2AMLogic/sky130-pll/design/README.md

# design/ — schematic capture convention

This directory holds the PLL's own schematics (xschem), symbols, generated
netlists, and per-block design-rationale notes — the design content itself,
as distinct from `sim/` (evidence records) and `layout/` (DRC/LVS flow).

Historically, no convention existed here before issue #24 (this directory held
only a `.gitkeep`). This file documents the convention that issue set, which
the sibling block sub-issues of #14 (PFD/charge pump, loop filter, divider)
and the integration schematic (`top/`) follow.

## Directory / naming convention

One directory per PLL sub-block, named for the block, kebab/lowercase:

```
design/
  README.md                  # this file
  <block>/
    <block>.sch               # top xschem schematic for the block
    <block>.sym                # xschem symbol, for hierarchical reuse by
                                 # the integration schematic
    DESIGN.md                   # topology choice, sizing rationale, and
                                 # the design targets this block is built
                                 # toward (not verified results — those are
                                 # sim/ evidence, produced by the block's
                                 # testbenches)
    netlist/
      <block>.spice              # ngspice-compatible netlist snapshot,
                                   # generated from <block>.sch and
                                   # committed (regeneration command
                                   # documented in the block's DESIGN.md)
```

- **`<block>`** — a short slug for the sub-block. First instance:
  `vco` (issue #24, the ring-oscillator VCO core). Sibling blocks (PFD/charge
  pump, loop filter, feedback divider) each have their own `<block>/`
  directory, as does `clk-buf` (issue #232, the `CLK` output buffer). `top`
  (issue #28) is the one exception to "sub-block": it is the integration
  schematic that hierarchically instantiates the sibling blocks into the
  closed PLL loop, following
  the same internal file shape (`top.sch`/`top.sym`/`DESIGN.md`/
  `netlist/top.spice`) for consistency, even though it isn't itself a
  sub-block.
- **`<block>.sch` / `<block>.sym`** — hand-authored (or, once available,
  xschem-generated) schematic and symbol pair. The symbol's pin order must
  match the schematic's own `ipin`/`opin`/`iopin` declaration order, so
  `@pinlist` nets correctly when the symbol is instantiated from a parent
  (integration) schematic.
- **`netlist/<block>.spice`** — a **connectivity snapshot**, not a
  simulation-ready testbench: it nets out the block's own devices against
  sky130 primitives (`sky130_fd_pr__nfet_01v8` / `pfet_01v8` etc., per the
  ratified 1.8 V core supply flavor, `DR-001`) but carries no supply
  sources, no `.lib` model include, and no analysis statements — those are
  added by whatever testbench (`sim/<experiment-slug>/testbench/`)
  instantiates the block. Regenerate with:

  ```sh
  source sim/bin/pdk-env.sh
  xschem -n -q -x --rcfile sim/xschemrc design/<block>/<block>.sch \
    -o design/<block>/netlist
  ```

  Unlike `sim/`'s `netlist-snapshots/` (one frozen file per evidence
  record, append-only), `design/<block>/netlist/<block>.spice` is **not**
  append-only — it is the current netlist for the current schematic,
  regenerated and overwritten in place as the schematic changes. The
  append-only, one-per-record convention lives entirely under `sim/` (see
  `sim/README.md`), where a netlist is frozen alongside the evidence it
  produced.

### Regenerating parents after a child changes

`design/top/netlist/top.spice` embeds a copy of every child block's netlist
(`pfd_cp`, `loop_filter`, `vco_ring5`, `divider_intN`, `clk_buf`). xschem does not
refresh a parent when only a child schematic is saved, so after changing any
child, regenerate every ancestor with the same command (for the top level,
`design/top/top.sch -o design/top/netlist`), and commit the changed snapshots
together. The layout flow reads the top snapshot, so a stale embedded copy
silently changes the device plan and LVS reference.

`python3 signoff/design-snapshot-consistency.py` (part of `npm run check:ci`,
and run by `layout/bin/run-pll-layout-flow.sh` before a record is minted)
compares each embedded block with its standalone snapshot: pin order, device
connections, model names and parameter values, ignoring generated path
comments and formatting. It needs neither xschem nor a PDK. It establishes
snapshot-to-snapshot consistency only; it does not prove that a snapshot
matches its `.sch`, which only regenerating with xschem does.

## Relationship to `sim/`

`design/<block>/<block>.sch` is the DUT a `sim/<experiment-slug>/testbench/`
schematic instantiates. Testbenches and their append-only evidence records
exist under `sim/` for several of these designs, including the VCO
([`sim/vco/`](../sim/vco/)), the feedback divider
([`sim/divider/`](../sim/divider/)), the loop filter's linearized dynamics
([`sim/loop-ac/`](../sim/loop-ac/)) and the closed-loop top level
([`sim/pll/`](../sim/pll/), [`sim/pll-lock/`](../sim/pll-lock/)). The
campaign list, with each campaign's claim and issue, is the table in
[`sim/README.md`](../sim/README.md); a testbench or record being present does
not mean the block meets any spec row.

Where each spec row stands is settled by
[`spec/target-spec.md`](../spec/target-spec.md) (ratified versus DRAFT) and
the evidence is rolled up, row by row and without a verdict of its own, in
[`measurements/report.md`](../measurements/report.md). Whether the block
clears the tiered signoff checklist is settled only by
[`signoff/tier-report.json`](../signoff/tier-report.json) (see
[`signoff/README.md`](../signoff/README.md)). This file deliberately repeats
none of those results.

`lock-detector/` currently holds no circuit. It holds the executable
behavioral reference and tests for the proposed `LOCK` contract (`DR-007`,
issue #237). The schematic, symbol and netlist files are owed by #231 and
will follow the shape above. Its tests are behavioral-reference evidence,
not `sim/` evidence records.

`sim/pdk-smoke` is unrelated plumbing (harness self-test, not a PLL block) and
predates this convention; its own throwaway testbench circuit intentionally
stays under `sim/pdk-smoke/testbench/`, not `design/`.

## Relationship to `layout/`

`layout/` (klayout-tools DRC/LVS flow) holds the physical side. The PLL
layout drawn from `design/top/netlist/top.spice` lives in
[`layout/pll/`](../layout/pll/) (start at its
[`README.md`](../layout/pll/README.md); the record `reports/LATEST` names is
the pass/fail evidence), and the flow reads the top-level snapshot described
under "Regenerating parents after a child changes" above. Layout is organised
around the composed `pll_top` cell rather than one directory per block, so
there is no `layout/<block>/` mirroring this directory's slugs. A layout
record's presence does not establish LVS or signoff completion: the layout
records and [`signoff/tier-report.json`](../signoff/tier-report.json) say what
was checked.

## Provenance

Directory shape and the netlist-regeneration command are new with issue #24
(no existing convention to adapt — `design/` held only `.gitkeep` before this
issue). The xschem/ngspice invocation pattern itself (`--rcfile sim/xschemrc`,
`PDK_ROOT`/`PDK` via `sim/bin/pdk-env.sh`) is the one `sim/harness/runner.py`
already established (issue #9, adapted from `2AMLogic/sky130-bandgap`) — reused
here unmodified, not re-derived.
