2AMLogic/sky130-pll/sim/README.md

# sim/ — evidence record format

This directory holds simulation testbenches and their results. Results are
**append-only evidence**: once a record is written, it is never edited or
deleted. A re-run — even one that corrects a mistake — mints a new record
with a new ID; a correction references the record it supersedes rather than
overwriting it in place.

This convention exists because `CLAUDE.md` commits this repo to two rules
that need a concrete schema to be enforceable:

- **Verification is the product.** No claim without a testbench.
- **`sim/` is append-only evidence.** Re-runs get new records; records are
  never edited or deleted.

## Provenance of this convention

Adapted from `2AMLogic/gf180-pll`'s `sim/README.md`
(source commit `d6115c79f9d41140341c4666256b659151a824db`), which itself
adapts the convention `2AMLogic/gf180-bandgap` ratified. Per this repo's
`CLAUDE.md` harness-bootstrap rule (copy the sister-repo pattern rather than
reinventing).

**Historical: scoped down for issue #2.** At bootstrap, gf180-pll's version
documented an entire mature PLL verification campaign table (lock-time,
jitter, divider-ratio, ...) that had no counterpart here yet. This file kept
the schema and the append-only/retention/no-fabricated-evidence rules
gf180-pll ratified, and dropped the campaign-specific sections (closed-loop
assembly paths, the PFD internal-timestep bound, etc.) that did not apply
before there was a PLL schematic. PLL campaigns have since been added; the
table below lists them, and each campaign's own `testbench/tb.json` manifest
carries its method.

## Directory / naming convention

Each testbench topic gets its own experiment directory:

```
sim/
  <experiment-slug>/                 # e.g. pdk-smoke
    testbench/                       # tb.json manifest + xschem schematic(s)
    netlist-snapshots/
      <record-id>.spice              # frozen DUT netlist used for this record
    corners/
      <record-id>/
        <corner-id>.spice            # patched per-point netlist
        <corner-id>.log              # raw ngspice output per PVT point
    records/
      <record-id>.md                 # append-only summary record
    analysis/                        # optional, mutable -- see below
```

- **`analysis/`** is optional and, like `testbench/`, **mutable**: stdlib-only
  scripts that *read a committed record and restate what it already says*, for
  a derived quantity the record's own generated tables cannot express. It is
  not an evidence directory — nothing under it simulates, measures, or
  introduces a number that is not already in the record it was handed, and a
  record stays readable without it. The case that introduced it
  (`sim/vco-supply-pushing`, issue #165) is a quantity that is **cross-point**:
  supply pushing lives across the three PVT rows sharing a (corner,
  temperature, `VCTRL`) triple, and `sim/harness/report.py` renders one row per
  point. A script there must offer a `--check` mode that re-derives its output
  and fails on any drift, so a reader can re-verify the derivation against the
  record long after the run. The second user (`sim/pll-lock-mc/analysis/`,
  issue #179) is a different shape of the same rule: it restates a Monte Carlo
  record's per-trial table as the sample-set document `klt yield` consumes, so
  that campaign's yield estimate, confidence interval, Cpk and sample-size
  verdict become machine-readable — quantities a per-trial table cannot
  express, derived entirely from figures that table already carries. The third
  (`sim/pll-lock-mc/analysis/jitter_floor.py`, issue #178) is the first to read
  **two** campaigns' records: it restates this campaign's measured period jitter
  against the measurement floor `sim/jitter-floor`'s records report, which is a
  quantity neither campaign's own table can express because it is a relation
  between them. The fourth (`sim/jitter-calibration/analysis/calibration.py`,
  issue #185) pushes the "read from the record's own netlist" allowance to its
  limit, and states why that is still inside the rule: the quantity it needs is
  the jitter its campaign *injected*, and that quantity is not a number written
  in prose anywhere — it is the committed per-point netlist's own PWL edge
  schedule, from which the script re-derives it with the same estimator
  `measure.period_jitter` applies to the reduced edges. Reading it there is what
  makes the injected figure checkable evidence rather than a claim about a
  generator script. The fifth (`sim/vco-clk-transition/analysis/bracket_floor.py`,
  issue #186) reads **two** campaigns' records again, the same shape as the
  third: it locates this design's own measured transition-time figure among
  `sim/jitter-floor`'s own edge/grid-step ratios and states the bracket that
  follows from the fact that the family's A3/B/C variants are a *measured*,
  monotonically decreasing function of that ratio at one shared period —
  turning a family spanning the whole floor range (0.000–2.371 %) into the
  specific two-variant bracket this design's real `CLK` actually falls in. The
  rule is otherwise unchanged — it simulates nothing, and every figure it
  prints is read from a committed record (or from that record's own committed
  per-point netlist, for the numbers that define a floor variant, an injected
  schedule, or a measured transition time), with the same mandatory `--check`
  mode. The sixth
  (`sim/pll-lock-mc/analysis/negative_control_reachability.py`, issue #182) is
  the first whose subject is a **tool** rather than a record: it derives, from
  two fields of the committed `klt yield` report, whether that tool could ever
  report this campaign's negative control `detected`, and commits eleven
  executed `klt yield` probes over deliberately **synthetic** populations so the
  detection rule is checkable rather than quoted. Those probes are labelled in
  their own provenance blocks as evidence about `klt yield` and not about the
  PLL, they introduce no figure about the DUT, and the document's verdict is
  derived from the committed report alone — so the rule holds: nothing under
  `analysis/` simulates, and nothing there states a measured number the
  evidence trail does not already carry. It also derives the *forward*
  question — what population would make the control reportable, and what it
  costs — which is arithmetic over populations nobody has run, and is therefore
  the one place an `analysis/` script states a figure no record carries. The
  rule it keeps instead is that the arithmetic must reproduce the tool's own
  answers on every population that **was** run: interval bounds,
  `negative_control.verdict`, `required_n` and `sample_size.verdict` are
  re-derived for all eleven committed probes before a word of the document
  renders, and a single disagreement is a hard failure.

- **`<experiment-slug>`** — short, descriptive, kebab-case name for what is
  being verified. One directory per distinct claim, not per run.

  | Slug | Claim under test | Issue |
  |---|---|---|
  | `pdk-smoke` | does xschem+ngspice+sky130 run this DUT to completion across a real process/temperature/supply sweep — the harness's own plumbing self-test, not a PLL design claim | #2 |
  | `pdk-smoke` (`--mc`) | does the sky130 `MC_MM_SWITCH`/`MC_PR_SWITCH` statistical-sampling mechanism run this DUT to completion, seed by seed — the Monte Carlo harness's own plumbing self-test, not a PLL statistical-spec claim | #20 |
  | `pll` | does the four-block closed-loop PLL netlist (`design/top/top.sch` — VCO + PFD/charge pump + loop filter + divider) netlist and simulate to completion across a real process/temperature/supply sweep — the first PLL-specific campaign, still a plumbing claim (its manifest cites no `spec/target-spec.md` row, and the transient window is far short of the loop's cold-start lock time), not a lock-time, frequency, or jitter claim | #23 |
  | `pll-lock` | does the closed-loop PLL, driven cold-start from `design/top/top.sch`'s own power-on reset, lock its output to `N * Fref` within a real (multi-microsecond, not 200 ns) transient window — a measurement claim (output frequency, duty cycle, time-to-lock, or explicit no-lock), extracted via `sim/harness/measure.py`. Drives a 10 MHz reference, `NSEL[5:0]`=`N`=25 (target 250 MHz). **Re-tuned by issue #210's ngspice-tolerance audit, not yet re-run**: the manifest now declares `.options reltol=1e-4` with a 20 ps dump grid and TMAX pinned at 200 ps — the triple its own Monte Carlo sibling `pll-lock-mc` and the `lf-c1`/`lf-c2` sizing campaigns already run this identical four-block DUT under — because this campaign *gates* on **ratified** row 9 (`jitter.gate_on_bound` is true) and `integrator-floor` measured **1.543 % RMS of pure simulator error** on this design's own ring, at this campaign's own former 200 ps grid, through this campaign's own reducer, for a DUT whose true period jitter is zero. That is more than row 9's whole 1.0 % budget, so a gated verdict read off the old settings was not a verdict about the circuit. The standing `20260905-193322-0f1934d.md` record is **not** edited and **not** superseded — only a fresh record can supersede it, and the full-grid re-run at these settings is still owed. See `sim/tolerance-audit/README.md` | #52, #210 |
  | `pll-lock-1mhz` | sibling of `pll-lock`, same DUT and measurement layer, driven at spec row 3's DRAFT low reference-frequency band edge (1 MHz) instead of 10 MHz — `NSEL[5:0]`=`N`=64 (the divider's maximum representable ratio, target 64 MHz), the closest achievable target to `sim/vco/records/`'s characterized VCO tuning floor (~145.1 MHz) given the divider's `N<=64` ceiling; exercises spec row 3's frequency-range claim at more than the single 10 MHz point `pll-lock` drives | #55 |
  | `pll-lock-25mhz` | sibling of `pll-lock`, same DUT and measurement layer, driven at spec row 3's DRAFT high reference-frequency band edge (25 MHz) instead of 10 MHz — `NSEL[5:0]`=`N`=10 (target 250 MHz, deliberately the same target `pll-lock` uses, isolating the effect of reference frequency alone) | #55 |
  | `pll-lock-mc` | Monte Carlo statistical companion to `pll-lock`: same DUT, same `DR-005` cold start and same lock criterion, but run as a `--mc` campaign — many trials at ONE fixed PVT point (`tt`/125 °C/1.80 V), each trial resampling sky130's `MC_MM_SWITCH` (within-die mismatch) + `MC_PR_SWITCH` (die-to-die process) draws from its own RNG seed — reduced by `sim/harness/measure.py`'s `period_jitter` once a trial locks. This is the statistical half of the verification `DR-006` names for **ratified** spec row 9 (period jitter ≤ 1.0 % of the output period, RMS, at `CLK` in lock); `pll-lock`'s own grid is the deterministic half. The window is 50 µs, not `pll-lock`'s 100 µs, because this campaign buys post-lock population for a post-lock quantity rather than the full row-8 cold-start budget — see the manifest's `monte_carlo.methodology_note` for that trade, for why the base point is `tt`/125 °C (the one point with a documented cold-start lock under this nudge convention) and for the 200 ps dump-grid resolution floor a reader of a jitter number is owed. **Run and recorded**: `sim/pll-lock-mc/records/20260924-222341-a9375a5.md` (2/5 trials PASS — 3 of 5 draws lock, and **all three measure period jitter above row 9's ratified 1.0 % bound**: 1.584 %, 1.851 %, 3.073 %. A recorded miss against a ratified row, per `CLAUDE.md`, read together with the resolution-floor caveat the record states). **Graded**: `sim/pll-lock-mc/analysis/` restates that record as a `klt yield` sample set and commits the resulting report — 0 % empirical yield, 95 % CI [0, 0.7076], `cpk` −0.491, and the tool's own `sample_size.verdict: insufficient` (`n` = 3, `required_n` = 183). That report is deliberately **not** cited for T1 item 6; `signoff/README.md` § "Why every other row is `unmet`" records why. **And cannot be made citable by more simulation alone**: `sim/pll-lock-mc/analysis/negative-control/reachability.md` measures that `klt yield` can never report this campaign's negative control `detected` while its empirical yield is zero, at any population size and any degradation, so item 6's control is gated on the design meeting row 9 rather than on fleet time — and derives *how well*: the cheapest campaign `signoff/run-signoff.sh`'s guard 3 would accept needs row 9 met on **every** one of 183 measurable draws (~409 h), and the cost is not monotone, peaking around a 50 % pass rate at ~50x that. The design gap that gates it is #202 — **and #202 found that gap was not the design's**: the three misses are of the same order as the integrator-error floor `sim/integrator-floor` measured at the settings that record ran under: 1.543 % for a DUT with zero true jitter, which is more than row 9's whole budget. **Superseded by** `sim/pll-lock-mc/records/20260925-224917-3a2dd6e.md`: the same five seeds, base point, 50 µs window, lock criterion and ratified 1.0 % bound, re-run under `.options reltol=1e-4` and a 20 ps dump grid (TMAX held at 200 ps). **5/5 trials PASS: all five draws lock (24.32–29.72 µs), and all five meet row 9** — 0.554 %, 0.669 %, 0.717 %, 0.633 %, 0.600 % RMS. The two draws the first record reported as 'no lock within 50 µs' lock too, so those were integrator artefacts as well. The `analysis/` documents above still describe the superseded record and have not been re-derived against this one (#182, #195) | #20, #179, #182, #202 |
  | `jitter-floor` | the **measurement-resolution floor** `sim/harness/measure.py`'s own period-jitter reducer carries at a stated dump grid — a harness negative control (a *null* control), not a PLL design claim. The DUT is an ideal pulse voltage source and a load resistor, no sky130 device at all, so `v(CLK)` is a trapezoid of exactly constant period whose true period jitter is **zero by construction**; it is pushed through the identical `linearize` → `wrdata` → `edge_times` → `period_jitter` path a `pll-lock-mc` trial is reduced by, at the same 200 ps grid and 50 µs window, so whatever jitter the reducer reports for it is the floor. Run as a family of variants (each record names its own, and its committed `corners/<record-id>/*.spice` pins it): the floor is **0.000 %** for an edge spanning five grid steps, 0.610 % at one step, and 0.381–2.371 % for an edge a tenth of a step, at the three periods `pll-lock-mc`'s locked draws measured. **Run and recorded**: `sim/jitter-floor/records/20260925-022153-30889a3.md` (A1), `20260925-022310-30889a3.md` (A2), `20260925-022043-30889a3.md` (A3), `20260925-022424-30889a3.md` (B), `20260925-022516-30889a3.md` (C) — 1/1 PASS each. Read with `sim/pll-lock-mc/analysis/jitter-floor/restatement.md`, which restates that campaign's three measured figures against these floors | #178 |
  | `jitter-calibration` | the **transfer** of a known period-jitter figure through the same reducer — the sibling of `jitter-floor` one step on, and a *known-bad* control rather than a null one. Same shape of DUT (an ideal source and a load resistor, no sky130 device), same `linearize` → `wrdata` → `edge_times` → `period_jitter` path, same 200 ps grid; the difference is that this source's rising-edge schedule is drawn from a seeded RNG at an **exactly specified nonzero** RMS period jitter and written edge by edge into the netlist, so the injected figure is a re-derivable property of the committed evidence rather than a claim about a generator. Reported-against-injected over the family is a **calibration curve**: a measured figure can be read back toward a true one, where a floor only bounds it from below. Run as 2 nominal periods × 3 injected values (0.5 %, 1.0 %, 2.0 % RMS) × 3 transition times (20 ps / 200 ps / 1 ns, the same edge family `jitter-floor` uses), 300 cycles each. The two period families are named by their first letter and are both periods `jitter-floor` itself ran at: **J** = 3.9170 ns (`frac(period/step)` 0.585, trial 5's period, #185) and **K** = 3.9952 ns (`frac` 0.976, trial 2's period, #197), deliberately at opposite ends of the grid-phase range because the floor this control measures is period-specific. **Run and recorded**, 1/1 PASS each: `20260925-103212-518b31f` (J05a), `20260925-103238-518b31f` (J05b), `20260925-103303-518b31f` (J05c), `20260925-103326-518b31f` (J10a), `20260925-103348-518b31f` (J10b), `20260925-103409-518b31f` (J10c), `20260925-103435-518b31f` (J20a), `20260925-103459-518b31f` (J20b), `20260925-103526-518b31f` (J20c), `20260925-160214-ed585e4` (K05a), `20260925-160252-ed585e4` (K05b), `20260925-160316-ed585e4` (K05c), `20260925-160342-ed585e4` (K10a), `20260925-160403-ed585e4` (K10b), `20260925-160426-ed585e4` (K10c), `20260925-160453-ed585e4` (K20a), `20260925-160517-ed585e4` (K20b), `20260925-160541-ed585e4` (K20c). The headline: at an edge the grid resolves the reducer returns the injected figure **exactly** (0.500 / 1.000 / 2.000 %), and at one it cannot the reported figure is inflated 1.4×–4.8×. Read with `sim/jitter-calibration/analysis/calibration.md`, which tabulates the curve and shows the floor a *jittering* signal carries moving away from the constant-period walk-phase figure `jitter-floor` measures and toward the uniformly-spread-phase one as the source's jitter grows — i.e. the null control's floor is a different quantity from this one, not a conservative version of it — and, across the two period families, that the *sign* of the difference flips: the null control over-states that floor at `frac(period/step)` 0.585 (over-correcting) and under-states it at 0.976 (under-correcting), which #185 could only argue from the walk-phase formula and #197 measured | #185, #197 |
  | `vco-clk-transition` | the **measured 10–90 % rise/fall transition time** of `design/vco/vco_ring5.sch`'s own `CLK`, open loop, at the fixed VCTRL (0.865 V) that puts the ring near the row-9 operating point — the missing input that makes `jitter-floor`'s edge/grid-step family readable against this design's real clock rather than only against an assumed one. A single fixed-VCTRL point (`tt`/125 °C/1.80 V, `sim/pll-lock-mc`'s own base corner), dumped at a fine 5 ps grid (well under the ~50–60 ps edge it resolves) over a 200 ns window, reduced by `sim/harness/measure.py`'s new `measure.transition` block (`transition_times`, issue #186) rather than a one-off script. **Run and recorded**: `sim/vco-clk-transition/records/20260925-110645-810cd82.md` (1/1 PASS — 259.6 MHz, rise 62.14 ps (37 edges), fall 53.37 ps (36 edges)). Read with `sim/vco-clk-transition/analysis/bracket.md`, which reads that figure against `jitter-floor`'s own measured, monotonic A3/B/C triple (one shared period, three edge/grid-step ratios) and states the bracket it implies: this design's own edge/step ratio (0.267–0.311×) sits strictly between A3's (0.1×, 2.371 %) and B's (1.0×, 0.610 %) — the family's **unresolved-edge** regime, not variant C's fully-resolved 0.000 % — so a reader of `sim/pll-lock-mc`'s measured period-jitter figures has a real bound (0.610 %–2.371 %) rather than the whole family's span | #186 |
  | `integrator-floor` | the **integrator-error floor** under a free-running oscillator's period-jitter figure — a harness *null* control like `jitter-floor`, but with `design/vco/vco_ring5.sch`'s real ring as the DUT instead of an ideal source, because a ring's edges are placed by ngspice's timestep controller rather than by source breakpoints, and that controller's truncation error is exactly what an ideal source cannot show. Open loop at an ideal 0.86 V control voltage and ideal supply, `tt`/125 °C/1.80 V (`pll-lock-mc`'s base point, ~250 MHz), so the ring's true period jitter is zero by construction; reduced by the identical `linearize` → `wrdata` → `edge_times` → `period_jitter` path. Run as a family of variants, each record naming its own: **D** = ngspice defaults, 200 ps grid (the settings `pll-lock-mc`'s first record ran under) → **1.543 %** (and 243.8 MHz against the tighter runs' 251.1 MHz); **T** = `.options reltol=1e-4`, 200 ps grid → **0.658 %** (the residual is `jitter-floor`'s grid floor for this ~74 ps edge); **G** = `reltol=1e-4`, 20 ps grid, TMAX held at 200 ps → **0.005 %**. **Run and recorded**, 1/1 PASS each (`gate_on_bound` false — a null control cannot fail for reporting its finding): `20260925-201301-d8b1ab7` (D), `20260925-201647-d8b1ab7` (T), `20260925-203420-d8b1ab7` (G) | #202 |
  | `lf-c2-jitter-sensitivity` | how much of the closed-loop PLL's post-lock period jitter is set by **one loop-filter component** — `design/loop-filter`'s `C2`, the shunt capacitor at the charge-pump node whose stated design purpose is to attenuate reference-frequency ripple reaching `VCTRL`. Same DUT, sampling point, seed, reducer, dump grid and `reltol` as `pll-lock-mc`; a family of arms differing **only** in `C2`'s drawn area, every arm's schematic generated from the committed design files with a `--check` that fails on drift. Deliberately **not** `pll-lock-mc`'s window: the loop filter is pre-charged to 0.865 V and the window is 20 µs, so a sensitivity family is affordable — which is why it runs its own `nominal` arm and is read as a *ratio*, not as absolute figures borrowed across two conditions. No `spec_rows`: it is a sizing measurement for #195's negative control, not row 9's evidence. **Run and recorded**, 1/1 PASS each: `20260926-084846-e572408` (`nominal`, `C2` = 10.47 pF, **0.523 %** RMS), `20260926-084414-e572408` (`c2div4`, 2.64 pF, **0.551 %**), `20260926-084935-e572408` (`c2div9`, 1.19 pF, **0.566 %**). **The finding is negative and that is its value**: an 8.8× reduction in the ripple-rejection capacitor moves the measured figure by 8 % of itself, with `f_out`, duty and time-to-lock unchanged — so `C2` is not a lever on row 9's quantity at this operating point, and it is rejected as the negative control's knob by measurement rather than by opinion. The `nominal` arm also validates the method: 0.523 % against `pll-lock-mc`'s own 0.554 % at the same seed, 5.6 % apart | #195 |
  | `lf-c1-jitter-sensitivity` | sibling of `lf-c2-jitter-sensitivity` — byte-identical `measure` block, same draw, same window and initial conditions, **different degraded component**: `design/loop-filter`'s `C1`, the compensation-zero capacitor that per `design/loop-filter/DESIGN.md`'s own derivation sets *both* the loop crossover (row 6) and the phase margin (row 7), so shrinking it leaves a badly under-damped loop. It exists because its sibling's `C2` result came back negative. Has **no nominal arm of its own** — it cites the sibling's, and `sim/tests/test_negative_control_variant.py` asserts the two manifests still agree so that citation cannot go stale. **Run and recorded**, 1/1 PASS each: `20260926-110626-044c894` (`c1div9`, `C1` = 23.19 pF, **0.983 %** RMS, locked 347.4 ns), `20260926-130047-c2ecc77` (`c1div12`, 17.41 pF, **1.274 %**, locked 1.531 µs), `20260926-130144-c2ecc77` (`c1div16`, 13.07 pF, **3.086 %**, locked 13.13 µs), `20260926-110714-044c894` (`c1div25`, 8.39 pF, **no lock within 20 µs** — and therefore no jitter figure at all, row 9's population being post-lock). `C1` moves this figure by **490 % over a 16× change** where `C2` moved it by 8 % over 8.8×, and past area/16 the loop stops locking — so at this operating point the measured period jitter tracks the loop's **damping**, not the filter's ripple rejection. That bracket is the sizing answer #195 needed: `c1div12` is the arm that both misses the ratified bound (by 27 %) and locks with margin, and it is `pll-lock-mc-negative-control`'s DUT | #195 |
  | `pll-lock-mc-negative-control` | **T1 item 6's deterministic negative control** for `pll-lock-mc`'s campaign: the same testbench, sampling point, reducer, window, lock criterion and ratified 1.0 % bound, drawn against a **deliberately degraded variant of the DUT** (`design/loop-filter`'s `C1` at a twelfth of its drawn area, sized by `lf-c1-jitter-sensitivity`). Unlike `jitter-floor` (a *null* control, #178) and `jitter-calibration` (a known-bad *measurement input*, #185), this one degrades the **design** — which is the kind `klt yield`'s `negative_control` and item 6's checklist ask for, and the reason neither of the other two can be declared as this campaign's control (`signoff/README.md` § "Why every other row is `unmet`" case 4b). Six draws, because per `analysis/negative-control/reachability.md` an all-failing control separates from the now 5-of-5 nominal population at six (Clopper-Pearson upper bound 0.459258 vs the nominal's lower bound 0.478176) and not at five — and only if every draw both locks *and* misses, since a no-lock draw is censored out of the control's own denominator. **Testbench only, no record yet**: the campaign is six 50 µs cold-start transients at `reltol=1e-4`, and no host is provisioned for the batch/remote fleet (`sim/executor-equivalence/README.md`, 2AMLogic/2am#934) | #195 |
  | `loop-ripple` | how large is the closed-loop PLL's own self-generated disturbance, in lock, on its shared `VDD` rail and on `VCTRL` — `DR-006`'s row 13 Budget 1 transient ripple measurement. Same DUT (`design/top/top.sch`), `DR-005` cold start, 100 µs window and lock criterion as `pll-lock`, but the ideal supply feeds the block's `VDD` through a 1 Ω resistive power-delivery stand-in (`RPDN`, a testbench assumption — without it `v(VDD)` ripple is zero by construction); reports `v(VDD)` and `v(VCTRL)` peak-to-peak over the final 5 µs via `sim/harness/measure.py`'s `ripple_pp`, labelled with whether that window was in lock. **Testbench only, no record yet** — see the manifest's `methodology_note` for the supply model, bandwidth and cost caveats (inherits `pll-lock`'s per-point cost, issue #103). **Re-tuned by issue #210's ngspice-tolerance audit before its first record is minted**: `.options reltol=1e-4`, a 20 ps dump grid, TMAX pinned at 200 ps, matching `pll-lock` (an invariant `sim/tests/test_harness.py` pins, so the two campaigns' lock columns stay comparable). Having *no* record is what made this the cheapest of the four campaigns to fix — there was no default-tolerance figure on file to audit, and nothing to supersede. A campaign whose entire output is the SIZE of a small self-generated disturbance must not run at a tolerance that manufactures disturbance of its own; the finer grid also widens the reported `v(VDD)` peak-to-peak, which stays an upper bound on `DR-006`'s 100 kHz–100 MHz band but a looser one — see the manifest's **Bandwidth** paragraph and `sim/tolerance-audit/README.md` | #166, #210 |
  | `vco` | frequency-vs-`VCTRL` characterization of `design/vco/vco_ring5.sch` alone (open loop, no PFD/charge pump/loop filter/divider), replacing the informal single-corner sanity check `design/vco/DESIGN.md` disclaims with real committed `sim/` evidence across the full PVT matrix. **Audited by issue #210 and cleared — no re-run, no accuracy change**: a paired comparison at tt/27 °C/1.80 V on one host, `20260927-081603-25bc597.md` (ngspice defaults) against `20260927-093607-25bc597.md` (`reltol=1e-4`, 5 ps grid, TMAX at this campaign's own 50 ps), moved f_out by **+0.03 %** at VCTRL = 0.900 V and **+1.35 %** at 1.600 V, and the endpoint-to-endpoint mean slope by **+1.96 %** (1022 → 1042 MHz/V). Rows 2 and 5 are both DRAFT and this ring clears the only numbers ever floated for them by ~5× and ~7×, so nothing in the reading changes. Leg A also reproduced the standing record on a second platform (Linux x86-64 against its Darwin arm64). The shift is **not uniform across the sweep** — it tracks dump-grid steps per output period, and the VCTRL ≥ 1.4 V rows sit at ~14–27 — so see the manifest's own caveat and `sim/tolerance-audit/README.md` before quoting a top-of-band figure as a number | #52, #210 |
  | `vco-supply-pushing` | sibling of `vco`, same DUT and open-loop harness, opposite independent variable: `VCTRL` is held FIXED at four operating points (0.8, 0.9, 1.2, 1.5 V) while `VDD` is the swept quantity, supplied by the corner runner's own 1.62/1.80/1.98 V axis — frequency-vs-`VDD` supply-pushing characterization (fractional `%/V`), the first of the two prerequisites `DR-006` names for a future ratification of spec row 13 Budget 1 (the AC supply-ripple limit), replacing the 1.67x realized-over-floor ratio borrowed from gf180-pll. The cross-point `%/V` derivation (`sim/vco-supply-pushing/analysis/pushing.py`) is appended to the record, not rendered by `sim/harness/report.py` itself. **Run and recorded**: `sim/vco-supply-pushing/records/20260923-141525-e514bb0.md` (45/45 PASS). **Audited by issue #210 and cleared — no re-run, no accuracy change.** What this campaign claims per triple is an ABOVE/BELOW-floor classification, so the audit ran the triple whose classification the smallest shift can flip: **ff/125 °C/VCTRL=0.900 V**, `|S_span|` = 56.1 %/V against the 55.6 %/V floor — 0.5 %/V, 0.9 % of its own magnitude, the tightest of all 60 triples. Paired legs `20260927-093811-25bc597.md` (defaults) / `20260927-093854-25bc597.md` (`reltol=1e-4`, 5 ps grid, TMAX 50 ps) moved `S_span` from **−56.1 to −56.3 %/V**: no flip, and the margin *widens*. A second pair at sf/125 °C/VCTRL=1.200 V (`20260927-072223-25bc597.md` / `20260927-080253-25bc597.md`) moved it +49.9 → +51.9 %/V (+4.0 % of itself, 35 % of that triple's margin) and also did not flip. Both leg-A runs reproduced the standing record's rows exactly on a second platform. The first pair's own claim text wrongly calls sf/125/1.200 the tightest triple — it is sixth; `sim/tolerance-audit/README.md` carries that correction, since the append-only rule forbids editing the record | #165, #210 |
  | `clk-output` | **V_OH, V_OL, duty and 10–90 % edge time at the buffered `CLK` pin** (`design/clk-buf`, issue #232) into the provisional 1 pF `CLK`-to-`GND` characterization load of `DR-008`, over the full 45-point PVT grid. Open loop, `VCTRL` fixed at 0.865 V (the near-250 MHz point `vco-clk-transition` uses), measured at the pin rather than the ring-side net, reduced by `sim/harness/measure.py`'s new `measure.levels` block (settled V_OH/V_OL as medians, true extremes printed beside them) next to the existing `duty_cycle`/`transition` reductions. Reported against the DRAFT rows 14/15 bounds and never gated on them; the load is lumped, so no figure is pad/package/ESD capability. **Manifest and testbench committed; the 45-point campaign has not been run** — the harness's batch executor only accepts `cp` manifests, and this dispatch host does not run grids locally (see the PR for #232). Any single-point record minted for it is labeled as a subset | #232 |
  | `vco-2x-duty` | **Operator-ruled single-corner (tt / 27 °C / 1.80 V) measurement of open-loop VCO oscillation and output duty at the VCTRL values reaching 50 / 100 / 200 / 400 MHz** (`docs/phase-output-proposal.md` §10.3, DR-010 interface question). Run on the batch fleet (`--executor batch`), two records, one job each: `20261102-172016-7b7f96b` (11-value grid, 0.3–1.0 V; no oscillation at VCTRL ≤ 0.60 V, none of its points within ±10 % of 50/100/200 MHz) and the one allowed refinement `20261102-172209-7b7f96b` (10 values; it refines the first record, it does not supersede it). Result: 51.97 MHz @ 0.720 V (D 50.6 %), 103.9 MHz @ 0.770 V (50.6 %), 200.6 MHz @ 0.835 V (50.6 %), 395.3 MHz @ 0.940 V (50.3 %) — all within ±10 % of target and oscillating, every duty inside the consumer window (5–95 / 10–90 / 20–80 %), so **no ruled stop condition fired**. Derived (closed form, not measured; no ÷2 stage simulated) CLK–CLK90 offset `180·D` ≈ 91.1° at each of 50 / 100 / 200 MHz (≈ 9.7 / 4.9 / 2.5 ns) and ≈ 90.5° at the 400 MHz check. Cost: two ~26 s Spot jobs on `c7i.8xlarge`, far under the $20 cap (the fleet reports no billed dollars; at the on-demand rate ≲ $0.02 total — an upper bound, not an invoice). Open loop, one corner; DR-010 stays Proposed and nothing is ratified | #387 |
  | `vco-2x-iq-scan` | **Stage 1 of issue #422 (parent #332): VCTRL-vs-frequency scan of the open-loop 2x VCO driving the transistor-level I/Q ÷2 (`design/divider-iq`) over the 45-point DR-003 PVT set**; locates each corner's VCTRL for 25 / 50 MHz output. `analysis/make_vctrl_tables.py` turns its record into the per-corner VCTRL brackets in the two graded manifests. Frequency characterization only; ratifies nothing. |
  | `vco-2x-iq-25mhz`, `vco-2x-iq-50mhz` | **Stage 2 of issue #422: graded CLK-to-CLK90 offset and CLK/CLK90 duty, measured from simulated waveforms of the DR-010 (Proposed) I/Q ÷2 over the 45-point DR-003 PVT set at 25 / 50 MHz output (50 / 100 MHz VCO)**, graded against #332's DRAFT consumer window (90° ± 81° / ± 72°) and the DRAFT 45–55 % duty bound. Simulated, not measured silicon; ratifies nothing, DR-010 stays Proposed. |
  | `vco-buffered` | buffered half of the paired VCO tuning sweep for issue #232: `sim/vco`'s own manifest (same DUT, six `VCTRL` values, 45-point grid, transient and defaults) with `design/clk-buf` and the 1 pF `DR-008` load attached to the VCO's `CLK` node; the measured node is the ring-side net the divider taps, so the per-point difference from the unbuffered record `sim/vco/records/20260904-163130-f3ae976.md` is the tuning shift the buffer's input capacitance causes. **Manifest and testbench committed; the 45-point campaign has not been run** (same executor limitation as `clk-output`) | #232 |

  | `loop-ac` | linearized open-loop AC characterization of the loop dynamics — unity-gain crossover frequency (row 6, loop bandwidth) and phase margin (row 7), from a real ngspice `ac` sweep of `design/loop-filter/loop_filter.sch`'s own sky130 R/C network, with the charge pump / VCO / divider applied as a swept scalar loop gain `A = Icp*Kvco/N`. Replaces `design/loop-filter/DESIGN.md`'s explicitly hand-calculated, single-design-point, no-stated-corner `f_c` and phase-margin figures with committed `sim/` evidence. It is the AC/linearized-model testbench `sim/harness/measure.py`'s own docstring defers these two rows to | #52 |
  | `divider` | does the standalone programmable integer-N feedback divider (`design/divider/divider_intN.sch`, retimed to a dual-modulus /2-/3 prescaler front-end by issue #114) divide a fixed ~1.10 GHz ideal CLK — at or above the VCO's own characterized top free-running frequency — by N=25 (`NSEL[5:0]`=`011000`, the same modulus `sim/pll-lock` straps) cleanly across the full PVT corner matrix, turning `design/divider/DESIGN.md`'s informal, uncommitted "Issue #114" diagnostic table into a committed `sim/` evidence record. **Run and recorded**: `sim/divider/records/20260910-234943-ec91425.md` (45/45 PASS). | #129 |
  | `divider-n4` | sibling of `divider`, same DUT and open-loop method, straps N=4 (`NSEL[5:0]`=`000011`) at 250 MHz — the DRAFT modulus range's floor (spec/target-spec.md row 4) and the smallest modulus on the divider's even decode path. **Run and recorded**: `sim/divider-n4/records/20260911-091838-7d2f839.md` (full DR-003 45-point grid, 45/45 PASS). | #129, #131 |
  | `divider-n64` | sibling of `divider`, same DUT and open-loop method, straps N=64 (`NSEL[5:0]`=`111111`) at 250 MHz — the DRAFT modulus range's ceiling and the largest modulus on the even decode path; N=64's long output period makes a full 45-point grid impractical in one pass (see the manifest's own `methodology_note`), so this campaign accumulated its coverage one process-corner row at a time. **Run and recorded — the full DR-003 45-point grid is now complete, 45/45 PASS, across seven append-only records**: `sim/divider-n64/records/20260911-074438-073b241.md` (issue #130 — the full `tt` process-corner row, 3 temps x 3 supplies, 9/9 PASS), `sim/divider-n64/records/20260911-101305-7d2f839.md` (issue #131 — tt/27 °C/1.80 V, 1/1 PASS; **adds no distinct point** — it independently reproduces a point the `tt` row already covers, and is retained under the append-only rule rather than counted as coverage), `sim/divider-n64/records/20260911-104400-7d2f839.md` (issue #131 — ss/125 °C, full local supply axis, 3/3 PASS; the first `ss` evidence here), `sim/divider-n64/records/20260911-125347-aa4478c.md` (issue #130 — the full `ff` process-corner row, 3 temps x 3 supplies, 9/9 PASS), `sim/divider-n64/records/20260911-160518-3b65794.md` (issue #130 — the `ss` row's remaining -40 °C/27 °C temperatures, 3 supplies each, 6/6 PASS, completing the `ss` row), `sim/divider-n64/records/20260911-171337-fbf217b.md` (issue #130 — the full `sf` process-corner row, 3 temps x 3 supplies, 9/9 PASS) and `sim/divider-n64/records/20260911-180406-071a336.md` (issue #130 — the full `fs` process-corner row, 3 temps x 3 supplies, 9/9 PASS, completing the grid). Their union is exactly the 45 distinct (corner, temperature, supply) points of the DR-003 grid, with no point missing and no FAIL row. No consolidating record supersedes them: each is a real run of a real subset, and the append-only rule keeps all seven as written. See `design/divider/DESIGN.md`'s "The `sim/divider-n64` overlap" subsection for how the two campaigns' coverage is reconciled. | #129, #130, #131 |
  | `divider-n5` | sibling of `divider`, same DUT and open-loop method, straps N=5 (`NSEL[5:0]`=`000100`) at 250 MHz — the smallest *odd* modulus in the DRAFT range, exercising the divider's odd (one-/3-period) decode path the N=4/N=64 records do not. **Run and recorded**: `sim/divider-n5/records/20260911-095824-7d2f839.md` (tt/27 °C/1.80 V, 1/1 PASS) and `sim/divider-n5/records/20260911-100824-7d2f839.md` (ss/125 °C, default supply tolerance, 3/3 PASS) — together covering issue #129's two named corners. | #129, #131 |
  | `divider-n20` | sibling of `divider`, same DUT and open-loop method, straps N=20 (`NSEL[5:0]`=`010011`, N−1 = 19 per `design/divider/DESIGN.md`) at 250 MHz — the ratio of the proposed 25 MHz × 20 = 500 MHz interface (`docs/500mhz-stage-a-campaign-request.md`). **Prepared, unexecuted (issue #352): no record exists; its schematic has not been netlisted and nothing has been simulated.** The frequency-sweep half lives in `sim/divider-fmax/testbench/fmax-stage-a-500mhz.json`, a separate Stage A configuration with a mandatory 500 MHz probe that leaves `fmax.json` untouched. | #352, #333 |
  | `divider-n63` | sibling of `divider`, same DUT and open-loop method, straps N=63 (`NSEL[5:0]`=`111110`) at 250 MHz — the largest odd modulus in the DRAFT range; like `divider-n64`, its long output period makes a full grid impractical in one pass. **Run and recorded**: `sim/divider-n63/records/20260911-101042-7d2f839.md` (tt/27 °C/1.80 V, 1/1 PASS) and `sim/divider-n63/records/20260911-104153-7d2f839.md` (ss/125 °C, default supply tolerance, 3/3 PASS) — together covering issue #129's two named corners as a documented subset. Widening this campaign to the full 45-point grid was the *optional* half of issue #130 ("if convenient while touched") and has not been attempted — `divider-n64`, the other long-output-period sibling, absorbed that issue's whole compute budget and is now complete at 45/45. | #129, #130, #131 |

  New campaigns add rows here as they are created; the list is descriptive,
  not a closed set.

- **`<record-id>`** — `<YYYYMMDD>-<HHMMSS>-<short-git-sha>` (UTC), this
  repo's `HEAD` when the run started. Re-runs mint a new `<record-id>`;
  nothing under `records/` is ever edited in place. If the tree was dirty at
  run time, the record's **Environment provenance** field says so.

- **`<corner-id>`** — the naming convention depends on what mode produced the
  record, but both share the same `corners/<record-id>/` directory:
  - **PVT points**: `<corner>_<temp>c_<supply>v`, e.g. `ss_-40c_1.62v.log`,
    `tt_27c_1.80v.log`. Supply is written to two decimals.
  - **Monte Carlo trials** (`--mc`, see `sim/harness/README.md`'s Monte Carlo
    section): `mc<trial>_seed<seed>_<lib-corner>_<temp>c_<supply>v`, e.g.
    `mc001_seed1_tt_mm_27c_1.80v.log`. `<lib-corner>` is the `.lib` section
    actually netlisted against (the corner, with `_mm` appended when
    mismatch sampling is enabled).

- **`testbench/`** is not versioned per record — it holds the current
  testbench manifest/schematic used to generate records. A testbench change
  that could affect comparability across records is noted in the next
  record's summary.

## Default corner matrix

Unless a record states otherwise, a result is swept over the grid its own
`tb.json` manifest declares — see `sim/harness/README.md`. `sim/pdk.json`
pins the process-corner names the installed sky130 PDK actually defines
`.lib` sections for (`tt`, `ss`, `ff`, `sf`, `fs`, plus the passive-only `ll`/
`hh` axis); a manifest's `process_corners` must be a subset of that list.

The supply flavor and supply range are settled by ratified rows 0 and 1 of
[`spec/target-spec.md`](../spec/target-spec.md) (`DR-001`, `DR-002`), and rows
19 and 20 (`DR-003`) settle the process-corner and temperature grid; the spec
is the authority for current row status. Historically this README was written
while those rows were still proposed, and the bootstrap-era campaigns
(`pdk-smoke`) keep the plumbing claim they were minted with. The harness never
reads `spec/target-spec.md` itself: the corner matrix comes from each
manifest, and the default per-point criterion is "did the simulator complete
this point". A manifest may additionally declare a measurement bound for a
**ratified** row and gate its verdict on it (`measure.jitter.gate_on_bound`,
see `sim/harness/README.md`); a manifest's `supply_nominal`/`supply_tolerance`
are otherwise that testbench's own bias, and a record cites the ratifying
`DR-NNN` for any bound it applies.

Any subset of a manifest's default grid (fewer temperatures, one supply, a
single process corner) is allowed **only** with an in-record justification —
`sim/run_corners.py`'s `--subset-reason` flag is mandatory whenever a
`--corners`/`--temps`/`--supply-tol` override is combined with `--write`, and
its text becomes part of the record. "The sim was slow" is not a
justification; "fast selftest pass proving the harness runs, not a design
claim — see sim/pdk-smoke/records/<id>.md for the full grid" is.

## Interrupted and parallel runs

A campaign's cost is set by its manifest, and some are large: a single
`sim/pll-lock` point runs a 100 us transient with a 3 h `timeout_s`, so its
45-point grid is days of wall clock (issue #133). Two execution-model flags
make such a campaign tractable. Neither changes what a point measures — the
same manifest, the same netlist, the same per-point criterion, the same
record schema — they change only *when* points run and *what survives* an
interruption.

```sh
# Run 8 points at a time instead of one (one ngspice process each).
python3 sim/run_corners.py pll-lock --jobs 8

# ...that run was killed at point 31/45. Finish it, don't restart it:
python3 sim/run_corners.py pll-lock --jobs 8 --resume 20260911-071500-730c24b
```

- **`--jobs N` / `-j N`** (default `1`, i.e. today's serial behaviour) runs
  `N` points (or Monte Carlo trials) concurrently. Points are independent:
  each patches its own copy of the netlisted DUT and runs its own `ngspice
  -b` process, writing only files named after its own `<corner-id>`. The
  record's rows stay in the manifest's point order regardless of which point
  finishes first.

  `N` shares one host. Keep it at or below the free core count: a point
  already close to its manifest's `timeout_s` budget can be pushed past it by
  contention, and that is recorded as a failed point exactly as in a serial
  run. The default stays `1` so no existing invocation changes behaviour.

- **`--resume <record-id>`** finishes an interrupted run instead of
  restarting it. Every completed point is persisted, the instant it
  completes, to `checkpoint.json` in the run's working directory (see
  `--stage-dir` below for where that is); a resume reloads those and runs only
  the points that are missing. The run prints its record id at the start
  (`record id ... -- an interrupted run can be resumed with --resume ...`) so
  it is available before the run finishes.

  A resume is **refused** — loudly, with no record written — if the testbench
  manifest, the netlisted DUT, the resolved PDK build, the run mode or the
  requested point list differ from what the checkpoint was written against.
  Splicing two different campaigns into one record is exactly what the
  append-only rule below exists to prevent, so the harness will not do it
  even when asked.

- **`--executor {local,remote}`** (default `local`, i.e. today's behaviour)
  selects *where* each point's `ngspice -b` process runs: on this host, or
  on klayout-tools' Spot fleet (`--jobs N` becomes the shard count). Like
  the two flags above it is execution-model only — the netlist, the
  per-point criterion, the measurement reducer and the record schema are the
  same code either way, and a `local` record is byte-for-byte the record it
  would have been before the seam existed.

  A remote request that this host cannot honour (no cloud credentials, a
  quota or cost-gate refusal, a lost shard) **falls back to local** with one
  logged line and a `fallback_reason` recorded in the evidence, rather than
  failing the campaign. Full contract, configuration and the reasoning:
  `sim/harness/README.md` → "Where a unit runs"; the committed side-by-side
  local/remote comparison lives in `sim/executor-equivalence/`.

- **`--stage-dir DIR`** (or `$SKY130_PLL_SIM_SCRATCH`; `--no-stage` to opt
  out) puts a campaign's *working* files — per-point netlists, logs, waveform
  dumps and the checkpoint — outside the checkout while it runs, and copies
  the committed artifacts into `corners/<record-id>/` when the record is
  written. **This is automatic when the checkout is a linked git worktree**,
  because a worktree is a directory another process can remove mid-campaign:
  issue #212 records a 4 h 26 min Monte Carlo campaign destroyed exactly that
  way, checkpoint included. A staged campaign survives its checkout — from any
  other checkout, `--resume <record-id>` finds it (the staging path depends on
  the slug and record id only), reloads every completed point and simulates
  only the rest.

  Like the three flags above, this is execution-model only: the record, its
  text, and the location and contents of every committed artifact are
  identical either way. Details: `sim/harness/README.md` → "Staging a
  campaign's work outside the checkout".

The checkpoint is **run state, not evidence**: it is deleted the moment the
record is written, and — when it is written in the tree at all — it is
gitignored (`sim/*/corners/**/checkpoint.json`) so it can never land in the
committed record trail. A checkpoint that still exists therefore means exactly
one thing: *that record id's run was interrupted and has no record*. Either
resume it, or delete it to run that record id from scratch.

This preserves the append-only contract in both directions: a run produces
**one complete record with every requested point, or no record at all** —
never a record silently missing points, and never one counting a point twice.

## Monte Carlo evidence

`sim/run_corners.py <slug> --mc` (issue #20) runs a statistical-variation
campaign instead of a PVT sweep: many trials at one fixed PVT point, each
sampling sky130's own `MC_MM_SWITCH`/`MC_PR_SWITCH`-gated device variation
with a distinct ngspice RNG seed — see `sim/harness/README.md`'s Monte Carlo
section for the manifest schema and sampling mechanism. Records land in the
same `records/<record-id>.md` / `netlist-snapshots/<record-id>.spice` /
`corners/<record-id>/` tree a PVT record uses (same append-only/retention
rules apply); `sim/harness/report.render_mc` renders a trial table and the
campaign's sampling configuration (base corner, temperature, supply, which
switches were on, trial count and seed range) in place of the PVT per-point
matrix.

**What an `--mc` record supports depends on its manifest, not on the run
mode.** There are exactly two kinds:

- A manifest that **measures nothing** (e.g. `pdk-smoke`'s) yields a harness
  plumbing check — "does the sky130 statistical-sampling mechanism run this
  DUT to completion, seed by seed, with each seed producing a distinct draw?"
  — and nothing more. Its table is `Trial | Seed | Verdict | Detail`.
- A manifest that also declares a `measure` block (e.g. `pll-lock-mc`'s) is
  reduced per trial by exactly the extractor a PVT point of that manifest
  would use, so each trial reports the measured quantities (frequency, duty
  cycle, time-to-lock, period jitter) and a manifest-stated bound a draw
  misses fails that trial. See `sim/harness/README.md`'s Monte Carlo section
  → "Per-trial criterion".

Of `spec/target-spec.md`'s statistical-shaped rows, **row 9 (period jitter) was
ratified by `DR-006`** (#151) — ≤ 1.0 % of the output period, RMS, at `CLK`
in lock — while `DR-006` explicitly left reference spur (row 10) and supply
sensitivity (row 13) DRAFT; the spec carries each row's current status. Row 9's extractor landed with #158 (`measure.period_jitter`, wired in
through the manifest's `measure.jitter` block) and the first campaign to use it
is **`pll-lock-mc`** (#20) — the statistical half of the verification `DR-006`
names for that row, a local-mismatch + process draw population at one fixed PVT
point.

`sim/pll-lock-mc/records/20260924-222341-a9375a5.md` is that first record
(historical: later superseded, as described below), and **it recorded a miss**: of 5 draws at `tt`/125 °C/1.80 V, 3 lock (at 26.32,
38.68 and 48.88 µs) and all 3 measure period jitter *above* the ratified
1.0 % bound — 1.584 %, 1.851 % and 3.073 % RMS. Per `CLAUDE.md` a result that
misses the spec is recorded as a miss; the bound is not relaxed to make it
pass, and `DR-006` stands as written.

Two limits of that record a reader is owed, both argued in the manifest's own
`monte_carlo.methodology_note` rather than left implicit:

- Its **50 µs window** is shorter than row 8's 100 µs cold-start budget, so a
  draw that would lock later is recorded as "no lock within 50 µs" — a limit of
  the window, not a row-8 verdict. Two of the five draws land there.
- The **200 ps dump grid** puts a quantization floor under any jitter figure.
  `measure.py` `linearize`s `v(CLK)` onto the transient's own `tran_step` grid
  before dumping, so each interpolated edge carries a grid error and each
  period inherits it from both ends, against a bound that is 1.0 % of a 4 ns
  period (40 ps). That error is independent per edge and adds in quadrature, so
  it can only *inflate* the measured number: a measured pass is conservative,
  and a measured miss has to be read against the floor's size.

  **That floor is now measured** (`sim/jitter-floor`, issue #178) rather than
  left unquantified, and it did not need a finer-grid re-run of the campaign to
  get at: a null control — an ideal source of exactly constant period, pushed
  through the identical reducer at the identical grid — puts a number on it for
  the price of a 60-second run. It is not one number but a family, and its two
  ends bracket the question:
  **0.000 %** for an edge the grid resolves (five grid steps), and
  **0.381 % / 0.720 % / 2.371 %** for an edge it cannot (a tenth of a step) at
  the three periods this record's locked draws measured.
  `sim/pll-lock-mc/analysis/jitter-floor/restatement.md` restates the three
  measured figures against that family: all three still miss the 1.0 % bound
  with the floor removed in quadrature, and trial 5 still misses it under the
  most pessimistic floor arithmetic allows at this grid (`tran_step/2`, 100 ps).
  **So the recorded miss is not an artefact of the dump grid.** What the null
  control cannot settle is stated there too, and tracked: the floor a signal
  with *real* jitter carries is a different-phase quantity (#185), and
  which end of the family the DUT's own `CLK` sits at needs its transition time
  measured (#186).

  **The first of those two is now measured as well** (`sim/jitter-calibration`,
  issue #185): the same shape of control with a *known, exactly specified,
  nonzero* injected jitter instead of zero, so what comes back out is a
  calibration curve rather than a floor. Its finding is that the difference is
  real and its sign is not what a reader would assume — at this period the null
  control's walk-phase floor (2.371 %, 92.9 ps) is the **larger** of the two
  bounds, and the floor a signal carries moves *down* toward the
  uniformly-spread-phase figure (81.6 ps) as its own jitter grows relative to
  the grid step, so correcting a jittering signal with a null-control floor
  over-corrects it. **The restatement above reads that campaign's records, but
  only for period coverage, and declines to apply its curve** (issue #193): the
  calibration family ran at one nominal period, trial 5's, and the two draws
  (trials 2, 3) that still carry a residual ambiguity after the null-control
  floor ran at different periods it has never visited, so applying it there
  would extrapolate across periods on a quantity the calibration document
  itself says does not transfer by assumption. Issue #197 tracks the run that
  would close that gap. `sim/harness/measure.py`'s jitter docstring records
  what grid a defensible row-9 figure requires, so a future campaign does not
  re-derive it: resolve the edge (`tran_step` ≤ half the measured node's
  transition time), or bound the floor unconditionally at `0.5 * tran_step` —
  20 ps for a floor inside a quarter of row 9's 40 ps budget, against the
  100 ps a 200 ps grid allows.

- **The dump grid was not the only floor: ngspice's integrator is a second,
  and at this campaign's first settings it alone exceeds the bound**
  (`sim/integrator-floor`, issue #202). Every null control above has an ideal
  *source* as its DUT, whose edges sit on the source's own breakpoints; a
  free-running ring's edges are placed by the timestep controller instead, so
  its truncation error is a floor those controls cannot show. Run on
  `design/vco`'s own ring, open loop at this campaign's operating point (true
  period jitter zero by construction), the reducer reports **1.543 %** at the
  settings `20260924-222341-a9375a5` ran under (ngspice defaults, 200 ps grid),
  **0.658 %** with `.options reltol=1e-4` alone, and **0.005 %** with that plus
  a 20 ps dump grid (TMAX held at 200 ps, so the integration is unchanged). The
  first figure is larger than row 9's whole budget for a DUT that has no
  jitter at all, so the first record's three misses cannot be read as design
  misses, and the jitter-floor restatement above — which removes only the
  grid's share — does not settle them either. The manifest now declares
  `measure.options` and `measure.tran_max_step` (the two knobs
  `sim/harness/measure.py` gained for this; see its "The integrator's tolerance
  puts a second floor under this figure"), and the campaign's re-run under them
  — same five seeds, same window, same lock criterion, same ratified 1.0 %
  bound — is the record that supersedes the first:
  `sim/pll-lock-mc/records/20260925-224917-3a2dd6e.md`, **5/5 draws lock and
  5/5 meet row 9** (0.554–0.717 % RMS).

Row 9's **deterministic** axis — a jitter column across the ratified
rows 19 × 20 × 1 PVT grid — is declared by `pll-lock`'s manifest
([`pll-lock/testbench/tb.json`](pll-lock/testbench/tb.json), `measure.jitter`,
gated on the ratified bound). Manifest support is not evidence: the committed
[`pll-lock/records/`](pll-lock/records/) predate the manifest's current
settings, and `pll-lock`'s row above says that the full-grid re-run at those
settings is still owed. Do not infer that full-grid jitter evidence exists, or
that it meets row 9, from the manifest; read the records themselves, and
[`measurements/report.md`](../measurements/report.md) for how they roll up.

## Summary record format

Each run produces one `records/<record-id>.md` file (see `sim/harness/
report.py`) with these mandatory fields:

- **Record ID** — matches the filename and the corresponding
  `netlist-snapshots/`/`corners/` subdirectory.
- **Claim** — what this record substantiates, taken from the manifest's own
  `claim` field. A record's claim is limited to what its method supports: a
  plumbing or design-input claim for most campaigns, and a verdict against a
  `spec/target-spec.md` bound only where the manifest states a bound for a
  **ratified** row. Evidence toward a DRAFT row is never a verdict on it.
- **Spec row(s)** — which `spec/target-spec.md` row(s) this record supplies
  evidence *toward*, taken from the manifest's own **required** `spec_rows`
  field, or the literal `none -- <why>` when the experiment measures no spec
  row (its `spec_rows_note`). This is the citation `measurements/aggregate.py`
  rolls the characterization report up on; making it a manifest field rather
  than something an author remembers per record is why it is now present on
  every record by construction (issue #152 — see `measurements/README.md`).
  `sim/run_corners.py` refuses to run an experiment whose manifest omits it,
  before resolving the PDK or simulating a point. **Citing a row is not
  claiming it**: rows stay DRAFT until a decision record ratifies them, and a
  record states a verdict on a row only against a bound that row's ratified
  decision record supplies. Ratified criteria, DRAFT evidence and signoff
  completion are three different things: a record meeting a ratified bound
  does not clear a signoff item, which is graded only by
  [`signoff/tier-report.json`](../signoff/tier-report.json); the spec is
  [`spec/target-spec.md`](../spec/target-spec.md), and the row-by-row rollup of
  records is [`measurements/report.md`](../measurements/report.md).
- **Netlist provenance** — schematic path plus the SHA-256 of the frozen
  `netlist-snapshots/<record-id>.spice`.
- **Environment provenance** — PDK variant + pinned open_pdks hash, model
  library file, ngspice/xschem versions, this repo's git commit and whether
  the tree was dirty, host OS/arch. "Dirty" means *the code that produced
  this evidence differed from the named commit*: the record's own outputs
  (its corner logs, its netlist snapshot, the record file itself) are
  excluded from that check, since a run always creates them and counting
  them would mark every record dirty. An uncommitted edit to the harness or
  to the testbench does still mark it dirty.

  The recorded commit is the branch commit the run happened at, and a rebase
  or a squash-merge rewrites that hash — so a record written before its PR
  merged names a commit that no longer exists on `main`. Regenerate the
  record when that is cheap; otherwise read the recorded hash as "the tree
  this ran against", and rely on the fields that survive history rewriting
  for exact reproduction: the pinned PDK build, the tool versions, and the
  netlist snapshot's SHA-256.
- **Corner matrix run** — the explicit (process corner, temperature, supply)
  points actually executed, and whether it is a declared subset of the
  manifest's default grid.
- **Methodology / criteria / limitations** — the pass/fail criterion applied
  per point, and any known gap in what the record can support.
- **Result** — per-point pass/fail table plus an overall verdict.
- **Links** — testbench, netlist snapshot, raw per-point logs.
- **Timestamp / author** — UTC creation time and who (human or agent) ran it.
- **Supersedes** (optional) — the prior `<record-id>` this record supersedes.

### Status / supersession language

A record's standing is **`current`** or **`superseded by <record-id>`**,
derived rather than stored: `Status` is not itself a record field. The
superseding record carries **Supersedes**; the superseded record is never
edited to add a back-reference — read forward to find what superseded it.

## Append-only rule

`records/*.md`, `netlist-snapshots/*.spice`, `corners/<record-id>/*` and
`manifests/artifacts/*.manifest.json` are written once and never edited or
deleted after creation, even to fix a typo. (For a run minted after DR-012
the last of these replaces the two middle ones; see "Retention policy".)
A correction is a new record naming the one it supersedes. Only `testbench/`
and this README are mutable.

This is why a record minted before the **Spec row(s)** field existed was not
retro-fitted with one when issue #152 introduced it: back-filling the
citation into 20-odd committed records would have been exactly the in-place
edit this rule forbids. Those records' spec-row mapping lives in their
experiment's `testbench/tb.json` instead — mutable by the sentence above —
and `measurements/aggregate.py` resolves it from there, saying so in the
report. Every record minted from here on carries the field itself.

One deliberate non-exception: `corners/<record-id>/checkpoint.json` (see
"Interrupted and parallel runs" above) is transient run state that is
rewritten as a run progresses and deleted when the record is written. It is
gitignored and is never part of the committed evidence trail, so the rule
above — which governs committed evidence — is unaffected.

## Retention policy

Changed by [DR-012](../spec/decision-records/DR-012-evidence-bytes-in-artifact-store.md).
Records minted **before** DR-012 committed their raw bytes, and those files
stay in git exactly as they are: history is not rewritten and no existing
record is edited. For a run minted **after** DR-012:

| Artifact | Where | Why |
|---|---|---|
| Summary record (`records/<id>.md`) | **Committed** | the citable evidence object; ends with a "Stored evidence" table naming every stored object by sha256 |
| Manifest (`manifests/artifacts/<bench>-<id>.manifest.json`) | **Committed** | names each stored object by sha256 and size; no storage location (see `manifests/README.md`) |
| Frozen netlist snapshot (`netlist-snapshots/<id>.spice`) | **Artifact store** | the record's claim is meaningless without the exact DUT, so the manifest pins it |
| Raw per-point ngspice logs (`corners/<id>/*.log`) | **Artifact store** | the primary evidence the pass/fail table was read from |
| Per-point patched netlists (`corners/<id>/*.spice`) | **Artifact store** | reproduces exactly what ngspice ran at that point |
| Full waveform rawfiles (`.raw`) | **No, not stored** | regenerable from the frozen netlist + logged environment |

The record keeps citing the logical paths `sim/<slug>/corners/<id>/...` and
`sim/<slug>/netlist-snapshots/<id>.spice`; they are the manifest `name`s of the
stored objects, not files in the checkout. Check them with
`klt artifact verify manifests/artifacts/<bench>-<id>.manifest.json` and fetch
one with `klt artifact get <manifest>#<name> -o <out>` (needs
`KLT_ARTIFACT_BROKER`).

**How a run stores its bytes.** `run_corners.py` and `run_fmax.py` work in the
git-ignored scratch tree `sim/build/<slug>/<record-id>/` (a linked worktree
still stages under `$XDG_CACHE_HOME`, issue #212). Before simulating they check
the store is usable (broker configured, `klt` with `artifact put`, broker
reachable); when the run finishes they put every file with `klt artifact put`
and only then install the manifest and the record. Any failure exits nonzero
and commits nothing; the staged bytes stay in scratch and nothing falls back to
committing them. `scripts/check_artifact_manifests.py` (in `npm run check:ci`)
fails if a manifest is malformed, names a storage location, or if a tracked
file has the same sha256 as a stored object.

Root `.gitignore` ignores `*.raw` and `*.log` tree-wide, with no negation for
`corners/`; the resume checkpoint stays ignored:

```gitignore
*.raw
*.log
sim/*/corners/**/checkpoint.json
```

`run_locktiming.py` follows the same rule (DR-013): its JSON records stay in
git, and each group's request, body netlist, report and stderr go to the store
under a per-group manifest named in the record's `jobs[].evidence_manifest`.

**Nothing is pruned.** Old records stay after they are superseded.

## No fabricated evidence

Files under `sim/<experiment-slug>/` may only be created by an actual run of
an actual testbench. Do not commit an example, a template, or a
plausible-looking record into evidence position.

The first real testbench is `pdk-smoke` (#2) — see
`sim/pdk-smoke/records/` for the current evidence. Every campaign added
after it follows this same convention.
