2AMLogic/sky130-pll/layout/pll/README.md

# layout/pll/ — the PLL layout

Issue #16's deliverable: a **device-level layout of the closed-loop PLL
schematic**, drawn headlessly from `design/top/netlist/top.spice` by
`layout/bin/run-pll-layout-flow.sh`. Each run is an append-only evidence
record: `reports/<record-id>/record.md` and
`manifests/artifacts/layout-pll-<record-id>.manifest.json` are committed; the
raw outputs (GDS, extracts, JSON envelopes, renders) are in the fleet artifact
store (DR-012). Records minted before #371 still carry their bytes in git.

**Read the current record's `record.md` first** — it is the actual pass/fail
evidence this issue delivers, not this file. `reports/LATEST` names it.
The layout stream itself is `reports/<record-id>/pll_top.gds` in a pre-#371
record; in a newer one it is the manifest entry of that name
(`klt artifact get manifests/artifacts/layout-pll-<record-id>.manifest.json#layout/pll/reports/<record-id>/pll_top.gds -o pll_top.gds`).

The flow fails closed: without `$KLT_ARTIFACT_BROKER`, a `klt` with
`artifact put`, and a reachable broker it exits nonzero before drawing and
commits nothing. It never falls back to committing the bytes. It stages in the
git-ignored `layout/pll/build/<record-id>/`.

```bash
layout/bin/setup-venv.sh            # once, or after bumping requirements.txt
layout/bin/run-pll-layout-flow.sh   # ~30 s; writes a fresh record
```

A second, separately-recorded read of the same layout lives alongside it:
[`erc-supply-spec.json`](erc-supply-spec.json) and
[`erc-reports/`](erc-reports/) hold the `klt erc` **supply-spec** evidence
T1 item 11 (structural power delivery) is graded from — start at
`erc-reports/README.md`, which states in full what a clean record there does
and does not establish. Issue #147.

## What it is

Every device the schematic declares is physically drawn, at the schematic's
own W/L, and the five blocks (four PLL blocks plus the `clk_buf` output buffer, issue #232) are composed into one `pll_top` cell:

| Block | What is drawn |
| --- | --- |
| `pfd_cp` | 59 core-flavor MOS devices in matched arrays grouped by `(flavor, W, L)`, plus the bias resistor |
| `loop_filter` | 2 poly resistors, 3 MiM capacitors |
| `vco_ring5` | 26 core-flavor MOS devices in matched arrays |
| `divider_intN` | the schematic's 29 `sky130_fd_sc_hd` cells, taken from the PDK's own library GDS, abutted in one standard-cell row |

The device set is **derived, not declared**: `layout/bin/pll_layout.py` parses
the schematic netlist at build time and every drawn primitive exists because a
device card asked for it. `klt extract` then reads the drawn stream back into
a netlist with no knowledge of the plan that produced it, and the record
asserts the two multisets are equal — per block, on `(class, W, L)` for MOS
devices and on extracted value for each passive. `layout/tests/
test_pll_layout_plan.py` covers the derivation half with no PDK and no `klt`,
so it runs in `npm run check:ci`.

Devices are sky130 1.8 V core devices throughout (`sky130_fd_pr__nfet_01v8` /
`pfet_01v8`), per DR-001 — asserted by both the record and the unit tests, so
a 3.3 V-class device carried over from the gf180-pll port cannot appear
silently.

## What it is not

Stated plainly, because these are the gaps a reader of "a PLL layout exists"
would otherwise have to discover for themselves:

- **Not routed.** No inter-device interconnect is drawn. The full schematic
  topology *is* recorded — machine-derived — in each record's `plan.json`
  (every group member carries its schematic device name and its port-to-net
  mapping), and the record reports how many nets that is per block. But the
  GDS carries no wires. The one router available (`klt gen-compose`'s) still
  draws a short on this design, and leaves most nets undrawn — chiefly
  because it cannot route a pin buried inside a matched device array (see
  "Friction" below and each record's routing spot-check for the per-leg
  evidence).
- **DRC-clean (issue #17, 2026-09-05).** Through issue #46's `klt` pin, every
  violation was one instance of a single documented `klt gen` limitation (see
  "Friction") — one `li1.space.1` per minimum-gate-length device, 52 of them.
  Issue #17 bumped the `klt` pin past the upstream fix
  ([klayout-tools#1201](https://github.com/2AMLogic/klayout-tools/pull/1201))
  and the violation is gone: the current record's `drc.json` reports
  `status: "clean"`, zero violations. The record's own DRC check now asserts
  that bar directly, so a *new* violation appearing is a FAIL.
- **Not LVS-clean.** The shipped stream carries no routing, so no `klt lvs`
  run is attempted against it (a foregone mismatch is not evidence). Since
  issue #18, `klt lvs` *is* run against the routed routing-spot-check build
  and its result — a large, honest mismatch, not a "clean" claim — is
  recorded in full; see each record's own LVS (spot-check) section. Full LVS
  closure is still issue #18, blocked on the routing gaps below.
- **Not a floorplan anyone optimized.** Groups are shelf-packed and blocks
  are placed in a row; area utilization is poor and no matching, symmetry, or
  noise-isolation intent beyond `klt gen`'s own matched-array topology is
  expressed. A hand-considered floorplan is future work.
- **Not a verified circuit.** Nothing here is a claim against
  `spec/target-spec.md`, and no simulation was run from this layout (PEX is
  issue #21).

## Friction: `klt` gaps found drawing this

Per the root `CLAUDE.md` friction protocol, every gap was checked against
[`2AMLogic/klayout-tools`](https://github.com/2AMLogic/klayout-tools) first
and either filed there (generic tool-gap description only — tool behaviour,
none of this repo's design or spec content) or cross-confirmed where it was
already tracked.

Filed here:

| Gap | Filed | How this flow copes |
| --- | --- | --- |
| ~~MOS generators cannot draw a DRC-clean device at a PDK's minimum gate length: the unit device's source/drain local-metal pads abut the gate, so their spacing equals the gate length, below the metal min-spacing rule~~ **Fixed upstream** ([klayout-tools#1201](https://github.com/2AMLogic/klayout-tools/pull/1201), merged as `bd5c7f4`) | [klayout-tools#1187](https://github.com/2AMLogic/klayout-tools/issues/1187) (closed) | Issue #17 bumped `layout/requirements.txt`'s `klt` pin past the fix (`klayout-tools==0.4.0`) and re-ran this flow: the pads no longer abut the gate, and the layout's DRC comes back clean of this rule (0 violations, first confirmed at that pin and still 0 in the current record, which #157 re-ran at `klayout-tools==0.6.0`) — no workaround needed any more |
| `connectivity[]` cannot be declared without also requesting metal — there is no "record the intended topology, draw nothing" mode | [klayout-tools#1188](https://github.com/2AMLogic/klayout-tools/issues/1188) | The unrouted request omits `connectivity[]`; the declared topology is written to the flow's own `plan.json` instead |
| `gen-compose` cannot consume a cell it did not generate — its own response is not a valid block input (no `generator`, no `ports[]`), so hierarchical composition and PDK library cells need a hand-forged `generator_report` | [klayout-tools#1189](https://github.com/2AMLogic/klayout-tools/issues/1189) | Synthesizes the inline block report for the top level and for library cells |

Filed after the `klt` pin bump (#46), by the router the bump made usable:

| Gap | Filed | How this flow copes |
| --- | --- | --- |
| ~~`gen-compose`'s route-vs-route collision check misses two same-block self-nets: both compose `routed: true` with no warning, and extraction reads them back as one node~~ **Fixed upstream** (klayout-tools PR #1216, merged as `dd41d23f`) | [klayout-tools#1197](https://github.com/2AMLogic/klayout-tools/issues/1197) (closed) | Issue #17's DRC-motivated pin bump (`klayout-tools==0.4.0`) turned out to be a strict descendant of this fix too — a re-run of this design's routing spot-check confirmed 0 shorted nodes, down from 3. The current pin (`klayout-tools==0.6.0`, #157) is a descendant of `0.4.0` in turn, and the current record's spot-check still reads 0 shorted nodes. Still ships the unrouted stream regardless (most legs remain undrawn — see the routing-channel gap below), and the routed build stays as a spot-check under `route-spot-check/` |
| `mos_array` emits one opaque hierarchical cell with no internal routing channel reserved between rows/columns, and `gen-compose` treats every placed block as a solid obstacle with no notion of navigable space inside it — so a pin on any unit device not on the array's outermost reachable row/column is structurally unroutable, for any net, regardless of placement spacing | [klayout-tools#1531](https://github.com/2AMLogic/klayout-tools/issues/1531) (open) | This is the dominant remaining gap for issue #18 — see the routing-channel discussion below. A same-repo workaround (splitting a group into several separately-composed one-row blocks, when doing so cannot cost a device its common-centroid partner) was tried and measured to have a noise-level effect, not a fix — see "Issue #18's row-channel split" below. Closing this issue's LVS acceptance criterion needs this fixed upstream, or a documented narrower partial-progress result in the interim |

Five further gaps this layout originally hit were **already fixed on the tool's
`main`** and reached this repo only through the PyPI pin
(`klayout-tools==0.2.0`). Issue #46 moved `layout/requirements.txt` to a
git-commit pin that carries all five, each verified working on this design
before the entry was dropped from this table — see
[`../klt-pin-decision.md`](../klt-pin-decision.md) for the decision and the
measurements, and `../requirements.txt`'s header for what the current pin
picks up ([#1057](https://github.com/2AMLogic/klayout-tools/issues/1057)
route-vs-route checking,
[#1073](https://github.com/2AMLogic/klayout-tools/issues/1073) bundle-net
routing, [#1059](https://github.com/2AMLogic/klayout-tools/issues/1059) `klt
draw` composition, [#1117](https://github.com/2AMLogic/klayout-tools/issues/1117)
the `cap_array` MiM generator,
[#1166](https://github.com/2AMLogic/klayout-tools/issues/1166) block
orientation).
[klayout-tools#953](https://github.com/2AMLogic/klayout-tools/issues/953), the
PyPI release-cadence gap those five arrived through, stays cross-confirmed
there rather than re-filed.

**The pin was the binding constraint, and it moved — but the layout is still
unrouted.** Two of the five (#1057, #1073) are what made routing impossible at
all; with them the router now draws 51 legs on this design instead of 7
certified shorts. Issue #18 wired `mos_array`'s `params.gate_contact`
([#492](https://github.com/2AMLogic/klayout-tools/issues/492)) for every
matched device group, closing one of the two "this design's own" gaps named
here previously (bare-poly gate pins are now contacted landing pads,
reachable by the router) — 51 legs became 74. A later `klt` pin bump (issue
#17's DRC-motivated bump past `bd5c7f4`, which turned out to be a strict
descendant of klayout-tools#1197's fix too) eliminated the residual
route-vs-route short described below as a side effect: the same design,
re-measured, drew 62 of 917 legs with **zero** shorted nodes (down from three)
— confirming #1197 no longer needs a dedicated bump, only the structural gap
below remains open for this issue.

What still blocks a routed stream is the dominant remaining failure: the
point-to-point router's inability to route a pin buried inside a matched
device array's own interior (263 of 917 legs at the post-pin-bump
measurement above) — routing that would need an actual channel *inside* the
array, which is a floorplan redesign, not a spacing tweak (a throwaway
experiment raising `GROUP_SPACING_UM`/`BLOCK_SPACING_UM` 2.5x barely moved
the numbers, since that spacing is between *groups*, not between an array's
own internal rows/columns). This is now filed upstream, generically, as
[klayout-tools#1531](https://github.com/2AMLogic/klayout-tools/issues/1531):
`mos_array` emits one opaque hierarchical cell with no internal channel
reserved between rows/columns, and `gen-compose` has no notion of routable
space *inside* a placed block's own bbox — so any pin not on the array's
outermost reachable row/column is structurally unroutable regardless of
placement spacing, independent of the `topology`/packing experiment below.
Distinct from the already-tracked #1057/#1197 (route-vs-route shorting,
closed) and #1467 (inter-net track/layer allocation, open) — those are both
about contention *between* nets; #1531 is about a single generator's own
emitted geometry making some of its own pins unreachable by any router.

Issue #18 also tried a genuine floorplan change here, and it **did not
work** — recorded because the reasoning behind it is plausible enough to be
re-proposed otherwise. `klt gen mos_array` draws every unit's gate contact
facing the array's own +y edge regardless of which internal row it is placed
on, so in the near-square grouping (`factor_rows_cols`) only the array's
*top* row has gates within the router's small edge-margin allowance — every
gate below it is interior by construction. Forcing every matched group into
a single row (`rows=1`, so every unit sits on that one reachable row) should
therefore have helped. The gate-orientation premise is real; the conclusion
was not. Measuring the full 2×2 — all four cells on the same `klt` 0.4.0 /
KLayout 0.30.12 / `open_pdks c6d73a35` pin, so they are directly comparable
— gives legs drawn out of legs attempted:

| `topology` \ packing | near-square grid | `rows=1` |
| --- | --- | --- |
| `common_centroid` (even counts) — **shipped** | **62 / 917** | 55 / 945 |
| `array` (forced, *not* adopted) | 76 / 862 | 74 / 827 |

Read by column, the single-row packing is neutral-to-worse in *both*
topology regimes (62 → 55, and 76 → 74), so its own effect is approximately
zero and slightly negative. An earlier revision of this work reported
"62/917 → 74/827, single-row packing improves routing coverage" — that is
the confounded diagonal of this table: the same change also flipped
`topology` from `common_centroid` to an unconditional `array`, and the
topology knob is where the entire gain came from. Both changes were
withdrawn; the plan keeps the near-square grid, which is independently the
better analog choice (a 1×N row spreads a matched group across the widest
possible span — exactly the linear-gradient distance common-centroid
ordering exists to cancel).

The `topology` gain is real and is deliberately **not** taken. The stream
this flow ships is unrouted, so the routing spot-check is a *diagnostic*,
whereas the device-to-position assignment `topology` controls is a property
of the *shipped* geometry: `common_centroid` is `klt gen mos_array`'s own
documented default and a real centroid-symmetric visiting order that pairs
each instance with its point-reflection through the grid centre, which is
what cancels process-gradient mismatch across the VCO ring stages and the
PFD/CP current mirrors. Spending that to improve a diagnostic number would
be laundering a failing result, which this repo's `CLAUDE.md` forbids — the
routing shortfall stays recorded as a miss instead. Two regression tests in
`layout/tests/test_pll_layout_plan.py` now assert both fields, so neither
can move again as an unremarked side effect.

(The remaining orientation — one column, every gate buried but every
source/drain pad reachable — was measured too and is worse still on this
design: 40 of 978 legs; its declared nets lean on gate connectivity more
than on source/drain, empirically.) None of these floorplan choices closes
the gap — a genuine per-unit interior routing channel is still needed and is
not something this flow's floorplan choices alone can supply; see
klayout-tools#1531 above. The current record's routing spot-check tabulates
the router's own reason for every leg it declined, and its LVS (spot-check)
section runs `klt lvs` against that build and records the resulting mismatch
in full.

### Issue #18's row-channel split

The three floorplan experiments above all vary *how* a single `klt gen
mos_array` call arranges its own `rows`/`cols`/`topology` — none of them can
touch #1531 directly, because the gap is that a single call's own interior
has no channel at all, regardless of shape. The one lever this flow's own
floorplan requests *do* control is how many devices go into one `klt gen`
call in the first place: nothing requires an entire matched group to be one
call. `pll_layout.py` now splits a near-square group into `rows` separate
one-row `mos_array` calls of `cols` devices each, composed as independent
blocks — which turns what used to be a zero-width internal row gap into
`GROUP_SPACING_UM` of real, router-visible space between them, the same kind
of gap `shelf_pack` already reserves between every other pair of groups.

This is only done when it cannot cost a device its common-centroid partner:
splitting only pays off when the per-row device count (`cols`) is itself
even, so every row keeps a valid `common_centroid` pairing on its own
(`_centroid_order`'s point-reflection still has a mirror within an
even-length row). On this design that condition holds for exactly the two
18-device groups (`factor_rows_cols(18) == (3, 6)`, an even `cols`); every
other matched group either already fits on one row (nothing to split) or has
an odd `cols` (the four 6-device groups, `factor_rows_cols(6) == (2, 3)`),
where splitting would silently drop common-centroid matching to plain
`array` order on a smaller group than the schematic's own count — the same
regression the `topology` guard above already refuses to make. Reading
`_mos_array_layout` directly confirms there is no equivalent lever *inside*
one `klt gen mos_array` call: its complete parameter surface is `w_um` /
`l_um` / `rows` / `cols` / `dummy` / `flavor` / `topology` / `gate_contact` /
`finger_topology` / `gate_pad_clearance_um` / `draw_well_tap` /
`add_guard_ring` / `ring_gap_side` / `ring_gap_um` / `ring_gap_offset_um` /
`ring_padding_um` — none of it a row/col pitch or channel-width knob — which
is the concrete basis for #1531's claim that no single call can reserve
internal channel space at all.

Measured effect (`20260906-195205-4a08c71`, same `klt` 0.4.0 / KLayout
0.30.12 / `open_pdks c6d73a35` pin as every measurement on this page): 66 of
926 legs drawn, against 62 of 917 on the unsplit near-square grid — a
four-leg gain that is noise-level, not a fix.

| | unsplit near-square grid (`20260906-175702-eceaadb`) | row-channel split (`20260906-195205-4a08c71`) |
| --- | --- | --- |
| Legs drawn | 62 / 917 | 66 / 926 |
| own-block-interior (the bucket this change targets) | 263 | 371 |
| route-vs-route collision (unrelated) | 460 | 354 |
| unrelated-block bbox (unrelated) | 119 | 127 |
| `klt lvs` mismatches | 1166 | 1164 |
| Shorted nodes | 0 | 0 |

The bucket this change specifically targets moved the *wrong* direction (263
→ 371): splitting two groups changes their own footprints, which reshuffles
`shelf_pack`'s whole-design placement and therefore which legs the router
attempts in what order — a change local to two groups redistributes bucket
membership design-wide rather than only shrinking the bucket it targets.
Read together with the `rows=1`-for-the-whole-group experiment above (which
eliminates row-interior burial by construction and *also* measured
neutral-to-worse), the router's leg-failure reasons do not appear to be
independently addressable one at a time by floorplan reshaping alone.

This result is shipped anyway — unlike the withdrawn topology/packing
experiments above — because, unlike those, it costs nothing: no device loses
its matched partner (the parity guard makes that structurally impossible),
DRC stays clean, and the device-set cross-check is unaffected. It is a real,
verified negative result on the one lever this flow's own floorplan requests
can pull directly against #1531, worth having on record precisely so the
same idea is not re-spent. Closing this issue's LVS acceptance criterion
still needs #1531 fixed upstream (or an equivalent capability this flow has
no other way to reach) — not a floorplan-request change on this side.
`layout/tests/test_pll_layout_plan.py`'s
`test_row_channel_groups_reconstruct_their_parent_near_square_grid` asserts
the parity guard and the split shape, so a future change cannot silently
widen the split to an odd-`cols` group.

Two capabilities the bump makes available are deliberately **not yet adopted**,
because adopting either changes drawn geometry and needs its own evidence:
`klt gen cap_array` (#1117) in place of this flow's `klt draw` MiM plates, and
block `orientation` (#1166), which the divider's single row does not need
today.

## Directory layout

The tree below is the layout of a run's output. For a record minted after
#371 only `record.md` sits in `reports/<record-id>/`; every other file is a
manifest entry named `layout/pll/reports/<record-id>/<path>`.

```
layout/pll/
  README.md                  # this file
  reports/
    LATEST                   # plain-text pointer to the newest record id
    <record-id>/             # <YYYYMMDD-HHMMSS>-<short-git-sha>, one per run
      record.md              # verdicts + the schematic-vs-extracted tables (read first)
      plan.json              # the schematic-derived plan: device set + full port/net map
      build.json             # placement/composition summary
      pll_top.gds            # the layout
      pll_<block>.gds        # per-block composed cells
      <group>.gds            # per-group `klt gen`/`klt draw` primitives
      gen.<group>.json       # each generator's own response envelope
      compose.<block>.request.json / .response.json
      drc.json, extract.json, extract.<cell>.json, *.extract.spice
      cells.top.json, cells.<block>.json
      renders/overview.png   # `klt render` all-layer overview
      report.md              # `klt report --format github-summary` rendering
      route-spot-check/      # the same build with the router enabled (GDS deleted)
        reference.spice      # schematic netlist, top level's .subckt/.ends uncommented for `klt lvs`
        lvs.request.json, lvs.json   # `klt lvs` request/result against the routed build (issue #18)
```

`<record-id>` and the `dirty` flag follow the same convention as
`layout/trivial-cell/reports/` and `sim/` — see `layout/README.md`.
