2AMLogic/sky130-pll/sim/pll-lock-mc-negative-control/README.md

# `sim/pll-lock-mc-negative-control/` — T1 item 6's negative control

This unit is `sim/pll-lock-mc`'s campaign run against a **deliberately degraded
variant of its own DUT**. It exists because T1 item 6 (*Statistical claims carry
Monte Carlo evidence*) requires a **deterministic negative control** per Monte
Carlo campaign, and `klt yield` grades one from per-measurement
`negative_control` metadata: a seeded known-bad variant's own samples of the
*same* measurement, which the campaign's statistics must be shown to separate
from the nominal population.

**Status: testbench committed, no record yet.** Nothing in this directory is
evidence today, and `sim/pll-lock-mc/analysis/yield-evidence/` therefore still
carries `klt yield`'s own missing-negative-control warning. See
"What is still owed" at the bottom for exactly what is outstanding and what it
costs; issue #195 tracks it.

## What is degraded, and why that

`design/top/top.sch` with **`design/loop-filter`'s `C1` at a twelfth of its drawn
area** — `W=L=322 µm` → `92.9534 µm`, i.e. 207.83 pF → 17.41 pF by the
`cap_mim_m3_1` subcircuit's own capacitance expression. `R1`, `C2`, `R3`, `C3`
and every other device, net, label and property of the four-block closed loop are
unchanged.

`C1` is the series capacitor of the `R1`/`C1` branch that forms the loop's
compensation zero, and `design/loop-filter/DESIGN.md`'s own sizing derivation
makes it the single component that fixes **both** quantities the loop's dynamics
are stated over — `R1·C1 = tan(φm)/ωc` places the zero, and
`C1 = Icp·Kv·sec(φm)/(2π·N·ωc²)` sets the crossover. Shrinking it raises the
crossover and collapses the phase margin together, leaving a badly under-damped
loop whose residual phase error rings. Period jitter at `CLK` is what ratified
row 9 bounds, so this degrades the loop's damping rather than one filtering path.

**The factor is measured, and so is the choice of knob.**
`sim/lf-c1-jitter-sensitivity` and `sim/lf-c2-jitter-sensitivity` ran seven arms of
this same DUT at this campaign's own sampling point and seed, and between them
they answer both questions a control's degradation has to answer:

| Arm | `C1` / `C2` | Period jitter (RMS) | Locked | Usable as this control? |
| --- | --- | --- | --- | --- |
| nominal | 207.83 / 10.47 pF | 0.523 % | 867 ps | — the population to separate from |
| `C2` area/4 | 2.64 pF | 0.551 % | 867 ps | no — 45 % *under* the bound |
| `C2` area/9 | 1.19 pF | 0.566 % | 867 ps | no — 43 % under |
| `C1` area/9 | 23.19 pF | 0.983 % | 347 ns | no — 1.7 % under |
| **`C1` area/12** | **17.41 pF** | **1.274 %** | **1.53 µs** | **yes** — 27 % over, locks fast |
| `C1` area/16 | 13.07 pF | 3.086 % | 13.13 µs | works (209 % over), but 13 µs to lock is a censoring risk |
| `C1` area/25 | 8.39 pF | *no lock* | — | no — a no-lock draw carries no figure |

Two things had to be true of the knob, and the first one killed the obvious
candidate:

1. **The effect has to be large.** `C2` — the capacitor whose *stated* design
   purpose is attenuating reference-frequency ripple reaching `VCTRL`, and
   therefore the intuitive choice — turns out **not** to be a lever on this
   quantity: an 8.8× reduction moves the measured figure by 8 %, where the control
   needs roughly +91 %. It is rejected by measurement, and
   `sim/lf-c2-jitter-sensitivity`'s README is where that result lives.
2. **The loop still has to lock.** Row 9 is a post-lock quantity, so a draw that
   never locks carries **no** period-jitter figure and is censored out of the
   control's own denominator — costing the control a draw exactly as a passing
   draw would. `C1` area/25 is that failure, measured.

`C1` area/12 is the arm inside both constraints, with margin on both sides: 27 %
over the bound (against the nominal campaign's own −13 %/+13 % draw-to-draw
spread, which puts the worst expected control draw at ≈ 1.11 %, still over) and
1.53 µs to lock from a pre-charged start, against a 50 µs cold-start window whose
nominal draws already reach lock in 24.32–29.72 µs.

**`C1` area/16 is the named fallback** if a `c1div12` draw ever comes back under
the bound: 8× the jitter margin, spent on the other constraint.

## Why this is a *third* control, not a duplicate of the two that exist

This repo already has two committed controls for the same reducer, and neither
is the one item 6 asks for. The distinction is the point, so it is stated here
rather than left to be re-derived:

| Unit | Kind | What it degrades | What it demonstrates |
| --- | --- | --- | --- |
| `sim/jitter-floor` (#178) | **null** control | nothing — an ideal source whose true period jitter is zero by construction | what the `linearize` → `wrdata` → `edge_times` → `period_jitter` pipeline *reports* for a signal that does not jitter, i.e. the dump-grid resolution floor |
| `sim/jitter-calibration` (#185, #197) | **known-bad measurement input** | the *measurement input* — an ideal source at a known nonzero injected jitter | that the reducer recovers an injected figure, and by how much it errs where the grid cannot resolve the edge |
| **this unit** (#195) | **known-bad design** | the *DUT*, by one stated loop-filter parameter (`C1` area/12) | that *this campaign's statistics*, over this population, separate the real design from a worse one |

Both of the first two are load-bearing and neither is a degraded design.
Declaring either one's samples as this campaign's `negative_control` would claim
the statistics separate the population from a degraded PLL when what they
actually separate it from is an ideal pulse source; `signoff/README.md`
§ "Why every other row is `unmet`" case 4b records that decision.

## Why six draws

Six is not a round number. It is the arithmetic in
`sim/pll-lock-mc/analysis/negative-control/reachability.md`, applied to the
nominal population as it now stands.

`klt yield` reports a control `detected` on two conjuncts and nothing else: the
control's own empirical yield strictly below the nominal's, **and** the
control's 95 % interval upper bound strictly below the nominal's interval lower
bound. Against `sim/pll-lock-mc/records/20260925-224917-3a2dd6e.md` — 5 of 5
draws meeting row 9, Clopper-Pearson lower bound **0.478176** — a control in
which *no* draw meets the bound has an interval upper bound of

| Control draws | Interval upper bound | Below 0.478176? | Verdict |
| --- | --- | --- | --- |
| 5 | 0.521824 | no | `not_detected` (committed probe `p4`) |
| **6** | **0.459258** | yes | **`detected`** (committed probe `p7`) |

Both rows are *executed* `klt yield` outputs committed under
`sim/pll-lock-mc/analysis/negative-control/`, not a formula quoted here, so the
threshold is a measured property of the tool. Six is therefore the **cheapest
sufficient** control against today's nominal population — which is also the
whole reason this unit could not be run before #202 landed: while the nominal
campaign's empirical yield was exactly 0, *no* control of any size or
degradation could satisfy either conjunct, and that is what
`reachability.md` proves.

**It is only sufficient if all six draws both lock and miss.** One draw that
meets the 1.0 % bound takes the control's estimate to 1/6 and its interval upper
bound above the nominal's lower bound; one draw that never locks is censored out
of the denominator and takes the control back to five. That is the sizing
constraint the degradation had to be chosen against — large enough to clear the
bound on every draw, small enough to keep every draw locking — and it is why the
factor was measured rather than guessed.

## What is identical to the campaign, and what differs

A negative control has to be the **same experiment** or its samples are not
comparable with the population they are meant to separate from. Everything that
decides *what is measured* is `sim/pll-lock-mc/testbench/tb.json`'s own,
unchanged: the measured node (`CLK`), the 20 ps dump grid, the 200 ps
internal-step cap, `.options reltol=1e-4`, the 50 µs window, the `DR-005`
discharged-loop-filter cold start, the lock criterion, the 20-cycle post-lock
population floor, the ratified 1.0 % bound with `gate_on_bound` left **true**,
and the `(corner, temperature, supply, mismatch, process)` sampling point.

Three things differ, and only three: the DUT, the trial count (6, above), and
this manifest's own `negative_control` block naming the degradation.

That is **checked rather than asserted**, in two places:

- `sim/pll-lock-mc/analysis/yield_evidence.py` refuses to write a
  `negative_control` block at all unless ten of those fields agree between the
  two manifests — and additionally refuses if the control's draws meet the bound
  at least as often as the nominal's, since `klt yield` could not report
  `detected` for such a control however deliberate its degradation was.
- `testbench/gen_tb.py --check` re-derives this unit's testbench schematic from
  `sim/pll-lock-mc/testbench/tb_pll_lock_mc.sch`'s own body and fails on a byte
  of drift, so "same stimulus, same strapping, same reference" is a property
  rather than a claim about a careful copy. The degraded DUT it points at is
  `sim/lf-c1-jitter-sensitivity`'s committed arm — *referenced*, not copied, so
  this unit's circuit and the sizing evidence for it cannot become two different
  circuits.

**Because `gate_on_bound` is left true, every trial of this campaign is expected
to be recorded as a `FAIL`.** That per-trial verdict is the finding, not a
defect: a control whose draws passed would be the failure. (This is the one
place this unit deliberately does *not* follow `sim/integrator-floor`'s
`gate_on_bound: false` convention for a control unit — there, reporting a floor
figure is the whole result and a bound has no meaning; here, "misses the bound"
*is* the result, and having the harness itself assert it per trial is stronger
than a reading of the table.)

## Reproducing

```sh
# 0. the testbench is generated from the design and the nominal campaign --
#    verify neither has drifted
python3 sim/lf-c1-jitter-sensitivity/testbench/gen_c1_variant.py --check
python3 sim/pll-lock-mc-negative-control/testbench/gen_tb.py --check

# 1. the campaign: 6 draws, seeds 1..6, the same 50 us cold-start window
#    sim/pll-lock-mc runs. Cost is this unit's whole difficulty -- see below.
python3 sim/run_corners.py pll-lock-mc-negative-control --mc --jobs 6

# 2. wire the resulting record into the nominal campaign's sample-set documents
python3 sim/pll-lock-mc/analysis/yield_evidence.py \
    sim/pll-lock-mc/records/<nominal-record>.md \
    --negative-control sim/pll-lock-mc-negative-control/records/<this-record>.md \
    --write

# 3. re-run klt yield over them and diff against the committed outputs
bash sim/pll-lock-mc/analysis/klt-yield-env.sh --write

# 4. regenerate the precondition table from whatever step 3 actually reported
python3 signoff/item6_preconditions.py --write
```

## What is still owed

- **The campaign itself.** Six draws of a 50 µs cold-start transient at
  `reltol=1e-4`; the nominal campaign's own record puts five such draws at
  ≈ 4 h 23 m of wall-clock time at `--jobs 5` on a shared host, so this is a
  real spend and it has not been made. (The sizing spend *has*: seven 20 µs
  pre-charged draws across the two `lf-c*-jitter-sensitivity` units, which is
  what stopped the six 50 µs draws from being bought on `C2`, a knob that
  measurement then rejected.) `sim/executor-equivalence/README.md`
  records that no host is provisioned for the batch/remote fleet yet
  (2AMLogic/2am#934), so it is a local spend or none.
- **The `klt yield` verdict.** `negative_control.verdict` must come back
  `detected` — or, if it does not, an argued record for `not_detected` at a
  stated limit with `signoff/run-signoff.sh`'s guard 3 relaxed in the same
  change to accept that limit explicitly. **No verdict is claimed here**: the
  table above says which population *would* be `detected` per the committed
  probes, which is arithmetic over the tool, not a result of this unit's own
  run. Note also that `klt yield` is not reachable from this repo's pinned wheel
  at all (klayout-tools#2466) — `sim/pll-lock-mc/analysis/klt-yield-env.sh` is
  the recipe that builds it.
- **`signoff/item6-preconditions.md` row 3**, which is generated from the
  committed report and will keep reading `unmet` until that report carries a
  fired control.

Even with a `detected` control, T1 item 6 stays `unmet`: guard 3's *other*
condition is that the cited report's estimate be **sized**, and a 5-draw nominal
population is not (`sample_size.verdict` `insufficient`). This unit closes one
of two preconditions, and says so rather than implying it turns a row green.
