2AMLogic/sky130-pll/sim/lockdet-timing/phase/README.md

# LOCK phase-window delay chains (issue #275)

Physical PVT characterization of the acquisition (`W_acq`) and release
(`W_rel`) phase-window delay primitives for the provisional LOCK detector,
part of #259 within #231. This is primitive evidence, **not** the LOCK
circuit: no sample flops, counters or loop integration. DR-007 stays
`proposed` and spec row 16 stays DRAFT; the bands below are the reducer's
constants (`sim/harness/locktiming.py`) and are not changed here.

Bands (DR-007 Table 2): `W_acq` 1.5-4.0 ns, `W_rel` 4.5-10.0 ns,
max(`W_acq`) < min(`W_rel`) (strict), max(`W_rel`) < 12 ns (strict).

## Candidates

Generated by `design/lock-detector/timing/gen_phase_windows.py` (pure text;
it inlines the cell subcircuits verbatim from the pinned PDK's
`sky130_fd_sc_hd.spice` so a batch worker needs no local library path).
Re-running it reproduces every file below byte-for-byte; `manifest.json`
carries each file's SHA-256.

| candidate | acquisition chain | release chain | cells | cell area (liberty) |
| --- | --- | --- | --- | --- |
| `s50` | 7 x `sky130_fd_sc_hd__clkdlybuf4s50_1` | 18 x `sky130_fd_sc_hd__clkdlybuf4s50_1` | 25 | 25 x 10.0096 = 250.2 um^2 |
| `s25` | 14 x `sky130_fd_sc_hd__clkdlybuf4s25_1` | 39 x `sky130_fd_sc_hd__clkdlybuf4s25_1` | 53 | 53 x 10.0096 = 530.5 um^2 |

All cells are drive strength `_1`, non-inverting, chained output-to-input
from one input net `IN`; each chain's last stage drives its tap (`ACQ`,
`REL`) into a declared 10 fF load. Both chains of a candidate share `IN`,
`VDD` and `GND`. Cell area is the liberty `area` attribute
(`sky130_fd_sc_hd__tt_025C_1v80.lib`), placement-free: no routing, no
sample flops, no fill. Taps per candidate: one acquisition tap, one release
tap (stage counts above).

Each netlist is run under two manifests that differ only in edge polarity:
`<id>-rising` measures the input rising crossing to the next tap rising
crossing, `<id>-falling` the falling pair. The netlist is identical, so the
two polarities come from separate batch jobs on the same deck.

Files:

* `design/lock-detector/timing/phase_windows.sch` - both candidates' chains
  (xschem, generated).
* `design/lock-detector/timing/netlist/phase_windows.spice` - the DUT
  subcircuits `phase_win_s50`, `phase_win_s25`.
* `tb_phase_windows.sch` - stimulus and loads (generated).
* `candidates/<id>.spice` - runner decks (cells + DUT + stimulus, `@VDD@`
  placeholder); `candidates/control.spice` the negative control;
  `candidates/<id>-<edge>.json` the reducer manifests.

## Stimulus, startup and measurement conventions

* Supply `VDD` = grid supply (1.62 / 1.8 / 1.98 V); `GND` = 0; cell bulk
  pins `VPB`/`VNB` tied to `VDD`/`GND`.
* `IN`: `PULSE(0 VDD 150n 100p 100p 100n 250n)` - 100 ps (0-100 %) slew,
  rising at 150/400/650 ns, falling at 250/500/750 ns. The input is an ideal
  source (no driver-strength model).
* Reset/startup: the chains have no reset pin. `RSTB` is a separate ideal
  source stepping to `VDD` at 20 ns; it marks the declared enable instant only
  (`startup` trace). From 0 to 150 ns `IN` is held low, so every chain node
  reaches its DC state before the first edge; the analysis window opens at
  100 ns (enable 20 ns + settle 60 ns = 80 ns <= 100 ns).
* Window 100-800 ns, transient step 20 ps. Crossing threshold 0.9 V fixed for
  all supplies (50 % at 1.8 V; 55.6 % of 1.62 V, 45.5 % of 1.98 V). This is a
  declared absolute threshold, not a supply-ratio one.
* The reducer takes the first in-window input crossing of the declared
  polarity and the next tap crossing of the same polarity.
* `tick`/`raw` are the input stimulus itself (250 ns period); their graded
  `tick` band only confirms the stimulus period and is **not** watchdog
  evidence (#276 owns that).

### Mapping to phase-window half-widths (assumption, awaiting #260)

DR-007's handoff realizes the phase test by delaying `REF` and `FBCLK` by
`W` through `sky130_fd_sc_hd` delay chains and sampling with flops. This
campaign equates the half-width with the chain's propagation delay:
`W_acq = t_pd(acq chain)`, `W_rel = t_pd(rel chain)`, input crossing to tap
crossing at the declared threshold. It assumes the sample flops' setup/hold
and clock-to-Q offsets cancel between the two compared arms and that the
in-circuit load and input slew match the declared 10 fF / 100 ps. None of
that is validated here; #260 must validate it in the assembled circuit.
The DR-007 phase test compares rising edges of `REF`/`FBCLK`, so the
`-rising` manifests are the selection basis; the `-falling` manifests are
recorded because a realization that windows on falling edges (or clocks a
sample flop from an inverted tap) sees that polarity instead.

## Evidence

Records (append-only; `records/<record-id>.json`, plus the request, body
netlist and klt report of every batch group under `records/<record-id>/`).
Waveform rawfiles are not committed (regenerable from the frozen body
netlist, per `sim/README.md`'s retention policy); klt `stderr.log` files were
empty and are git-ignored (`*.log`).

| record | content | result |
| --- | --- | --- |
| `lt-20261012-154414-443931` | s50-rising, nominal smoke | `SIM_FAILED`: klt exited 4 ("nothing checked", `no_requested_measurements`). The batch backend ran the deck; the runner treated the exit as failure. Fixed in `locktiming_cli.waveform_only_exit` (exit 4 accepted only with exactly that reason and every corner passed). |
| `lt-20261012-154704-796183` | s50-rising, nominal smoke (supersedes the above) | physical, `OK`: `W_acq` 2.710 ns, `W_rel` 6.853 ns at tt/27 C/1.8 V |
| `lt-20261012-154829-756708` | negative control: `control.spice` (input peaks at 0.6 V, below the 0.9 V threshold) | physical, `ABSENT_CROSSING`, no values: a missing crossing is reported, never invented |

Batch backend contract: the fleet accepted the fixed-stimulus decks
(`klt sim --backend batch`, AWS Spot, job ids in each record). The fleet
runner is klt 0.5.0 while the client is 0.7.0 (`version_skew: true`,
`runner_compatibility: mismatch` in every report). The runner applied the
process `.lib` section and `.temp` per corner (checked in a returned
`corner.cir`), and the supply is fixed in the body netlist, so this campaign
does not depend on a request option the older runner might ignore.

Waveform/reducer cross-check: one local single-corner ngspice run (tt,
27 C, 1.8 V, `s50.spice` with `.lib ... tt`, `.temp 27`, `.tran 20p 800n`,
`.meas` TRIG/TARG at 0.9 V on the second rising and first falling edge) gave
`W_acq` 2.70974 ns / `W_rel` 6.85303 ns rising, 2.25556 / 5.68709 ns
falling. The batch-reduced rising values above agree to < 0.1 ps.

### Full PVT grid

Four records, one per candidate x polarity, each the complete 45-point
matrix (tt/ff/ss/fs/sf x -40/27/125 C x 1.62/1.8/1.98 V) run through the
runner's klt batch path (three supply groups of 15 corners each, fleet jobs
listed in each record). Every record is `physical`, `complete: true`, with
no failed, missing, duplicate or unexpected points (45 of 45 `OK`). Startup
latency (enable-to-first-edge convention) and the stimulus period (`tick`)
pass in all four.

| record | candidate | `W_acq` (ns) | `W_rel` (ns) | reducer verdict |
| --- | --- | --- | --- | --- |
| `lt-20261012-215440-502985` | `s50` rising | 1.885 - 4.584 | 4.745 - 11.573 | MISS: `W_acq` 4 points > 4.0, `W_rel` 4 points > 10.0 |
| `lt-20261012-215409-824834` | `s50` falling | 1.583 - 3.633 | 4.001 - 9.205 | MISS: `W_rel` 4 points < 4.5 |
| `lt-20261012-220148-142698` | `s25` rising | 1.748 - 4.064 | 4.748 - 11.064 | MISS: `W_acq` 1 point > 4.0, `W_rel` 2 points > 10.0 |
| `lt-20261012-220219-074618` | `s25` falling | 1.677 - 3.776 | 4.591 - 10.376 | MISS: `W_rel` 1 point > 10.0 |

Bands: `W_acq` 1.5-4.0 ns, `W_rel` 4.5-10.0 ns. In all four records the
cross-window checks pass: max(`W_acq`) < min(`W_rel`) (strict) and
max(`W_rel`) < 12 ns (strict). Every extreme sits at the same corners:
fastest at ff/-40 C/1.98 V, slowest at ss/-40 C/1.62 V. The spread is
dominated by process and supply (about 2.4x for the 1.62-1.98 V and ss/ff
extremes combined), not temperature.

**Verdict: no tested candidate meets the bands.** On the rising edges, which
are the selection basis (the DR-007 phase test compares rising `REF`/`FBCLK`
edges), both `s50` and `s25` miss the `W_rel` ceiling (11.573 ns and
11.064 ns against 10.0 ns) and the `W_acq` ceiling (4.584 ns and 4.064 ns
against 4.0 ns). The nearest rising candidate is `s25` (acquisition misses by
0.064 ns at one corner, release by up to 1.064 ns at two). On falling edges
only `s25` is close (one `W_rel` point at 10.376 ns); `s50` falling misses
the `W_rel` floor at four corners (min 4.001 ns). No tap was selected. This
is a fully measured miss.

Why a different tap count of the same cells would not fix it: the release
band spans a ratio of 10.0/4.5 = 2.22, but the measured slowest/fastest
`W_rel` ratio is 2.44 (`s50` rising), 2.33 (`s25` rising), 2.26 (`s25`
falling) and 2.30 (`s50` falling). Scaling the tap count scales the whole
envelope, so it cannot narrow the ratio; the release band is unreachable
with these cells over the full grid, whatever the count. The acquisition
band (ratio 4.0/1.5 = 2.67) is wide enough in principle (measured ratios
2.1-2.4) and could be re-centered by a shorter chain. Meeting the release
band needs a structure whose delay varies less across process and supply
(or a revisit of the band), which is follow-up design work and is not done
here. This miss blocks #260 as the issue states. No band, spec value or
DR-007 status was changed.

Waveform/reducer cross-check at the worst corner: one local single-corner
ngspice run (ss, -40 C, 1.62 V, `s50.spice`, the same combined-PDK library
the batch request names, `.meas` at 0.9 V from 100 ns) gave rising
`W_acq` 4.58433 ns / `W_rel` 11.5730 ns and falling 3.63304 ns / 9.20474 ns.
The records give 4.58447 / 11.5732 ns (rising) and 3.633 / 9.205 ns
(falling): agreement to < 0.2 ps. (A first probe that used the standalone
ngspice-flavored `sky130.lib.spice` instead of the combined library read
5.07 / 12.8 ns; the models differ, so the library path must match the
request's `libs.tech/combined/sky130.lib.spice`.)

Fleet note: all 12 jobs ran on `c7i.8xlarge` Spot instances and klt exited 4
("nothing checked", `no_requested_measurements`) on every one; the runner
accepted that as waveform-only via `locktiming_cli.waveform_only_exit`, as in
the smoke (ngspice 46, runner klt 0.5.0 vs client 0.7.0, `version_skew: true`
accepted as in the smoke); no submit failure occurred.

Cell inventory and area: see the Candidates table (liberty areas;
measured from liberty, placement-free). Selection of a cell/tap count did not
occur, so there is no selected-area figure.

## Switching current and shared VDD

Measured (local, single corner tt/27 C/1.8 V only, ideal input source, the
two 10 fF tap loads included; integral of the supply current):

| candidate | charge per input rising edge | per falling edge | per input period | peak supply current |
| --- | --- | --- | --- | --- |
| `s50` | 0.41 pC | 0.38 pC | 0.80 pC | 0.23 mA |
| `s25` | 0.62 pC | 0.59 pC | 1.22 pC | 0.36 mA |

Estimates (not measured): average current is charge per period times the
edge rate, e.g. `s50` at a 10-25 MHz reference is about 8-20 uA per delayed
signal; DR-007 delays both `REF` and `FBCLK`, so double it. The peak current
is a sub-ns burst per stage as the edge travels the chain (about 2.7 ns for
the acquisition tap, about 6.9 ns for the release tap at nominal). If the
chains share `VDD` with the VCO or charge pump, that burst lands right after
each reference edge, i.e. inside the phase-comparison interval; whether it
disturbs the loop is not evaluated here and is a #260/#231 integration
question. PVT variation of the current was not measured.

## Reproduction

```
python3 design/lock-detector/timing/gen_phase_windows.py   # regenerate; no diff expected
# plan only
python3 sim/run_locktiming.py --candidate sim/lockdet-timing/phase/candidates/s50-rising.json=sim/lockdet-timing/phase/candidates/s50.spice --points all --dry-run
# physical grid, one candidate (klt batch backend; no local fallback)
python3 sim/run_locktiming.py --candidate sim/lockdet-timing/phase/candidates/s50-rising.json=sim/lockdet-timing/phase/candidates/s50.spice \
    --points all --records-dir sim/lockdet-timing/phase/records
```

A rerun of an already recorded matrix needs `--supersedes <record-id>`. Each
group's bytes are stored with `klt artifact put` (DR-013), so the run needs
`KLT_ARTIFACT_BROKER`; git keeps the JSON records and the manifests.
