2AMLogic/sky130-pll/design/pfd-cp/DESIGN.md

# PFD + charge pump — design rationale (issue #25)

Tri-state phase-frequency detector and three-state charge pump for the
sky130 PLL, block 2 of 4 of the `#14` decomposition. Standalone block: this
document records the design choices behind `pfd_cp.sch`/`pfd_cp.sym`, not a
verified result. **No `sim/` testbench exists for this block yet** (that is
#23 plus whatever sub-issue runs the sky130 PVT campaign once the rows this
design targets are ratified) — every number below is a design target or an
informal, uncommitted sanity check, never a claim against
`spec/target-spec.md`.

## Forward design, not reverse-engineered

This is a textbook tri-state (three-state) edge-triggered PFD driving a
three-state charge pump — the same basic structure described in standard
PLL design texts (Gardner, *Phaselock Techniques*; Best, *Phase-Locked
Loops*; Razavi's PLL/RF-CMOS texts) and used throughout the published
charge-pump PLL literature. The specific gate-level realization here (an
edge-pulse generator plus a NOR-based SR latch, in place of a full
master-slave D flip-flop — see "PFD implementation" below) and the
single-stage, switch-at-output charge pump topology (see "Charge pump
topology" below) were authored fresh against sky130's own device models and
this repo's own 1.8 V headroom constraint; nothing here originates in
another chip's silicon or netlist, per `CLAUDE.md`'s reverse-engineering-free
rule.

## Scope: standalone block, not the closed loop

This issue authors the PFD + charge pump block only. It is not wired to the
VCO (`design/vco/vco_ring5.sch`, issue #24), the loop filter
(`design/loop-filter/loop_filter.sch`, issue #26), or the divider
(`design/divider/divider_intN.sch`, issue #27) here — that is the
integration sub-issue tracked on `#14`. `CP` (this block's current-injection
output) is documented as "drives the loop filter's `CP` input" as the
intended usage — it uses exactly that net name so
`design/loop-filter/loop_filter.sch`'s own `CP` pin lines up — but no
hierarchical instantiation of any sibling symbol happens in this schematic.
`REF` and `DIV` are exposed as plain inputs (intended sources: an external
reference and, respectively, the divider block's `FBCLK` output), out of
this issue's scope to wire up.

## PFD topology: tri-state edge-triggered, SR-latch implementation

### Why tri-state (not an XOR or a mixer)

Three standard phase-detector families were the candidates:

- **Analog mixer / XOR phase detector** — simplest circuit, but its output
  has a strong ripple component at 2x the input frequency even in lock, and
  it is a *phase*-only detector: two clocks at different frequencies do not
  converge (no frequency-acquisition behavior), so a real PLL needs an
  auxiliary frequency-detect/acquisition-aid loop layered on top.
- **Sequential tri-state PFD** (chosen) — the standard choice for charge-pump
  PLLs specifically because it is simultaneously a phase *and* frequency
  detector: when `REF` and `DIV` are at different frequencies, `UP`/`DN`'s
  average duty cycle pushes the loop toward frequency lock on its own, with
  no separate acquisition circuit. Output is three states (`UP` active,
  `DN` active, or neither — "tri-state"), which is exactly what a
  three-state charge pump consumes directly.
- **Bang-bang / early-late phase detector** — the standard choice for
  clock-data-recovery loops with an already-frequency-locked reference; not
  applicable here (this PLL's `REF`/`DIV` are not already frequency-locked
  going into the detector).

**Chosen: sequential tri-state PFD**, feeding a three-state charge pump —
the textbook default for charge-pump integer-N PLLs, and the only one of the
three that gives frequency acquisition without extra circuitry. There is no
existing sky130 precedent for this topology in this repo to build from or
adapt (design/divider/DESIGN.md's `sky130_fd_sc_hd` standard-cell precedent
does not apply here — no PDK standard cell implements a tri-state PFD).
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
