2AMLogic/sky130-pll/spec/decision-records/DR-001-supply-flavor-scope.md

# DR-001: sky130 supply-flavor and port scope

- **Status**: **accepted** — ratified by the operator in #1 on 2026-08-13.
- **Date**: 2026-08-13
- **Author**: Builder agent (drafted per #3)
- **Ratified in**: #1 (Ratify the target spec — T1-gate entry). The operator
  ruled **for this record's recommendation without modification**: the 1.8 V
  core (`nfet_01v8`/`pfet_01v8`) is the ratified device family for the ring,
  PFD, charge pump, and dividers; the medium-/high-voltage (`g5v0`-family /
  I/O-class) arrangement is **deferred, not rejected**, and may be revisited
  only if a downstream integration surfaces a genuine interface constraint,
  per "Why the medium-/high-voltage flavor is deferred" below.
- **Supersedes**: none
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
