2AMLogic/sky130-pll/layout/pll/reports/20260819-082044-d3af784/renders/overview.png

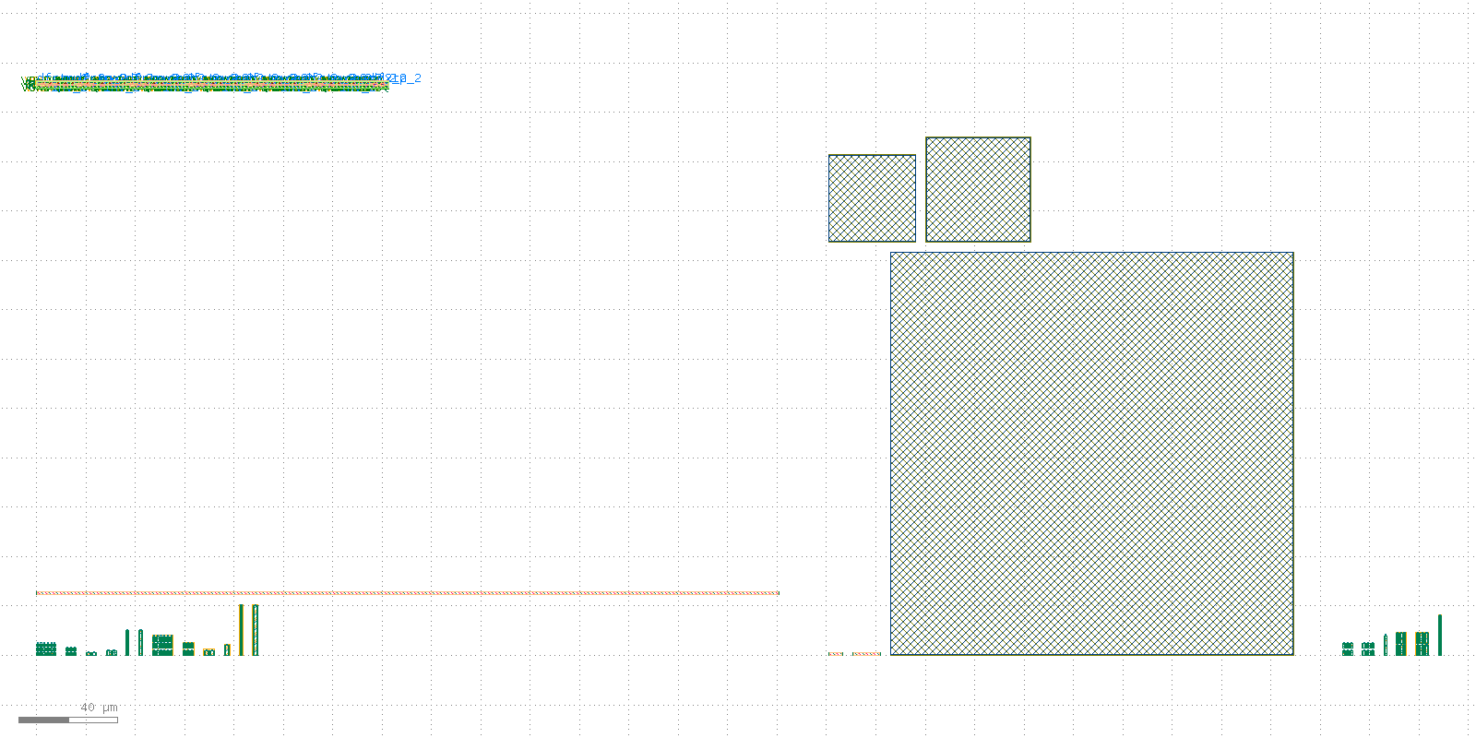
layout/pll/reports/20260819-082044-d3af784/renders/overview.png
