2AMLogic/sky130-pll/layout/pll/reports/20260906-162756-9be24a9/renders/overview.png

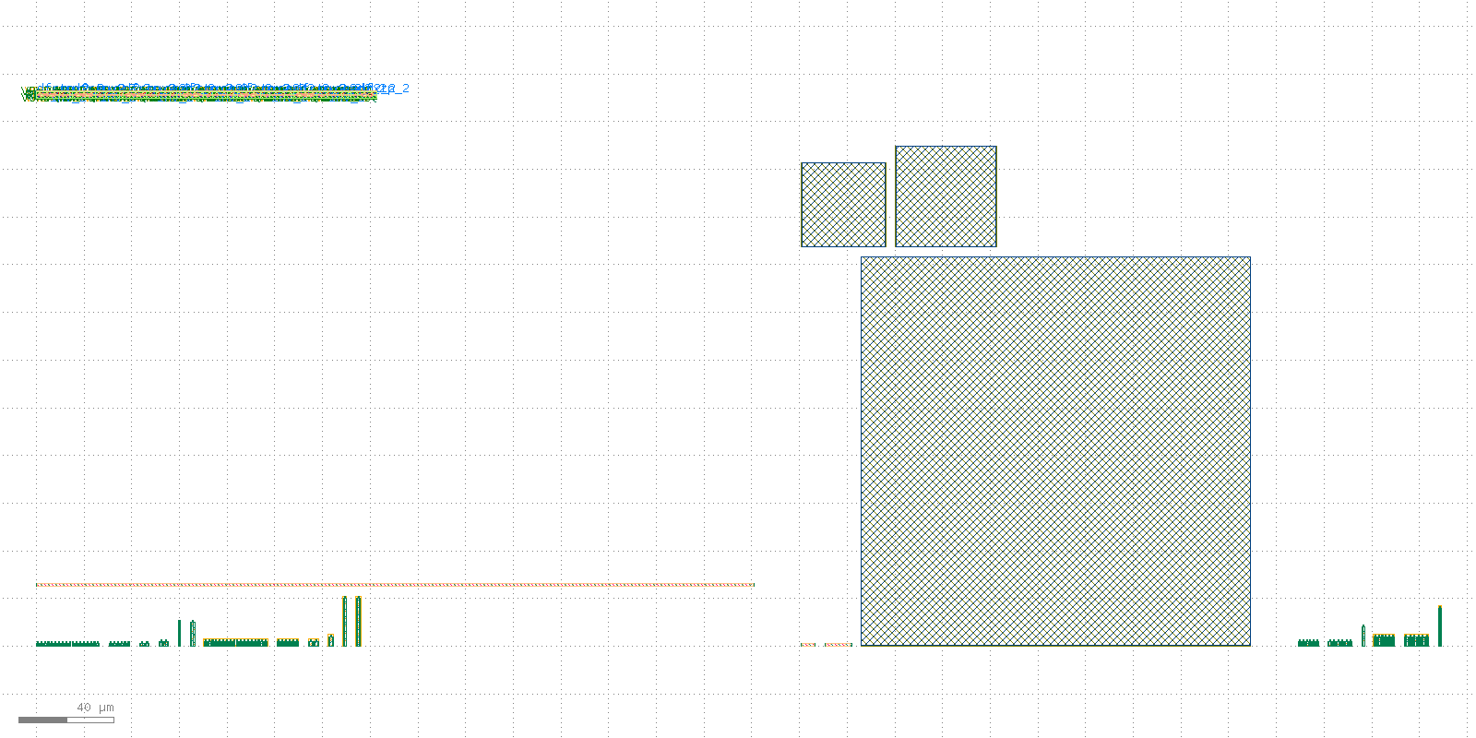
layout/pll/reports/20260906-162756-9be24a9/renders/overview.png
