2AMLogic/sky130-pll/layout/pll/reports/20260924-041509-c53e7c4/renders/overview.png

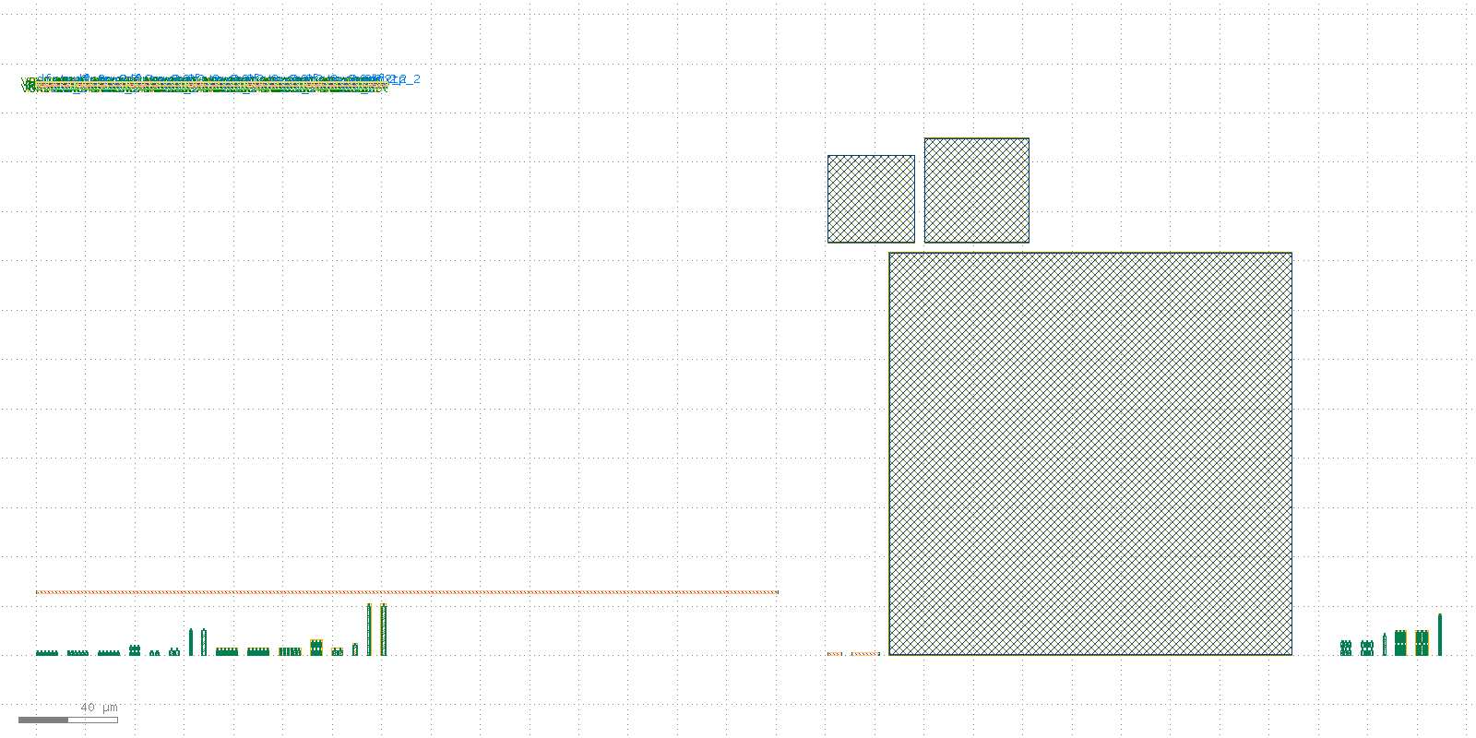
layout/pll/reports/20260924-041509-c53e7c4/renders/overview.png
