2AMLogic/sky130-pll/verification/guard-mktemp-template/RECORD-2026-10-09-1ee7fb0.md

# Reproduction record: explicit `/tmp` mktemp template (issue #239)

Append-only evidence. A re-run mints a new record that names the one it
supersedes; this record is not edited. This is a hook-decision record only: no
command text was executed, no temporary directory was created, no simulator was
run, and no PLL measurement or `sim/` record was created or changed.

- Supersedes: none (first record)
- Date: 2026-10-09
- Source revision (main): `1ee7fb07c7ffe7253ebdab2f62cf4ea7abef1b28`
- Fixture: `verification/guard-mktemp-template/run-matrix.sh`
- Dispatcher: `.loom/hooks/guard-destructive.sh` (sha256 prefix `3d9eed6e01de13bc`)
- Selected implementation: `.loom/hooks/guard-destructive-generic.sh`
  (vendored; sha256 prefix `1f8af16e33a6b653`), Loom install 0.19.966. The
  Repo Skills guard did not pass all dispatcher probes, so the vendored copy is
  the one that decides.
- Confinement prerequisites: bash, jq, git; primary checkout; 4 linked
  worktrees under `.loom/worktrees`; worktree isolation not disabled in the
  environment or `.loom/config.json`. All present, so the run is conclusive.

## Decisions (JSON `permissionDecision`; allow = exit 0 with empty stdout)

| Row | Role | Command text (data only) | Expected | Actual |
| --- | --- | --- | --- | --- |
| R1 | control | `S=$(mktemp -d); printf probe > "$S/result.txt"` | allow | allow |
| R2 | control | `S=/tmp/loom-guard-probe; printf probe > "$S/result.txt"` | allow | allow |
| R3 | control | `printf probe > "$UNKNOWN/result.txt"` | deny | deny |
| R4 | control | `S=<PRIMARY_ROOT>; printf probe > "$S/result.txt"` | deny | deny |
| R5 | control | `S=$(mktemp -d /tmp/loom-guard-probe.XXXXXX); S=<PRIMARY_ROOT>; printf probe > "$S/result.txt"` | deny | deny |
| R6 | control | `S=$(mktemp -d /tmp/loom-guard-probe.XXXXXX); printf probe > "$S/../escape.txt"` | deny | deny |
| R7 | control | `S=$(mktemp -d <PRIMARY_ROOT>/probe.XXXXXX); printf probe > "$S/result.txt"` | deny | deny |
| R0 | target | `S=$(mktemp -d /tmp/loom-guard-probe.XXXXXX); printf probe > "$S/result.txt"` | allow | **deny** |

R3 and R4 denying prove the guard is active; R1 and R2 allowing prove it is not
a blanket deny. R0 denies with a reason beginning `BLOCKED: Bash-tool write
target '$S/result.txt' is an unexpanded shell variable from the path root down`.

## Outcome

The defect still reproduces on current main. The fixture exits 3
(`BLOCKED-UPSTREAM`). The vendored guard's `wt_write_mktemp_same_command_safe()`
accepts only bare `mktemp -d` forms; the file header names Repo Skills
(`hooks/repo/guard-destructive.sh`) as the canonical owner of generic fixes.

Status of issue #239: **blocked on an upstream Repo Skills release** that
carries the bounded-template resolver and its containment tests (handoff text in
`UPSTREAM-HANDOFF.md`). The consumer defect is NOT fixed by this change; no
resolver, vendored hook, or guard configuration was edited. When a supported
release is consumed, re-run the fixture and add a new record naming this one.
