2AMLogic/sky130-pll/sim/jitter-calibration/netlist-snapshots/20260925-160214-ed585e4.spice

** sch_path: /home/ubuntu/GitHub/sky130-pll/.loom/worktrees/issue-197/sim/jitter-calibration/testbench/tb_jitter_calibration.sch
**.subckt tb_jitter_calibration
R1 CLK GND 1k m=1
**** begin user architecture code

** GENERATED -- variant K05a: 300 cycles, nominal period
** 3.9952 ns, injected period jitter 0.500000% RMS
** (seeded RNG, seed 185005), TR = TF = 20 ps.
VCLK CLK GND pwl(
+ 0.000000n 0 1.990000n 0 2.010000n 1.8 3.983498n 1.8
+ 4.003498n 0 5.976996n 0 5.996996n 1.8 7.969382n 1.8
+ 7.989382n 0 9.961768n 0 9.981768n 1.8 11.963771n 1.8
+ 11.983771n 0 13.965775n 0 13.985775n 1.8 15.972743n 1.8
+ 15.992743n 0 17.979711n 0 17.999711n 1.8 19.979045n 1.8
+ 19.999045n 0 21.978378n 0 21.998378n 1.8 23.983612n 1.8
+ 24.003612n 0 25.988847n 0 26.008847n 1.8 27.971746n 1.8
+ 27.991746n 0 29.954644n 0 29.974644n 1.8 31.950526n 1.8
+ 31.970526n 0 33.946408n 0 33.966408n 1.8 35.938234n 1.8
+ 35.958234n 0 37.930060n 0 37.950060n 1.8 39.930361n 1.8
+ 39.950361n 0 41.930663n 0 41.950663n 1.8 43.951669n 1.8
+ 43.971669n 0 45.972676n 0 45.992676n 1.8 47.960135n 1.8
+ 47.980135n 0 49.947594n 0 49.967594n 1.8 51.944738n 1.8
+ 51.964738n 0 53.941883n 0 53.961883n 1.8 55.933416n 1.8
+ 55.953416n 0 57.924949n 0 57.944949n 1.8 59.915735n 1.8
+ 59.935735n 0 61.906522n 0 61.926522n 1.8 63.901233n 1.8
+ 63.921233n 0 65.895944n 0 65.915944n 1.8 67.889275n 1.8
+ 67.909275n 0 69.882606n 0 69.902606n 1.8 71.899384n 1.8
+ 71.919384n 0 73.916162n 0 73.936162n 1.8 75.913887n 1.8
+ 75.933887n 0 77.911612n 0 77.931612n 1.8 79.907868n 1.8
+ 79.927868n 0 81.904123n 0 81.924123n 1.8 83.915443n 1.8
+ 83.935443n 0 85.926762n 0 85.946762n 1.8 87.918899n 1.8
+ 87.938899n 0 89.911036n 0 89.931036n 1.8 91.910183n 1.8
+ 91.930183n 0 93.909330n 0 93.929330n 1.8 95.896705n 1.8
+ 95.916705n 0 97.884081n 0 97.904081n 1.8 99.897644n 1.8
+ 99.917644n 0 101.911208n 0 101.931208n 1.8 103.920550n 1.8
+ 103.940550n 0 105.929891n 0 105.949891n 1.8 107.947874n 1.8
+ 107.967874n 0 109.965858n 0 109.985858n 1.8 111.959682n 1.8
+ 111.979682n 0 113.953505n 0 113.973505n 1.8 115.953177n 1.8
+ 115.973177n 0 117.952848n 0 117.972848n 1.8 119.923821n 1.8
+ 119.943821n 0 121.894794n 0 121.914794n 1.8 123.892514n 1.8
+ 123.912514n 0 125.890233n 0 125.910233n 1.8 127.889136n 1.8
+ 127.909136n 0 129.888039n 0 129.908039n 1.8 131.864326n 1.8
+ 131.884326n 0 133.840614n 0 133.860614n 1.8 135.850437n 1.8
+ 135.870437n 0 137.860260n 0 137.880260n 1.8 139.841339n 1.8
+ 139.861339n 0 141.822418n 0 141.842418n 1.8 143.807030n 1.8
+ 143.827030n 0 145.791642n 0 145.811642n 1.8 147.764241n 1.8
+ 147.784241n 0 149.736839n 0 149.756839n 1.8 151.729350n 1.8
+ 151.749350n 0 153.721862n 0 153.741862n 1.8 155.712749n 1.8
+ 155.732749n 0 157.703635n 0 157.723635n 1.8 159.705101n 1.8
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
+ )


** sky130 PDK model include (tt corner) -- patched per-point by sim/harness.
** No device in this testbench uses it: it is here so the harness's own
** corner substitution and this record's environment provenance are the same
** as every other campaign's. See this file's header comment.
.lib /home/ubuntu/.volare/sky130A/libs.tech/combined/sky130.lib.spice tt
** No .tran/.print card here on purpose -- sim/harness/measure.py injects the
** analysis from this manifest's own measure block.

**** end user architecture code
**.ends
.GLOBAL GND
.end
