2AMLogic/sky130-pll/sim/jitter-calibration/netlist-snapshots/20260925-160252-ed585e4.spice

** sch_path: /home/ubuntu/GitHub/sky130-pll/.loom/worktrees/issue-197/sim/jitter-calibration/testbench/tb_jitter_calibration.sch
**.subckt tb_jitter_calibration
R1 CLK GND 1k m=1
**** begin user architecture code

** GENERATED -- variant K05b: 300 cycles, nominal period
** 3.9952 ns, injected period jitter 0.500000% RMS
** (seeded RNG, seed 185005), TR = TF = 200 ps.
VCLK CLK GND pwl(
+ 0.000000n 0 1.900000n 0 2.100000n 1.8 3.893498n 1.8
+ 4.093498n 0 5.886996n 0 6.086996n 1.8 7.879382n 1.8
+ 8.079382n 0 9.871768n 0 10.071768n 1.8 11.873771n 1.8
+ 12.073771n 0 13.875775n 0 14.075775n 1.8 15.882743n 1.8
+ 16.082743n 0 17.889711n 0 18.089711n 1.8 19.889045n 1.8
+ 20.089045n 0 21.888378n 0 22.088378n 1.8 23.893612n 1.8
+ 24.093612n 0 25.898847n 0 26.098847n 1.8 27.881746n 1.8
+ 28.081746n 0 29.864644n 0 30.064644n 1.8 31.860526n 1.8
+ 32.060526n 0 33.856408n 0 34.056408n 1.8 35.848234n 1.8
+ 36.048234n 0 37.840060n 0 38.040060n 1.8 39.840361n 1.8
+ 40.040361n 0 41.840663n 0 42.040663n 1.8 43.861669n 1.8
+ 44.061669n 0 45.882676n 0 46.082676n 1.8 47.870135n 1.8
+ 48.070135n 0 49.857594n 0 50.057594n 1.8 51.854738n 1.8
+ 52.054738n 0 53.851883n 0 54.051883n 1.8 55.843416n 1.8
+ 56.043416n 0 57.834949n 0 58.034949n 1.8 59.825735n 1.8
+ 60.025735n 0 61.816522n 0 62.016522n 1.8 63.811233n 1.8
+ 64.011233n 0 65.805944n 0 66.005944n 1.8 67.799275n 1.8
+ 67.999275n 0 69.792606n 0 69.992606n 1.8 71.809384n 1.8
+ 72.009384n 0 73.826162n 0 74.026162n 1.8 75.823887n 1.8
+ 76.023887n 0 77.821612n 0 78.021612n 1.8 79.817868n 1.8
+ 80.017868n 0 81.814123n 0 82.014123n 1.8 83.825443n 1.8
+ 84.025443n 0 85.836762n 0 86.036762n 1.8 87.828899n 1.8
+ 88.028899n 0 89.821036n 0 90.021036n 1.8 91.820183n 1.8
+ 92.020183n 0 93.819330n 0 94.019330n 1.8 95.806705n 1.8
+ 96.006705n 0 97.794081n 0 97.994081n 1.8 99.807644n 1.8
+ 100.007644n 0 101.821208n 0 102.021208n 1.8 103.830550n 1.8
+ 104.030550n 0 105.839891n 0 106.039891n 1.8 107.857874n 1.8
+ 108.057874n 0 109.875858n 0 110.075858n 1.8 111.869682n 1.8
+ 112.069682n 0 113.863505n 0 114.063505n 1.8 115.863177n 1.8
+ 116.063177n 0 117.862848n 0 118.062848n 1.8 119.833821n 1.8
+ 120.033821n 0 121.804794n 0 122.004794n 1.8 123.802514n 1.8
+ 124.002514n 0 125.800233n 0 126.000233n 1.8 127.799136n 1.8
+ 127.999136n 0 129.798039n 0 129.998039n 1.8 131.774326n 1.8
+ 131.974326n 0 133.750614n 0 133.950614n 1.8 135.760437n 1.8
+ 135.960437n 0 137.770260n 0 137.970260n 1.8 139.751339n 1.8
+ 139.951339n 0 141.732418n 0 141.932418n 1.8 143.717030n 1.8
+ 143.917030n 0 145.701642n 0 145.901642n 1.8 147.674241n 1.8
+ 147.874241n 0 149.646839n 0 149.846839n 1.8 151.639350n 1.8
+ 151.839350n 0 153.631862n 0 153.831862n 1.8 155.622749n 1.8
+ 155.822749n 0 157.613635n 0 157.813635n 1.8 159.615101n 1.8
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
+ )


** sky130 PDK model include (tt corner) -- patched per-point by sim/harness.
** No device in this testbench uses it: it is here so the harness's own
** corner substitution and this record's environment provenance are the same
** as every other campaign's. See this file's header comment.
.lib /home/ubuntu/.volare/sky130A/libs.tech/combined/sky130.lib.spice tt
** No .tran/.print card here on purpose -- sim/harness/measure.py injects the
** analysis from this manifest's own measure block.

**** end user architecture code
**.ends
.GLOBAL GND
.end
