2AMLogic/sky130-pll/sim/jitter-calibration/netlist-snapshots/20260925-160316-ed585e4.spice

** sch_path: /home/ubuntu/GitHub/sky130-pll/.loom/worktrees/issue-197/sim/jitter-calibration/testbench/tb_jitter_calibration.sch
**.subckt tb_jitter_calibration
R1 CLK GND 1k m=1
**** begin user architecture code

** GENERATED -- variant K05c: 300 cycles, nominal period
** 3.9952 ns, injected period jitter 0.500000% RMS
** (seeded RNG, seed 185005), TR = TF = 1 ns.
VCLK CLK GND pwl(
+ 0.000000n 0 1.500000n 0 2.500000n 1.8 3.493498n 1.8
+ 4.493498n 0 5.486996n 0 6.486996n 1.8 7.479382n 1.8
+ 8.479382n 0 9.471768n 0 10.471768n 1.8 11.473771n 1.8
+ 12.473771n 0 13.475775n 0 14.475775n 1.8 15.482743n 1.8
+ 16.482743n 0 17.489711n 0 18.489711n 1.8 19.489045n 1.8
+ 20.489045n 0 21.488378n 0 22.488378n 1.8 23.493612n 1.8
+ 24.493612n 0 25.498847n 0 26.498847n 1.8 27.481746n 1.8
+ 28.481746n 0 29.464644n 0 30.464644n 1.8 31.460526n 1.8
+ 32.460526n 0 33.456408n 0 34.456408n 1.8 35.448234n 1.8
+ 36.448234n 0 37.440060n 0 38.440060n 1.8 39.440361n 1.8
+ 40.440361n 0 41.440663n 0 42.440663n 1.8 43.461669n 1.8
+ 44.461669n 0 45.482676n 0 46.482676n 1.8 47.470135n 1.8
+ 48.470135n 0 49.457594n 0 50.457594n 1.8 51.454738n 1.8
+ 52.454738n 0 53.451883n 0 54.451883n 1.8 55.443416n 1.8
+ 56.443416n 0 57.434949n 0 58.434949n 1.8 59.425735n 1.8
+ 60.425735n 0 61.416522n 0 62.416522n 1.8 63.411233n 1.8
+ 64.411233n 0 65.405944n 0 66.405944n 1.8 67.399275n 1.8
+ 68.399275n 0 69.392606n 0 70.392606n 1.8 71.409384n 1.8
+ 72.409384n 0 73.426162n 0 74.426162n 1.8 75.423887n 1.8
+ 76.423887n 0 77.421612n 0 78.421612n 1.8 79.417868n 1.8
+ 80.417868n 0 81.414123n 0 82.414123n 1.8 83.425443n 1.8
+ 84.425443n 0 85.436762n 0 86.436762n 1.8 87.428899n 1.8
+ 88.428899n 0 89.421036n 0 90.421036n 1.8 91.420183n 1.8
+ 92.420183n 0 93.419330n 0 94.419330n 1.8 95.406705n 1.8
+ 96.406705n 0 97.394081n 0 98.394081n 1.8 99.407644n 1.8
+ 100.407644n 0 101.421208n 0 102.421208n 1.8 103.430550n 1.8
+ 104.430550n 0 105.439891n 0 106.439891n 1.8 107.457874n 1.8
+ 108.457874n 0 109.475858n 0 110.475858n 1.8 111.469682n 1.8
+ 112.469682n 0 113.463505n 0 114.463505n 1.8 115.463177n 1.8
+ 116.463177n 0 117.462848n 0 118.462848n 1.8 119.433821n 1.8
+ 120.433821n 0 121.404794n 0 122.404794n 1.8 123.402514n 1.8
+ 124.402514n 0 125.400233n 0 126.400233n 1.8 127.399136n 1.8
+ 128.399136n 0 129.398039n 0 130.398039n 1.8 131.374326n 1.8
+ 132.374326n 0 133.350614n 0 134.350614n 1.8 135.360437n 1.8
+ 136.360437n 0 137.370260n 0 138.370260n 1.8 139.351339n 1.8
+ 140.351339n 0 141.332418n 0 142.332418n 1.8 143.317030n 1.8
+ 144.317030n 0 145.301642n 0 146.301642n 1.8 147.274241n 1.8
+ 148.274241n 0 149.246839n 0 150.246839n 1.8 151.239350n 1.8
+ 152.239350n 0 153.231862n 0 154.231862n 1.8 155.222749n 1.8
+ 156.222749n 0 157.213635n 0 158.213635n 1.8 159.215101n 1.8
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
+ )


** sky130 PDK model include (tt corner) -- patched per-point by sim/harness.
** No device in this testbench uses it: it is here so the harness's own
** corner substitution and this record's environment provenance are the same
** as every other campaign's. See this file's header comment.
.lib /home/ubuntu/.volare/sky130A/libs.tech/combined/sky130.lib.spice tt
** No .tran/.print card here on purpose -- sim/harness/measure.py injects the
** analysis from this manifest's own measure block.

**** end user architecture code
**.ends
.GLOBAL GND
.end
