2AMLogic/sky130-pll/sim/jitter-calibration/netlist-snapshots/20260925-160342-ed585e4.spice

** sch_path: /home/ubuntu/GitHub/sky130-pll/.loom/worktrees/issue-197/sim/jitter-calibration/testbench/tb_jitter_calibration.sch
**.subckt tb_jitter_calibration
R1 CLK GND 1k m=1
**** begin user architecture code

** GENERATED -- variant K10a: 300 cycles, nominal period
** 3.9952 ns, injected period jitter 1.000000% RMS
** (seeded RNG, seed 185010), TR = TF = 20 ps.
VCLK CLK GND pwl(
+ 0.000000n 0 1.990000n 0 2.010000n 1.8 3.996868n 1.8
+ 4.016868n 0 6.003737n 0 6.023737n 1.8 8.020749n 1.8
+ 8.040749n 0 10.037762n 0 10.057762n 1.8 11.995327n 1.8
+ 12.015327n 0 13.952893n 0 13.972893n 1.8 15.964151n 1.8
+ 15.984151n 0 17.975409n 0 17.995409n 1.8 19.996369n 1.8
+ 20.016369n 0 22.017329n 0 22.037329n 1.8 23.998800n 1.8
+ 24.018800n 0 25.980271n 0 26.000271n 1.8 27.949216n 1.8
+ 27.969216n 0 29.918161n 0 29.938161n 1.8 31.926417n 1.8
+ 31.946417n 0 33.934672n 0 33.954672n 1.8 35.925470n 1.8
+ 35.945470n 0 37.916269n 0 37.936269n 1.8 39.921551n 1.8
+ 39.941551n 0 41.926833n 0 41.946833n 1.8 43.919109n 1.8
+ 43.939109n 0 45.911386n 0 45.931386n 1.8 47.894864n 1.8
+ 47.914864n 0 49.878342n 0 49.898342n 1.8 51.888994n 1.8
+ 51.908994n 0 53.899645n 0 53.919645n 1.8 55.892926n 1.8
+ 55.912926n 0 57.886206n 0 57.906206n 1.8 59.879520n 1.8
+ 59.899520n 0 61.872833n 0 61.892833n 1.8 63.874515n 1.8
+ 63.894515n 0 65.876196n 0 65.896196n 1.8 67.869150n 1.8
+ 67.889150n 0 69.862105n 0 69.882105n 1.8 71.867720n 1.8
+ 71.887720n 0 73.873336n 0 73.893336n 1.8 75.866033n 1.8
+ 75.886033n 0 77.858730n 0 77.878730n 1.8 79.884197n 1.8
+ 79.904197n 0 81.909664n 0 81.929664n 1.8 83.859445n 1.8
+ 83.879445n 0 85.809226n 0 85.829226n 1.8 87.824017n 1.8
+ 87.844017n 0 89.838808n 0 89.858808n 1.8 91.813254n 1.8
+ 91.833254n 0 93.787699n 0 93.807699n 1.8 95.769909n 1.8
+ 95.789909n 0 97.752119n 0 97.772119n 1.8 99.711300n 1.8
+ 99.731300n 0 101.670481n 0 101.690481n 1.8 103.685049n 1.8
+ 103.705049n 0 105.699618n 0 105.719618n 1.8 107.666033n 1.8
+ 107.686033n 0 109.632448n 0 109.652448n 1.8 111.612278n 1.8
+ 111.632278n 0 113.592108n 0 113.612108n 1.8 115.580909n 1.8
+ 115.600909n 0 117.569710n 0 117.589710n 1.8 119.579767n 1.8
+ 119.599767n 0 121.589823n 0 121.609823n 1.8 123.575293n 1.8
+ 123.595293n 0 125.560762n 0 125.580762n 1.8 127.558338n 1.8
+ 127.578338n 0 129.555914n 0 129.575914n 1.8 131.528468n 1.8
+ 131.548468n 0 133.501021n 0 133.521021n 1.8 135.477746n 1.8
+ 135.497746n 0 137.454470n 0 137.474470n 1.8 139.465488n 1.8
+ 139.485488n 0 141.476505n 0 141.496505n 1.8 143.445124n 1.8
+ 143.465124n 0 145.413743n 0 145.433743n 1.8 147.420127n 1.8
+ 147.440127n 0 149.426511n 0 149.446511n 1.8 151.426412n 1.8
+ 151.446412n 0 153.426312n 0 153.446312n 1.8 155.424438n 1.8
+ 155.444438n 0 157.422563n 0 157.442563n 1.8 159.392080n 1.8
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
+ )


** sky130 PDK model include (tt corner) -- patched per-point by sim/harness.
** No device in this testbench uses it: it is here so the harness's own
** corner substitution and this record's environment provenance are the same
** as every other campaign's. See this file's header comment.
.lib /home/ubuntu/.volare/sky130A/libs.tech/combined/sky130.lib.spice tt
** No .tran/.print card here on purpose -- sim/harness/measure.py injects the
** analysis from this manifest's own measure block.

**** end user architecture code
**.ends
.GLOBAL GND
.end
