2AMLogic/sky130-pll/sim/jitter-calibration/netlist-snapshots/20260925-160403-ed585e4.spice

** sch_path: /home/ubuntu/GitHub/sky130-pll/.loom/worktrees/issue-197/sim/jitter-calibration/testbench/tb_jitter_calibration.sch
**.subckt tb_jitter_calibration
R1 CLK GND 1k m=1
**** begin user architecture code

** GENERATED -- variant K10b: 300 cycles, nominal period
** 3.9952 ns, injected period jitter 1.000000% RMS
** (seeded RNG, seed 185010), TR = TF = 200 ps.
VCLK CLK GND pwl(
+ 0.000000n 0 1.900000n 0 2.100000n 1.8 3.906868n 1.8
+ 4.106868n 0 5.913737n 0 6.113737n 1.8 7.930749n 1.8
+ 8.130749n 0 9.947762n 0 10.147762n 1.8 11.905327n 1.8
+ 12.105327n 0 13.862893n 0 14.062893n 1.8 15.874151n 1.8
+ 16.074151n 0 17.885409n 0 18.085409n 1.8 19.906369n 1.8
+ 20.106369n 0 21.927329n 0 22.127329n 1.8 23.908800n 1.8
+ 24.108800n 0 25.890271n 0 26.090271n 1.8 27.859216n 1.8
+ 28.059216n 0 29.828161n 0 30.028161n 1.8 31.836417n 1.8
+ 32.036417n 0 33.844672n 0 34.044672n 1.8 35.835470n 1.8
+ 36.035470n 0 37.826269n 0 38.026269n 1.8 39.831551n 1.8
+ 40.031551n 0 41.836833n 0 42.036833n 1.8 43.829109n 1.8
+ 44.029109n 0 45.821386n 0 46.021386n 1.8 47.804864n 1.8
+ 48.004864n 0 49.788342n 0 49.988342n 1.8 51.798994n 1.8
+ 51.998994n 0 53.809645n 0 54.009645n 1.8 55.802926n 1.8
+ 56.002926n 0 57.796206n 0 57.996206n 1.8 59.789520n 1.8
+ 59.989520n 0 61.782833n 0 61.982833n 1.8 63.784515n 1.8
+ 63.984515n 0 65.786196n 0 65.986196n 1.8 67.779150n 1.8
+ 67.979150n 0 69.772105n 0 69.972105n 1.8 71.777720n 1.8
+ 71.977720n 0 73.783336n 0 73.983336n 1.8 75.776033n 1.8
+ 75.976033n 0 77.768730n 0 77.968730n 1.8 79.794197n 1.8
+ 79.994197n 0 81.819664n 0 82.019664n 1.8 83.769445n 1.8
+ 83.969445n 0 85.719226n 0 85.919226n 1.8 87.734017n 1.8
+ 87.934017n 0 89.748808n 0 89.948808n 1.8 91.723254n 1.8
+ 91.923254n 0 93.697699n 0 93.897699n 1.8 95.679909n 1.8
+ 95.879909n 0 97.662119n 0 97.862119n 1.8 99.621300n 1.8
+ 99.821300n 0 101.580481n 0 101.780481n 1.8 103.595049n 1.8
+ 103.795049n 0 105.609618n 0 105.809618n 1.8 107.576033n 1.8
+ 107.776033n 0 109.542448n 0 109.742448n 1.8 111.522278n 1.8
+ 111.722278n 0 113.502108n 0 113.702108n 1.8 115.490909n 1.8
+ 115.690909n 0 117.479710n 0 117.679710n 1.8 119.489767n 1.8
+ 119.689767n 0 121.499823n 0 121.699823n 1.8 123.485293n 1.8
+ 123.685293n 0 125.470762n 0 125.670762n 1.8 127.468338n 1.8
+ 127.668338n 0 129.465914n 0 129.665914n 1.8 131.438468n 1.8
+ 131.638468n 0 133.411021n 0 133.611021n 1.8 135.387746n 1.8
+ 135.587746n 0 137.364470n 0 137.564470n 1.8 139.375488n 1.8
+ 139.575488n 0 141.386505n 0 141.586505n 1.8 143.355124n 1.8
+ 143.555124n 0 145.323743n 0 145.523743n 1.8 147.330127n 1.8
+ 147.530127n 0 149.336511n 0 149.536511n 1.8 151.336412n 1.8
+ 151.536412n 0 153.336312n 0 153.536312n 1.8 155.334438n 1.8
+ 155.534438n 0 157.332563n 0 157.532563n 1.8 159.302080n 1.8
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
+ )


** sky130 PDK model include (tt corner) -- patched per-point by sim/harness.
** No device in this testbench uses it: it is here so the harness's own
** corner substitution and this record's environment provenance are the same
** as every other campaign's. See this file's header comment.
.lib /home/ubuntu/.volare/sky130A/libs.tech/combined/sky130.lib.spice tt
** No .tran/.print card here on purpose -- sim/harness/measure.py injects the
** analysis from this manifest's own measure block.

**** end user architecture code
**.ends
.GLOBAL GND
.end
