2AMLogic/sky130-pll/sim/jitter-calibration/netlist-snapshots/20260925-160426-ed585e4.spice

** sch_path: /home/ubuntu/GitHub/sky130-pll/.loom/worktrees/issue-197/sim/jitter-calibration/testbench/tb_jitter_calibration.sch
**.subckt tb_jitter_calibration
R1 CLK GND 1k m=1
**** begin user architecture code

** GENERATED -- variant K10c: 300 cycles, nominal period
** 3.9952 ns, injected period jitter 1.000000% RMS
** (seeded RNG, seed 185010), TR = TF = 1 ns.
VCLK CLK GND pwl(
+ 0.000000n 0 1.500000n 0 2.500000n 1.8 3.506868n 1.8
+ 4.506868n 0 5.513737n 0 6.513737n 1.8 7.530749n 1.8
+ 8.530749n 0 9.547762n 0 10.547762n 1.8 11.505327n 1.8
+ 12.505327n 0 13.462893n 0 14.462893n 1.8 15.474151n 1.8
+ 16.474151n 0 17.485409n 0 18.485409n 1.8 19.506369n 1.8
+ 20.506369n 0 21.527329n 0 22.527329n 1.8 23.508800n 1.8
+ 24.508800n 0 25.490271n 0 26.490271n 1.8 27.459216n 1.8
+ 28.459216n 0 29.428161n 0 30.428161n 1.8 31.436417n 1.8
+ 32.436417n 0 33.444672n 0 34.444672n 1.8 35.435470n 1.8
+ 36.435470n 0 37.426269n 0 38.426269n 1.8 39.431551n 1.8
+ 40.431551n 0 41.436833n 0 42.436833n 1.8 43.429109n 1.8
+ 44.429109n 0 45.421386n 0 46.421386n 1.8 47.404864n 1.8
+ 48.404864n 0 49.388342n 0 50.388342n 1.8 51.398994n 1.8
+ 52.398994n 0 53.409645n 0 54.409645n 1.8 55.402926n 1.8
+ 56.402926n 0 57.396206n 0 58.396206n 1.8 59.389520n 1.8
+ 60.389520n 0 61.382833n 0 62.382833n 1.8 63.384515n 1.8
+ 64.384515n 0 65.386196n 0 66.386196n 1.8 67.379150n 1.8
+ 68.379150n 0 69.372105n 0 70.372105n 1.8 71.377720n 1.8
+ 72.377720n 0 73.383336n 0 74.383336n 1.8 75.376033n 1.8
+ 76.376033n 0 77.368730n 0 78.368730n 1.8 79.394197n 1.8
+ 80.394197n 0 81.419664n 0 82.419664n 1.8 83.369445n 1.8
+ 84.369445n 0 85.319226n 0 86.319226n 1.8 87.334017n 1.8
+ 88.334017n 0 89.348808n 0 90.348808n 1.8 91.323254n 1.8
+ 92.323254n 0 93.297699n 0 94.297699n 1.8 95.279909n 1.8
+ 96.279909n 0 97.262119n 0 98.262119n 1.8 99.221300n 1.8
+ 100.221300n 0 101.180481n 0 102.180481n 1.8 103.195049n 1.8
+ 104.195049n 0 105.209618n 0 106.209618n 1.8 107.176033n 1.8
+ 108.176033n 0 109.142448n 0 110.142448n 1.8 111.122278n 1.8
+ 112.122278n 0 113.102108n 0 114.102108n 1.8 115.090909n 1.8
+ 116.090909n 0 117.079710n 0 118.079710n 1.8 119.089767n 1.8
+ 120.089767n 0 121.099823n 0 122.099823n 1.8 123.085293n 1.8
+ 124.085293n 0 125.070762n 0 126.070762n 1.8 127.068338n 1.8
+ 128.068338n 0 129.065914n 0 130.065914n 1.8 131.038468n 1.8
+ 132.038468n 0 133.011021n 0 134.011021n 1.8 134.987746n 1.8
+ 135.987746n 0 136.964470n 0 137.964470n 1.8 138.975488n 1.8
+ 139.975488n 0 140.986505n 0 141.986505n 1.8 142.955124n 1.8
+ 143.955124n 0 144.923743n 0 145.923743n 1.8 146.930127n 1.8
+ 147.930127n 0 148.936511n 0 149.936511n 1.8 150.936412n 1.8
+ 151.936412n 0 152.936312n 0 153.936312n 1.8 154.934438n 1.8
+ 155.934438n 0 156.932563n 0 157.932563n 1.8 158.902080n 1.8
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
+ )


** sky130 PDK model include (tt corner) -- patched per-point by sim/harness.
** No device in this testbench uses it: it is here so the harness's own
** corner substitution and this record's environment provenance are the same
** as every other campaign's. See this file's header comment.
.lib /home/ubuntu/.volare/sky130A/libs.tech/combined/sky130.lib.spice tt
** No .tran/.print card here on purpose -- sim/harness/measure.py injects the
** analysis from this manifest's own measure block.

**** end user architecture code
**.ends
.GLOBAL GND
.end
