2AMLogic/sky130-pll/sim/jitter-calibration/netlist-snapshots/20260925-160453-ed585e4.spice

** sch_path: /home/ubuntu/GitHub/sky130-pll/.loom/worktrees/issue-197/sim/jitter-calibration/testbench/tb_jitter_calibration.sch
**.subckt tb_jitter_calibration
R1 CLK GND 1k m=1
**** begin user architecture code

** GENERATED -- variant K20a: 300 cycles, nominal period
** 3.9952 ns, injected period jitter 2.000000% RMS
** (seeded RNG, seed 185020), TR = TF = 20 ps.
VCLK CLK GND pwl(
+ 0.000000n 0 1.990000n 0 2.010000n 1.8 4.057179n 1.8
+ 4.077179n 0 6.124359n 0 6.144359n 1.8 8.165350n 1.8
+ 8.185350n 0 10.206341n 0 10.226341n 1.8 12.206385n 1.8
+ 12.226385n 0 14.206429n 0 14.226429n 1.8 16.167520n 1.8
+ 16.187520n 0 18.128611n 0 18.148611n 1.8 20.099344n 1.8
+ 20.119344n 0 22.070076n 0 22.090076n 1.8 24.052783n 1.8
+ 24.072783n 0 26.035490n 0 26.055490n 1.8 28.006478n 1.8
+ 28.026478n 0 29.977466n 0 29.997466n 1.8 31.988241n 1.8
+ 32.008241n 0 33.999015n 0 34.019015n 1.8 36.037521n 1.8
+ 36.057521n 0 38.076026n 0 38.096026n 1.8 40.103895n 1.8
+ 40.123895n 0 42.131764n 0 42.151764n 1.8 44.062668n 1.8
+ 44.082668n 0 45.993572n 0 46.013572n 1.8 48.020518n 1.8
+ 48.040518n 0 50.047464n 0 50.067464n 1.8 52.101597n 1.8
+ 52.121597n 0 54.155731n 0 54.175731n 1.8 56.098163n 1.8
+ 56.118163n 0 58.040594n 0 58.060594n 1.8 60.079055n 1.8
+ 60.099055n 0 62.117516n 0 62.137516n 1.8 64.026578n 1.8
+ 64.046578n 0 65.935639n 0 65.955639n 1.8 67.927960n 1.8
+ 67.947960n 0 69.920281n 0 69.940281n 1.8 71.940432n 1.8
+ 71.960432n 0 73.960583n 0 73.980583n 1.8 75.908750n 1.8
+ 75.928750n 0 77.856917n 0 77.876917n 1.8 79.905510n 1.8
+ 79.925510n 0 81.954104n 0 81.974104n 1.8 83.943750n 1.8
+ 83.963750n 0 85.933396n 0 85.953396n 1.8 87.940864n 1.8
+ 87.960864n 0 89.948331n 0 89.968331n 1.8 91.913790n 1.8
+ 91.933790n 0 93.879249n 0 93.899249n 1.8 95.898931n 1.8
+ 95.918931n 0 97.918613n 0 97.938613n 1.8 99.966440n 1.8
+ 99.986440n 0 102.014267n 0 102.034267n 1.8 103.990169n 1.8
+ 104.010169n 0 105.966071n 0 105.986071n 1.8 107.911420n 1.8
+ 107.931420n 0 109.856768n 0 109.876768n 1.8 111.765914n 1.8
+ 111.785914n 0 113.675059n 0 113.695059n 1.8 115.706963n 1.8
+ 115.726963n 0 117.738866n 0 117.758866n 1.8 119.723226n 1.8
+ 119.743226n 0 121.707585n 0 121.727585n 1.8 123.739016n 1.8
+ 123.759016n 0 125.770446n 0 125.790446n 1.8 127.771013n 1.8
+ 127.791013n 0 129.771579n 0 129.791579n 1.8 131.736335n 1.8
+ 131.756335n 0 133.701091n 0 133.721091n 1.8 135.733270n 1.8
+ 135.753270n 0 137.765450n 0 137.785450n 1.8 139.820609n 1.8
+ 139.840609n 0 141.875768n 0 141.895768n 1.8 143.908517n 1.8
+ 143.928517n 0 145.941266n 0 145.961266n 1.8 147.945679n 1.8
+ 147.965679n 0 149.950093n 0 149.970093n 1.8 151.904093n 1.8
+ 151.924093n 0 153.858093n 0 153.878093n 1.8 155.897760n 1.8
+ 155.917760n 0 157.937427n 0 157.957427n 1.8 159.927894n 1.8
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
+ )


** sky130 PDK model include (tt corner) -- patched per-point by sim/harness.
** No device in this testbench uses it: it is here so the harness's own
** corner substitution and this record's environment provenance are the same
** as every other campaign's. See this file's header comment.
.lib /home/ubuntu/.volare/sky130A/libs.tech/combined/sky130.lib.spice tt
** No .tran/.print card here on purpose -- sim/harness/measure.py injects the
** analysis from this manifest's own measure block.

**** end user architecture code
**.ends
.GLOBAL GND
.end
