2AMLogic/sky130-pll/sim/jitter-calibration/netlist-snapshots/20260925-160517-ed585e4.spice

** sch_path: /home/ubuntu/GitHub/sky130-pll/.loom/worktrees/issue-197/sim/jitter-calibration/testbench/tb_jitter_calibration.sch
**.subckt tb_jitter_calibration
R1 CLK GND 1k m=1
**** begin user architecture code

** GENERATED -- variant K20b: 300 cycles, nominal period
** 3.9952 ns, injected period jitter 2.000000% RMS
** (seeded RNG, seed 185020), TR = TF = 200 ps.
VCLK CLK GND pwl(
+ 0.000000n 0 1.900000n 0 2.100000n 1.8 3.967179n 1.8
+ 4.167179n 0 6.034359n 0 6.234359n 1.8 8.075350n 1.8
+ 8.275350n 0 10.116341n 0 10.316341n 1.8 12.116385n 1.8
+ 12.316385n 0 14.116429n 0 14.316429n 1.8 16.077520n 1.8
+ 16.277520n 0 18.038611n 0 18.238611n 1.8 20.009344n 1.8
+ 20.209344n 0 21.980076n 0 22.180076n 1.8 23.962783n 1.8
+ 24.162783n 0 25.945490n 0 26.145490n 1.8 27.916478n 1.8
+ 28.116478n 0 29.887466n 0 30.087466n 1.8 31.898241n 1.8
+ 32.098241n 0 33.909015n 0 34.109015n 1.8 35.947521n 1.8
+ 36.147521n 0 37.986026n 0 38.186026n 1.8 40.013895n 1.8
+ 40.213895n 0 42.041764n 0 42.241764n 1.8 43.972668n 1.8
+ 44.172668n 0 45.903572n 0 46.103572n 1.8 47.930518n 1.8
+ 48.130518n 0 49.957464n 0 50.157464n 1.8 52.011597n 1.8
+ 52.211597n 0 54.065731n 0 54.265731n 1.8 56.008163n 1.8
+ 56.208163n 0 57.950594n 0 58.150594n 1.8 59.989055n 1.8
+ 60.189055n 0 62.027516n 0 62.227516n 1.8 63.936578n 1.8
+ 64.136578n 0 65.845639n 0 66.045639n 1.8 67.837960n 1.8
+ 68.037960n 0 69.830281n 0 70.030281n 1.8 71.850432n 1.8
+ 72.050432n 0 73.870583n 0 74.070583n 1.8 75.818750n 1.8
+ 76.018750n 0 77.766917n 0 77.966917n 1.8 79.815510n 1.8
+ 80.015510n 0 81.864104n 0 82.064104n 1.8 83.853750n 1.8
+ 84.053750n 0 85.843396n 0 86.043396n 1.8 87.850864n 1.8
+ 88.050864n 0 89.858331n 0 90.058331n 1.8 91.823790n 1.8
+ 92.023790n 0 93.789249n 0 93.989249n 1.8 95.808931n 1.8
+ 96.008931n 0 97.828613n 0 98.028613n 1.8 99.876440n 1.8
+ 100.076440n 0 101.924267n 0 102.124267n 1.8 103.900169n 1.8
+ 104.100169n 0 105.876071n 0 106.076071n 1.8 107.821420n 1.8
+ 108.021420n 0 109.766768n 0 109.966768n 1.8 111.675914n 1.8
+ 111.875914n 0 113.585059n 0 113.785059n 1.8 115.616963n 1.8
+ 115.816963n 0 117.648866n 0 117.848866n 1.8 119.633226n 1.8
+ 119.833226n 0 121.617585n 0 121.817585n 1.8 123.649016n 1.8
+ 123.849016n 0 125.680446n 0 125.880446n 1.8 127.681013n 1.8
+ 127.881013n 0 129.681579n 0 129.881579n 1.8 131.646335n 1.8
+ 131.846335n 0 133.611091n 0 133.811091n 1.8 135.643270n 1.8
+ 135.843270n 0 137.675450n 0 137.875450n 1.8 139.730609n 1.8
+ 139.930609n 0 141.785768n 0 141.985768n 1.8 143.818517n 1.8
+ 144.018517n 0 145.851266n 0 146.051266n 1.8 147.855679n 1.8
+ 148.055679n 0 149.860093n 0 150.060093n 1.8 151.814093n 1.8
+ 152.014093n 0 153.768093n 0 153.968093n 1.8 155.807760n 1.8
+ 156.007760n 0 157.847427n 0 158.047427n 1.8 159.837894n 1.8
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
+ )


** sky130 PDK model include (tt corner) -- patched per-point by sim/harness.
** No device in this testbench uses it: it is here so the harness's own
** corner substitution and this record's environment provenance are the same
** as every other campaign's. See this file's header comment.
.lib /home/ubuntu/.volare/sky130A/libs.tech/combined/sky130.lib.spice tt
** No .tran/.print card here on purpose -- sim/harness/measure.py injects the
** analysis from this manifest's own measure block.

**** end user architecture code
**.ends
.GLOBAL GND
.end
