2AMLogic/sky130-pll/sim/jitter-calibration/netlist-snapshots/20260925-160541-ed585e4.spice

** sch_path: /home/ubuntu/GitHub/sky130-pll/.loom/worktrees/issue-197/sim/jitter-calibration/testbench/tb_jitter_calibration.sch
**.subckt tb_jitter_calibration
R1 CLK GND 1k m=1
**** begin user architecture code

** GENERATED -- variant K20c: 300 cycles, nominal period
** 3.9952 ns, injected period jitter 2.000000% RMS
** (seeded RNG, seed 185020), TR = TF = 1 ns.
VCLK CLK GND pwl(
+ 0.000000n 0 1.500000n 0 2.500000n 1.8 3.567179n 1.8
+ 4.567179n 0 5.634359n 0 6.634359n 1.8 7.675350n 1.8
+ 8.675350n 0 9.716341n 0 10.716341n 1.8 11.716385n 1.8
+ 12.716385n 0 13.716429n 0 14.716429n 1.8 15.677520n 1.8
+ 16.677520n 0 17.638611n 0 18.638611n 1.8 19.609344n 1.8
+ 20.609344n 0 21.580076n 0 22.580076n 1.8 23.562783n 1.8
+ 24.562783n 0 25.545490n 0 26.545490n 1.8 27.516478n 1.8
+ 28.516478n 0 29.487466n 0 30.487466n 1.8 31.498241n 1.8
+ 32.498241n 0 33.509015n 0 34.509015n 1.8 35.547521n 1.8
+ 36.547521n 0 37.586026n 0 38.586026n 1.8 39.613895n 1.8
+ 40.613895n 0 41.641764n 0 42.641764n 1.8 43.572668n 1.8
+ 44.572668n 0 45.503572n 0 46.503572n 1.8 47.530518n 1.8
+ 48.530518n 0 49.557464n 0 50.557464n 1.8 51.611597n 1.8
+ 52.611597n 0 53.665731n 0 54.665731n 1.8 55.608163n 1.8
+ 56.608163n 0 57.550594n 0 58.550594n 1.8 59.589055n 1.8
+ 60.589055n 0 61.627516n 0 62.627516n 1.8 63.536578n 1.8
+ 64.536578n 0 65.445639n 0 66.445639n 1.8 67.437960n 1.8
+ 68.437960n 0 69.430281n 0 70.430281n 1.8 71.450432n 1.8
+ 72.450432n 0 73.470583n 0 74.470583n 1.8 75.418750n 1.8
+ 76.418750n 0 77.366917n 0 78.366917n 1.8 79.415510n 1.8
+ 80.415510n 0 81.464104n 0 82.464104n 1.8 83.453750n 1.8
+ 84.453750n 0 85.443396n 0 86.443396n 1.8 87.450864n 1.8
+ 88.450864n 0 89.458331n 0 90.458331n 1.8 91.423790n 1.8
+ 92.423790n 0 93.389249n 0 94.389249n 1.8 95.408931n 1.8
+ 96.408931n 0 97.428613n 0 98.428613n 1.8 99.476440n 1.8
+ 100.476440n 0 101.524267n 0 102.524267n 1.8 103.500169n 1.8
+ 104.500169n 0 105.476071n 0 106.476071n 1.8 107.421420n 1.8
+ 108.421420n 0 109.366768n 0 110.366768n 1.8 111.275914n 1.8
+ 112.275914n 0 113.185059n 0 114.185059n 1.8 115.216963n 1.8
+ 116.216963n 0 117.248866n 0 118.248866n 1.8 119.233226n 1.8
+ 120.233226n 0 121.217585n 0 122.217585n 1.8 123.249016n 1.8
+ 124.249016n 0 125.280446n 0 126.280446n 1.8 127.281013n 1.8
+ 128.281013n 0 129.281579n 0 130.281579n 1.8 131.246335n 1.8
+ 132.246335n 0 133.211091n 0 134.211091n 1.8 135.243270n 1.8
+ 136.243270n 0 137.275450n 0 138.275450n 1.8 139.330609n 1.8
+ 140.330609n 0 141.385768n 0 142.385768n 1.8 143.418517n 1.8
+ 144.418517n 0 145.451266n 0 146.451266n 1.8 147.455679n 1.8
+ 148.455679n 0 149.460093n 0 150.460093n 1.8 151.414093n 1.8
+ 152.414093n 0 153.368093n 0 154.368093n 1.8 155.407760n 1.8
+ 156.407760n 0 157.447427n 0 158.447427n 1.8 159.437894n 1.8
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
+ )


** sky130 PDK model include (tt corner) -- patched per-point by sim/harness.
** No device in this testbench uses it: it is here so the harness's own
** corner substitution and this record's environment provenance are the same
** as every other campaign's. See this file's header comment.
.lib /home/ubuntu/.volare/sky130A/libs.tech/combined/sky130.lib.spice tt
** No .tran/.print card here on purpose -- sim/harness/measure.py injects the
** analysis from this manifest's own measure block.

**** end user architecture code
**.ends
.GLOBAL GND
.end
