2AMLogic/sky130-pll/sim/jitter-calibration/netlist-snapshots/20260925-103212-518b31f.spice

** sch_path: /home/ubuntu/GitHub/sky130-pll/.loom/worktrees/issue-185/sim/jitter-calibration/testbench/tb_jitter_calibration.sch
**.subckt tb_jitter_calibration
R1 CLK GND 1k m=1
**** begin user architecture code

** GENERATED -- variant J05a: 300 cycles, nominal period
** 3.9170 ns, injected period jitter 0.500000% RMS
** (seeded RNG, seed 185005), TR = TF = 20 ps.
VCLK CLK GND pwl(
+ 0.000000n 0 1.990000n 0 2.010000n 1.8 3.944478n 1.8
+ 3.964478n 0 5.898957n 0 5.918957n 1.8 7.852344n 1.8
+ 7.872344n 0 9.805732n 0 9.825732n 1.8 11.768550n 1.8
+ 11.788550n 0 13.731368n 0 13.751368n 1.8 15.699052n 1.8
+ 15.719052n 0 17.666737n 0 17.686737n 1.8 19.626936n 1.8
+ 19.646936n 0 21.587135n 0 21.607135n 1.8 23.553121n 1.8
+ 23.573121n 0 25.519106n 0 25.539106n 1.8 27.463192n 1.8
+ 27.483192n 0 29.407278n 0 29.427278n 1.8 31.364094n 1.8
+ 31.384094n 0 33.320910n 0 33.340910n 1.8 35.273749n 1.8
+ 35.293749n 0 37.226588n 0 37.246588n 1.8 39.187736n 1.8
+ 39.207736n 0 41.148884n 0 41.168884n 1.8 43.130333n 1.8
+ 43.150333n 0 45.111782n 0 45.131782n 1.8 47.060339n 1.8
+ 47.080339n 0 49.008897n 0 49.028897n 1.8 50.966950n 1.8
+ 50.986950n 0 52.925003n 0 52.945003n 1.8 54.877555n 1.8
+ 54.897555n 0 56.830107n 0 56.850107n 1.8 58.781927n 1.8
+ 58.801927n 0 60.733746n 0 60.753746n 1.8 62.689414n 1.8
+ 62.709414n 0 64.645082n 0 64.665082n 1.8 66.599396n 1.8
+ 66.619396n 0 68.553711n 0 68.573711n 1.8 70.531014n 1.8
+ 70.551014n 0 72.508316n 0 72.528316n 1.8 74.466939n 1.8
+ 74.486939n 0 76.425562n 0 76.445562n 1.8 78.382743n 1.8
+ 78.402743n 0 80.339925n 0 80.359925n 1.8 82.311876n 1.8
+ 82.331876n 0 84.283827n 0 84.303827n 1.8 86.236971n 1.8
+ 86.256971n 0 88.190115n 0 88.210115n 1.8 90.150132n 1.8
+ 90.170132n 0 92.110148n 0 92.130148n 1.8 94.058624n 1.8
+ 94.078624n 0 96.007099n 0 96.027099n 1.8 97.981250n 1.8
+ 98.001250n 0 99.955402n 0 99.975402n 1.8 101.925413n 1.8
+ 101.945413n 0 103.895425n 0 103.915425n 1.8 105.873909n 1.8
+ 105.893909n 0 107.852394n 0 107.872394n 1.8 109.807192n 1.8
+ 109.827192n 0 111.761989n 0 111.781989n 1.8 113.722520n 1.8
+ 113.742520n 0 115.683050n 0 115.703050n 1.8 117.615445n 1.8
+ 117.635445n 0 119.547839n 0 119.567839n 1.8 121.506456n 1.8
+ 121.526456n 0 123.465073n 0 123.485073n 1.8 125.424851n 1.8
+ 125.444851n 0 127.384628n 0 127.404628n 1.8 129.322233n 1.8
+ 129.342233n 0 131.259838n 0 131.279838n 1.8 133.230322n 1.8
+ 133.250322n 0 135.200806n 0 135.220806n 1.8 137.143108n 1.8
+ 137.163108n 0 139.085410n 0 139.105410n 1.8 141.031176n 1.8
+ 141.051176n 0 142.976943n 0 142.996943n 1.8 144.910930n 1.8
+ 144.930930n 0 146.844918n 0 146.864918n 1.8 148.798429n 1.8
+ 148.818429n 0 150.751940n 0 150.771940n 1.8 152.703858n 1.8
+ 152.723858n 0 154.655776n 0 154.675776n 1.8 156.618067n 1.8
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
+ )


** sky130 PDK model include (tt corner) -- patched per-point by sim/harness.
** No device in this testbench uses it: it is here so the harness's own
** corner substitution and this record's environment provenance are the same
** as every other campaign's. See this file's header comment.
.lib /home/ubuntu/.volare/sky130A/libs.tech/combined/sky130.lib.spice tt
** No .tran/.print card here on purpose -- sim/harness/measure.py injects the
** analysis from this manifest's own measure block.

**** end user architecture code
**.ends
.GLOBAL GND
.end
