2AMLogic/sky130-pll/sim/jitter-calibration/netlist-snapshots/20260925-103238-518b31f.spice

** sch_path: /home/ubuntu/GitHub/sky130-pll/.loom/worktrees/issue-185/sim/jitter-calibration/testbench/tb_jitter_calibration.sch
**.subckt tb_jitter_calibration
R1 CLK GND 1k m=1
**** begin user architecture code

** GENERATED -- variant J05b: 300 cycles, nominal period
** 3.9170 ns, injected period jitter 0.500000% RMS
** (seeded RNG, seed 185005), TR = TF = 200 ps.
VCLK CLK GND pwl(
+ 0.000000n 0 1.900000n 0 2.100000n 1.8 3.854478n 1.8
+ 4.054478n 0 5.808957n 0 6.008957n 1.8 7.762344n 1.8
+ 7.962344n 0 9.715732n 0 9.915732n 1.8 11.678550n 1.8
+ 11.878550n 0 13.641368n 0 13.841368n 1.8 15.609052n 1.8
+ 15.809052n 0 17.576737n 0 17.776737n 1.8 19.536936n 1.8
+ 19.736936n 0 21.497135n 0 21.697135n 1.8 23.463121n 1.8
+ 23.663121n 0 25.429106n 0 25.629106n 1.8 27.373192n 1.8
+ 27.573192n 0 29.317278n 0 29.517278n 1.8 31.274094n 1.8
+ 31.474094n 0 33.230910n 0 33.430910n 1.8 35.183749n 1.8
+ 35.383749n 0 37.136588n 0 37.336588n 1.8 39.097736n 1.8
+ 39.297736n 0 41.058884n 0 41.258884n 1.8 43.040333n 1.8
+ 43.240333n 0 45.021782n 0 45.221782n 1.8 46.970339n 1.8
+ 47.170339n 0 48.918897n 0 49.118897n 1.8 50.876950n 1.8
+ 51.076950n 0 52.835003n 0 53.035003n 1.8 54.787555n 1.8
+ 54.987555n 0 56.740107n 0 56.940107n 1.8 58.691927n 1.8
+ 58.891927n 0 60.643746n 0 60.843746n 1.8 62.599414n 1.8
+ 62.799414n 0 64.555082n 0 64.755082n 1.8 66.509396n 1.8
+ 66.709396n 0 68.463711n 0 68.663711n 1.8 70.441014n 1.8
+ 70.641014n 0 72.418316n 0 72.618316n 1.8 74.376939n 1.8
+ 74.576939n 0 76.335562n 0 76.535562n 1.8 78.292743n 1.8
+ 78.492743n 0 80.249925n 0 80.449925n 1.8 82.221876n 1.8
+ 82.421876n 0 84.193827n 0 84.393827n 1.8 86.146971n 1.8
+ 86.346971n 0 88.100115n 0 88.300115n 1.8 90.060132n 1.8
+ 90.260132n 0 92.020148n 0 92.220148n 1.8 93.968624n 1.8
+ 94.168624n 0 95.917099n 0 96.117099n 1.8 97.891250n 1.8
+ 98.091250n 0 99.865402n 0 100.065402n 1.8 101.835413n 1.8
+ 102.035413n 0 103.805425n 0 104.005425n 1.8 105.783909n 1.8
+ 105.983909n 0 107.762394n 0 107.962394n 1.8 109.717192n 1.8
+ 109.917192n 0 111.671989n 0 111.871989n 1.8 113.632520n 1.8
+ 113.832520n 0 115.593050n 0 115.793050n 1.8 117.525445n 1.8
+ 117.725445n 0 119.457839n 0 119.657839n 1.8 121.416456n 1.8
+ 121.616456n 0 123.375073n 0 123.575073n 1.8 125.334851n 1.8
+ 125.534851n 0 127.294628n 0 127.494628n 1.8 129.232233n 1.8
+ 129.432233n 0 131.169838n 0 131.369838n 1.8 133.140322n 1.8
+ 133.340322n 0 135.110806n 0 135.310806n 1.8 137.053108n 1.8
+ 137.253108n 0 138.995410n 0 139.195410n 1.8 140.941176n 1.8
+ 141.141176n 0 142.886943n 0 143.086943n 1.8 144.820930n 1.8
+ 145.020930n 0 146.754918n 0 146.954918n 1.8 148.708429n 1.8
+ 148.908429n 0 150.661940n 0 150.861940n 1.8 152.613858n 1.8
+ 152.813858n 0 154.565776n 0 154.765776n 1.8 156.528067n 1.8
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
+ )


** sky130 PDK model include (tt corner) -- patched per-point by sim/harness.
** No device in this testbench uses it: it is here so the harness's own
** corner substitution and this record's environment provenance are the same
** as every other campaign's. See this file's header comment.
.lib /home/ubuntu/.volare/sky130A/libs.tech/combined/sky130.lib.spice tt
** No .tran/.print card here on purpose -- sim/harness/measure.py injects the
** analysis from this manifest's own measure block.

**** end user architecture code
**.ends
.GLOBAL GND
.end
