2AMLogic/sky130-pll/sim/jitter-calibration/netlist-snapshots/20260925-103303-518b31f.spice

** sch_path: /home/ubuntu/GitHub/sky130-pll/.loom/worktrees/issue-185/sim/jitter-calibration/testbench/tb_jitter_calibration.sch
**.subckt tb_jitter_calibration
R1 CLK GND 1k m=1
**** begin user architecture code

** GENERATED -- variant J05c: 300 cycles, nominal period
** 3.9170 ns, injected period jitter 0.500000% RMS
** (seeded RNG, seed 185005), TR = TF = 1 ns.
VCLK CLK GND pwl(
+ 0.000000n 0 1.500000n 0 2.500000n 1.8 3.454478n 1.8
+ 4.454478n 0 5.408957n 0 6.408957n 1.8 7.362344n 1.8
+ 8.362344n 0 9.315732n 0 10.315732n 1.8 11.278550n 1.8
+ 12.278550n 0 13.241368n 0 14.241368n 1.8 15.209052n 1.8
+ 16.209052n 0 17.176737n 0 18.176737n 1.8 19.136936n 1.8
+ 20.136936n 0 21.097135n 0 22.097135n 1.8 23.063121n 1.8
+ 24.063121n 0 25.029106n 0 26.029106n 1.8 26.973192n 1.8
+ 27.973192n 0 28.917278n 0 29.917278n 1.8 30.874094n 1.8
+ 31.874094n 0 32.830910n 0 33.830910n 1.8 34.783749n 1.8
+ 35.783749n 0 36.736588n 0 37.736588n 1.8 38.697736n 1.8
+ 39.697736n 0 40.658884n 0 41.658884n 1.8 42.640333n 1.8
+ 43.640333n 0 44.621782n 0 45.621782n 1.8 46.570339n 1.8
+ 47.570339n 0 48.518897n 0 49.518897n 1.8 50.476950n 1.8
+ 51.476950n 0 52.435003n 0 53.435003n 1.8 54.387555n 1.8
+ 55.387555n 0 56.340107n 0 57.340107n 1.8 58.291927n 1.8
+ 59.291927n 0 60.243746n 0 61.243746n 1.8 62.199414n 1.8
+ 63.199414n 0 64.155082n 0 65.155082n 1.8 66.109396n 1.8
+ 67.109396n 0 68.063711n 0 69.063711n 1.8 70.041014n 1.8
+ 71.041014n 0 72.018316n 0 73.018316n 1.8 73.976939n 1.8
+ 74.976939n 0 75.935562n 0 76.935562n 1.8 77.892743n 1.8
+ 78.892743n 0 79.849925n 0 80.849925n 1.8 81.821876n 1.8
+ 82.821876n 0 83.793827n 0 84.793827n 1.8 85.746971n 1.8
+ 86.746971n 0 87.700115n 0 88.700115n 1.8 89.660132n 1.8
+ 90.660132n 0 91.620148n 0 92.620148n 1.8 93.568624n 1.8
+ 94.568624n 0 95.517099n 0 96.517099n 1.8 97.491250n 1.8
+ 98.491250n 0 99.465402n 0 100.465402n 1.8 101.435413n 1.8
+ 102.435413n 0 103.405425n 0 104.405425n 1.8 105.383909n 1.8
+ 106.383909n 0 107.362394n 0 108.362394n 1.8 109.317192n 1.8
+ 110.317192n 0 111.271989n 0 112.271989n 1.8 113.232520n 1.8
+ 114.232520n 0 115.193050n 0 116.193050n 1.8 117.125445n 1.8
+ 118.125445n 0 119.057839n 0 120.057839n 1.8 121.016456n 1.8
+ 122.016456n 0 122.975073n 0 123.975073n 1.8 124.934851n 1.8
+ 125.934851n 0 126.894628n 0 127.894628n 1.8 128.832233n 1.8
+ 129.832233n 0 130.769838n 0 131.769838n 1.8 132.740322n 1.8
+ 133.740322n 0 134.710806n 0 135.710806n 1.8 136.653108n 1.8
+ 137.653108n 0 138.595410n 0 139.595410n 1.8 140.541176n 1.8
+ 141.541176n 0 142.486943n 0 143.486943n 1.8 144.420930n 1.8
+ 145.420930n 0 146.354918n 0 147.354918n 1.8 148.308429n 1.8
+ 149.308429n 0 150.261940n 0 151.261940n 1.8 152.213858n 1.8
+ 153.213858n 0 154.165776n 0 155.165776n 1.8 156.128067n 1.8
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
+ )


** sky130 PDK model include (tt corner) -- patched per-point by sim/harness.
** No device in this testbench uses it: it is here so the harness's own
** corner substitution and this record's environment provenance are the same
** as every other campaign's. See this file's header comment.
.lib /home/ubuntu/.volare/sky130A/libs.tech/combined/sky130.lib.spice tt
** No .tran/.print card here on purpose -- sim/harness/measure.py injects the
** analysis from this manifest's own measure block.

**** end user architecture code
**.ends
.GLOBAL GND
.end
