2AMLogic/sky130-pll/sim/jitter-calibration/netlist-snapshots/20260925-103326-518b31f.spice

** sch_path: /home/ubuntu/GitHub/sky130-pll/.loom/worktrees/issue-185/sim/jitter-calibration/testbench/tb_jitter_calibration.sch
**.subckt tb_jitter_calibration
R1 CLK GND 1k m=1
**** begin user architecture code

** GENERATED -- variant J10a: 300 cycles, nominal period
** 3.9170 ns, injected period jitter 1.000000% RMS
** (seeded RNG, seed 185010), TR = TF = 20 ps.
VCLK CLK GND pwl(
+ 0.000000n 0 1.990000n 0 2.010000n 1.8 3.957587n 1.8
+ 3.977587n 0 5.925174n 0 5.945174n 1.8 7.902706n 1.8
+ 7.922706n 0 9.880239n 0 9.900239n 1.8 11.799488n 1.8
+ 11.819488n 0 13.718738n 0 13.738738n 1.8 15.690628n 1.8
+ 15.710628n 0 17.662519n 0 17.682519n 1.8 19.643921n 1.8
+ 19.663921n 0 21.625324n 0 21.645324n 1.8 23.568011n 1.8
+ 23.588011n 0 25.510698n 0 25.530698n 1.8 27.441104n 1.8
+ 27.461104n 0 29.371509n 0 29.391509n 1.8 31.340456n 1.8
+ 31.360456n 0 33.309404n 0 33.329404n 1.8 35.261235n 1.8
+ 35.281235n 0 37.213066n 0 37.233066n 1.8 39.179098n 1.8
+ 39.199098n 0 41.145130n 0 41.165130n 1.8 43.098410n 1.8
+ 43.118410n 0 45.051691n 0 45.071691n 1.8 46.996346n 1.8
+ 47.016346n 0 48.941000n 0 48.961000n 1.8 50.912296n 1.8
+ 50.932296n 0 52.883592n 0 52.903592n 1.8 54.837858n 1.8
+ 54.857858n 0 56.792123n 0 56.812123n 1.8 58.746420n 1.8
+ 58.766420n 0 60.700717n 0 60.720717n 1.8 62.663219n 1.8
+ 62.683219n 0 64.625720n 0 64.645720n 1.8 66.579666n 1.8
+ 66.599666n 0 68.533611n 0 68.553611n 1.8 70.499970n 1.8
+ 70.519970n 0 72.466329n 0 72.486329n 1.8 74.420021n 1.8
+ 74.440021n 0 76.373714n 0 76.393714n 1.8 78.359536n 1.8
+ 78.379536n 0 80.345357n 0 80.365357n 1.8 82.256974n 1.8
+ 82.276974n 0 84.168592n 0 84.188592n 1.8 86.143946n 1.8
+ 86.163946n 0 88.119300n 0 88.139300n 1.8 90.055099n 1.8
+ 90.075099n 0 91.990898n 0 92.010898n 1.8 93.934309n 1.8
+ 93.954309n 0 95.877720n 0 95.897720n 1.8 97.798553n 1.8
+ 97.818553n 0 99.719386n 0 99.739386n 1.8 101.694522n 1.8
+ 101.714522n 0 103.669659n 0 103.689659n 1.8 105.597584n 1.8
+ 105.617584n 0 107.525510n 0 107.545510n 1.8 109.466588n 1.8
+ 109.486588n 0 111.407665n 0 111.427665n 1.8 113.357539n 1.8
+ 113.377539n 0 115.307412n 0 115.327412n 1.8 117.278125n 1.8
+ 117.298125n 0 119.248838n 0 119.268838n 1.8 121.195444n 1.8
+ 121.215444n 0 123.142051n 0 123.162051n 1.8 125.100528n 1.8
+ 125.120528n 0 127.059005n 0 127.079005n 1.8 128.992948n 1.8
+ 129.012948n 0 130.926891n 0 130.946891n 1.8 132.864925n 1.8
+ 132.884925n 0 134.802958n 0 134.822958n 1.8 136.774613n 1.8
+ 136.794613n 0 138.746268n 0 138.766268n 1.8 140.676354n 1.8
+ 140.696354n 0 142.606440n 0 142.626440n 1.8 144.573552n 1.8
+ 144.593552n 0 146.540664n 0 146.560664n 1.8 148.501420n 1.8
+ 148.521420n 0 150.462176n 0 150.482176n 1.8 152.421191n 1.8
+ 152.441191n 0 154.380206n 0 154.400206n 1.8 156.311172n 1.8
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
+ )


** sky130 PDK model include (tt corner) -- patched per-point by sim/harness.
** No device in this testbench uses it: it is here so the harness's own
** corner substitution and this record's environment provenance are the same
** as every other campaign's. See this file's header comment.
.lib /home/ubuntu/.volare/sky130A/libs.tech/combined/sky130.lib.spice tt
** No .tran/.print card here on purpose -- sim/harness/measure.py injects the
** analysis from this manifest's own measure block.

**** end user architecture code
**.ends
.GLOBAL GND
.end
