2AMLogic/sky130-pll/sim/jitter-calibration/netlist-snapshots/20260925-103348-518b31f.spice

** sch_path: /home/ubuntu/GitHub/sky130-pll/.loom/worktrees/issue-185/sim/jitter-calibration/testbench/tb_jitter_calibration.sch
**.subckt tb_jitter_calibration
R1 CLK GND 1k m=1
**** begin user architecture code

** GENERATED -- variant J10b: 300 cycles, nominal period
** 3.9170 ns, injected period jitter 1.000000% RMS
** (seeded RNG, seed 185010), TR = TF = 200 ps.
VCLK CLK GND pwl(
+ 0.000000n 0 1.900000n 0 2.100000n 1.8 3.867587n 1.8
+ 4.067587n 0 5.835174n 0 6.035174n 1.8 7.812706n 1.8
+ 8.012706n 0 9.790239n 0 9.990239n 1.8 11.709488n 1.8
+ 11.909488n 0 13.628738n 0 13.828738n 1.8 15.600628n 1.8
+ 15.800628n 0 17.572519n 0 17.772519n 1.8 19.553921n 1.8
+ 19.753921n 0 21.535324n 0 21.735324n 1.8 23.478011n 1.8
+ 23.678011n 0 25.420698n 0 25.620698n 1.8 27.351104n 1.8
+ 27.551104n 0 29.281509n 0 29.481509n 1.8 31.250456n 1.8
+ 31.450456n 0 33.219404n 0 33.419404n 1.8 35.171235n 1.8
+ 35.371235n 0 37.123066n 0 37.323066n 1.8 39.089098n 1.8
+ 39.289098n 0 41.055130n 0 41.255130n 1.8 43.008410n 1.8
+ 43.208410n 0 44.961691n 0 45.161691n 1.8 46.906346n 1.8
+ 47.106346n 0 48.851000n 0 49.051000n 1.8 50.822296n 1.8
+ 51.022296n 0 52.793592n 0 52.993592n 1.8 54.747858n 1.8
+ 54.947858n 0 56.702123n 0 56.902123n 1.8 58.656420n 1.8
+ 58.856420n 0 60.610717n 0 60.810717n 1.8 62.573219n 1.8
+ 62.773219n 0 64.535720n 0 64.735720n 1.8 66.489666n 1.8
+ 66.689666n 0 68.443611n 0 68.643611n 1.8 70.409970n 1.8
+ 70.609970n 0 72.376329n 0 72.576329n 1.8 74.330021n 1.8
+ 74.530021n 0 76.283714n 0 76.483714n 1.8 78.269536n 1.8
+ 78.469536n 0 80.255357n 0 80.455357n 1.8 82.166974n 1.8
+ 82.366974n 0 84.078592n 0 84.278592n 1.8 86.053946n 1.8
+ 86.253946n 0 88.029300n 0 88.229300n 1.8 89.965099n 1.8
+ 90.165099n 0 91.900898n 0 92.100898n 1.8 93.844309n 1.8
+ 94.044309n 0 95.787720n 0 95.987720n 1.8 97.708553n 1.8
+ 97.908553n 0 99.629386n 0 99.829386n 1.8 101.604522n 1.8
+ 101.804522n 0 103.579659n 0 103.779659n 1.8 105.507584n 1.8
+ 105.707584n 0 107.435510n 0 107.635510n 1.8 109.376588n 1.8
+ 109.576588n 0 111.317665n 0 111.517665n 1.8 113.267539n 1.8
+ 113.467539n 0 115.217412n 0 115.417412n 1.8 117.188125n 1.8
+ 117.388125n 0 119.158838n 0 119.358838n 1.8 121.105444n 1.8
+ 121.305444n 0 123.052051n 0 123.252051n 1.8 125.010528n 1.8
+ 125.210528n 0 126.969005n 0 127.169005n 1.8 128.902948n 1.8
+ 129.102948n 0 130.836891n 0 131.036891n 1.8 132.774925n 1.8
+ 132.974925n 0 134.712958n 0 134.912958n 1.8 136.684613n 1.8
+ 136.884613n 0 138.656268n 0 138.856268n 1.8 140.586354n 1.8
+ 140.786354n 0 142.516440n 0 142.716440n 1.8 144.483552n 1.8
+ 144.683552n 0 146.450664n 0 146.650664n 1.8 148.411420n 1.8
+ 148.611420n 0 150.372176n 0 150.572176n 1.8 152.331191n 1.8
+ 152.531191n 0 154.290206n 0 154.490206n 1.8 156.221172n 1.8
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
+ )


** sky130 PDK model include (tt corner) -- patched per-point by sim/harness.
** No device in this testbench uses it: it is here so the harness's own
** corner substitution and this record's environment provenance are the same
** as every other campaign's. See this file's header comment.
.lib /home/ubuntu/.volare/sky130A/libs.tech/combined/sky130.lib.spice tt
** No .tran/.print card here on purpose -- sim/harness/measure.py injects the
** analysis from this manifest's own measure block.

**** end user architecture code
**.ends
.GLOBAL GND
.end
