2AMLogic/sky130-pll/sim/jitter-calibration/netlist-snapshots/20260925-103409-518b31f.spice

** sch_path: /home/ubuntu/GitHub/sky130-pll/.loom/worktrees/issue-185/sim/jitter-calibration/testbench/tb_jitter_calibration.sch
**.subckt tb_jitter_calibration
R1 CLK GND 1k m=1
**** begin user architecture code

** GENERATED -- variant J10c: 300 cycles, nominal period
** 3.9170 ns, injected period jitter 1.000000% RMS
** (seeded RNG, seed 185010), TR = TF = 1 ns.
VCLK CLK GND pwl(
+ 0.000000n 0 1.500000n 0 2.500000n 1.8 3.467587n 1.8
+ 4.467587n 0 5.435174n 0 6.435174n 1.8 7.412706n 1.8
+ 8.412706n 0 9.390239n 0 10.390239n 1.8 11.309488n 1.8
+ 12.309488n 0 13.228738n 0 14.228738n 1.8 15.200628n 1.8
+ 16.200628n 0 17.172519n 0 18.172519n 1.8 19.153921n 1.8
+ 20.153921n 0 21.135324n 0 22.135324n 1.8 23.078011n 1.8
+ 24.078011n 0 25.020698n 0 26.020698n 1.8 26.951104n 1.8
+ 27.951104n 0 28.881509n 0 29.881509n 1.8 30.850456n 1.8
+ 31.850456n 0 32.819404n 0 33.819404n 1.8 34.771235n 1.8
+ 35.771235n 0 36.723066n 0 37.723066n 1.8 38.689098n 1.8
+ 39.689098n 0 40.655130n 0 41.655130n 1.8 42.608410n 1.8
+ 43.608410n 0 44.561691n 0 45.561691n 1.8 46.506346n 1.8
+ 47.506346n 0 48.451000n 0 49.451000n 1.8 50.422296n 1.8
+ 51.422296n 0 52.393592n 0 53.393592n 1.8 54.347858n 1.8
+ 55.347858n 0 56.302123n 0 57.302123n 1.8 58.256420n 1.8
+ 59.256420n 0 60.210717n 0 61.210717n 1.8 62.173219n 1.8
+ 63.173219n 0 64.135720n 0 65.135720n 1.8 66.089666n 1.8
+ 67.089666n 0 68.043611n 0 69.043611n 1.8 70.009970n 1.8
+ 71.009970n 0 71.976329n 0 72.976329n 1.8 73.930021n 1.8
+ 74.930021n 0 75.883714n 0 76.883714n 1.8 77.869536n 1.8
+ 78.869536n 0 79.855357n 0 80.855357n 1.8 81.766974n 1.8
+ 82.766974n 0 83.678592n 0 84.678592n 1.8 85.653946n 1.8
+ 86.653946n 0 87.629300n 0 88.629300n 1.8 89.565099n 1.8
+ 90.565099n 0 91.500898n 0 92.500898n 1.8 93.444309n 1.8
+ 94.444309n 0 95.387720n 0 96.387720n 1.8 97.308553n 1.8
+ 98.308553n 0 99.229386n 0 100.229386n 1.8 101.204522n 1.8
+ 102.204522n 0 103.179659n 0 104.179659n 1.8 105.107584n 1.8
+ 106.107584n 0 107.035510n 0 108.035510n 1.8 108.976588n 1.8
+ 109.976588n 0 110.917665n 0 111.917665n 1.8 112.867539n 1.8
+ 113.867539n 0 114.817412n 0 115.817412n 1.8 116.788125n 1.8
+ 117.788125n 0 118.758838n 0 119.758838n 1.8 120.705444n 1.8
+ 121.705444n 0 122.652051n 0 123.652051n 1.8 124.610528n 1.8
+ 125.610528n 0 126.569005n 0 127.569005n 1.8 128.502948n 1.8
+ 129.502948n 0 130.436891n 0 131.436891n 1.8 132.374925n 1.8
+ 133.374925n 0 134.312958n 0 135.312958n 1.8 136.284613n 1.8
+ 137.284613n 0 138.256268n 0 139.256268n 1.8 140.186354n 1.8
+ 141.186354n 0 142.116440n 0 143.116440n 1.8 144.083552n 1.8
+ 145.083552n 0 146.050664n 0 147.050664n 1.8 148.011420n 1.8
+ 149.011420n 0 149.972176n 0 150.972176n 1.8 151.931191n 1.8
+ 152.931191n 0 153.890206n 0 154.890206n 1.8 155.821172n 1.8
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
+ )


** sky130 PDK model include (tt corner) -- patched per-point by sim/harness.
** No device in this testbench uses it: it is here so the harness's own
** corner substitution and this record's environment provenance are the same
** as every other campaign's. See this file's header comment.
.lib /home/ubuntu/.volare/sky130A/libs.tech/combined/sky130.lib.spice tt
** No .tran/.print card here on purpose -- sim/harness/measure.py injects the
** analysis from this manifest's own measure block.

**** end user architecture code
**.ends
.GLOBAL GND
.end
