2AMLogic/sky130-pll/sim/jitter-calibration/netlist-snapshots/20260925-103435-518b31f.spice

** sch_path: /home/ubuntu/GitHub/sky130-pll/.loom/worktrees/issue-185/sim/jitter-calibration/testbench/tb_jitter_calibration.sch
**.subckt tb_jitter_calibration
R1 CLK GND 1k m=1
**** begin user architecture code

** GENERATED -- variant J20a: 300 cycles, nominal period
** 3.9170 ns, injected period jitter 2.000000% RMS
** (seeded RNG, seed 185020), TR = TF = 20 ps.
VCLK CLK GND pwl(
+ 0.000000n 0 1.990000n 0 2.010000n 1.8 4.016718n 1.8
+ 4.036718n 0 6.043435n 0 6.063435n 1.8 8.044477n 1.8
+ 8.064477n 0 10.045519n 0 10.065519n 1.8 12.006415n 1.8
+ 12.026415n 0 13.967311n 0 13.987311n 1.8 15.890017n 1.8
+ 15.910017n 0 17.812723n 0 17.832723n 1.8 19.744881n 1.8
+ 19.764881n 0 21.677039n 0 21.697039n 1.8 23.620937n 1.8
+ 23.640937n 0 25.564835n 0 25.584835n 1.8 27.497245n 1.8
+ 27.517245n 0 29.429654n 0 29.449654n 1.8 31.401071n 1.8
+ 31.421071n 0 33.372487n 0 33.392487n 1.8 35.371092n 1.8
+ 35.391092n 0 37.369697n 0 37.389697n 1.8 39.357873n 1.8
+ 39.377873n 0 41.346050n 0 41.366050n 1.8 43.239159n 1.8
+ 43.259159n 0 45.132269n 0 45.152269n 1.8 47.119540n 1.8
+ 47.139540n 0 49.106812n 0 49.126812n 1.8 51.120739n 1.8
+ 51.140739n 0 53.134665n 0 53.154665n 1.8 55.039077n 1.8
+ 55.059077n 0 56.943489n 0 56.963489n 1.8 58.942050n 1.8
+ 58.962050n 0 60.940611n 0 60.960611n 1.8 62.812305n 1.8
+ 62.832305n 0 64.684000n 0 64.704000n 1.8 66.637324n 1.8
+ 66.657324n 0 68.590649n 0 68.610649n 1.8 70.571258n 1.8
+ 70.591258n 0 72.551868n 0 72.571868n 1.8 74.461902n 1.8
+ 74.481902n 0 76.371936n 0 76.391936n 1.8 78.380432n 1.8
+ 78.400432n 0 80.388928n 0 80.408928n 1.8 82.339630n 1.8
+ 82.359630n 0 84.290331n 0 84.310331n 1.8 86.258505n 1.8
+ 86.278505n 0 88.226680n 0 88.246680n 1.8 90.153668n 1.8
+ 90.173668n 0 92.080656n 0 92.100656n 1.8 94.060806n 1.8
+ 94.080806n 0 96.040956n 0 96.060956n 1.8 98.048699n 1.8
+ 98.068699n 0 100.056443n 0 100.076443n 1.8 101.993670n 1.8
+ 102.013670n 0 103.930896n 0 103.950896n 1.8 105.838168n 1.8
+ 105.858168n 0 107.745440n 0 107.765440n 1.8 109.617216n 1.8
+ 109.637216n 0 111.488993n 0 111.508993n 1.8 113.481125n 1.8
+ 113.501125n 0 115.473257n 0 115.493257n 1.8 117.418776n 1.8
+ 117.438776n 0 119.364294n 0 119.384294n 1.8 121.355963n 1.8
+ 121.375963n 0 123.347631n 0 123.367631n 1.8 125.309040n 1.8
+ 125.329040n 0 127.270448n 0 127.290448n 1.8 129.196747n 1.8
+ 129.216747n 0 131.123045n 0 131.143045n 1.8 133.115448n 1.8
+ 133.135448n 0 135.107851n 0 135.127851n 1.8 137.122783n 1.8
+ 137.142783n 0 139.137715n 0 139.157715n 1.8 141.130677n 1.8
+ 141.150677n 0 143.123638n 0 143.143638n 1.8 145.088818n 1.8
+ 145.108818n 0 147.053997n 0 147.073997n 1.8 148.969751n 1.8
+ 148.989751n 0 150.885504n 0 150.905504n 1.8 152.885248n 1.8
+ 152.905248n 0 154.884992n 0 154.904992n 1.8 156.836499n 1.8
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
+ )


** sky130 PDK model include (tt corner) -- patched per-point by sim/harness.
** No device in this testbench uses it: it is here so the harness's own
** corner substitution and this record's environment provenance are the same
** as every other campaign's. See this file's header comment.
.lib /home/ubuntu/.volare/sky130A/libs.tech/combined/sky130.lib.spice tt
** No .tran/.print card here on purpose -- sim/harness/measure.py injects the
** analysis from this manifest's own measure block.

**** end user architecture code
**.ends
.GLOBAL GND
.end
