2AMLogic/sky130-pll/sim/jitter-calibration/netlist-snapshots/20260925-103459-518b31f.spice

** sch_path: /home/ubuntu/GitHub/sky130-pll/.loom/worktrees/issue-185/sim/jitter-calibration/testbench/tb_jitter_calibration.sch
**.subckt tb_jitter_calibration
R1 CLK GND 1k m=1
**** begin user architecture code

** GENERATED -- variant J20b: 300 cycles, nominal period
** 3.9170 ns, injected period jitter 2.000000% RMS
** (seeded RNG, seed 185020), TR = TF = 200 ps.
VCLK CLK GND pwl(
+ 0.000000n 0 1.900000n 0 2.100000n 1.8 3.926718n 1.8
+ 4.126718n 0 5.953435n 0 6.153435n 1.8 7.954477n 1.8
+ 8.154477n 0 9.955519n 0 10.155519n 1.8 11.916415n 1.8
+ 12.116415n 0 13.877311n 0 14.077311n 1.8 15.800017n 1.8
+ 16.000017n 0 17.722723n 0 17.922723n 1.8 19.654881n 1.8
+ 19.854881n 0 21.587039n 0 21.787039n 1.8 23.530937n 1.8
+ 23.730937n 0 25.474835n 0 25.674835n 1.8 27.407245n 1.8
+ 27.607245n 0 29.339654n 0 29.539654n 1.8 31.311071n 1.8
+ 31.511071n 0 33.282487n 0 33.482487n 1.8 35.281092n 1.8
+ 35.481092n 0 37.279697n 0 37.479697n 1.8 39.267873n 1.8
+ 39.467873n 0 41.256050n 0 41.456050n 1.8 43.149159n 1.8
+ 43.349159n 0 45.042269n 0 45.242269n 1.8 47.029540n 1.8
+ 47.229540n 0 49.016812n 0 49.216812n 1.8 51.030739n 1.8
+ 51.230739n 0 53.044665n 0 53.244665n 1.8 54.949077n 1.8
+ 55.149077n 0 56.853489n 0 57.053489n 1.8 58.852050n 1.8
+ 59.052050n 0 60.850611n 0 61.050611n 1.8 62.722305n 1.8
+ 62.922305n 0 64.594000n 0 64.794000n 1.8 66.547324n 1.8
+ 66.747324n 0 68.500649n 0 68.700649n 1.8 70.481258n 1.8
+ 70.681258n 0 72.461868n 0 72.661868n 1.8 74.371902n 1.8
+ 74.571902n 0 76.281936n 0 76.481936n 1.8 78.290432n 1.8
+ 78.490432n 0 80.298928n 0 80.498928n 1.8 82.249630n 1.8
+ 82.449630n 0 84.200331n 0 84.400331n 1.8 86.168505n 1.8
+ 86.368505n 0 88.136680n 0 88.336680n 1.8 90.063668n 1.8
+ 90.263668n 0 91.990656n 0 92.190656n 1.8 93.970806n 1.8
+ 94.170806n 0 95.950956n 0 96.150956n 1.8 97.958699n 1.8
+ 98.158699n 0 99.966443n 0 100.166443n 1.8 101.903670n 1.8
+ 102.103670n 0 103.840896n 0 104.040896n 1.8 105.748168n 1.8
+ 105.948168n 0 107.655440n 0 107.855440n 1.8 109.527216n 1.8
+ 109.727216n 0 111.398993n 0 111.598993n 1.8 113.391125n 1.8
+ 113.591125n 0 115.383257n 0 115.583257n 1.8 117.328776n 1.8
+ 117.528776n 0 119.274294n 0 119.474294n 1.8 121.265963n 1.8
+ 121.465963n 0 123.257631n 0 123.457631n 1.8 125.219040n 1.8
+ 125.419040n 0 127.180448n 0 127.380448n 1.8 129.106747n 1.8
+ 129.306747n 0 131.033045n 0 131.233045n 1.8 133.025448n 1.8
+ 133.225448n 0 135.017851n 0 135.217851n 1.8 137.032783n 1.8
+ 137.232783n 0 139.047715n 0 139.247715n 1.8 141.040677n 1.8
+ 141.240677n 0 143.033638n 0 143.233638n 1.8 144.998818n 1.8
+ 145.198818n 0 146.963997n 0 147.163997n 1.8 148.879751n 1.8
+ 149.079751n 0 150.795504n 0 150.995504n 1.8 152.795248n 1.8
+ 152.995248n 0 154.794992n 0 154.994992n 1.8 156.746499n 1.8
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
+ )


** sky130 PDK model include (tt corner) -- patched per-point by sim/harness.
** No device in this testbench uses it: it is here so the harness's own
** corner substitution and this record's environment provenance are the same
** as every other campaign's. See this file's header comment.
.lib /home/ubuntu/.volare/sky130A/libs.tech/combined/sky130.lib.spice tt
** No .tran/.print card here on purpose -- sim/harness/measure.py injects the
** analysis from this manifest's own measure block.

**** end user architecture code
**.ends
.GLOBAL GND
.end
