2AMLogic/sky130-pll/sim/jitter-calibration/netlist-snapshots/20260925-103526-518b31f.spice

** sch_path: /home/ubuntu/GitHub/sky130-pll/.loom/worktrees/issue-185/sim/jitter-calibration/testbench/tb_jitter_calibration.sch
**.subckt tb_jitter_calibration
R1 CLK GND 1k m=1
**** begin user architecture code

** GENERATED -- variant J20c: 300 cycles, nominal period
** 3.9170 ns, injected period jitter 2.000000% RMS
** (seeded RNG, seed 185020), TR = TF = 1 ns.
VCLK CLK GND pwl(
+ 0.000000n 0 1.500000n 0 2.500000n 1.8 3.526718n 1.8
+ 4.526718n 0 5.553435n 0 6.553435n 1.8 7.554477n 1.8
+ 8.554477n 0 9.555519n 0 10.555519n 1.8 11.516415n 1.8
+ 12.516415n 0 13.477311n 0 14.477311n 1.8 15.400017n 1.8
+ 16.400017n 0 17.322723n 0 18.322723n 1.8 19.254881n 1.8
+ 20.254881n 0 21.187039n 0 22.187039n 1.8 23.130937n 1.8
+ 24.130937n 0 25.074835n 0 26.074835n 1.8 27.007245n 1.8
+ 28.007245n 0 28.939654n 0 29.939654n 1.8 30.911071n 1.8
+ 31.911071n 0 32.882487n 0 33.882487n 1.8 34.881092n 1.8
+ 35.881092n 0 36.879697n 0 37.879697n 1.8 38.867873n 1.8
+ 39.867873n 0 40.856050n 0 41.856050n 1.8 42.749159n 1.8
+ 43.749159n 0 44.642269n 0 45.642269n 1.8 46.629540n 1.8
+ 47.629540n 0 48.616812n 0 49.616812n 1.8 50.630739n 1.8
+ 51.630739n 0 52.644665n 0 53.644665n 1.8 54.549077n 1.8
+ 55.549077n 0 56.453489n 0 57.453489n 1.8 58.452050n 1.8
+ 59.452050n 0 60.450611n 0 61.450611n 1.8 62.322305n 1.8
+ 63.322305n 0 64.194000n 0 65.194000n 1.8 66.147324n 1.8
+ 67.147324n 0 68.100649n 0 69.100649n 1.8 70.081258n 1.8
+ 71.081258n 0 72.061868n 0 73.061868n 1.8 73.971902n 1.8
+ 74.971902n 0 75.881936n 0 76.881936n 1.8 77.890432n 1.8
+ 78.890432n 0 79.898928n 0 80.898928n 1.8 81.849630n 1.8
+ 82.849630n 0 83.800331n 0 84.800331n 1.8 85.768505n 1.8
+ 86.768505n 0 87.736680n 0 88.736680n 1.8 89.663668n 1.8
+ 90.663668n 0 91.590656n 0 92.590656n 1.8 93.570806n 1.8
+ 94.570806n 0 95.550956n 0 96.550956n 1.8 97.558699n 1.8
+ 98.558699n 0 99.566443n 0 100.566443n 1.8 101.503670n 1.8
+ 102.503670n 0 103.440896n 0 104.440896n 1.8 105.348168n 1.8
+ 106.348168n 0 107.255440n 0 108.255440n 1.8 109.127216n 1.8
+ 110.127216n 0 110.998993n 0 111.998993n 1.8 112.991125n 1.8
+ 113.991125n 0 114.983257n 0 115.983257n 1.8 116.928776n 1.8
+ 117.928776n 0 118.874294n 0 119.874294n 1.8 120.865963n 1.8
+ 121.865963n 0 122.857631n 0 123.857631n 1.8 124.819040n 1.8
+ 125.819040n 0 126.780448n 0 127.780448n 1.8 128.706747n 1.8
+ 129.706747n 0 130.633045n 0 131.633045n 1.8 132.625448n 1.8
+ 133.625448n 0 134.617851n 0 135.617851n 1.8 136.632783n 1.8
+ 137.632783n 0 138.647715n 0 139.647715n 1.8 140.640677n 1.8
+ 141.640677n 0 142.633638n 0 143.633638n 1.8 144.598818n 1.8
+ 145.598818n 0 146.563997n 0 147.563997n 1.8 148.479751n 1.8
+ 149.479751n 0 150.395504n 0 151.395504n 1.8 152.395248n 1.8
+ 153.395248n 0 154.394992n 0 155.394992n 1.8 156.346499n 1.8
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
+ )


** sky130 PDK model include (tt corner) -- patched per-point by sim/harness.
** No device in this testbench uses it: it is here so the harness's own
** corner substitution and this record's environment provenance are the same
** as every other campaign's. See this file's header comment.
.lib /home/ubuntu/.volare/sky130A/libs.tech/combined/sky130.lib.spice tt
** No .tran/.print card here on purpose -- sim/harness/measure.py injects the
** analysis from this manifest's own measure block.

**** end user architecture code
**.ends
.GLOBAL GND
.end
