2AMLogic/sky130-pll/(commit log)

2026-08-11 scaffold: sky130-pll canary — sky130 port of gf180-pll
    Minimal design-canary seed: README, CLAUDE.md (canary rules, sky130 flow,
    friction protocol), a DRAFT unratified target spec, and the committed Loom
    surfaces (0.18.13) so a clone is dispatchable without install.sh. design/,
    sim/, layout/, measurements/ start empty — the fleet fills them.
    Generated via the scaffold workflow (drafted per-block from the gf180-pll
    sibling + sky130-bandgap flow), executed by hand. The generator that turns
    this into one command is 2am#<pending epic>.
2026-08-14 spec: draft DR-001 sky130 supply-flavor scope decision record (#4)
    Adds a minimal decision-record template and drafts DR-001, which argues
    for the 1.8 V core device flavor (nfet_01v8/pfet_01v8) as the primary
    sky130 device family for the ring/PFD/charge-pump/dividers, and defers
    the medium-/high-voltage I/O-class flavor. States plainly which
    gf180-pll ported numbers (band, Kvco, power, loop filter) this
    invalidates. Stays `proposed` — ratification happens in #1.
2026-08-14 harness: stand up the sky130 PVT sim runner and the klt DRC/LVS layout flow (#9)
    * harness: stand up the xschem+ngspice PVT runner and the klt DRC/LVS flow
    Two pieces of infrastructure every later result in this repo depends on,
    seeded from the proven sibling repos rather than reinvented. Both are
    plumbing proofs against PLL-content-free DUTs: nothing here encodes a spec
    value as a pass/fail threshold, because this repo has no ratified spec yet
    (#1 / DR-001 are still open).
    sky130 open-PDK flow (seeded from 2AMLogic/sky130-bandgap):
    - docs/environment-setup.md -- volare-based PDK install pinned to one
    open_pdks build commit, with the exact xschem/ngspice/klt versions this
    sandbox veri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
    [tb_pdk_smoke.sch]
2026-08-14 spec: ratify row 0 (supply flavor) as the 1.8 V core, per DR-001
    Operator ratification of the T1-gate entry (#1). DR-001 goes proposed ->
    accepted; target-spec.md row 0 goes candidate -> RATIFIED.
    The ruling is DR-001's recommendation without modification: the ring
    oscillator, PFD, charge pump, and dividers are built on sky130's 1.8 V core
    (nfet_01v8/pfet_01v8). The medium-/high-voltage (g5v0-family / I/O-class)
    arrangement is deferred, not rejected -- revisit only if a downstream
    integration surfaces a real interface constraint, e.g. a CLK that must drive
    an off-chip rail without a level shifter.
    Porting gf180-pll's flavor was never an available option: sky130 has no
    counterpart to gf180'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
2026-08-17 design: add sky130 5-stage current-starved ring VCO core (schematic + netlist) (#29)
    Adds design/vco/vco_ring5.{sch,sym}, a current-starved CMOS inverter ring
    oscillator built on sky130's ratified 1.8 V core devices (nfet_01v8/
    pfet_01v8, DR-001), plus its generated ngspice-compatible netlist and a
    design-rationale doc (topology, stage count, sizing, informal tuning-range
    sanity check). Establishes design/'s directory convention for the sibling
    PLL block sub-issues to follow.
    [vco_ring5.sch]
2026-08-17 design: add sky130 programmable integer-N (4-64) feedback divider schematic + netlist (#30)
    Block 4 of 4 of the #14 decomposition. A 6-bit synchronous down-counter
    with a comparator-free zero-detect and synchronous reload, built entirely
    from sky130_fd_sc_hd standard cells (via the PDK's sky130_stdcells xschem
    symbol library) rather than custom transistor-level logic, since the
    block's function is purely digital and the standard-cell library already
    provides verified gates. N is set by a static 6-bit NSEL[5:0] = N-1
    configuration word (no auto-calibration FSM, per spec row 4's v1 scope) --
    exposed as plain input pins for a future integration schematic to strap,
    mirroring how the VCO block ex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
    [divider_intN.sch]
2026-08-17 measurements: add per-spec-row characterization report aggregator (#32)
    Rolls up sim/*/records/*.md and layout/*/reports/*/record.md evidence into
    one markdown/JSON report keyed by spec/target-spec.md row number, so a
    future PLL evidence record only has to cite its row (**Spec row(s)**: N) to
    appear here automatically. No existing record cites a row yet (no PLL
    schematic, no ratified numeric spec row), so v1's first generated report
    (measurements/report.md) rolls up only issue #2's harness-plumbing evidence
    (sim/pdk-smoke, layout/trivial-cell) to prove the rollup mechanism itself,
    not a PLL result -- spec rows without evidence render as "No evidence"
    rather than being dropped.
    Part of #22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
2026-08-17 sim: stand up Monte Carlo statistical-variation harness/methodology (#33)
    * sim: stand up Monte Carlo statistical-variation harness/methodology
    Adds sim/harness/montecarlo.py (trial matrix generator, analogous to
    corners.py's PVT point matrix), wires patch_netlist_mc/run_mc_trial into
    runner.py and render_mc into report.py, and adds `sim/run_corners.py <slug>
    --mc` as a sibling run mode to the existing PVT sweep.
    Sampling uses sky130's own MC_MM_SWITCH (within-die mismatch, via each
    corner's *_mm .lib section) and MC_PR_SWITCH (die-to-die process variation)
    parameters, which gate agauss()/gauss() calls already present in the shipped
    device models, seeded per trial via ngspice's `.options s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
2026-08-17 design: add sky130 PLL passive loop filter schematic + netlist (#36)
    Third-order passive RC charge-pump loop filter (R1/C1 zero, C2 pole,
    R3/C3 isolating pole), built on sky130_fd_pr res_xhigh_po and
    cap_mim_m3_1 primitives per DR-001's 1.8V core supply flavor. Component
    values are derived from a first-pass Icp/Kvco/N/f_ref design point
    (PFD/CP sub-issue #25 had not landed a value at authoring time) and
    documented in design/loop-filter/DESIGN.md, including the loop-
    bandwidth/phase-margin targets and a Vctrl-headroom/ripple analysis
    against the 1.8V rail's tighter headroom (DR-001's accepted cost).
    Standalone block deliverable, block 3 of 4 of the #14 decomposition;
    wiring into the closed l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
    [loop_filter.sch]
2026-08-17 refactor: extract shared _run_experiment helper from cmd_run/cmd_run_mc (#37)
    * refactor: extract shared _run_experiment helper from cmd_run/cmd_run_mc
    cmd_run and cmd_run_mc in sim/harness/cli.py duplicated the same control
    flow (manifest load, PDK resolve + commit-mismatch guard, subset-reason
    gate, netlist-once setup, per-unit loop with try/except, evidence-record
    write) with only the matrix builder, per-unit runner, record renderer, and
    wording differing between PVT points and Monte Carlo trials. Extract that
    shape into _run_experiment(args, ...) and reimplement both commands as
    thin callers supplying mode-specific hooks (build_units, run_unit,
    render_record) plus the differing unit nou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
2026-08-17 design: add sky130 PLL PFD + charge pump schematic + netlist (#38)
    Authors the tri-state PFD + three-state charge pump block (block 2 of 4 of
    the #14 decomposition) as design/pfd-cp/, built entirely from bare sky130
    1.8 V core devices (nfet_01v8/pfet_01v8) per DR-001: an edge-pulse-generator
    + NOR-SR-latch PFD (functionally equivalent to a D=1 flip-flop, with a
    long-L reset-path delay for dead-zone avoidance), and a single-stage
    (non-cascoded) charge pump whose topology and Icp=10 uA design point are
    documented against the 1.8 V rail's reduced headroom, per row 13's owed
    analysis.
    Closes #25
    [pfd_cp.sch]
2026-08-17 design: wire the four sky130 PLL blocks into a top-level closed-loop schematic (#43)
    Instantiates the VCO (#24), PFD + charge pump (#25), loop filter (#26), and
    divider (#27) block symbols in design/top/top.sch, wired into the standard
    charge-pump PLL loop (REF -> PFD <- divider feedback; PFD -> CP -> loop
    filter -> VCO control input; VCO output -> CLK and -> divider input), with
    a generated ngspice-compatible netlist (design/top/netlist/top.spice) and
    wiring rationale in design/top/DESIGN.md. No interface adaptation was
    needed between blocks since all four already target the same ratified 1.8 V
    core supply flavor (DR-001). Updates README.md's Status section to reflect
    that schematic entry h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
    [top.sch]
2026-08-19 feat: ship sim/pll closed-loop PLL testbench (#45)
    * feat: add sim/pll closed-loop PLL testbench, wired into the corner runner
    Ships the first PLL-specific testbench under sim/ (issue #23), mirroring
    sim/pdk-smoke's convention: sim/pll/testbench/tb_pll.sch instantiates
    design/top/top.sch's four-block closed-loop PLL (VCO + PFD/charge pump +
    loop filter + divider, #28), driven by a fixed 1.8 V supply, a 10 MHz
    reference, a power-on reset, and a fixed NSEL[5:0]=011000 (N=25) divide
    strap. sim/pll/testbench/tb.json declares its PVT grid and is auto-discovered
    by sim/run_corners.py (no code change needed there -- it globs sim/*/testbench/tb.json).
    Generalizes sim/harness/report.py's per-record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
    [tb_pll.sch]
2026-08-19 fix(divider): X-prefix all 29 standard-cell instances so ngspice parses them as subcircuits (#47)
    design/divider/divider_intN.sch named its sky130_fd_sc_hd__* standard-cell
    instances (CNT*, LDMUX*, QINV*, DECXOR*, BORAND*, ZDET, FBFF) with plain
    descriptive names that collide with SPICE's implicit element-type-by-prefix
    convention (C=capacitor, L=inductor, Q=BJT, D=diode, B=behavioral source,
    Z=MESFET, F=CCCS) instead of the X prefix SPICE requires for a subcircuit
    call. xschem's netlister doesn't enforce this convention, so it netlisted
    fine but ngspice misparsed every instance, breaking simulation of the
    divider and the closed-loop top.spice that includes it (mal formed B source
    instance /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
    [divider_intN.sch]
2026-08-19 layout: author the PLL layout (GDS/OASIS), device-level floorplan (#16) (#48)
    * layout: draw the PLL device set from the schematic netlist via klt
    Adds a headless flow that derives the layout's device set from
    design/top/netlist/top.spice and draws it: `klt gen` matched arrays per
    (flavor, W, L) group, `klt draw` plates for the MiM capacitors, the PDK's
    own library cells for the divider, and `klt gen-compose` to place each
    block and then the top cell.
    - layout/bin/pll_layout.py: netlist parse -> grouped plan -> klt calls. The
    plan half is pure and PDK-free so it can be unit-tested.
    - layout/bin/run-pll-layout-flow.sh: the driver, writing an append-only
    record under layout/pll/reports/<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
2026-08-19 layout: move klt off the PyPI pin to a git-commit pin, closing 5 of 8 friction gaps (#46) (#49)
    * layout: pin klt by git commit, picking up five upstream fixes the PyPI release predates
    layout/requirements.txt moved from klayout-tools==0.2.0 (PyPI) to an exact
    git-commit pin. PyPI has published nothing since 0.2.0, and five of the eight
    klt gaps the PLL layout had to work around are fixed only on the tool's main:
    route-vs-route collision checking, bundle (>2-pin) net routing, klt draw output
    composing as a gen-compose block, a MiM-capacitor generator, and per-block
    orientation. Each was verified behaving as claimed at the pinned commit before
    its friction entry was dropped, not taken from a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
2026-08-19 chore(layout): remove orphaned intermediate PLL layout report record (#61)
    layout/pll/reports/20260819-064347-344c3d0/ was never checked-in evidence:
    LATEST has pointed at 20260819-065329-33d74dd (and its successors) since it
    was first created in the same commit, and this superseded intermediate run
    lacks the X-prefixed subcircuit device names the shipped record has. Confirmed
    no file outside the directory references this record id.
2026-08-21 layout(pll): wire mos_array gate_contact and add klt lvs evidence (#67)
    * layout(pll): wire mos_array gate_contact and add klt lvs evidence (#18)
    Two concrete steps toward PLL netlist-vs-layout LVS closure:
    - Opt every mos_array group into `params.gate_contact` (klayout-tools#492),
    closing one of the two "this design's own" routing gaps named in
    layout/pll/README.md's friction section. The router's own spot-check goes
    from 51 to 74 of 901 two-pin legs drawn, and the "terminates on a
    bare-poly gate" failure class disappears entirely.
    - Run `klt lvs` against the routed routing-spot-check build (the only
    stream in the record with any topology to compare) and record the result
    in f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
2026-08-22 chore: resync .github/CONFIGURATION.md from upstream Loom defaults
    Applied to the working tree by `resync-installed.sh` and then left
    uncommitted. `.github/` is on the Loom-shipped allowlist and is walked by the
    resync, so it updates with the rest — but the resync's own commit step stages
    `.loom/` only, so this file stays dirty in every repo the resync touches.
    That is not cosmetic. `fleet-resync.sh` refuses to run against a repo with
    uncommitted work under `.loom/`, `.claude/`, or `.gitignore`, and a repo left
    dirty this way can trip that guard on a later run and stop receiving upstream
    fixes entirely while still reporting as a healthy fleet member. The identical
    diff was found pending i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
2026-08-23 fix(loom): restore state-only gh pr view fix in verdict-staleness-guard.sh (#79)
    A later resync (2f436d0) reverted a fix already landed once in this repo's
    history (7270355) and upstream in rjwalters/loom PR #6799: the guard was
    requesting a nonexistent `merged` field from `gh pr view --json`, causing
    every invocation to exit 1 with "Unknown JSON field: merged" instead of
    reaching a verdict. Restore the state-only --json field list plus the
    matching NOT_OPEN_WHAT derivation (both hunks move together, per the issue's
    Implementation Guidance), and pin the file in .loom/resync-ignore so a
    future resync can't silently regress it again.
    Closes #78
2026-08-24 ratification: install the two-key reviewer variant (EE key + market key) (#65)
    Phase C2 of 2AMLogic/2am#372 (autonomous spec ratification). Installs the
    Tier-1-clean EE-key skill verbatim from 2AMLogic/2am's ratification/ee-key/,
    and the generated market-key canary variant (2AMLogic/product's
    generate-canary-variant.py output, lint-clean and selftest-passed) scoped to
    this repo's block class (pll). Enables Phase C3's ratification of the
    currently-held PR through the two-key path.
    Part of 2AMLogic/2am#384 (one of six canary repos; see that issue for the
    other five).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
2026-08-24 refactor(layout): extract shared boilerplate from run-trivial-cell-flow.sh/run-pll-layout-flow.sh (#71)
    Both flow scripts independently repeated the KLT/PDK-resolvability checks,
    RECORD_ID generation, OUT_DIR setup, and LATEST-pointer write. Pull the
    shared shape into layout/bin/flow_common.sh (sourced by both), mirroring
    the analogous render_common.py extraction from PR #63.
    Closes #70
2026-08-27 spec: ratify target-spec row 1 (supply range) via DR-002 (#53)
    Row 0 (supply flavor, 1.8 V core) ratified via DR-001/#1 does not itself
    ratify any numeric row. This closes #19's operator-decision request for
    the subset of numeric rows that PVT corner verification (T1 item 5) needs:
    row 1 is ratifiable today on the merits (a mechanical consequence of the
    ratified row 0 plus the merged design's single-supply-domain topology,
    already assumed by sim/pll/testbench/tb.json since #45); rows 2/3/4/6/7/8
    are not, and DR-002 documents the specific evidentiary gap for each rather
    than force-ratifying to unblock downstream work. Files #52 to build the
    sim/harness measurement capability and PVT character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
2026-08-27 ratification: fix inaccurate market-key MANIFEST.md comp-data list (#83)
    The section listed all 4 original COMP_CLASSES entries
    (ldo, pll, sar-adc, bandgap) instead of the single comp file this repo
    actually carries in ratification/market-key/comps/ — the installer
    committed generate-canary-variant.py's raw output instead of hand-scoping
    it per canary-variant.md's install procedure.
    Not a disclosure leak (every listed filename names another public
    canary's own block class); a documentation-accuracy fix only.
    Part of 2AMLogic/2am#589
2026-08-27 spec: ratify target-spec rows 19/20 (process corners, temperature range) via DR-003 (#84)
    Row 14 quantifies its target over "all corners," but no target-spec row
    ever defined that set -- it existed only as an unratified harness
    convention (tb.json: tt/ss/ff, -40/27/125). Adds rows 19 (process corners)
    and 20 (operating temperature range), ratified via DR-003 against sky130's
    own model set: the five standard sky130.lib.spice MOS/BJT corners
    (tt/ff/ss/sf/fs, including the mixed-skew sf/fs corners the prior harness
    convention omitted -- included because they stress this design's
    un-cascoded PFD/charge-pump UP/DN current mirror), and -40..125 degC,
    corroborated by 2AMLogic/sky130-bandgap's own i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
2026-08-27 harness: widen sim/pll and sim/pdk-smoke manifests to DR-003's 5-corner set (#86)
    Both manifests declared process_corners: ["tt", "ss", "ff"], missing the
    two mixed-skew corners (sf, fs) that DR-003 (spec/target-spec.md rows
    19/20, #77) ratifies specifically because they stress this design's
    un-cascoded PFD/charge-pump UP/DN current mirror -- a condition tt/ss/ff
    alone cannot exercise. sim/harness/corners.py and sim/pdk.json's
    process_corners list already accept the widened set with no code change,
    confirmed by rebuilding both manifests' PVT matrices locally (27 -> 45
    points each).
    Closes #85
2026-09-04 refactor(layout): split render-pll-record.py's main() into compute + render helpers (#74)
    main() mixed a ~150-line compute phase (checks/device-set/routing-spot-check
    derivation) with a ~300-line render phase (markdown section emission) in one
    function body, flagged by `ruff check --select C901` at complexity 22 (> 10).
    Split into:
    - six `_check_*` helpers (coverage, supply flavor, device sets, standard-cell
    instantiation, top hierarchy, DRC) plus `_build_checks` to sequence them and
    `_load_spot_check` to load the routing spot-check evidence
    - nine `_render_*` helpers, one per `## `-headed markdown section, appending
    to a shared `lines` list via `a = lines.append` (matching render-rec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
2026-09-04 feat: add sim/harness measurement extraction + PLL lock/VCO campaigns (#57)
    * feat: add sim/harness measurement extraction + PLL lock/VCO campaigns
    Adds sim/harness/measure.py (frequency, duty-cycle, and time-to-lock
    extraction from an ngspice transient trace, with an explicit "no lock"/"no
    oscillation" outcome rather than silently reporting the last simulated
    value as if it were locked), wires it into runner.py/report.py/cli.py via
    a manifest-declared `measure` block, and uses it for two new campaigns:
    sim/pll-lock (closed-loop cold-start lock measurement, superseding
    sim/pll's 200 ns plumbing-only window for this claim) and sim/vco
    (frequency-vs-VCTRL characterization, replacing design/vc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
    [tb_pll.sch, tb_pll_lock.sch, tb_vco.sch]
2026-09-04 feat: exercise spec row 3's reference-frequency range at 1 MHz and 25 MHz band edges (#88)
    Adds two sibling closed-loop PLL lock testbenches to sim/pll-lock-1mhz/ and
    sim/pll-lock-25mhz/, each reusing sim/harness/measure.py's lock/frequency
    extraction against design/top/top.sch, driven at the DRAFT low/high band
    edges of spec row 3 (1-25 MHz reference input) instead of the single 10 MHz
    point sim/pll-lock exercises. NSEL[5:0] is re-strapped per reference
    frequency (N=64 for 1 MHz -- the divider's max representable ratio, the
    closest achievable target to the VCO's characterized tuning floor; N=10 for
    25 MHz -- landing on the same 250 MHz target sim/pll-lock already uses,
    isolating the effect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
    [tb_pll_lock_1mhz.sch, tb_pll_lock_25mhz.sch]
2026-09-04 refactor(layout): split render-record.py's main() into compute + render helpers (#90) (#91)
    main() mixed argument parsing, six-check derivation, and markdown rendering
    in one 95-statement function, flagged by `ruff check --select PLR0915` at
    95 > 50 statements.
    - `_parse_args()`
    - six `_check_*` helpers (one per verdict: DRC clean, DRC negative-control
    violations, DRC negative-control exact-rule-match, LVS good match, LVS
    negative-control x2) plus `_build_checks` to sequence them
    - nine `_render_*` helpers, one per `## `-headed markdown section (header,
    verdict, Flow, Cell, Results) plus two for the DRC-negative-control/
    LVS-good detail paragraphs within the Results sect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
2026-09-04 feat(harness): add AC loop-dynamics measurement + sim/loop-ac campaign (#94)
    sim/harness/measure.py's docstring deferred loop bandwidth and phase margin
    to "a dedicated open-loop/AC testbench" that did not exist. This adds it, so
    spec/target-spec.md rows 6 and 7 have measured evidence instead of only
    design/loop-filter/DESIGN.md's self-described hand calculation.
    - sim/harness/acmeasure.py: a new AC reduction layer -- AcSpec (the manifest's
    `ac` block), an injected `.control` builder that emits one
    `alter @<src>[acmag]` + `ac dec` + `wrdata` per swept loop-gain point, a
    wrdata reader for ngspice's freq/real/imag AC triples, phase unwrapping
    anchored below zero, log-interpolated unit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
    [tb_loop_ac.sch]
2026-09-04 evidence(sim): run sim/pll-lock's full DR-003 45-point PVT grid (#93)
    sim/vco's full 45-point grid was already completed and merged via PR #89
    (part of #52) before this branch rebased onto it -- no further vco work
    needed here.
    This commit completes the remaining half of #54's ask: sim/pll-lock's full
    DR-003-ratified grid (tt/ff/ss/sf/fs x -40/27/125 degC x 1.62/1.80/1.98 V,
    45 points), run to completion with sim/run_corners.py's bare manifest (no
    override). New record sim/pll-lock/records/20260904-163254-f00ce3e.md
    supersedes the original 3-point nominal-corner record
    (20260819-122135-fe0e6df) and its 45-point coverage subsumes PR #89's
    5-corner-at-nominal-temp/supply complementary record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
2026-09-04 design(loop-filter): re-size for the landed Icp and measured Kvco (#92) (#95)
    * design(loop-filter): re-size R1/C1/C2/R3/C3 against the landed Icp and the measured Kvco
    The filter's R/C values were solved for Icp = 5 uA (a documented placeholder,
    because design/pfd-cp had not landed a current when this block was authored)
    and Kvco = 460 MHz/V (read off design/vco/DESIGN.md's informal sanity-check
    table). Both inputs are now stale: design/pfd-cp/DESIGN.md landed
    Icp = 10 uA, and sim/vco/records/20260904-163130-f3ae976.md measures a mean
    tuning slope of 692-1751 MHz/V across its 45-point PVT grid.
    Re-derive the sizing at Icp = 10 uA and a Kvco design point of 1101 MHz/V --
    the geometric mean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
    [loop_filter.sch]
2026-09-05 docs(chipalooza): add Challenge #4 (Sky130) brief proposal draft (#96)
    Part of #81. Populates docs/chipalooza/challenge-4-proposal.md with block
    type, I/O-to-slot-budget mapping, functional description, a spec table
    re-derived from spec/target-spec.md and sim/ evidence (every row marked
    met/unmet, none relaxed), and a bench test plan.
    Does not close #81: the brief's sign-off bar (post-layout PVT simulation
    and DRC/LVS-clean GDS) is not met yet. The latest sim/pll-lock PVT-grid
    record shows only 1 of 45 points locks, and the latest full-chip layout DRC
    report shows open li1.space.1 violations — both are cited and recorded as
    misses in the document's own Sign-off status section rather than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
2026-09-05 feat(champion): standing authorization for design-evidence auto-merge (#6850)
    Operator ruling 2026-09-05: Judge-approved, green-CI PRs whose entire
    changed-file set lives in design/, sim/, layout/, measurements/,
    verification/, or docs/ auto-merge without the four-axis human hold.
    Rationale: canary design evidence is fully revertible with no fleet-infra
    blast radius, and the held-PR pattern (sky130-sar-adc#123 sat mergeable for
    days as the sole blocker of a layout chain) costs more than it protects
    here. spec/ and every tool surface fall outside the patterns, so the
    exact-subset rule keeps them on the four-axis judgment automatically.
    C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
2026-09-05 layout(pll): bump klt pin past bd5c7f4, PLL DRC now clean (#17) (#97)
    layout/requirements.txt moves from the #46 git-commit pin (66f73d0) to the
    plain PyPI release klayout-tools==0.4.0 (published 2026-09-05), a strict
    superset of both the prior pin and klayout-tools#1201's DRC fix (bd5c7f4,
    merged 2026-08-19). That fix corrects klt gen's minimum-gate-length MOS unit
    device, whose source/drain local-metal pads previously abutted the gate
    (klayout-tools#1187) and tripped li1.space.1 once per device.
    Re-ran layout/bin/run-pll-layout-flow.sh and run-trivial-cell-flow.sh at the
    new pin and checked in fresh evidence records
    (layout/pll/reports/20260905-185809-4285e0a/,
    layout/trivial-cell/reports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
2026-09-06 sim(pll-lock): refresh 45-point PVT lock evidence against post-#95 loop filter (#99)
    Re-runs the full 45-point ratified PVT grid (tt/ff/ss/sf/fs x
    -40/27/125 degC x 1.62/1.80/1.98 V) against design/top/top.sch as it
    stands after #95's loop-filter re-size (R1 21.7 kOhm -> 5.23 kOhm, C1
    53.25 pF -> 207.6 pF), which landed after the previously-committed
    record (20260904-163254-f00ce3e) was generated. That record's "1 of 45
    locks" figure described a superseded design.
    New record 20260905-193322-0f1934d supersedes 20260904-163254-f00ce3e
    per sim/README.md's append-only convention. Fresh result: 3 of 45
    points now lock (up from 1), but the comparison is not a clean fix --
    the previously-locking p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
2026-09-06 docs(top): characterize #98 cold-start lock failures as window + startup-symmetry + divider-feedback issues (#101)
    Two narrow, informal single-corner diagnostics (tt/27C and tt/125C, both
    1.80V) against the post-#95 sim/pll-lock baseline (3/45 lock, record
    20260905-193322-0f1934d) distinguish real convergence failure from
    measurement-window artifact per issue #98's acceptance criteria:
    - tt/125C/1.80V: the harness's own documented cold-start nudge
    (measure.ic) plus a widened tran_stop (30us) is enough to reach a clean
    lock at 26.32us -- inside the DRAFT <100us row-8 budget. This corner's
    baseline "no oscillation" verdict was fully explained by SPICE's
    exact-symmetry idealization (no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
2026-09-06 sim(pll-lock): widen cold-start window + add startup nudge as manifest defaults (#98) (#105)
    sim/pll-lock's baseline (20260905-193322-0f1934d.md) cannot distinguish a
    real cold-start convergence defect from a measurement artifact: its 3us
    tran_stop is 30x shorter than spec/target-spec.md row 8's DRAFT <100us
    lock-time budget, and it injects no cold-start perturbation, letting an
    odd-stage ring settle on a SPICE exact-device-symmetry fixed point no real,
    mismatched silicon would sit at. PR #101's informal diagnostics confirmed
    both effects independently (a nudge starts oscillation the unperturbed
    manifest never does; a widened window reveals a real 26.32us lock the 3us
    window could not show).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
2026-09-06 refactor(sim-harness): drop dead ResolvedPdk.xschem_rc field (#108)
    The compute-and-validate xschem_rc local var and its is_file() check
    stay (load-bearing PDK sanity check), but the value is never read
    back off a resolved ResolvedPdk instance anywhere in the harness, so
    drop it from the frozen dataclass and the constructor call.
2026-09-06 docs(divider,top): root-cause the #98 divider FBCLK dropout as a real timing-closure limit, not a loop artifact (#109)
    A standalone digital-only diagnostic -- design/divider/divider_intN's
    subcircuit driven by an ideal clock source at a fixed frequency, fully
    decoupled from the VCO/PFD/charge pump/loop filter -- reproduces the exact
    failure PR #101 first observed inside the closed loop: clean divide-by-25
    operation through at least 800 MHz input clock, and a complete,
    deterministic FBCLK dropout (zero rising edges over hundreds of cycles) at
    950 MHz and 1.07 GHz. RESETB releases once and CLK runs clean and steady
    for the whole run, ruling out a reset race, an analog-loop artifact, or a
    measu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
2026-09-06 docs(divider): root-cause FBCLK dropout as a borrow-chain setup-time failure (#110)
    Instrumented divider_intN's internal counter/borrow/zero-detect nodes with
    ad hoc ngspice transients (informal diagnostics, not a sim/ record) to
    determine why FBCLK stops toggling after one pulse when the VCO free-runs
    near ~1.07 GHz.
    Finding: a setup-time (retiming) failure of the ripple-borrow ->
    zero-detect -> reload-mux path, whose worst-case CLK-rise-to-D5-settle
    measures ~1180 ps at tt/27C/1.80V against a 1282 ps period at the measured
    765/780 MHz pass/fail breakpoint. Above the threshold a mistimed borrow
    drops the counter into a short limit cycle in the upper half of the count
    space (modulo 16 over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
2026-09-06 sim(pll-lock): start every PVT point from a discharged loop filter (#111)
    * sim(pll-lock): start every PVT point from a discharged loop filter
    sim/pll-lock's transients were not measuring a cold start. measure.py
    emits `tran` without `uic`, so every point starts from ngspice's transient
    operating point -- and for this closed loop that operating point is not a
    power-on state: the ring sits at its metastable DC equilibrium, so CLK is
    static, FBCLK never toggles, the PFD's UP/DN are static, and the charge
    pump's output settles wherever the static leakage balance puts it with only
    the DC-open filter capacitors attached.
    Measured over fifteen PVT points, the VCTRL every transient has actually
    b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
2026-09-06 docs(divider): reconcile the contradictory 800 MHz divider readings in DESIGN.md (#113)
    PR #109's "clean divide-by-25 through 800 MHz" and PR #110's "÷32 at 800 MHz"
    were both landed on main and describe the same standalone divider_intN
    measurement at tt/27°C/1.80V, but reach opposite verdicts on the same raw
    data. #109's own reported numbers (FBCLK at 25.0 MHz, period 40.0 ns) are
    40.0 ns / 1.25 ns = 32 input cycles, i.e. N = 32, not 25 -- a misread caused
    by the numerical coincidence 800 / 32 = 25.0, which happens to match the
    modulus N = 25 rather than the expected output frequency.
    Correct the 800 MHz table row's verdict, add a reconciliation note recording
    the root cause of the misre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
2026-09-06 retime(divider): flatten borrow chain to shorten CLK->D5 critical path (#107) (#115)
    Flattens BOR3/BOR4/ZERO into wide and3_2/and4_2 gates instead of a
    ripple-through-and2_2 chain, cutting the CLK->D5 combinational depth
    from 7 gates to 5 (same Boolean function, pure retiming). Measured via
    a standalone ideal-clock diagnostic across the ratified PVT grid: every
    corner's maximum correct-division frequency improves 25-45% (e.g.
    ss/125C/1.62V: 475->650 MHz; tt/27C/1.80V: 765 MHz->1.0 GHz).
    This is a real but partial fix: only the ff/-40C/1.98V corner now
    clears the VCO's ~1.09 GHz top free-running frequency, so the one-way
    FBCLK-dropout trap #104 root-caused remains reachable at ss/sf/fs/tt.
    A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
    [divider_intN.sch]
2026-09-06 refactor(sim/harness): drop dead PointResult/McTrialResult/Measurement/AcMeasurement fields (#117)
    log_path/spice_path (runner.py), edge_count (measure.py), and dc_gain_db
    (acmeasure.py) are computed and threaded onto frozen dataclasses on every
    construction but never read back anywhere -- report.py, cli.py, and
    run_corners.py never touch them, and the underlying .log/.spice files are
    still written and still committed as evidence. Mirrors the #108 removal of
    ResolvedPdk.xschem_rc in the same module tree.
    Closes #116
2026-09-06 layout(pll): restore common-centroid matching; single-row packing measured and withdrawn (issue #18) (#118)
    * layout(pll): pack matched mos_array groups in a single row (issue #18)
    `klt gen mos_array` always faces a unit's gate contact toward the array's
    own +y edge, regardless of which internal row the unit sits on, so the
    prior near-square grouping (`factor_rows_cols`) left every gate below the
    array's top row buried in the block's interior -- unreachable to
    `gen-compose`'s router no matter how much inter-group spacing this flow
    adds, since that spacing sits between groups, not inside one array's own
    rows. Forcing every matched (flavor, W, L) group onto a single row puts
    every unit's gate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
2026-09-06 docs(pll): file the matched-array-interior routing gap upstream (issue #18) (#119)
    Continues #18 (PLL netlist-vs-layout LVS closure). Per PR #118's just-merged
    2x2 measurement, the sole remaining blocker is the point-to-point router's
    inability to reach a pin buried inside a matched mos_array's own interior
    (263 of 917 legs) -- no floorplan spacing/topology/packing change closes it,
    because the gap is a klt capability ceiling, not a spacing tweak.
    Checked the klayout-tools tracker for an existing report of this exact gap
    (distinct from the already-tracked #1057/#1197 route-vs-route shorting and
    #1467 inter-net track/layer allocation -- both are between-net contention;
    this is a single gener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
2026-09-06 chore(layout): remove dead STDCELL_SITE_UM constant (#123)
    The sky130 high-density site width was defined but never read: cell
    placement uses STDCELL_ROW_UM for row-height math and the library's own
    drawn bboxes (plus STDCELL_BBOX_OVERHANG_UM) for widths, so the site
    pitch never entered any calculation. Confirmed dead by vulture at
    --min-confidence 60 and by rg across the tree.
    Trims the shared comment block above the constants so it no longer
    advertises a site width that is gone; STDCELL_LIB, STDCELL_ROW_UM, and
    STDCELL_BBOX_OVERHANG_UM are untouched.
2026-09-06 layout(pll): split near-square mos_array groups for a routing channel (issue #18) (#124)
    Splits each matched-array group where doing so cannot cost a device its
    common-centroid partner (rows > 1 and an even per-row count) into separate
    one-row `klt gen mos_array` calls, so the composer's own inter-group spacing
    falls where an opaque multi-row call previously left a zero-width row gap.
    On this design that applies to exactly the two 18-device groups in pfd_cp.
    Measured on a fresh evidence record (20260906-195205-4a08c71): 66/926 legs
    drawn vs. 62/917 on the unsplit grid, LVS mismatches 1166 -> 1164 -- a
    noise-level, not fixing, effect. The own-block-interior bucket this change
    targets actuall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
2026-09-06 test(sim): remove unused wrdata_text() helper in test_acmeasure.py (#126)
    Dead code with zero call sites, confirmed via vulture and grep. The
    sibling helper sample_response() already produces the (freqs, reals,
    imags) triple that every test consumes directly; nothing round-trips
    through wrdata_text() + acmeasure.parse_ac_wrdata().
    Closes #125
2026-09-06 divider: dual-modulus /2-/3 prescaler front-end clears the VCO's top frequency at all 45 ratified PVT points (#114) (#128)
    * feat(divider): dual-modulus /2-/3 prescaler front-end for divider_intN (#114)
    Replaces the 6-bit synchronous down-counter clocked at the full VCO rate
    with a divide-by-2/3 prescaler front-end plus a 5-bit synchronous
    down-counter back-end clocked at CLK/2 (or CLK/3), so that
    N = 2*M + S, M = floor(N/2), S = N mod 2
    Only the two prescaler flip-flops run at the VCO rate, and each sees
    exactly one gate between flip-flops (a nor2 and an and2). The back-end
    carries the deep borrow chain but now has two to three CLK periods to
    settle instead of one.
    Swallow control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
    [divider_intN.sch]
2026-09-11 Ship sim/divider standalone PVT testbench, mint N=25 evidence record (#132)
    Adds sim/divider/ (design/divider/divider_intN.sch driven open-loop by an
    ideal pulse CLK, per issue #129's method) and runs the full DR-003 45-point
    PVT grid at N=25, ~1.10 GHz -- at/above the VCO's own characterized top
    free-running frequency -- turning design/divider/DESIGN.md's informal
    "Issue #114" diagnostic table into committed sim/ evidence (45/45 PASS,
    sim/divider/records/20260910-234943-ec91425.md). Regenerates
    measurements/report.md so spec row 4 cites real evidence instead of "No
    evidence", and adds sim/README.md's divider row plus DESIGN.md's
    committed-evidence note.
    Also adds the manifests and schemati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
    [tb_divider.sch, tb_divider_n4.sch, tb_divider_n5.sch, tb_divider_n63.sch, tb_divider_n64.sch]
2026-09-11 sim/divider-n64: run and commit the tt process-corner row (9/9 PASS) (#138)
    Issue #130 asks for sim/divider-n64's full DR-003 45-point PVT grid. The
    testbench's own methodology_note estimates ~45-50 min/point (~35h total),
    well beyond one session; this issue explicitly allows landing it one
    process corner (or a handful of corners) at a time across multiple
    passes rather than mandating a single-shot run.
    This pass runs the full tt process-corner row (all 3 temperatures x all
    3 supplies, 9 points) via `python3 sim/run_corners.py divider-n64 --corners
    tt --temps -40,27,125 --supply-tol 0.1 --subset-reason ...`. All 9 points
    PASS (clean lock at every corner). Measured real cost on the shared
    di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
2026-09-11 sim/divider: mint first evidence records for -n4/-n5/-n63/-n64 siblings (#139)
    Runs the four sibling standalone-divider PVT campaigns issue #129 added but
    deferred (host compute contention), per issue #131:
    - sim/divider-n4 (N=4, even-decode-path floor): the full DR-003 45-point
    grid, 45/45 PASS.
    - sim/divider-n5 (N=5, odd-decode-path floor): the two named corners
    (tt/27C/1.80V, ss/125C default supply tolerance), 4/4 PASS across two
    records.
    - sim/divider-n63 (N=63, odd-decode-path near-ceiling): the same
    two-corner subset, 4/4 PASS across two records.
    - sim/divider-n64 (N=64, even-decode-path ceiling): the same two-corner
    subset, 4/4 PASS across two records.
    57 points across sev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
2026-09-11 sim/divider-n64: complete the ss process-corner row (issue #130, partial) (#142)
    * sim/divider-n64: run and commit the ss row's remaining -40C/27C points (6/6 PASS)
    Completes the ss process-corner row for sim/divider-n64's DR-003 45-point
    PVT grid: the 125 degC temperature was already recorded by issue #131
    (sim/divider-n64/records/20260911-104400-7d2f839.md); this record covers
    the remaining -40 degC and 27 degC temperatures x 3 supplies (6/6 PASS),
    salvaged from a run that completed cleanly before the prior session was
    interrupted.
    Part of #130
    * docs: update sim/README.md and design/divider/DESIGN.md for the divider-n64 ss-row co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
2026-09-11 sim/divider-n64: complete the full DR-003 45-point PVT grid (sf + fs rows, 45/45 PASS) (#143)
    * sim/divider-n64: run and commit the sf process-corner row (9/9 PASS)
    Fourth partial increment toward issue #130's full DR-003 45-point PVT
    grid for sim/divider-n64. Adds the whole `sf` process-corner row (3
    temperatures x 3 supplies, 9 points), all PASS with a clean lock at
    3.906 MHz (= 250 MHz / 64) and 3.1 % duty, bringing the manifest to
    36 of 45 DR-003 points (`tt`, `ff`, `ss`, `sf` rows complete).
    Run as `python3 sim/run_corners.py divider-n64 --corners sf -j 9
    --subset-reason "..."`, the same one-row-per-pass shape PRs #138/#141/
    #142 used. Notably, `--jobs 9` was a large win this time whe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
2026-09-20 sim/harness: add an `--executor {local,remote}` seam so ngspice units can run on klt's Spot fleet (#146) (#149)
    * sim/harness: add an `--executor {local,remote}` backend seam (#146)
    Every ngspice unit this repo runs has always executed on the host running
    the sweep: `runner._run_ngspice_and_judge` shells out to `ngspice -b`, and
    `cli._iter_unit_results` fans units across a local thread pool. This adds a
    seam underneath both so a unit set can run on klayout-tools' Spot fleet
    instead, without anything above the seam changing.
    New `sim/harness/executor.py` holds a small backend ABC
    (`stage`/`execute`/`provenance`) over an `NgspiceUnit` -> `NgspiceOutcome`
    pair, plus the two shipped implementa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
2026-09-23 fix: purge stale unit artifacts before the remote executor's pull (#155)
    RemoteBackend.stage() now purges each pending unit's <corner-id>-*
    artifacts before _run_fleet() dispatches and pull_artifacts() lands the
    fleet's own dumps in the same work_dir -- previously only the local
    backend's run_ngspice_locally() did this, so a resumed/retried unit run
    through --executor remote could read a stale waveform dump left over
    from a previous attempt.
    Closes #150
2026-09-23 spec: ratify row 9 (period jitter) via DR-006; rows 10 and 13 stay DRAFT (#160)
    Closes the ratification gap #151 was filed against: rows 9, 10 and 13 of
    spec/target-spec.md had no open issue or PR targeting them, blocking #20
    (Monte Carlo methodology, T1 item 6) and #22 (aggregated characterization
    report, T1 item 8) indefinitely.
    DR-006 makes all three calls explicitly, per #151's own preference for a
    partial ratification over a false one:
    - Row 9 (period jitter) is RATIFIED at <= 1.0 % of the output period, RMS,
    at CLK in lock. Only the *percentage* form of gf180-pll's row 5 is
    ported -- it is dimensionless and therefore unaffected by the 3.3 V ->
    1.8 V change DR-001 ratified, the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
2026-09-23 feat(layout): add klt erc supply spec and first structural power-delivery record (#162)
    Stands up this repo's T1 item 11 (power delivery, structural) evidence:
    a klt erc supply spec for the PLL layout, the first committed klt erc
    report run against it, and a hand-read gap-to-T1 index that carries item
    11 as an eleventh row.
    - layout/pll/erc-supply-spec.json: stackup poly(gate, active_layer=diff)
    / li1 / met1 / met2 / met3 with vias licon1 / mcon / via / via2, and
    VPWR + VGND declared kind=supply. Every layer/datatype resolved from
    sky130A's own libs.tech/klayout/tech/sky130A.lyp AND cross-checked
    against klayout-tools' curated sky130 deck layer table; each stackup
    entry and each l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
2026-09-23 layout/bin: dedupe _render_provenance into render_common (#170) (#171)
    * layout/bin: dedupe _render_provenance into render_common.render_provenance (#170)
    Both layout-record renderers carried a near-verbatim copy of the
    `## Provenance` section renderer. Move it to render_common.py as
    render_provenance(..., *, netlist_display=None); the `Schematic netlist:`
    line is emitted only when netlist_display is given (the PLL flow).
    The shared body uses render-pll-record.py's shorter PDK pin cross-check
    wording, so render-pll-record.py's output is byte-identical and
    render-record.py's output changes in that one line only.
    Add layout/tests/test_render_provenance.py, which loads both scripts by
    path a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
2026-09-23 layout: bump the klt pin to 0.6.0 and refresh every record it grades (#168)
    * layout: bump the klt pin to 0.6.0 and refresh every record it grades
    `layout/requirements.txt` pinned `klayout-tools==0.4.0`, but the committed
    `klt erc` supply record (`layout/pll/erc-reports/20260923-062347-b3abad8`,
    issue #147) was produced with a newer, unreleased build. It could not have
    been produced by the pin at all: `0.4.0`'s `klt erc` has neither the
    `stackup[0].active_layer` field `layout/pll/erc-supply-spec.json` requires
    nor the `provenance` block whose content hashes make a record re-verifiable.
    A pinned toolchain that cannot regenerate the repository's own evidence is
    not a pin.
    Bump to `klayout-to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
2026-09-23 feat(measure): extract period jitter for the ratified spec row 9 (#169)
    * feat(measure): extract period jitter for the ratified spec row 9
    `spec/target-spec.md` row 9 was ratified by DR-006 (<= 1.0 % of the output
    period, RMS, at CLK in lock) with nothing in this repo able to measure it.
    `measure.py` reduced a transient to mean frequency, duty cycle and lock time
    only.
    Adds `measure.period_jitter(rising, t_from)`: the population standard
    deviation of the consecutive periods T_k = rising[k+1] - rising[k] whose
    opening edge is at or after `t_from`, divided by that population's mean
    period, as a fraction (the percentage row 9 states is 100x it). It reuses the
    existing interpolated, hysteresis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
2026-09-23 sim: measure VCO frequency-vs-VDD supply pushing at fixed VCTRL (#175)
    * sim: add the vco-supply-pushing testbench (frequency vs. VDD at fixed VCTRL)
    Adds the manifest, schematic and cross-point derivation script for the
    VCO supply-pushing campaign DR-006 names as the first prerequisite for a
    future ratification of spec row 13, Budget 1. No evidence record yet --
    that is the next commit, minted by an actual run.
    Part of #165
    * sim: run the VCO supply-pushing PVT campaign, add its analysis unit tests
    Completes the sim/vco-supply-pushing campaign DR-006 names as the first
    prerequisite for a future row-13 Budget 1 ratification: resume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
    [tb_vco_pushing.sch]
2026-09-23 sim: add ripple_pp reducer and a sim/loop-ripple VDD/VCTRL ripple testbench (#174)
    Adds a peak-to-peak ripple reduction to the transient measurement layer
    and a new closed-loop experiment that uses it, as the harness half of
    DR-006 row 13 Budget 1's owed ripple-in-lock measurement.
    - sim/harness/measure.py: ripple_pp(times, values, t_from, t_to) returns
    (min, max, pp) over a window (None, never zero, for an empty window);
    parse_wrdata_columns reads multi-vector wrdata dumps in either
    single-scale or paired layout; an optional measure.ripple manifest
    block (nodes + final-window length) dumps the named nodes on one time
    column and reports a RippleResult per node, flagged in-lock onl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
    [tb_loop_ripple.sch]
2026-09-24 layout: pin the klayout engine, not just klayout-tools (#176)
    * layout: pin the klayout engine, not just klayout-tools (#167)
    layout/requirements.txt pinned klayout-tools exactly but left klayout, the
    KLayout Python engine klt runs on, as an unpinned transitive dependency. A
    cold layout/bin/setup-venv.sh install could resolve whatever engine build
    PyPI had current that day -- confirmed still live today: a bare
    `pip install 'klayout-tools==0.6.0'` resolves klayout==0.30.12, not the
    0.30.10 that build's own engine-mismatch warning names as tested against.
    Every record this repo committed at the 0.6.0 pin carried that warning.
    Add `klayout==0.30.10` to layout/requirements.txt alongside the ex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
2026-09-25 sim: run row 9's first Monte Carlo campaign — and let an MC trial measure at all (#20) (#181)
    * sim: let a Monte Carlo campaign measure, and add sim/pll-lock-mc (row 9)
    Issue #20's first acceptance-criteria bullet (the Monte Carlo methodology and
    harness) shipped in PR #33. Its second bullet -- at least one real MC evidence
    record against a ratified statistical spec row -- was blocked until row 9
    (period jitter) was ratified by DR-006 (#151/#160) and until measure.py gained
    the period-jitter extractor (#158/PR #169). Both have landed, so this change
    closes the remaining gap between "the extractor exists" and "a campaign runs
    through it".
    Harness: a Monte Carlo trial is now judged by exac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
    [tb_pll_lock_mc.sch]
2026-09-25 signoff: grade row 9's Monte Carlo campaign with `klt yield`, and record why item 6 still is not cited (#184)
    `signoff/tier-report.json` graded T1 item 6 (statistical/Monte Carlo evidence)
    `unmet` / `no_evidence` on two premises that had both moved: that `klt` has no
    `yield` verb, and that there is no Monte Carlo sample set to grade. Both are
    stale -- `klt yield` exists at this repo's `klayout-tools==0.6.0` pin, and
    `sim/pll-lock-mc/records/20260924-222341-a9375a5.md` is a real 5-draw
    population against ratified row 9. This bridges them, and records honestly what
    the bridge does and does not establish.
    What the verb actually accepts, checked at the pin before building on it: a
    `klt sim` Mon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
2026-09-25 sim(jitter-floor): measure the period-jitter reducer's own resolution floor (#187)
    `sim/pll-lock-mc/records/20260924-222341-a9375a5.md` records a miss against
    ratified row 9 (`DR-006`, period jitter <= 1.0 % of the output period): its
    three locked draws measured 1.584 %, 1.851 % and 3.073 % RMS. That miss was
    not attributable, because `measure.py` `linearize`s `v(CLK)` onto the
    manifest's 200 ps `tran_step` grid before dumping it and every period
    inherits a grid error from both of its ends -- against a budget of 40 ps,
    5x smaller than the grid spacing. Nothing in the repo said how large that
    floor was, so the miss could not be separated from it.
    It is now measured rather than argued, and wi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
    [tb_jitter_floor.sch]
2026-09-25 sim: make check:ci provably headless — sim/selftest.sh no longer simulates by default (#188)
    package.json's check:ci was documented (in .github/workflows/ci.yml's own
    inventory comment) as "headless, no PDK needed", but its final step,
    `bash sim/selftest.sh` with no flags, auto-detected the PDK and ran the
    full 45-point pdk-smoke grid in real ngspice whenever one was resolvable —
    which is every host a human or agent actually develops on, and conflicts
    with this fleet's rule against hand-launched local ngspice grids.
    Invert sim/selftest.sh's default: a plain invocation now only runs stage
    1's PDK-free unit tests and exits, regardless of what the host has
    installed. Simulating at all (sta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
2026-09-25 sim(pll-lock): declare a gated measure.jitter block for ratified row 9 (#189)
    sim/pll-lock runs the ratified 45-point PVT grid against the closed-loop
    PLL and already extracts the rising edges every one of its columns is
    derived from -- but it declared no `measure.jitter` block, so row 9
    (period jitter, <= 1.0 % of the output period RMS in lock, ratified via
    DR-006) was extracted at none of the 45 points. The extractor has existed
    since #158; only the manifest key was missing.
    Declare it: `max_frac` 0.01 (row 9's ratified bound), `min_cycles` 20,
    `gate_on_bound` true, and cite row 9 in `spec_rows` alongside 8 and 14.
    The column costs no extra simulation -- the transient is already run and
    `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
2026-09-25 sim(harness): reject a gated jitter bound that outruns the lock criterion (#191)
    `lock_time` only reports a lock once at least `lock.min_hold_cycles` cycles
    of in-band data follow the lock instant, and `period_jitter`'s population is
    exactly those cycles. So on a manifest declaring both blocks, a gated
    `jitter.max_frac` with `jitter.min_cycles > lock.min_hold_cycles` FAILs every
    locked point whose population lands in the gap -- for a population shortfall
    it was arithmetically incapable of avoiding. Against ratified row 9 that is
    an artefact verdict recorded as a design miss.
    `MeasureSpec.from_manifest` now refuses that shape, naming both knobs and the
    gap, alongside its existing refusals of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
2026-09-25 signoff(guards): refuse a klt yield citation its own statistics do not support (#192)
    T1 item 6 is gradeable in mechanism but not citable in substance: `klt
    signoff` grades a `klt yield` citation on the report's `status` alone, and
    `status` is `"reported"` -- graded as passing -- for any measurement that
    declares no `target_yield`, i.e. one that can never fail. It consults neither
    `sample_size.verdict` nor the missing-negative-control warning
    (klayout-tools#2467).
    That was recorded in prose (signoff/README.md 4b) and nothing enforced it.
    Measured here at the pinned klt 0.6.0, against the real committed report: the
    manifest entry
    "6": {"file": "sim/pll-lock-mc/analysis/yield-evidence/kl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
2026-09-25 sim(jitter-calibration): calibrate the period-jitter reducer against a known injected figure (#194)
    * sim(jitter-calibration): testbench for a PWL clock of known, nonzero period jitter
    sim/jitter-floor (#178) is a NULL control: its source's period is exactly
    constant, so whatever period jitter the reducer reports for it is pure
    measurement. That bounds the floor but never answers the question a reader of
    a measured jitter figure has -- if the signal really jitters by x, what does
    this pipeline report?
    This testbench injects a known, exactly specified, nonzero figure instead. Its
    DUT is one piecewise-linear voltage source and one load resistor; the rising
    edge schedule is drawn from a seede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
    [tb_jitter_calibration.sch]
2026-09-25 signoff: re-derive T1 item 6's preconditions from the repo instead of asserting them (#196)
    * signoff: re-derive T1 item 6's preconditions from the repo instead of asserting them
    `signoff/README.md` case 4b is the argument for why
    `signoff/block-manifest.json` does not cite the committed `klt yield` report
    for T1 item 6. Until now that section also carried the *facts* the argument
    rests on -- item 6's four checklist requirements plus guard 3's sizing
    condition -- as hand-maintained prose, and the prose rotted: it kept saying
    "`sim/pll-lock`'s manifest declares no `measure.jitter` block; that is issue
    #180" after #180 landed the block (PR #189). The conclusion survived, but for a
    different r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
2026-09-25 sim(vco-clk-transition): measure design/vco's real CLK transition time (#198)
    * sim(harness): add a transition-time extractor to measure.py (#186)
    sim/jitter-floor's measurement-resolution-floor family is parameterized by
    the ratio of the measured clock's transition time to the dump-grid step, but
    nothing in the harness could produce that ratio's numerator for a real
    design -- measure.py extracted frequency, duty cycle, lock time and period
    jitter, but no edge-rate figure.
    Add transition_times() (a 10-90%, or manifest-stated, rise/fall duration
    extractor alongside duty_cycle) plus a `measure.transition` manifest block
    (TransitionSpec), wired through measure_trace/_measure_clock the same wa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
    [tb_vco_transition.sch]
2026-09-25 sim(jitter-floor/pll-lock-mc): decline the calibration-informed floor, and name the run that would change it (#193) (#199)
    jitter_floor.py now reads sim/jitter-calibration's records too, but only to
    check whether a calibration variant exists at each Monte Carlo draw's own
    measured period -- not to apply its calibrated floor as a correction.
    Of the three locked draws, only trial 5's period (3.9170 ns) matches the
    calibration family's; trials 2 and 3 (3.9952 ns, 3.9904 ns) -- the two with a
    residual ambiguity left after the null-control floor -- do not, and the
    calibration campaign has never run there. Trial 5 does not need the
    calibration floor anyway: it already misses row 9's bound under t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
2026-09-25 sim(jitter-calibration): measure the null control's error sign at a near-integer period (#206)
    `sim/jitter-calibration` (#185) calibrated this harness's period-jitter reducer
    against a known injected figure at ONE nominal period, 3.9170 ns
    (frac(period/step) = 0.585). Its own analysis/calibration.md stated that at a
    period whose frac sits nearer 0 or 1 the null control's error would run the
    other way -- argued from the walk-phase formula step*sqrt(f*(1-f)), never
    measured. Nothing committed confirmed the null control UNDER-corrects there the
    way it demonstrably OVER-corrects at 0.585.
    This adds the run that measures it: a second period family, K, at 3.9952 ns
    (frac = 0.976) -- the same 3 in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
2026-09-25 signoff: fix stale layout record IDs and add drift-detection check (#207)
    * signoff: fix stale layout record IDs and add drift-detection check
    Update README.md's item-3 section to cite the current layout record
    (20260924-041509-c53e7c4) instead of the superseded one
    (20260923-084911-13ecfe9) in two places. This aligns the prose
    with the manifest's actual evidence citation.
    Add signoff/readme-manifest-consistency.py, a stdlib-only check that
    verifies README record citations match the manifest. This prevents future
    drift between the prose documentation and the evidence manifest by failing
    CI if a mismatch is introduced. The check explicitly does not flag
    historical references that are mentio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
2026-09-25 sim(pll-lock-mc/jitter-floor): apply trial 2's period-matched calibration bracket, decline further for trial 3 (#205) (#208)
    Issue #197's calibration family at 3.9952 ns (trial 2's own post-lock
    period) retired the cross-period-extrapolation ground that previously
    blocked reading it against trial 2's residual. The circularity ground
    still rules out picking a single calibrated floor for any draw -- that
    would still assume what it's trying to bound -- but a bracket over the
    family's whole measured implied-floor range does not make that circular
    selection, so jitter_floor.py now reports one for trial 2: separable
    (46.3 ps, 1.158%) at the family's smallest injected magnitude (K05a),
    and "not sep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
2026-09-26 sim: row 9's Monte Carlo misses are ngspice integrator error, not the circuit -- measure it, tighten it, re-run (#202) (#209)
    * sim: measure ngspice's integrator-error floor on the real VCO, and let a manifest tighten it (#202)
    Issue #202 asked for design work on the premise that sim/pll-lock-mc's
    1.584 / 1.851 / 3.073 % period-jitter figures are the circuit's. This tests
    that premise first.
    sim/integrator-floor runs design/vco's ring open loop at the Monte Carlo
    base point (tt/125 C/1.80 V, ~250 MHz) from an ideal control voltage and
    supply, so its true period jitter is zero by construction, through the
    identical measure.py reduction path:
    D ngspice defaults, 200 ps grid (what the MC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
    [tb_integrator_floor.sch]
2026-09-26 sim(pll-lock-mc): re-run row 9's Monte Carlo campaign at accurate integrator settings -- 5/5 draws meet it (#202) (#211)
    Supersedes 20260924-222341-a9375a5. Same five seeds, same tt/125C/1.80V
    base point, same 50 us window, same lock criterion, same ratified 1.0 %
    bound. The only change is the simulator accuracy PR #209 measured was
    missing: .options reltol=1e-4 and a 20 ps dump grid, with TMAX held at
    200 ps.
    trial lock period jitter (RMS, post-lock)
    1 24.32 us 0.554 %
    2 26.24 us 0.669 %
    3 29.72 us 0.717 %
    4 24.93 us 0.633 %
    5 24.83 us 0.600 %
    5/5 draws lock and 5/5 meet row 9. The superseded record had 3/5 lock and
    0/3 meet. The two draws i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
2026-09-26 design: test #202's named jitter suspect against committed evidence, and state row 9's realized margin (#213)
    * design: derive row 9's control-node and supply ripple budgets, and test #202's named suspect
    Issue #202 names VCO sensitivity to VCTRL ripple as "a plausible first
    suspect ... treat that as a hypothesis to test rather than a diagnosis" for
    sim/pll-lock-mc's 1.584/1.851/3.073 % period-jitter misses against ratified
    row 9's 1.0 % bound (DR-006). This tests it from the design side, using only
    committed measurements as inputs and showing the arithmetic.
    At the Monte Carlo base point (tt/125 C/1.80 V, N=25, 250 MHz):
    - Local VCO tuning slope at the lock point, from sim/vco's own 45-p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
2026-09-26 sim/harness: stage a campaign's work outside a reapable checkout (#214)
    * sim/harness: stage a campaign's work outside a reapable checkout
    A campaign's working files -- the netlisted DUT, each unit's patched
    netlist and log, its waveform dumps, and the `checkpoint.json` that
    `--resume` reads -- were written into `sim/<slug>/corners/<record-id>/`,
    inside the checkout the harness was invoked from. In a clone that is
    fine. In a linked git worktree it is a directory another process can
    remove while the campaign runs, and issue #212 records what that costs:
    a worktree was deleted beneath five live ngspice processes 4 h 26 min
    into a Monte Carlo campaign, and the checkpoint that made the finished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
2026-09-26 sim: size T1 item 6's negative control by measurement -- C2 is not the knob, C1 area/12 is (#195) (#216)
    * sim(pll-lock-mc): let yield_evidence.py carry a negative-control campaign (#195)
    `klt yield` grades T1 item 6's negative control from per-measurement
    `negative_control` metadata -- a seeded, deliberately degraded variant's own
    samples of the same measurement. `yield_evidence.py` rendered that document
    with the field absent, so both committed reports carry the tool's own
    missing-negative-control warning and there was no way to populate it without
    hand-editing a generated file.
    This adds the seam, not the control: `--negative-control <record>` reads a
    control campaign's own record and m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
    [loop_filter_c1div12.sch, loop_filter_c1div16.sch, loop_filter_c1div25.sch, loop_filter_c1div9.sch, loop_filter_c2div4.sch, loop_filter_c2div9.sch, tb_lf_c1_jitter_c1div12.sch, tb_lf_c1_jitter_c1div16.sch]
2026-09-27 measurements: regenerate the stale characterization report and guard against a repeat
    Issue #22's second acceptance-criteria bullet needed a ratified spec row
    with real evidence to exist simultaneously. Both preconditions landed on
    main (row 9 ratified via DR-006/#160; the sim/pll-lock-mc Monte Carlo
    campaign minted a real jitter record via #211), but measurements/report.md
    had not been re-run since — it still showed row 9 as "No evidence" three
    days after the evidence that answers it was committed, and was missing 34
    newer evidence records across sim/pll-lock (row-9 axis), sim/jitter-floor,
    sim/jitter-calibration, sim/integrator-floor, sim/vco-clk-transition and
    sim/lf-c1/c2-jitter-sensit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
2026-09-27 sim: audit whether ngspice's default tolerances bias four campaigns' frequency figures
    PR #209 measured that ngspice's default integrator tolerances misplace
    design/vco's ring frequency by ~2.9% and manufacture 1.543% RMS apparent
    period jitter on a DUT whose true jitter is zero -- then changed only
    sim/pll-lock-mc. Four campaigns reporting frequency-shaped figures through
    the same linearize -> wrdata -> edge_times path were left at the defaults.
    This audits each against its own bound or claim margin and changes only the
    two where it matters.
    Measured, as paired legs on one host, one ngspice build and one PDK, so the
    only difference between legs is the accuracy settings:
    - sim/vco (tt/27C/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
2026-10-01 chore: resync installed Loom surfaces
    resynced_by: fleet-resync
    invocation: fleet-resync.sh --fleet-only --push
    <!-- loom:provenance v1 build=unknown 19f4e67fd0a0afbd3d8b6606ca91ceac911377a3 clean prompts=none sweep=none story=none trace=78a5dfbdfd8c530aecd1bb436fd096df host=loom-worker-2 base=aff96f949de72adc42dcf52cbe0357dc93e16f6f run=loom-run/v1:timer:loom-worker-2/fleet-resync:67c759f7ef3c43e38d3fa8d5f19a2dd1 installs=0.19.593 658650a4f0eff932ac66a8f690eaedf8123fc83b -->
    Loom-Story: none
    Loom-Trace-Id: 78a5dfbdfd8c530aecd1bb436fd096df
    Loom-Build: unknown 19f4e67fd0a0afbd3d8b6606ca91ceac911377a3 clean
2026-10-01 chore: resync installed Loom surfaces
    <!-- loom:provenance v1 build=unknown 56435bf476452911283e43940ecfd9a30f804af9 clean prompts=none sweep=none story=none trace=342405c5ebc99bdbf17afbd983c0c41c host=loom-worker-2 base=ceac1bd17060726f406122565a7781f7a73ebddb run=loom-run/v1:timer:loom-worker-2/fleet-resync:20c09f231d424cd5b57ca7991848dd8a installs=0.19.603 8c39bf7cde8a8c03d1aaee441f397c017b6a3a9e -->
    Loom-Trace-Id: 342405c5ebc99bdbf17afbd983c0c41c
    Loom-Build: unknown 56435bf476452911283e43940ecfd9a30f804af9 clean
    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
2026-10-01 chore: resync installed Loom surfaces
    <!-- loom:provenance v1 build=unknown f2868e6b4d60d11a8ab47d25cad9e248229d2f66 clean prompts=none sweep=none story=none trace=4e2766ed5160781df891476246a9be2e host=robb-studio base=cfe438ee128827ada0e6120441e0df7f7c376385 run=loom-run/v1:timer:robb-studio/fleet-resync:2d3851d5-1673-43ae-bcc6-e5c971b37f33 installs=0.19.603 74778a6aeea5d9e06b489400942b35f33c8bb766 -->
    Loom-Trace-Id: 4e2766ed5160781df891476246a9be2e
    Loom-Build: unknown f2868e6b4d60d11a8ab47d25cad9e248229d2f66 clean
    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
2026-10-01 chore: resync installed Loom surfaces
    <!-- loom:provenance v1 build=unknown d6714830391f7596338b8de40ee2d0f45dcd12f5 clean prompts=none sweep=none story=none trace=af273f717e759e690d07f372734e9278 host=robb-pro base=08affd92b1ac1d34b364d4c4d71480cae14193bf run=loom-run/v1:timer:robb-pro/fleet-resync:92e2f9ba-d083-411b-833b-ae52d169ef04 installs=0.19.605 6eb2b65a4496b7becb84ef1f944493a541fd01cd -->
    Loom-Trace-Id: af273f717e759e690d07f372734e9278
    Loom-Build: unknown d6714830391f7596338b8de40ee2d0f45dcd12f5 clean
    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
2026-10-01 chore: resync installed Loom surfaces
    <!-- loom:provenance v1 build=unknown e956e9fee69e53f08b887ca20e14d9058d6f9aee clean prompts=none sweep=none story=none trace=1077dafeb758858c149dd37f4ece3c77 host=loom-worker-2 base=c9b04f1cb155cb48edecabb8160404b2ec1010b3 run=loom-run/v1:timer:loom-worker-2/fleet-resync:e3773167b12d4b3aafa1f76848245174 installs=0.19.609 ff30576dacc8c2734b1c7434bedd29c47122caeb -->
    Loom-Trace-Id: 1077dafeb758858c149dd37f4ece3c77
    Loom-Build: unknown e956e9fee69e53f08b887ca20e14d9058d6f9aee clean
    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
2026-10-01 chore: resync installed Loom surfaces
    <!-- loom:provenance v1 build=unknown 617257919edc1b9b9ee27532c5ec1b8a64523388 clean prompts=none sweep=none story=none trace=dbafe4f8526617aa07c890721298a080 host=robb-studio base=fe5e9ce5a37680e4c83845add9ceca7c30631139 run=loom-run/v1:timer:robb-studio/fleet-resync:1817df66-02cc-4b27-927d-a38485da550a installs=0.19.610 c94891dd526cf6db5ee02045424c6913be522048 -->
    Loom-Trace-Id: dbafe4f8526617aa07c890721298a080
    Loom-Build: unknown 617257919edc1b9b9ee27532c5ec1b8a64523388 clean
    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
2026-10-01 chore: resync installed Loom surfaces
    <!-- loom:provenance v1 build=unknown a2a39ac2736eb2686e2c65412d939e67c0438a7d clean prompts=none sweep=none story=none trace=fc1a121767151aae5bd7427c683b7db6 host=robb-pro base=329e64140fb3b463ef167de32c4654c4d9cae8ff run=loom-run/v1:timer:robb-pro/fleet-resync:708eb7c8-469d-4783-80b7-bafe142df3c4 installs=0.19.612 d25614656adcf70162da95c5e1035e99a0639a1a -->
    Loom-Trace-Id: fc1a121767151aae5bd7427c683b7db6
    Loom-Build: unknown a2a39ac2736eb2686e2c65412d939e67c0438a7d clean
    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
2026-10-01 chore(tooling): update repo-skills to v0.19.5
    Fleet-wide Repo Skills rollout (2026-10-01). compute-drift's axis 6
    reported repo-skills at 11 different versions across the fleet's
    checkouts; this brings sky130-pll from v0.10.0 to v0.19.5 (rjwalters/repo
    @ ff282cd), staging only the installer's own surface.
    Loom-Trace-Id: 038dce5d677bceeeca3c111787ac5b68
    Loom-Build: unknown unknown unknown
    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
2026-10-01 chore: resync installed Loom surfaces
    <!-- loom:provenance v1 build=unknown 126c80914e42f913c4fc778d3ddce96daa2c7a77 clean prompts=none sweep=none story=none trace=15a20fbea7a00d0922b943088c80e19d host=loom-worker-1 base=84ff6aeef9bc4b8cae3e16566452dbe0e7ced569 run=loom-run/v1:script:loom-worker-1/fleet-resync:ecc423da-4625-49de-b25a-692fd669a029 installs=0.19.612 d47e0c57a6bea6f7b61ef9ce62632d70c39ef5d5 -->
    Loom-Trace-Id: 15a20fbea7a00d0922b943088c80e19d
    Loom-Build: unknown 126c80914e42f913c4fc778d3ddce96daa2c7a77 clean
    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
2026-10-01 chore: resync installed Loom surfaces
    <!-- loom:provenance v1 build=unknown 126c80914e42f913c4fc778d3ddce96daa2c7a77 clean prompts=none sweep=none story=none trace=a0a42bd10fcfa6d7cbcc9c021c406848 host=loom-worker-2 base=e2c371d81471a538bde4b6f9e1577b7f2bb32ff2 run=loom-run/v1:timer:loom-worker-2/fleet-resync:9e174e6bb0fa41d786e4a86e45632b6f installs=0.19.612 6f0871dc66e62b36d8382ced980d2805bfd97e50 -->
    Loom-Trace-Id: a0a42bd10fcfa6d7cbcc9c021c406848
    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
2026-10-01 chore: resync installed Loom surfaces
    <!-- loom:provenance v1 build=unknown 8891f74a5d568fe3d13937ef37fd64371dd2738f clean prompts=none sweep=none story=none trace=1e216ea76cbd2b72542049c4c18c2817 host=loom-worker-1 base=18f392a792ce610d14d883c5e95b52637dc0dc0d run=loom-run/v1:timer:loom-worker-1/fleet-resync:679feba6c0f347d39eb5943ed77dc87b installs=0.19.612 62fa67f8756bdf59fdf744be053e5ef1709f1335 -->
    Loom-Trace-Id: 1e216ea76cbd2b72542049c4c18c2817
    Loom-Build: unknown 8891f74a5d568fe3d13937ef37fd64371dd2738f clean
    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
2026-10-01 chore: resync installed Loom surfaces
    <!-- loom:provenance v1 build=unknown 6f3411c8a63e68097dde01bce8a8422230f54218 clean prompts=none sweep=none story=none trace=9aa0a46bb352b9665fdaa5f5b3b85dd7 host=robb-pro base=e5b5b3716f0fa2a27ec17bf7e23760efcbe16044 run=loom-run/v1:timer:robb-pro/fleet-resync:ca419e1d-6646-4678-ac7a-b263e4b5119e installs=0.19.612 7731400b3e3e1df39074564166edf656feb0999c -->
    Loom-Trace-Id: 9aa0a46bb352b9665fdaa5f5b3b85dd7
    Loom-Build: unknown 6f3411c8a63e68097dde01bce8a8422230f54218 clean
    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
2026-10-02 chore: resync installed Loom surfaces
    <!-- loom:provenance v1 build=unknown 13c0a3ef467a888520a6529ab34486ab8be826be clean prompts=none sweep=none story=none trace=41356080f367e491d5ff03f17bb98c27 host=loom-worker-2 base=d8e22e8db503b7560dc1e6b411d40e63588299a8 run=loom-run/v1:timer:loom-worker-2/fleet-resync:44455fbcbab745abb92cea192fafbb1d installs=0.19.614 3c79f7b1d0cc14723e049cff4250ff7330804326 -->
    Loom-Trace-Id: 41356080f367e491d5ff03f17bb98c27
    Loom-Build: unknown 13c0a3ef467a888520a6529ab34486ab8be826be clean
    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
2026-10-02 chore: resync installed Loom surfaces
    <!-- loom:provenance v1 build=unknown ea2dd21f2ba310ec007d047ddfecc6cd27d220ac clean prompts=none sweep=none story=none trace=f04a67f3922788d2ccdd66578c8d18f9 host=loom-worker-1 base=a9ce37ad7fecc878d384cafceaca0a14f67e2e54 run=loom-run/v1:timer:loom-worker-1/fleet-resync:1c3b601dd998488595adc09040c007d4 installs=0.19.614 79f4897c5d3c78dbfc1b022f77d244838dbf4ccb -->
    Loom-Trace-Id: f04a67f3922788d2ccdd66578c8d18f9
    Loom-Build: unknown ea2dd21f2ba310ec007d047ddfecc6cd27d220ac clean
    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
2026-10-02 chore: resync installed Loom surfaces
    <!-- loom:provenance v1 build=unknown 6f3411c8a63e68097dde01bce8a8422230f54218 clean prompts=none sweep=none story=none trace=acb28d0049e0cc75536f96d503f6e814 host=robb-studio base=6df183a3c87c83b084044b33208dad4e402bf3b3 run=loom-run/v1:timer:robb-studio/fleet-resync:85d2b1b5-e81d-40c3-ab6a-9a00efbc4ee2 installs=0.19.616 d86523eeadb32b95777f3cd3a76dd2f72f0bf792 -->
    Loom-Trace-Id: acb28d0049e0cc75536f96d503f6e814
    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
2026-10-02 chore: resync installed Loom surfaces
    <!-- loom:provenance v1 build=unknown 2b50bd69eddd038dd738465aa58a9ebca11410ac clean prompts=none sweep=none story=none trace=324e4f607054d0396cfdf8fdc01e93ae host=robb-pro base=0b0b5a18292a78ac61de930ea2970ddb439a939e run=loom-run/v1:timer:robb-pro/fleet-resync:a63799f1-2ad7-4946-b81d-2ec231bc2d2f installs=0.19.617 81cb2ad7e091b19d6a2b95d1add6938c2100d46b -->
    Loom-Trace-Id: 324e4f607054d0396cfdf8fdc01e93ae
    Loom-Build: unknown 2b50bd69eddd038dd738465aa58a9ebca11410ac clean
    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
2026-10-02 chore: resync installed Loom surfaces
    <!-- loom:provenance v1 build=unknown 00d92b326aed50280cd90dc116b7caec27668251 clean prompts=none sweep=none story=none trace=9a5d23cc82b6d3a1c83bfee47bd04970 host=loom-worker-2 base=a41d7f3bc4a7b863afe605617aa3bdc68c5a49c3 run=loom-run/v1:timer:loom-worker-2/fleet-resync:12136a7a025d49f3a60b5edb04a3ff81 installs=0.19.619 4c0f505e4f0b76f8ccec07bda6d8b839030c077b -->
    Loom-Trace-Id: 9a5d23cc82b6d3a1c83bfee47bd04970
    Loom-Build: unknown 00d92b326aed50280cd90dc116b7caec27668251 clean
    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
2026-10-02 chore: resync installed Loom surfaces
    <!-- loom:provenance v1 build=unknown 456dad6d90259846313dc3bb80bf4e5471ef2d76 clean prompts=none sweep=none story=none trace=bb9688c03fb5211d06f48c8838a5505c host=robb-studio base=75d9255397cf3396831b80623799c8b38141b9f6 run=loom-run/v1:timer:robb-studio/fleet-resync:e965c017-8ec7-485d-b46e-aeb399b81fb4 installs=0.19.620 0d28ba49f5a88fdb37271de9cb0144eb3442c6e3 -->
    Loom-Trace-Id: bb9688c03fb5211d06f48c8838a5505c
    Loom-Build: unknown 456dad6d90259846313dc3bb80bf4e5471ef2d76 clean
    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
2026-10-02 chore: resync installed Loom surfaces
    <!-- loom:provenance v1 build=unknown 6c6d2b6565dc13eff4c6811b9c670f452106516b clean prompts=none sweep=none story=none trace=539be979ae694d66ede516a7b5d17e41 host=robb-pro base=5e1da292f07943207aae409453457877d09e6179 run=loom-run/v1:timer:robb-pro/fleet-resync:9444d216-de08-442f-8352-ba59f6e81bb3 installs=0.19.621 a90dc1d794eb9ff70aaf939ebf495abe716f3bdd -->
    Loom-Trace-Id: 539be979ae694d66ede516a7b5d17e41
    Loom-Build: unknown 6c6d2b6565dc13eff4c6811b9c670f452106516b clean
    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
2026-10-02 chore: resync installed Loom surfaces
    <!-- loom:provenance v1 build=unknown f6d28134bfe476967e005d97424073085f55e8a3 clean prompts=none sweep=none story=none trace=27eb90670d441065f593e941066ee005 host=loom-worker-2 base=a596f39aeb1a252ddb62bf002c7a7db1aff491f9 run=loom-run/v1:timer:loom-worker-2/fleet-resync:04001bba930241cf9e325bf304a9270a installs=0.19.623 ccc19c2bbe2aa65328427730fa53f70eb56128c6 -->
    Loom-Trace-Id: 27eb90670d441065f593e941066ee005
    Loom-Build: unknown f6d28134bfe476967e005d97424073085f55e8a3 clean
    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
2026-10-02 chore: resync installed Loom surfaces
    <!-- loom:provenance v1 build=unknown bc461736314499b6c2c4c0ad51fb2294f60336f5 clean prompts=none sweep=none story=none trace=c3ea68717dd3a908dbbd60a35bc8b5d6 host=robb-studio base=f6a0a0a3e5d84b98b31d9b06aba79135cbdd3f05 run=loom-run/v1:timer:robb-studio/fleet-resync:8d4c49e2-3258-4080-b0c8-082499053654 installs=0.19.623 a50aaf70069f8897c41a64b7d90783c5ab8294e0 -->
    Loom-Trace-Id: c3ea68717dd3a908dbbd60a35bc8b5d6
    Loom-Build: unknown bc461736314499b6c2c4c0ad51fb2294f60336f5 clean
    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
2026-10-02 chore: resync installed Loom surfaces
    <!-- loom:provenance v1 build=unknown bc461736314499b6c2c4c0ad51fb2294f60336f5 clean prompts=none sweep=none story=none trace=8bee8a664bfc89e0bbfbb3c2de7342ba host=loom-worker-2 base=d5bafa1a7735fbe511d5cec33a61b6823acd352a run=loom-run/v1:timer:loom-worker-2/fleet-resync:de2ceceb48ea4927a1334d08dc0082fe installs=0.19.624 5f49564fa78ae06f8c48d5224dae9ded04200bb7 -->
    Loom-Trace-Id: 8bee8a664bfc89e0bbfbb3c2de7342ba
    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
2026-10-03 chore: resync installed Loom surfaces
    <!-- loom:provenance v1 build=unknown 752d316233ed1a3da9e4f69ad760eb99bb477747 clean prompts=none sweep=none story=none trace=7851839b67c00a023e97cbdea1f580e1 host=robb-pro base=6ccf5e8d19646ad7d42eaf220ee770007294fe8a run=loom-run/v1:timer:robb-pro/fleet-resync:ae492b66-dca0-4da4-acab-8d26778f2d5c installs=0.19.624 121fac45f5006879bf58a18c951b9243d9099a18 -->
    Loom-Trace-Id: 7851839b67c00a023e97cbdea1f580e1
    Loom-Build: unknown 752d316233ed1a3da9e4f69ad760eb99bb477747 clean
    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
2026-10-03 chore: resync installed Loom surfaces
    <!-- loom:provenance v1 build=unknown b34a08286a42f47f917ec46647d4d167c1f5207c clean prompts=none sweep=none story=none trace=a8e453124b899b440f42c9d83837c7b6 host=loom-worker-2 base=bbb715389f3778b00535592decfb1fbc8f159b12 run=loom-run/v1:timer:loom-worker-2/fleet-resync:f02dd5df715347fe90fe14b9353a1b66 installs=0.19.624 98c193cf0d12d68d3770edc1baad808c40bb5fd4 -->
    Loom-Trace-Id: a8e453124b899b440f42c9d83837c7b6
    Loom-Build: unknown b34a08286a42f47f917ec46647d4d167c1f5207c clean
    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
2026-10-03 chore: resync installed Loom surfaces
    <!-- loom:provenance v1 build=unknown 3437cece5ab759f772122f8d18a6d2f05d246cde clean prompts=none sweep=none story=none trace=1bd6b75d1c0daff2b433adf5999546a3 host=loom-worker-1 base=1a8a591cdee7a48f70486abe5bd4070791be633a run=loom-run/v1:timer:loom-worker-1/fleet-resync:4c0abac1c29646eaa8502afa223bdd2b installs=0.19.624 0162badc662fb30c070e70611aa8ff74a8486d54 -->
    Loom-Trace-Id: 1bd6b75d1c0daff2b433adf5999546a3
    Loom-Build: unknown 3437cece5ab759f772122f8d18a6d2f05d246cde clean
    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
2026-10-03 chore: resync installed Loom surfaces
    <!-- loom:provenance v1 build=unknown 3437cece5ab759f772122f8d18a6d2f05d246cde clean prompts=none sweep=none story=none trace=bba21427f750636f851279cfae92b4e5 host=loom-worker-1 base=43aa7df62491e622b1101378ae4dfe7a5b3e112d run=loom-run/v1:timer:loom-worker-1/fleet-resync:9440cda9476f404caa282e360a81ee03 installs=0.19.636 e41edfbb52c13982f7d8b0577f42957427a6514c -->
    Loom-Trace-Id: bba21427f750636f851279cfae92b4e5
    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
2026-10-03 chore: resync installed Loom surfaces
    <!-- loom:provenance v1 build=unknown 28040ed11a4369e20f3b7b0154a3fb2a2c35d38c clean prompts=none sweep=none story=none trace=0cd87d01c45d97a2ee57a99363fc0db2 host=robb-studio base=3a34e84b83ad4da7cbaafff118c7b791d82afe9f run=loom-run/v1:timer:robb-studio/fleet-resync:74b93657-6b04-4ac5-bc77-e0a1682b0595 installs=0.19.636 e41edfbb52c13982f7d8b0577f42957427a6514c -->
    Loom-Trace-Id: 0cd87d01c45d97a2ee57a99363fc0db2
    Loom-Build: unknown 28040ed11a4369e20f3b7b0154a3fb2a2c35d38c clean
    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
2026-10-03 chore: resync installed Loom surfaces
    <!-- loom:provenance v1 build=unknown 388c7fe0cad997f7a887f70c9f2cfe8781a2d512 clean prompts=none sweep=none story=none trace=2046ffd42f138a06b914f34851de3440 host=loom-worker-2 base=0e1aa58a51ea26344dcb7ebc9d234877c8f5660f run=loom-run/v1:timer:loom-worker-2/fleet-resync:17c9456bb1934c70a545b12081496cce installs=0.19.647 d1fe5dead4202be12a964ab891fd5980e7836170 -->
    Loom-Trace-Id: 2046ffd42f138a06b914f34851de3440
    Loom-Build: unknown 388c7fe0cad997f7a887f70c9f2cfe8781a2d512 clean
    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
2026-10-03 chore: resync installed Loom surfaces
    <!-- loom:provenance v1 build=unknown 8078c29e691123d91cd761a786f99cfd25f1809d clean prompts=none sweep=none story=none trace=45869a6374635c036a11a6f379fe31a4 host=robb-pro base=67ff8b60f10a663e39d0f876c97119f0c4e1be86 run=loom-run/v1:timer:robb-pro/fleet-resync:b0a94991-052d-4e7d-ba2b-78b971096849 installs=0.19.647 709ca4396e074e5a4d1c5e19721f6ddac7154ca2 -->
    Loom-Trace-Id: 45869a6374635c036a11a6f379fe31a4
    Loom-Build: unknown 8078c29e691123d91cd761a786f99cfd25f1809d clean
    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
2026-10-03 chore: resync installed Loom surfaces
    <!-- loom:provenance v1 build=unknown f9cba29b0602624a23daa17ae04d31d82e10fa91 clean prompts=none sweep=none story=none trace=754b3688f97b6c34894d8cfbf272b81a host=loom-worker-1 base=798e8a6f52cdeed65ed531dfe147fa5e27e7ede8 run=loom-run/v1:script:loom-worker-1/fleet-resync:11eb117a-9ff3-4411-88d4-fdd7d6748639 installs=0.19.649 6f2f13b1c31ce420e2250ae040d8e1050c0e761b -->
    Loom-Trace-Id: 754b3688f97b6c34894d8cfbf272b81a
    Loom-Build: unknown f9cba29b0602624a23daa17ae04d31d82e10fa91 clean
    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
2026-10-03 chore: resync installed Loom surfaces
    <!-- loom:provenance v1 build=unknown f9cba29b0602624a23daa17ae04d31d82e10fa91 clean prompts=none sweep=none story=none trace=544a028e3829d4020b8aaa144e5fa628 host=robb-studio base=8b49dc70aeb7984f5da06f5b88c2ec8bd8d8a9cf run=loom-run/v1:script:robb-studio/fleet-resync:5b5b8b83-7139-447d-88bd-417dcf375aa6 installs=0.19.649 6f2f13b1c31ce420e2250ae040d8e1050c0e761b -->
    Loom-Trace-Id: 544a028e3829d4020b8aaa144e5fa628
    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
2026-10-03 chore: resync installed Loom surfaces
    <!-- loom:provenance v1 build=unknown f9cba29b0602624a23daa17ae04d31d82e10fa91 clean prompts=none sweep=none story=none trace=1057aaaf811f6dd2d64a3bb6d4b3ac49 host=robb-pro base=b16194d69d3bfabb0bbbff7fd5b04ca7240a358a run=loom-run/v1:timer:robb-pro/fleet-resync:785c1ea0-d7f2-4810-99e9-cd9368aebe0c installs=0.19.649 2118aabb5a925f1ec4669b4d3d31176a46d8f2a6 -->
    Loom-Trace-Id: 1057aaaf811f6dd2d64a3bb6d4b3ac49
    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
2026-10-03 chore: resync installed Loom surfaces
    <!-- loom:provenance v1 build=unknown 72f61d9aa0fe08f1ef59f1a97a314e474455801e clean prompts=none sweep=none story=none trace=577d2185973ec59f059fa15bf5b5e514 host=loom-worker-1 base=6c34ceb22bb7b66eed542c67df091854fa9de875 run=loom-run/v1:script:loom-worker-1/fleet-resync:5728a930-137f-4d2f-a962-1cdd7a6a1d46 installs=0.19.652 235a64727b907d65529151af0a962b14f16462a0 -->
    Loom-Trace-Id: 577d2185973ec59f059fa15bf5b5e514
    Loom-Build: unknown 72f61d9aa0fe08f1ef59f1a97a314e474455801e clean
    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
2026-10-03 chore: resync installed Loom surfaces
    <!-- loom:provenance v1 build=unknown 72f61d9aa0fe08f1ef59f1a97a314e474455801e clean prompts=none sweep=none story=none trace=845aaa0eb340f80f12095e2e8b421ed1 host=robb-pro base=fde5f63f6e172aa3c706c9abb25c5fee8778f349 run=loom-run/v1:script:robb-pro/fleet-resync:344add4b-df8a-49e8-8563-2765673acc76 installs=0.19.652 235a64727b907d65529151af0a962b14f16462a0 -->
    Loom-Trace-Id: 845aaa0eb340f80f12095e2e8b421ed1
    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
2026-10-03 chore: resync installed Loom surfaces
    <!-- loom:provenance v1 build=unknown 21130104346fe9c464ce8a3fdf82c1d3e9667639 clean prompts=none sweep=none story=none trace=36308fff5a3c323c3d1bf6fffb6cd122 host=robb-studio base=3eeb6f024d8f3e65c377b2f3b100f41d8870eb6a run=loom-run/v1:timer:robb-studio/fleet-resync:89972fbd-0774-4402-bbb7-26c33a851735 installs=0.19.652 fb69233bd8f1dfc2bdee37d8b934f99274dc0193 -->
    Loom-Trace-Id: 36308fff5a3c323c3d1bf6fffb6cd122
    Loom-Build: unknown 21130104346fe9c464ce8a3fdf82c1d3e9667639 clean
    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
2026-10-04 chore: resync installed Loom surfaces
    <!-- loom:provenance v1 build=unknown 61870b40779d205c1555e801c6e1d95df083cdea clean prompts=none sweep=none story=none trace=fb9213e215442932d2af05f3b14977de host=robb-pro base=469b2fe260c00144e0eabb13be86b6fa8429fa78 run=loom-run/v1:timer:robb-pro/fleet-resync:4c70cd1d-08cd-4add-8e2a-9a75160d163f installs=0.19.655 36c39e3c6f56e1979647ec235b4bd19c77db22f3 -->
    Loom-Trace-Id: fb9213e215442932d2af05f3b14977de
    Loom-Build: unknown 61870b40779d205c1555e801c6e1d95df083cdea clean
    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
2026-10-04 chore: resync installed Loom surfaces
    <!-- loom:provenance v1 build=unknown 61870b40779d205c1555e801c6e1d95df083cdea clean prompts=none sweep=none story=none trace=baa6c2cfcae1a320917c00ff2eb8b630 host=loom-worker-2 base=5aae310cbe653d14ef9ef8395730ade471c5b85f run=loom-run/v1:timer:loom-worker-2/fleet-resync:741a7f0f16df4fb1be4e657aeacd1244 installs=0.19.655 fc667a4faae1227f8a6837431f8a0c2d0aeaa7dd -->
    Loom-Trace-Id: baa6c2cfcae1a320917c00ff2eb8b630
    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
2026-10-04 chore: resync installed Loom surfaces
    <!-- loom:provenance v1 build=unknown b922acb2ac655cbccd71daa9e3f05a325a094ca5 clean prompts=none sweep=none story=none trace=833eeb34d4ca65c3f8c6f7824ddca3a3 host=robb-studio base=95f4e168399ec9bfef5b48a15f555af54c448c85 run=loom-run/v1:timer:robb-studio/fleet-resync:0d44f6dc-6a62-4d43-b49d-7cfdd7dbd823 installs=0.19.663 0a51e373e7fe1be156c5774b2c827d4b745368a3 -->
    Loom-Trace-Id: 833eeb34d4ca65c3f8c6f7824ddca3a3
    Loom-Build: unknown b922acb2ac655cbccd71daa9e3f05a325a094ca5 clean
    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
2026-10-04 chore: resync installed Loom surfaces
    <!-- loom:provenance v1 build=unknown 746ecb5f9d7e64ba1d2526f1e997530ad4f3dd43 clean prompts=none sweep=none story=none trace=f09501431241df2ec5688e334ba43dfe host=loom-worker-2 base=363839687d5ab39512b41c12693d025eda788554 run=loom-run/v1:timer:loom-worker-2/fleet-resync:70797dad61fb4e21806716d54f1ce910 installs=0.19.669 59a1f84e3742827a8033bb153ebbedc1759bee72 -->
    Loom-Trace-Id: f09501431241df2ec5688e334ba43dfe
    Loom-Build: unknown 746ecb5f9d7e64ba1d2526f1e997530ad4f3dd43 clean
    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
2026-10-04 chore: resync installed Loom surfaces
    <!-- loom:provenance v1 build=unknown 8080d0485cc1312129ee642b084944c56d1be074 clean prompts=none sweep=none story=none trace=ed180bcab6828041123ad54d8ddb4037 host=robb-pro base=a57b2ebd16430eb063583e467b7dae3f2d764475 run=loom-run/v1:timer:robb-pro/fleet-resync:e97b2f08-4ad9-4b66-a166-5b19820e2d1f installs=0.19.669 59a1f84e3742827a8033bb153ebbedc1759bee72 -->
    Loom-Trace-Id: ed180bcab6828041123ad54d8ddb4037
    Loom-Build: unknown 8080d0485cc1312129ee642b084944c56d1be074 clean
    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
2026-10-04 chore: resync installed Loom surfaces
    <!-- loom:provenance v1 build=unknown 83cb6647167ffc000d2c2f479b4e816b68f863f4 clean prompts=none sweep=none story=none trace=ccabffa1e1ba495895b262086030816c host=robb-studio base=e99b365932c773a3cbf0e6971641fca4ff53d32c run=loom-run/v1:timer:robb-studio/fleet-resync:88a78f1f-d978-47b5-99c3-2aabde811d17 installs=0.19.676 cd4f30bd892ea2595d8218b08150633504b0dd14 -->
    Loom-Trace-Id: ccabffa1e1ba495895b262086030816c
    Loom-Build: unknown 83cb6647167ffc000d2c2f479b4e816b68f863f4 clean
    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
2026-10-04 chore: resync installed Loom surfaces
    <!-- loom:provenance v1 build=unknown 32174d0f7e80508fa66c1a11a2c0fb28c515607e clean prompts=none sweep=none story=none trace=436d7c19b10cd5807625a7ce7190a82f host=loom-worker-2 base=37faba871cb83ab692e8f7dd79d7a6f0a72ef879 run=loom-run/v1:timer:loom-worker-2/fleet-resync:19ae50771cc04d8db7b1403c1e66bbea installs=0.19.682 9eccfa110fa294fa32a62ffe8eff669cfcf1a3a6 -->
    Loom-Trace-Id: 436d7c19b10cd5807625a7ce7190a82f
    Loom-Build: unknown 32174d0f7e80508fa66c1a11a2c0fb28c515607e clean
    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
2026-10-04 chore: resync installed Loom surfaces
    <!-- loom:provenance v1 build=unknown 72290fa960e0773b2c50d74042e24914c7327637 clean prompts=none sweep=none story=none trace=f7b6952a649a174398a48b90b6ab4793 host=robb-pro base=3a4e3631547b9d59c76f3e6a08db4c459abbccaf run=loom-run/v1:timer:robb-pro/fleet-resync:72f32482-5cc4-4b38-ab9e-4d2ef0b64e94 installs=0.19.684 bdb8fb331eb51c7def4cdd2c38b611af06f25f6d -->
    Loom-Trace-Id: f7b6952a649a174398a48b90b6ab4793
    Loom-Build: unknown 72290fa960e0773b2c50d74042e24914c7327637 clean
    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
2026-10-04 chore: resync installed Loom surfaces
    <!-- loom:provenance v1 build=unknown 76cda58637be0e74c4cb5b4c8dbc2000e2a9c3d4 clean prompts=none sweep=none story=none trace=614cbada5ce873c2b34a511816309cfc host=robb-studio base=0184c443a936c6795e8e86755e415aa4940e26c6 run=loom-run/v1:timer:robb-studio/fleet-resync:7e559a3b-ffdd-409b-8dd2-ae906a273b0a installs=0.19.692 d4974b9f5ff7843a3cfc06378ea2a69bc120e0f4 -->
    Loom-Trace-Id: 614cbada5ce873c2b34a511816309cfc
    Loom-Build: unknown 76cda58637be0e74c4cb5b4c8dbc2000e2a9c3d4 clean
    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
2026-10-04 chore: resync installed Loom surfaces
    <!-- loom:provenance v1 build=unknown f84bac5c232c093f83c1adc2533d8c75b021cda2 clean prompts=none sweep=none story=none trace=e687830614e4bd1c551ab6cf6186f8f3 host=loom-worker-2 base=f85a260744f6d9790c9697fc52bd6b408284d7e9 run=loom-run/v1:timer:loom-worker-2/fleet-resync:2db2c4373ac24de1b7a364e69eaea1ca installs=0.19.695 b0d5b09f207fda439390ea1dd249ad10e7009dfc -->
    Loom-Trace-Id: e687830614e4bd1c551ab6cf6186f8f3
    Loom-Build: unknown f84bac5c232c093f83c1adc2533d8c75b021cda2 clean
    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
2026-10-04 chore: resync installed Loom surfaces
    <!-- loom:provenance v1 build=unknown ac5c275d1c616a9723e747f5a66de93dc80d3512 clean prompts=none sweep=none story=none trace=c777c3912bd31972e9aa3ccab712ae01 host=loom-worker-1 base=dddd46f75926a6a75e9b52373c80900f3433a4f1 run=loom-run/v1:script:loom-worker-1/fleet-resync:b51a1b33-4958-4408-be36-166e12e8360b installs=0.19.697 ada83a5c7ff66b56b0060ef0be368c9fe56eb3c6 -->
    Loom-Trace-Id: c777c3912bd31972e9aa3ccab712ae01
    Loom-Build: unknown ac5c275d1c616a9723e747f5a66de93dc80d3512 clean
    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
2026-10-04 chore: resync installed Loom surfaces
    <!-- loom:provenance v1 build=unknown a19f642f5c09599c4c64827d81d228eb031be73e clean prompts=none sweep=none story=none trace=34a80e22764eb5055e37faec0eaf65fb host=robb-pro base=de19548928fb2477aeafbeec9f7242645ff310f5 run=loom-run/v1:script:robb-pro/fleet-resync:689be620-3ff2-4ff5-a2ce-f6825f6379e2 installs=0.19.698 aa619a1d07e36e8d90ac01fea63dc39285c93567 -->
    Loom-Trace-Id: 34a80e22764eb5055e37faec0eaf65fb
    Loom-Build: unknown a19f642f5c09599c4c64827d81d228eb031be73e clean
    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
2026-10-04 chore: resync installed Loom surfaces
    <!-- loom:provenance v1 build=unknown 693bdd794cb34afdefd7f0c4596824cd53078a61 clean prompts=none sweep=none story=none trace=aa18f1ec102a98d77ffc51c9be6ffbb3 host=robb-studio base=a9d4ffd9fb56ad1c0409694a689400df02538553 run=loom-run/v1:script:robb-studio/fleet-resync:3cb89ca8-62c2-4a69-8434-c4aaa3b64eaf installs=0.19.698 a58f00e0681c50d6bfc5089d0af4b3715198319f -->
    Loom-Trace-Id: aa18f1ec102a98d77ffc51c9be6ffbb3
    Loom-Build: unknown 693bdd794cb34afdefd7f0c4596824cd53078a61 clean
    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
2026-10-04 chore: resync installed Loom surfaces
    <!-- loom:provenance v1 build=unknown 7a41c2e69ef89d60ed3bd190b94838021bf18d0f clean prompts=none sweep=none story=none trace=d0f04f38b507d85402723643fcf47197 host=loom-worker-1 base=3dee11af3b0654023b712bea688a9ca1dfd16cbe run=loom-run/v1:script:loom-worker-1/fleet-resync:8fdc8c1c-f844-4c33-bc80-b424e5b4cf3d installs=0.19.703 89d5a428c652f957d7fad8a546589042d39911bc -->
    Loom-Trace-Id: d0f04f38b507d85402723643fcf47197
    Loom-Build: unknown 7a41c2e69ef89d60ed3bd190b94838021bf18d0f clean
    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
2026-10-04 refactor(sim): share C1/C2 variant generator mechanics in sim/variant_generator.py (#220)
    Body extraction, MIM-cap geometry, nominal-side locator and the
    write-or-check loop move to one module; campaign headers, factors,
    substitutions and CLIs stay in each generator. Generated bytes,
    diagnostics and exit statuses are unchanged. Adds direct-entry drift
    tests (missing/modified schematic and symbol).
    Loom-Story: 2AMLogic/sky130-pll#220
    Loom-Trace-Id: 4eeabd862824b283f62cc566408661b0
    Loom-Build: 0.19.701 867fc5bc6458255cf895a32eb2f762eba68b2542 clean
2026-10-05 chore: resync installed Loom surfaces
    <!-- loom:provenance v1 build=unknown ebb37db560de172930e261675a35bd52e429f650 clean prompts=none sweep=none story=none trace=a40e86a64366c7a1e36aea026901334f host=loom-worker-2 base=0cc469a189c5a835bbb32abb6476303d479c5a3b run=loom-run/v1:script:loom-worker-2/fleet-resync:90b6cd74-6cc0-4f58-98ee-6ede0ac6f50c installs=0.19.703 f63c3c82e6bf202f2ca7b205b532f681c5ebb2c8 -->
    Loom-Trace-Id: a40e86a64366c7a1e36aea026901334f
    Loom-Build: unknown ebb37db560de172930e261675a35bd52e429f650 clean
    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
2026-10-05 chore: resync installed Loom surfaces
    <!-- loom:provenance v1 build=unknown 7a41c2e69ef89d60ed3bd190b94838021bf18d0f clean prompts=none sweep=none story=none trace=fc04851db12f586b5d58155325131b6e host=robb-studio base=a92674a84082d00be5b2cec5b2d76d716e2e7d92 run=loom-run/v1:timer:robb-studio/fleet-resync:a7d5da6f-a896-4d6f-8d00-aebf47f9b266 installs=0.19.703 2ad9a08fb93de4d7dfac9d2b501d12c684c9c2cc -->
    Loom-Trace-Id: fc04851db12f586b5d58155325131b6e
    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
2026-10-05 chore: resync installed Loom surfaces
    <!-- loom:provenance v1 build=unknown afe7e99e397c242cc319fa80702fb3b23e23f5a7 clean prompts=none sweep=none story=none trace=e46782e1dd9c94461b4cf934ce05296b host=loom-worker-2 base=ef9bef3b04dcf003b46b69bac8b9b2310fedb913 run=loom-run/v1:timer:loom-worker-2/fleet-resync:caa89259b1fd414ebd2f07500621166d installs=0.19.703 972fe7321be6a9efe2653579379ea3bc40b899b2 -->
    Loom-Trace-Id: e46782e1dd9c94461b4cf934ce05296b
    Loom-Build: unknown afe7e99e397c242cc319fa80702fb3b23e23f5a7 clean
    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
2026-10-05 chore: resync installed Loom surfaces
    <!-- loom:provenance v1 build=unknown b44cb904ebb599db793066ccc631c846862abfbd clean prompts=none sweep=none story=none trace=9590fed7c1b1c9f549ccf3cba24292d7 host=robb-pro base=35f0eab50b5319ac6178d46cb3d159f75d4dcf5a run=loom-run/v1:timer:robb-pro/fleet-resync:dbc6174e-403d-422d-98b6-73a4b6dbf44f installs=0.19.708 dc8faf1eae3143feda6301887c303b1ee45db7f4 -->
    Loom-Trace-Id: 9590fed7c1b1c9f549ccf3cba24292d7
    Loom-Build: unknown b44cb904ebb599db793066ccc631c846862abfbd clean
    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
2026-10-05 chore: resync installed Loom surfaces
    <!-- loom:provenance v1 build=unknown 4548905848fcb7cb875c1c0518f2fd88eb65818e clean prompts=none sweep=none story=none trace=aff5e139797705f6fa0811f102ecd103 host=loom-worker-1 base=2970b7e82ddb0ae601b7d83bf30c77797deb8201 run=loom-run/v1:timer:loom-worker-1/fleet-resync:ba6a9e5686a64abaa842d71acaeae2ca installs=0.19.718 00d99344506bcf00e1aec7e910abe3d13df2d240 -->
    Loom-Trace-Id: aff5e139797705f6fa0811f102ecd103
    Loom-Build: unknown 4548905848fcb7cb875c1c0518f2fd88eb65818e clean
    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
2026-10-05 chore: resync installed Loom surfaces
    <!-- loom:provenance v1 build=unknown e7efbaa6e7b97a7d72da6032044c67525291f4d1 clean prompts=none sweep=none story=none trace=d74a33a6f35e329b3e795991e790ebfd host=robb-studio base=fed2e9cb000c6c13c4a6c0b597276f1d6c512b03 run=loom-run/v1:timer:robb-studio/fleet-resync:304f49c8-5b3e-46a9-a557-945b9ae177f0 installs=0.19.718 00d99344506bcf00e1aec7e910abe3d13df2d240 -->
    Loom-Trace-Id: d74a33a6f35e329b3e795991e790ebfd
    Loom-Build: unknown e7efbaa6e7b97a7d72da6032044c67525291f4d1 clean
    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
2026-10-05 chore: resync installed Loom surfaces
    <!-- loom:provenance v1 build=unknown 347b71e65e709d9fd49aba75d3fb67877fc08818 clean prompts=none sweep=none story=none trace=f9653dd318724c98136e7cef63e551ed host=robb-pro base=b7ff23444c518aac2ca216fe15f4ae05518c0838 run=loom-run/v1:timer:robb-pro/fleet-resync:cdc95970-9fb1-49fa-a0e6-037a3fab2099 installs=0.19.728 991dcebf6f6b2de6571f1d3400bec083498c6438 -->
    Loom-Trace-Id: f9653dd318724c98136e7cef63e551ed
    Loom-Build: unknown 347b71e65e709d9fd49aba75d3fb67877fc08818 clean
    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
2026-10-05 chore: resync installed Loom surfaces
    <!-- loom:provenance v1 build=unknown 5c0d18101f48fecb656f10fa37afa9b09bf41631 clean prompts=none sweep=none story=none trace=ddcf49552af364cbf6e884bd59584c1f host=loom-worker-1 base=bb959e659b21bd00a91e58b6454f0176ee916435 run=loom-run/v1:timer:loom-worker-1/fleet-resync:5eb526a05f244f1985770579e7620ff1 installs=0.19.731 7484b71fce5179a025950e71a82855afaf6fd730 -->
    Loom-Trace-Id: ddcf49552af364cbf6e884bd59584c1f
    Loom-Build: unknown 5c0d18101f48fecb656f10fa37afa9b09bf41631 clean
    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
2026-10-05 chore: resync installed Loom surfaces
    <!-- loom:provenance v1 build=unknown 0b160514b6658e3ab26a71c6525791da25b46fcf clean prompts=none sweep=none story=none trace=311c3eb2c0ab9550d3de38df5523f3d7 host=robb-studio base=c47c8712947eb75a7e69c56046576896e13a81d2 run=loom-run/v1:timer:robb-studio/fleet-resync:e6dec631-b42b-4cf2-b854-cc363cfde6e0 installs=0.19.731 d6146becf339a3d4e55e26e8807ac4571213a00b -->
    Loom-Trace-Id: 311c3eb2c0ab9550d3de38df5523f3d7
    Loom-Build: unknown 0b160514b6658e3ab26a71c6525791da25b46fcf clean
    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
2026-10-05 chore: resync installed Loom surfaces
    <!-- loom:provenance v1 build=unknown 5c0d18101f48fecb656f10fa37afa9b09bf41631 clean prompts=none sweep=none story=none trace=f1e8d4c6e73b8eec3e87a8da52e10f2d host=robb-pro base=16dfd51956097522ed51f694a859ac4c265a4d97 run=loom-run/v1:timer:robb-pro/fleet-resync:5518fd33-81cb-479f-93f0-287ea4b08876 installs=0.19.733 4e67131ce3a1317d8cb8904ec342541cc2f45665 -->
    Loom-Trace-Id: f1e8d4c6e73b8eec3e87a8da52e10f2d
    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
2026-10-05 chore: resync installed Loom surfaces
    <!-- loom:provenance v1 build=unknown ca170d11544ef499cc9500a45bbad152edacfbd1 clean prompts=none sweep=none story=none trace=6dcfc713b6a851b40932158c2eeb70af host=loom-worker-3 base=10710966fb0e6353206eb4717facfe94f89f0bb9 run=loom-run/v1:timer:loom-worker-3/fleet-resync:20ce0908ea5a468a9e055470104047ed installs=0.19.734 7ba6ea50c36dfdd2b5e2922dd22c65560980a5a2 -->
    Loom-Trace-Id: 6dcfc713b6a851b40932158c2eeb70af
    Loom-Build: unknown ca170d11544ef499cc9500a45bbad152edacfbd1 clean
    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
2026-10-05 chore: resync installed Loom surfaces
    <!-- loom:provenance v1 build=unknown 03f1c42302d15f8a83425a84a4e36ca484f3f625 clean prompts=none sweep=none story=none trace=f1bc879f8aa652d550764ffcd36e27d1 host=loom-worker-1 base=e2716d9d845b53acb553cbe738b28dbf82aa7d9b run=loom-run/v1:timer:loom-worker-1/fleet-resync:f302a3cc8558413492093df510b02418 installs=0.19.734 967abe71d019ce6606018b4e57dee0223b84d96f -->
    Loom-Trace-Id: f1bc879f8aa652d550764ffcd36e27d1
    Loom-Build: unknown 03f1c42302d15f8a83425a84a4e36ca484f3f625 clean
    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
2026-10-05 chore: resync installed Loom surfaces
    <!-- loom:provenance v1 build=unknown ce7557ba58624d48fedbca2bc037dfa8ce3943e7 clean prompts=none sweep=none story=none trace=e1f2558834c47835cd9a53ec8c9a2ffa host=loom-worker-3 base=309b55429f84b81404fc02e8fe177d710e6e855d run=loom-run/v1:timer:loom-worker-3/fleet-resync:50f5f0046e2c4890961b3221bd360247 installs=0.19.734 ba9edb650872e5265eaca0c47f75e3cb828ecad2 -->
    Loom-Trace-Id: e1f2558834c47835cd9a53ec8c9a2ffa
    Loom-Build: unknown ce7557ba58624d48fedbca2bc037dfa8ce3943e7 clean
    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
2026-10-05 chore: resync installed Loom surfaces
    <!-- loom:provenance v1 build=unknown f92eaec38470a7b0732e065f4864faec9a1905d6 clean prompts=none sweep=none story=none trace=07aa020a8179d52651250562e9808b98 host=robb-studio base=1fad617348769c162dbb89336e3a7d31b6569bb8 run=loom-run/v1:timer:robb-studio/fleet-resync:3b3ebdf2-b5f7-48ed-b7bb-5fb945094061 installs=0.19.734 78f3e99c44d0af6d4598adf7577bb6676baf3e8f -->
    Loom-Trace-Id: 07aa020a8179d52651250562e9808b98
    Loom-Build: unknown f92eaec38470a7b0732e065f4864faec9a1905d6 clean
    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
2026-10-06 chore: resync installed Loom surfaces
    <!-- loom:provenance v1 build=unknown ca170d11544ef499cc9500a45bbad152edacfbd1 clean prompts=none sweep=none story=none trace=fca9c14d74d6d634726f5823c51bc62a host=loom-worker-2 base=dfd0c1cb79c99a699f696a3f8383c494534f4efc run=loom-run/v1:timer:loom-worker-2/fleet-resync:23a23f0878c1494cb720941baddfea81 installs=0.19.741 3cede3920c6b567d5400789187a904970d46b0fb -->
    Loom-Trace-Id: fca9c14d74d6d634726f5823c51bc62a
    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
2026-10-06 chore: resync installed Loom surfaces
    <!-- loom:provenance v1 build=unknown e38a22941348fd8e83d1f4b06130d2a214adfb50 clean prompts=none sweep=none story=none trace=a7fe3a9a1fedfce89846c20f2e98ac31 host=robb-pro base=b0b3ba49e76733b4cb6ae7796bbd663650305d2e run=loom-run/v1:timer:robb-pro/fleet-resync:2d770a42-f0e7-4695-abfa-b912e75382e6 installs=0.19.744 8bc5bcce93c4d9721817387afe8b4b6d79f26054 -->
    Loom-Trace-Id: a7fe3a9a1fedfce89846c20f2e98ac31
    Loom-Build: unknown e38a22941348fd8e83d1f4b06130d2a214adfb50 clean
    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
2026-10-06 chore: resync installed Loom surfaces
    <!-- loom:provenance v1 build=unknown f66ea90ff1bdec51aa4c8dc3f4b2e8d26e3dfd2d clean prompts=none sweep=none story=none trace=66d96c3bb00b04fae967865ee02fc4de host=loom-worker-3 base=461cd02189e454e532a7af2076d99f2e163c2b43 run=loom-run/v1:timer:loom-worker-3/fleet-resync:eb2dceb410e848a19d58f96f678c995e installs=0.19.749 6135634b053dc30ef5aa8e6d733bfe79bb2ac734 -->
    Loom-Trace-Id: 66d96c3bb00b04fae967865ee02fc4de
    Loom-Build: unknown f66ea90ff1bdec51aa4c8dc3f4b2e8d26e3dfd2d clean
    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
2026-10-06 chore: resync installed Loom surfaces
    <!-- loom:provenance v1 build=unknown ade8a2c60cc8370d04d72f331141acb6fb32e121 clean prompts=none sweep=none story=none trace=6245fb88b5bdf9f7ccecb6b2168dc335 host=robb-studio base=4f6ac9575082f700d89254134b9792c2d92e4110 run=loom-run/v1:timer:robb-studio/fleet-resync:b305aed2-1a25-4576-aca7-9b017ac4377e installs=0.19.755 8d97d322e1cb3723988504337089beca73d0511c -->
    Loom-Trace-Id: 6245fb88b5bdf9f7ccecb6b2168dc335
    Loom-Build: unknown ade8a2c60cc8370d04d72f331141acb6fb32e121 clean
    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
2026-10-06 chore: resync installed Loom surfaces
    <!-- loom:provenance v1 build=unknown 2489bb7d5203844b3fbe8efbe007f44aa074685d clean prompts=none sweep=none story=none trace=0b5c9263a55c09e6fbd870b2d9ff5d9b host=loom-worker-2 base=8b936141ab77555c068a4c4aa5674adc9e34f7a9 run=loom-run/v1:timer:loom-worker-2/fleet-resync:d3f5a5beb1144f72ac8be575767b3e03 installs=0.19.760 3a509582b179d91c2d5b5a65a7ba4650c3c08985 -->
    Loom-Trace-Id: 0b5c9263a55c09e6fbd870b2d9ff5d9b
    Loom-Build: unknown 2489bb7d5203844b3fbe8efbe007f44aa074685d clean
    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
2026-10-06 chore: resync installed Loom surfaces
    <!-- loom:provenance v1 build=unknown 986d16b700174622774ff68af4ef323e8d0e23ba clean prompts=none sweep=none story=none trace=cb518f1f5785c258556383940a46c461 host=loom-worker-1 base=01d8da8e3d36d540c6eec3527d7140406a09174c run=loom-run/v1:timer:loom-worker-1/fleet-resync:97df92c5eca846de85e979810663a94b installs=0.19.765 c6cec65c4f320f11153c72e840e49a5d6a6f1afc -->
    Loom-Trace-Id: cb518f1f5785c258556383940a46c461
    Loom-Build: unknown 986d16b700174622774ff68af4ef323e8d0e23ba clean
    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
2026-10-06 chore: resync installed Loom surfaces
    <!-- loom:provenance v1 build=unknown 85e52221261264d7f7643251de706f00c8db289f clean prompts=none sweep=none story=none trace=a2434124d73d8cca0ca77230fc85adf5 host=robb-pro base=2c8bb198ddfecffe0a8efa7aa525b3d8897203e4 run=loom-run/v1:timer:robb-pro/fleet-resync:abffb067-59ed-4a6e-94b6-8cf3500c935c installs=0.19.768 c9f7ca975144d991bce40f492403b8292e8b7fae -->
    Loom-Trace-Id: a2434124d73d8cca0ca77230fc85adf5
    Loom-Build: unknown 85e52221261264d7f7643251de706f00c8db289f clean
    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
2026-10-06 chore: resync installed Loom surfaces
    <!-- loom:provenance v1 build=unknown 31b34ebfd7d4539094523eaa7b56a104bebe5fc0 clean prompts=none sweep=none story=none trace=16fac36f144dc183c71465eb36c89afc host=loom-worker-3 base=eddf3a31a90f097c07297b05e1283af15f7babe4 run=loom-run/v1:timer:loom-worker-3/fleet-resync:c763e24590314b918c8ee8df5d2de1db installs=0.19.769 af995a5725fdadf708127f006aa8f248b482d7d7 -->
    Loom-Trace-Id: 16fac36f144dc183c71465eb36c89afc
    Loom-Build: unknown 31b34ebfd7d4539094523eaa7b56a104bebe5fc0 clean
    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
2026-10-06 chore: resync installed Loom surfaces
    <!-- loom:provenance v1 build=unknown 7bed309263b3785eae46a9cbc53b3b24a52b10d2 clean prompts=none sweep=none story=none trace=843adbd5eac450c43d3a2c43da1bf729 host=robb-studio base=79f3dcf8bc55d225d3e23741afe2956980b1e927 run=loom-run/v1:timer:robb-studio/fleet-resync:f83d5ba4-81f7-479a-9768-6af33d4cc825 installs=0.19.783 a9b459e0c2b1916ceb116db33053e7eb0df57e7b -->
    Loom-Trace-Id: 843adbd5eac450c43d3a2c43da1bf729
    Loom-Build: unknown 7bed309263b3785eae46a9cbc53b3b24a52b10d2 clean
    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
2026-10-06 chore: resync installed Loom surfaces
    <!-- loom:provenance v1 build=unknown 07bc40ba9ab0f7dfe7cd0990377b7ac07a52d220 clean prompts=none sweep=none story=none trace=563f186108419cf03cef002a62c3b201 host=loom-worker-2 base=e072daf94da03e4e07b9822862fac8ff5904cf0b run=loom-run/v1:timer:loom-worker-2/fleet-resync:944beccd157a4197b81feafdd19f443e installs=0.19.785 2f0a9dbb4f06053f747b8a5615a3519f8e30b527 -->
    Loom-Trace-Id: 563f186108419cf03cef002a62c3b201
    Loom-Build: unknown 07bc40ba9ab0f7dfe7cd0990377b7ac07a52d220 clean
    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
2026-10-06 chore: resync installed Loom surfaces
    <!-- loom:provenance v1 build=unknown 31b34ebfd7d4539094523eaa7b56a104bebe5fc0 clean prompts=none sweep=none story=none trace=ea6600df41a4b420b6d8e967f839ccfd host=loom-worker-3 base=8530d25ef3faa332ed10f18dc340cdb1a55072ef run=loom-run/v1:timer:loom-worker-3/fleet-resync:c80415b48fd5404bbd599c4f6cc8a448 installs=0.19.793 7ceff96944c39d33e3c2f1141ca650c2c4c05679 -->
    Loom-Trace-Id: ea6600df41a4b420b6d8e967f839ccfd
    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
2026-10-06 chore: resync installed Loom surfaces
    <!-- loom:provenance v1 build=unknown 596a53e525683919daae1b43e6babe9bf847a02f clean prompts=none sweep=none story=none trace=b9c0cb42a5a72ecc21726229c957ef1f host=loom-worker-2 base=ecb162407623b3e7b03fa345ffae31146076ed23 run=loom-run/v1:timer:loom-worker-2/fleet-resync:21d578f5cc0b4b7ba5f10759f5f30ae8 installs=0.19.801 524bdb33cb26c8355454d7550413c89e72c06fae -->
    Loom-Trace-Id: b9c0cb42a5a72ecc21726229c957ef1f
    Loom-Build: unknown 596a53e525683919daae1b43e6babe9bf847a02f clean
    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
2026-10-06 chore: resync installed Loom surfaces
    <!-- loom:provenance v1 build=unknown 40b591a33adb895d4f46977105f9b264d8a2599b clean prompts=none sweep=none story=none trace=e41c725fe0c176312eb412bc69fe5b01 host=robb-studio base=52c0482cb297086b5cbaf667dcad62fc577f0d06 run=loom-run/v1:timer:robb-studio/fleet-resync:37d704dd-4dfd-4341-adb4-6551637ad147 installs=0.19.802 72ce1f7385747dd773d1644408ec22072b8a5d20 -->
    Loom-Trace-Id: e41c725fe0c176312eb412bc69fe5b01
    Loom-Build: unknown 40b591a33adb895d4f46977105f9b264d8a2599b clean
    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
2026-10-06 chore: resync installed Loom surfaces
    <!-- loom:provenance v1 build=unknown 31b34ebfd7d4539094523eaa7b56a104bebe5fc0 clean prompts=none sweep=none story=none trace=5ad0480c4b21b80f9c852c448319e7a1 host=loom-worker-3 base=cc05fe9d055ac56af0b1b18d762f2e2a5eda9077 run=loom-run/v1:timer:loom-worker-3/fleet-resync:48e836f11f9547ddb96de5aa0d072a05 installs=0.19.810 933f828e779602e492e4e157812988a4b8128111 -->
    Loom-Trace-Id: 5ad0480c4b21b80f9c852c448319e7a1
    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
2026-10-07 ci: run on GitHub-hosted runners; the shared self-hosted runner is retired
    This repo routed same-repo events to the fleet's self-hosted "heavy"
    runner because it was private, and GitHub-hosted minutes for private
    repos in this org were billing-blocked. The repo is public now, so hosted
    minutes are free, and the operator's direction (2026-10-06) is public
    repos on GitHub-hosted, private repos on the ci-spot fleet, with the
    always-on runner retired (2AMLogic/2am#3182).
    Every job already ran on ubuntu-latest for fork PRs, so each job's
    hosted path is the one fork PRs exercised; nothing in the steps changes.
    Loom-Story: 2AMLogic/2am#3182
    Loom-Trace-Id: dcbf8377552e47b4b60c27d163f69364
    Loom-Bui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
2026-10-07 chore: resync installed Loom surfaces
    <!-- loom:provenance v1 build=unknown f71cf25de9e75bae6060da4a599df8fbabe75890 clean prompts=none sweep=none story=none trace=64943e35511da4833bbd385cf288be8a host=loom-worker-2 base=26223028074f6a3be9921f3bbdcc67fc505288ac run=loom-run/v1:timer:loom-worker-2/fleet-resync:d69eb1b87d4849ae810a145b1b667d2f installs=0.19.822 1c6969ea8726c800a353c236d9f23456a5706f1a -->
    Loom-Trace-Id: 64943e35511da4833bbd385cf288be8a
    Loom-Build: unknown f71cf25de9e75bae6060da4a599df8fbabe75890 clean
    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
2026-10-07 chore: resync installed Loom surfaces
    <!-- loom:provenance v1 build=unknown 31b34ebfd7d4539094523eaa7b56a104bebe5fc0 clean prompts=none sweep=none story=none trace=cb192cb8f72cf6f2711f73f7ee12bebc host=loom-worker-3 base=e0036855f50ed84e3bf9e7c3c1eb7580b4897410 run=loom-run/v1:timer:loom-worker-3/fleet-resync:c1e385c3607e43ad8bed9c7d29811c66 installs=0.19.830 a966f7b89b714704fa1225b96e2dbee50480a4c6 -->
    Loom-Trace-Id: cb192cb8f72cf6f2711f73f7ee12bebc
    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
2026-10-07 chore: resync installed Loom surfaces
    <!-- loom:provenance v1 build=unknown 8abdd34fddc879aff407380278baa713eca6b758 clean prompts=none sweep=none story=none trace=ea945665dad5ccb3880de51c4448e8b9 host=robb-pro base=49a4fab2c55f249e7daa23f27d8a4fdc81095bbd run=loom-run/v1:timer:robb-pro/fleet-resync:1466e397-b80c-46ea-a42c-26a7fbd4e00e installs=0.19.831 61814c9c1912925cdff7418842ff3ea17cd56fe4 -->
    Loom-Trace-Id: ea945665dad5ccb3880de51c4448e8b9
    Loom-Build: unknown 8abdd34fddc879aff407380278baa713eca6b758 clean
    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
2026-10-07 chore: resync installed Loom surfaces
    <!-- loom:provenance v1 build=unknown 628be5bb140bcff803d159201bd61e1b868901b0 clean prompts=none sweep=none story=none trace=093df1dc315c5e78dcccfca9d699d5f5 host=loom-worker-2 base=0a8bbd32ea072ffaedc697782752c3466d1b8294 run=loom-run/v1:timer:loom-worker-2/fleet-resync:0b0ea5e184c0429a9c431fcca6c791ad installs=0.19.832 1a0fc15974bf0575a9155fb8276f7529fc813542 -->
    Loom-Trace-Id: 093df1dc315c5e78dcccfca9d699d5f5
    Loom-Build: unknown 628be5bb140bcff803d159201bd61e1b868901b0 clean
    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
2026-10-07 chore: resync installed Loom surfaces
    <!-- loom:provenance v1 build=unknown 069e3b45d86c08f0d60c8fc2b0096de441e99bdc clean prompts=none sweep=none story=none trace=b1ba9d6b2b581e47827d9c099f717b04 host=loom-worker-1 base=d9915dafac9175d2c77ba2d5c9fd98ec440271e3 run=loom-run/v1:timer:loom-worker-1/fleet-resync:aada8278bd4843bcaecce69fdf91251e installs=0.19.838 e70aa17f8dead31bda49cf044c3fc28119df6e90 -->
    Loom-Trace-Id: b1ba9d6b2b581e47827d9c099f717b04
    Loom-Build: unknown 069e3b45d86c08f0d60c8fc2b0096de441e99bdc clean
    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
2026-10-07 chore: resync installed Loom surfaces
    <!-- loom:provenance v1 build=unknown 31b34ebfd7d4539094523eaa7b56a104bebe5fc0 clean prompts=none sweep=none story=none trace=ef030e94bce76f728497f5927960865f host=loom-worker-3 base=17b3b426d193c436e5d80adeb573cecf1224aa91 run=loom-run/v1:timer:loom-worker-3/fleet-resync:28ba4284bfa446c888b501714eda0509 installs=0.19.840 59b533a2a1ed5e186fbf8446b5acbe42d7231854 -->
    Loom-Trace-Id: ef030e94bce76f728497f5927960865f
    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
2026-10-07 chore: resync installed Loom surfaces
    <!-- loom:provenance v1 build=unknown bc59c70c3412a87b31a0dbe65cd6abf968744328 clean prompts=none sweep=none story=none trace=766033e4e881801f24971d664c490ea3 host=robb-studio base=6d10555fd55979ca6d32471dccdd7609e20d2a03 run=loom-run/v1:timer:robb-studio/fleet-resync:6b3b079a-890e-4a79-9c3a-0b4bb33ff7c4 installs=0.19.840 59b533a2a1ed5e186fbf8446b5acbe42d7231854 -->
    Loom-Trace-Id: 766033e4e881801f24971d664c490ea3
    Loom-Build: unknown bc59c70c3412a87b31a0dbe65cd6abf968744328 clean
    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
2026-10-07 chore: resync installed Loom surfaces
    <!-- loom:provenance v1 build=unknown a068938e7a6c13759bcb3943e408273a3d352257 clean prompts=none sweep=none story=none trace=76bec863c8f6aff2d49b3aa2be128619 host=robb-pro base=12c31f92586819b7ecd6839dbc15dc55ac72f8c8 run=loom-run/v1:timer:robb-pro/fleet-resync:d9927fc6-ee80-4b6a-ba2b-f13576bd5f9b installs=0.19.846 837b14d7440b89ae8a2cec6d045483ac33659af5 -->
    Loom-Trace-Id: 76bec863c8f6aff2d49b3aa2be128619
    Loom-Build: unknown a068938e7a6c13759bcb3943e408273a3d352257 clean
    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
2026-10-07 chore: resync installed Loom surfaces
    <!-- loom:provenance v1 build=unknown 628be5bb140bcff803d159201bd61e1b868901b0 clean prompts=none sweep=none story=none trace=5a6f676b4652a1a750bbce1386c68d06 host=loom-worker-2 base=b59834c67a56c0c4ec454c6a218ae035be158921 run=loom-run/v1:timer:loom-worker-2/fleet-resync:bd416e653be04ef4b13353430625e379 installs=0.19.850 3bb4bfc90603b6ad65cabca9b3eb42a59f1a9d3a -->
    Loom-Trace-Id: 5a6f676b4652a1a750bbce1386c68d06
    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
2026-10-07 chore: resync installed Loom surfaces
    <!-- loom:provenance v1 build=unknown 40215645df8a13508180b248b44244dc488bb078 clean prompts=none sweep=none story=none trace=29fde30615e6e47f39b41aa314c2c883 host=loom-worker-1 base=9fd48e142ed4885a224aa6bd2fa44fc44987d00f run=loom-run/v1:timer:loom-worker-1/fleet-resync:d1fbedfcc7824ae59233c0ea94dc4650 installs=0.19.853 2889d5ed585b4da0935543cb916381cc03b19746 -->
    Loom-Trace-Id: 29fde30615e6e47f39b41aa314c2c883
    Loom-Build: unknown 40215645df8a13508180b248b44244dc488bb078 clean
    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
2026-10-07 chore: resync installed Loom surfaces
    <!-- loom:provenance v1 build=unknown 31b34ebfd7d4539094523eaa7b56a104bebe5fc0 clean prompts=none sweep=none story=none trace=cdf49c615da3f5ce46e9fcda1a24f787 host=loom-worker-3 base=659491ae13cab07f6a957691be54a98aa2edf40e run=loom-run/v1:timer:loom-worker-3/fleet-resync:cab31e05b8a24df09bc88f53ee3fb501 installs=0.19.857 7a0b529e6f57a79713f6924bf58d8392ff404259 -->
    Loom-Trace-Id: cdf49c615da3f5ce46e9fcda1a24f787
    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
2026-10-07 chore: resync installed Loom surfaces
    <!-- loom:provenance v1 build=unknown 4b44e7c5db0de1d2b5927de7de229120d546aad3 clean prompts=none sweep=none story=none trace=dfa656ee3483a044378501f49d36f812 host=robb-studio base=191d25cb13b513985b3142fb46dac3a89518317e run=loom-run/v1:timer:robb-studio/fleet-resync:d80d6bc0-eb68-4a07-8226-2d947d328b3a installs=0.19.859 0aefebd79aba8ab33470f1af4b96847fc794bd0d -->
    Loom-Trace-Id: dfa656ee3483a044378501f49d36f812
    Loom-Build: unknown 4b44e7c5db0de1d2b5927de7de229120d546aad3 clean
    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
2026-10-07 chore: resync installed Loom surfaces
    <!-- loom:provenance v1 build=unknown b591c8cf436f0d4aa5870a9bc7cd5f7194e0e778 dirty prompts=none sweep=none story=none trace=6eca4b0c47205457aae7a3d721c17f17 host=robb-pro base=547a320ee1565e506dca6be868f494b05930f4a2 run=loom-run/v1:timer:robb-pro/fleet-resync:64af20b3-58cb-47f2-b770-117197cb41e9 installs=0.19.864 128a7eba2bb5f7bcf8891ba284b14cb7ebf8dd3d -->
    Loom-Trace-Id: 6eca4b0c47205457aae7a3d721c17f17
    Loom-Build: unknown b591c8cf436f0d4aa5870a9bc7cd5f7194e0e778 dirty
    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
2026-10-07 chore: resync installed Loom surfaces
    <!-- loom:provenance v1 build=unknown b551219fd5b8347113c0cbc79ea416e81c39fa9d clean prompts=none sweep=none story=none trace=5ac7c8c62dad54841e21dd94f0920de3 host=loom-worker-2 base=ab3600f4d11d92b86c2d58e87db36b92462b4cc7 run=loom-run/v1:timer:loom-worker-2/fleet-resync:d10fb10789e94930ab1af368c15a8f8b installs=0.19.864 128a7eba2bb5f7bcf8891ba284b14cb7ebf8dd3d -->
    Loom-Trace-Id: 5ac7c8c62dad54841e21dd94f0920de3
    Loom-Build: unknown b551219fd5b8347113c0cbc79ea416e81c39fa9d clean
    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
2026-10-07 chore: resync installed Loom surfaces
    <!-- loom:provenance v1 build=unknown 90fbd167e4e376894396e651676cf58fc9aa223a clean prompts=none sweep=none story=none trace=196876656e912171b28029ceca9f772d host=loom-worker-1 base=9361cf39d113bc4d3f5f3355656a668fad6edc4a run=loom-run/v1:timer:loom-worker-1/fleet-resync:7b46720ff3a84a8184f2f2b3bc039260 installs=0.19.868 ee904e1c151bc9cf15b0eb55dfe9d57ad6136cff -->
    Loom-Trace-Id: 196876656e912171b28029ceca9f772d
    Loom-Build: unknown 90fbd167e4e376894396e651676cf58fc9aa223a clean
    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
2026-10-08 chore: resync installed Loom surfaces
    <!-- loom:provenance v1 build=unknown 5a3df331a0612dee585ef905015af01d08e3467f clean prompts=none sweep=none story=none trace=5690fa95febe608e500a46dde8a6ee92 host=loom-worker-2 base=44270e83303d8f4986fe526be07a39fe628cb976 run=loom-run/v1:timer:loom-worker-2/fleet-resync:5c9c35d59b704bff9d8bf096ee7ba7be installs=0.19.876 b16d54e63fbbec4d7f15f13c1f43a5e5b38145ce -->
    Loom-Trace-Id: 5690fa95febe608e500a46dde8a6ee92
    Loom-Build: unknown 5a3df331a0612dee585ef905015af01d08e3467f clean
    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
2026-10-08 chore: resync installed Loom surfaces
    <!-- loom:provenance v1 build=unknown 134eb3ff06c1a86f49a911c6c17464f55e719736 clean prompts=none sweep=none story=none trace=c7df110d490314040dcd1347b2481843 host=loom-worker-1 base=d4d5c8d5c2e60aa5035a09df1b7b55010f82d0a1 run=loom-run/v1:timer:loom-worker-1/fleet-resync:53d0cec2cd61484eb9a0f8fb1f24ac5e installs=0.19.879 c15619905bdd8a24506c3853f45490d26e8f1cad -->
    Loom-Trace-Id: c7df110d490314040dcd1347b2481843
    Loom-Build: unknown 134eb3ff06c1a86f49a911c6c17464f55e719736 clean
    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
2026-10-08 chore: resync installed Loom surfaces
    <!-- loom:provenance v1 build=unknown 8f86de23319d8f6cf049557dcc9cf2e321211d9d clean prompts=none sweep=none story=none trace=17de45f778fbfd714af8afad02c96375 host=loom-worker-3 base=4caca548be1e0a4f60703d9353d2d2be584647f4 run=loom-run/v1:timer:loom-worker-3/fleet-resync:9e3e5d4a08824de3b7bc02940be2a0da installs=0.19.882 c9f85af3d967986cdd7a3f27e088a16f88712b05 -->
    Loom-Trace-Id: 17de45f778fbfd714af8afad02c96375
    Loom-Build: unknown 8f86de23319d8f6cf049557dcc9cf2e321211d9d clean
    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
2026-10-08 chore: resync installed Loom surfaces
    <!-- loom:provenance v1 build=unknown 4a5fb2b6276e17ff26ee1382acfe2ea7360ebea5 clean prompts=none sweep=none story=none trace=67857e1b7189785825a2dfc70921cf85 host=loom-worker-2 base=a0923b701e1edc0476613f84ecd9b83da7bfa646 run=loom-run/v1:timer:loom-worker-2/fleet-resync:dd6a5f3dceff4d8d8602a07a1dc89c95 installs=0.19.892 ce93e8a919d79a6f027bab268846a52084f9d94e -->
    Loom-Trace-Id: 67857e1b7189785825a2dfc70921cf85
    Loom-Build: unknown 4a5fb2b6276e17ff26ee1382acfe2ea7360ebea5 clean
    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
2026-10-08 chore: resync installed Loom surfaces
    <!-- loom:provenance v1 build=unknown b591c8cf436f0d4aa5870a9bc7cd5f7194e0e778 dirty prompts=none sweep=none story=none trace=28e7ca5fdb768489aa38bf002407d5a5 host=robb-pro base=02d4d0d0f631b36c96c59f90c02e607cb66a82c9 run=loom-run/v1:timer:robb-pro/fleet-resync:eb5f838e-a774-4e20-8102-c37ee3ff31ca installs=0.19.895 9b30d293bcba1e79d49cabfc1c5bb5b6f4c0dc77 -->
    Loom-Trace-Id: 28e7ca5fdb768489aa38bf002407d5a5
    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
2026-10-08 chore: resync installed Loom surfaces
    <!-- loom:provenance v1 build=unknown 5684fc8c8ac418d95ad66a002d001eaea1283c9a clean prompts=none sweep=none story=none trace=c864acd3b9a5dbb419fddd8bd2a6283b host=loom-worker-3 base=0330421b31c871698f3e980a8884a03444e2a27b run=loom-run/v1:timer:loom-worker-3/fleet-resync:4771e7c630c34445b7f28539669d76e3 installs=0.19.898 3d55b9a1669c132d130d98f10a292c1325322c30 -->
    Loom-Trace-Id: c864acd3b9a5dbb419fddd8bd2a6283b
    Loom-Build: unknown 5684fc8c8ac418d95ad66a002d001eaea1283c9a clean
    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
2026-10-08 chore: resync installed Loom surfaces
    <!-- loom:provenance v1 build=unknown 04a1189116c7320def7d9ce357d2d9268405ae92 clean prompts=none sweep=none story=none trace=8e55b27fc60ffb045554bd413ad8f3c8 host=robb-pro base=92d1506c4bbc3c01247489be98805595cf9919f0 run=loom-run/v1:timer:robb-pro/fleet-resync:83b69005-7c5b-44b3-96f8-33f07bf82f4b installs=0.19.917 d3c1ea3a4c81e01ce5487dc3e4bbdd86534e677e -->
    Loom-Trace-Id: 8e55b27fc60ffb045554bd413ad8f3c8
    Loom-Build: unknown 04a1189116c7320def7d9ce357d2d9268405ae92 clean
    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
2026-10-08 signoff: cite the characterization report for T1 item 8 (analog partition)
    measurements/report.md has been a per-spec-row report since #22/#217, so the
    README's reason for declining item 8 ("plumbing-only") no longer described the
    file. Measured against item 8's checklist text at the pinned klt 0.6.0:
    - 8.analog is cited via a generic envelope,
    signoff/evidence/characterization-report.json, which pins the report's
    SHA-256 in provenance.input.content_hash and names it in
    provenance.input.path ({path, scope: "repo"}). The manifest uses the same
    pin. The envelope summary says what status "pass" does NOT assert: that any
    spec row is met. It names the report's FAIL rows (3, 8, 9's dete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
2026-10-08 README: replace stale status prose with a dated, pointer-based summary
    Refresh the status section, repository-layout table, and spec pointer so
    they no longer claim the spec is wholly unratified or that no PLL
    simulation or layout evidence exists. Delegate verdicts to the spec,
    measurements report, and signoff files instead of copying counts.
    Loom-Story: 2AMLogic/sky130-pll#227
    Loom-Trace-Id: 66f7c9d9f9c0ca4932d832e898522b8c
    Loom-Build: 0.19.868 ee904e1c151bc9cf15b0eb55dfe9d57ad6136cff clean
2026-10-08 chore: resync installed Loom surfaces
    <!-- loom:provenance v1 build=unknown d2a55ce217b3ad1793611a2c54946676bb55b512 clean prompts=none sweep=none story=none trace=459637e4e8503593bdf58360865a7524 host=robb-pro base=4b1cc64e0c53149c4cc779112af796e35f7f680c run=loom-run/v1:timer:robb-pro/fleet-resync:95b3cf92-9cd9-4c36-8bbd-bdcace7c3874 installs=0.19.935 d347079cd0bad2db2c11ee4f0b760f04b2601d21 -->
    Loom-Trace-Id: 459637e4e8503593bdf58360865a7524
    Loom-Build: unknown d2a55ce217b3ad1793611a2c54946676bb55b512 clean
    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
2026-10-08 signoff: bump grader pin to klayout-tools 0.7.0 and narrow guard 3 (#200)
    klayout-tools 0.7.0 carries the #2467 fix: it renders an undersized yield
    sample unmet/undersized_sample and a declared negative control that did not
    fire unmet/negative_control_not_detected. Guard 3 therefore stops refusing
    those and keeps refusing what the 0.7.0 grader still passes as met: a
    measurement with no declared negative_control, and a malformed sample_size.
    - ci.yml and run-signoff.sh pin 0.7.0; tier-report.json re-rendered on the
    v0.7.0 release build (t1_met_count unchanged at 3; checklist-text drift and
    item 8 input_verified now true).
    - Add signoff/tests/test_yield_citation_guard.py (stub-klt policy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
2026-10-09 chore: resync installed Loom surfaces
    <!-- loom:provenance v1 build=unknown 05dba463c5b293d38f0ca071725983862498b3f3 clean prompts=none sweep=none story=none trace=14298316053024bcf5120bff695771ab host=robb-pro base=a0af4e4368e72dca764c4a87e292cd6f5aed15f4 run=loom-run/v1:timer:robb-pro/fleet-resync:2f384483-6d77-4ba2-9888-aa1e4b5be36c installs=0.19.953 b93d7a955d63411cb4c94b986fd5138d27dedb0f -->
    Loom-Trace-Id: 14298316053024bcf5120bff695771ab
    Loom-Build: unknown 05dba463c5b293d38f0ca071725983862498b3f3 clean
    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
2026-10-09 sim: add supply-current/power campaign harness and testbenches (part of #233)
    Adds sim/power/: a pure whole-cycle supply-current reducer with unit tests,
    generated xschem testbenches and klt sim requests (45-point PVT grid) for
    vco_ring5, divider_intN (N=4, N=64) and pfd_cp (1 MHz / 25 MHz reference),
    and a record minter. No records yet: the batch submit was refused (fleet at
    BATCH_MAX_CONCURRENT_INSTANCES=8). Spec row 12 is untouched.
    Loom-Story: 2AMLogic/sky130-pll#233
    Loom-Trace-Id: ad60c18dfe063c7cd25eb25636fb9f30
    Loom-Build: 0.19.950 72047016af9d66c08f900bb94c642a66dfd75fc5 clean
    [tb_power_divider_n4.sch, tb_power_divider_n64.sch, tb_power_pfd_cp.sch, tb_power_vco.sch]
2026-10-09 chore: resync installed Loom surfaces
    <!-- loom:provenance v1 build=unknown 7f06b288b150f2fe0a4b24c331a9b3ec093d709d clean prompts=none sweep=none story=none trace=a90c217ff3a3bd9e3a30282b8cadc24d host=robb-pro base=6b2c53a21b5873683b462ffa9f35e80f12f821c0 run=loom-run/v1:timer:robb-pro/fleet-resync:6e5ec9f3-d6ef-4953-80f7-c93035e2d359 installs=0.19.966 9bed656320e53ba6c64305daa60613431a7ed02d -->
    Loom-Trace-Id: a90c217ff3a3bd9e3a30282b8cadc24d
    Loom-Build: unknown 7f06b288b150f2fe0a4b24c331a9b3ec093d709d clean
    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
2026-10-09 design: regenerate stale top snapshot and guard hierarchical consistency (#240)
    The embedded loop_filter (R1/C1/C2/C3 sizing) and divider_intN definitions in
    design/top/netlist/top.spice were stale relative to their standalone
    snapshots. Regenerate the top snapshot with xschem and add a PDK-free,
    xschem-free checker comparing each embedded block with its standalone
    snapshot, with unit tests and negative controls. Wire it into check:ci and
    run-pll-layout-flow.sh ahead of record creation; document parent
    regeneration in design/README.md. No sim/ or layout records are touched.
    Loom-Story: 2AMLogic/sky130-pll#240
    Loom-Trace-Id: d4d65a2c9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
2026-10-09 verification: inert guard reproduction for explicit /tmp mktemp templates (part of #239)
    Adds a data-only fixture that feeds the 7-row control matrix plus the
    bounded-template target to the installed guard dispatcher, a dated
    reproduction record (still denies on 1ee7fb0, so blocked on an upstream
    Repo Skills release), and upstream handoff text. No hooks, sim/ records,
    or guard configuration changed.
    Loom-Story: 2AMLogic/sky130-pll#239
    Loom-Trace-Id: 3d705361ee5d8134fd27c5dda705cdb3
    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
2026-10-09 sim: add divider Fmax characterization campaign machinery (part of #244)
    Adds a dedicated frequency-boundary campaign for the standalone divider,
    separate from the fixed-frequency sim/divider* campaigns (unchanged):
    - sim/divider-fmax/testbench/fmax.json declares search bounds, grid
    resolution, modulus set (N=4/5/25/63/64), ideal-input waveform
    assumptions and the per-period correct-division criterion.
    - sim/harness/fmax.py derives CLK period/width, reset, expected division
    period and transient window from one probe frequency; classifies each
    probe PASS / FAIL / INCONCLUSIVE (simulator trouble is never an
    electrical failure); reduces a cell to a verified-pass plus adjacent
    faili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
2026-10-09 signoff: re-pin item 8 to the regenerated characterization report (part of #244)
    The Fmax rollup section added to measurements/report.md changed the
    report's bytes under T1 item 8's pin, failing
    test_envelope_pin_and_live_report_agree. Re-pinned per signoff/README.md
    "Re-pinning":
    - Read the regenerated report: no per-spec-row verdict moved (the new
    section adds no rows and holds no committed Fmax record), so the FAIL
    and no-evidence row lists in the envelope summary are unchanged.
    - The summary's "the report has no Fmax field" is no longer literally
    true; it now says the report's Fmax section holds no committed Fmax
    record yet. Same wording fix in signoff/README.md's item 8 section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
2026-10-09 docs: refresh stale status prose in design/ and sim/ READMEs (#230)
    Replace bootstrap-era absence claims with pointers to the spec,
    measurements report and signoff tier report; correct the deterministic
    jitter statement; keep historical provenance and append-only contracts.
    Loom-Story: 2AMLogic/sky130-pll#230
    Loom-Trace-Id: 60467bfd2c5983aa429eac860b45d9fb
    Loom-Build: 0.19.972 113c7f31d7d16f75d30c470023e0b65b29b1fe94 clean
2026-10-09 sim: add a klt sim batch route for the divider Fmax campaign (part of #244)
    The remote executor needs the SSH fleet, which dispatch workers are not
    provisioned for. Add an executor, selected with --executor batch, that
    submits the campaign through `klt sim --backend batch` (S3 job contract):
    one request per (modulus, supply, frequency chunk) carries one DUT copy per
    probe frequency and the process x temperature matrix as corners. Each
    probe's trace is cut to its own planned window and judged by the unchanged
    per-period criterion. A job-level failure aborts the campaign with the
    diagnostic instead of falling back to local simulation; a single corner
    error is an inconclusive probe. PDK-free te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
2026-10-09 sim: add --klt-jobs to bound concurrent batch submissions (part of #244)
    Loom-Story: 2AMLogic/sky130-pll#244
    Loom-Trace-Id: cf3efd4f29d97d8ae19ab478b75e080c
    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
2026-10-09 sim: retry fleet capacity refusals in the batch Fmax route (part of #244)
    A launch refused for capacity ran nothing, so the same job is resubmitted
    after a wait; persistent refusal still aborts with the diagnostic and never
    falls back to local simulation.
    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
2026-10-09 chore: resync installed Loom surfaces
    <!-- loom:provenance v1 build=unknown 30c7a7ee2f74a6a2b5bb0f19fd9f049ec8ae8b5c clean prompts=none sweep=none story=none trace=7bc5ba399ff199d049d83d711920a157 host=robb-pro base=265dd71455777c3aeeda28d6680219f1ccb56516 run=loom-run/v1:timer:robb-pro/fleet-resync:8e237160-c4d0-4ce3-85ac-c96aff5cf221 installs=0.19.982 2bc4cba624b9053535663441e6f0daf08a7acf2e -->
    Loom-Trace-Id: 7bc5ba399ff199d049d83d711920a157
    Loom-Build: unknown 30c7a7ee2f74a6a2b5bb0f19fd9f049ec8ae8b5c clean
    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
2026-10-09 Add opt-in headless audit bootstrap wrapper (#253)
    scripts/audit-headless.sh provisions Python 3.11 + klayout-tools 0.7.0 with
    uv in a cache venv outside the checkout, then runs npm run check:ci and
    signoff --check in order, stopping at the first failure. Adds fixture tests,
    package.json wiring, and CLAUDE.md/README.md docs.
    Loom-Story: 2AMLogic/sky130-pll#253
    Loom-Trace-Id: 1c9ad3a0a8ddde99888d8e971570b7dc
    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
2026-10-10 chore: resync installed Loom surfaces
    <!-- loom:provenance v1 build=unknown 03c1cb521a10d5101bd8aa2c52a47cebfb0e795b clean prompts=none sweep=none story=none trace=09ccab293fce5c1a7b4aa907c7197bec host=robb-studio base=57da619736599bbfa8013587b4aabc4f990a349f run=loom-run/v1:timer:robb-studio/fleet-resync:ed2be6c5-20fe-4228-a206-940d35a4858f installs=0.19.996 0d2be7e9ae05753e2c9232a83b7399d45de5396e -->
    Loom-Trace-Id: 09ccab293fce5c1a7b4aa907c7197bec
    Loom-Build: unknown 03c1cb521a10d5101bd8aa2c52a47cebfb0e795b clean
    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
2026-10-10 chore: resync installed Loom surfaces
    <!-- loom:provenance v1 build=unknown a7d2b01d8eb7d09e597a4638e5cb3cdd8bab9156 clean prompts=none sweep=none story=none trace=35c1337ee84607e87ba2038523d63198 host=robb-pro base=57da619736599bbfa8013587b4aabc4f990a349f run=loom-run/v1:timer:robb-pro/fleet-resync:6bf32a81-6c4a-48c5-a51e-1ad65c6bedfd installs=0.19.999 20513e3064fa3a7c4b3f1c641d97a00446e9ba78 -->
    Loom-Trace-Id: 35c1337ee84607e87ba2038523d63198
    Loom-Build: unknown a7d2b01d8eb7d09e597a4638e5cb3cdd8bab9156 clean
    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
2026-10-10 sim: add signed charge-pump analysis and synthetic reducers
    Adds sim/harness/cpmeasure.py: a dedicated `cp` manifest block parser,
    deterministic ngspice OP/transient control generation with per-coordinate
    dump names, and pure signed current/charge reducers (per-cycle Qnet/Qplus/
    Qminus, asymmetry, directional plateaus, phase slope, provisional compliance
    window, finer-grid resolution comparison). Unusable dumps yield explicit
    errors or unavailable results that keep their sweep coordinates.
    Synthetic tests (sim/tests/test_cpmeasure.py) cover analytic charge on
    irregular timestamps, boundary interpolation, polarity inversion and phase
    slope. No simulator is required, no spec bounds or physica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
2026-10-10 docs: record charge-pump analysis merge and refresh work plan
2026-10-10 chore: resync installed Loom surfaces
    <!-- loom:provenance v1 build=unknown c156f673e072832aaacb4cd1ec65b742e7f45867 clean prompts=none sweep=none story=none trace=9de99c124c651049199abe9a75070dc7 host=robb-pro base=e6d7d782d07ead8707a46ef67c738d3530bac4eb run=loom-run/v1:timer:robb-pro/fleet-resync:f790885c-7154-4b3d-acd9-71fd537cd20b installs=0.19.1010 d1d5fcecb79550fe39658555a4419f98cec060fb -->
    Loom-Trace-Id: 9de99c124c651049199abe9a75070dc7
    Loom-Build: unknown c156f673e072832aaacb4cd1ec65b742e7f45867 clean
    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
2026-10-10 chore: resync installed Loom surfaces
    <!-- loom:provenance v1 build=unknown 52f79668bb5f93c1828b7f1ea4f7013b917b847b clean prompts=none sweep=none story=none trace=7057f3175071f1f6e34b354fab40a0ce host=robb-studio base=a79a5de76e815d133010bb673b5a7aadf95791d0 run=loom-run/v1:timer:robb-studio/fleet-resync:d8918779-1625-4202-b151-71f64465e8cd installs=0.19.1010 d1d5fcecb79550fe39658555a4419f98cec060fb -->
    Loom-Trace-Id: 7057f3175071f1f6e34b354fab40a0ce
    Loom-Build: unknown 52f79668bb5f93c1828b7f1ea4f7013b917b847b clean
    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
2026-10-10 chore: resync installed Loom surfaces
    <!-- loom:provenance v1 build=unknown 525fe43b7b1b2a0271084bba444c934a1541a8d8 clean prompts=none sweep=none story=none trace=0d4424bd058cf912b74934ec0e7bf37e host=robb-pro base=0bc77e559ded939721eacb1b2305301d9ca88f3d run=loom-run/v1:timer:robb-pro/fleet-resync:4812047c-8b9b-4da2-a5dc-13e6f6420a04 installs=0.19.1018 13e54f1cfc513507a7ef84ec6908085638d9c187 -->
    Loom-Trace-Id: 0d4424bd058cf912b74934ec0e7bf37e
    Loom-Build: unknown 525fe43b7b1b2a0271084bba444c934a1541a8d8 clean
    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
2026-10-10 sim: wire charge-pump analysis through PVT execution and records
    Add `cp` as a third, mutually exclusive analysis branch in the PVT
    runner, CLI validation, checkpoint and record rendering, reusing the
    delivered cpmeasure API (#248) and the existing executor seam.
    - runner: prepare_point/run_point dispatch cp; control block carries the
    per-unit prefix; completion marker and timeout come from the cp block.
    Execution completeness (all dumps present and parseable) decides the
    verdict; unavailable plateaus/windows are reported, not failed.
    Conflicting analysis blocks and cp under --mc are rejected.
    - checkpoint: register the nested CpSweepResult tree so resume restores it.
    - report: stim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
2026-10-10 chore: resync installed Loom surfaces
    <!-- loom:provenance v1 build=unknown 525fe43b7b1b2a0271084bba444c934a1541a8d8 clean prompts=none sweep=none story=none trace=d4059def94f46d8d158946acddd4d602 host=robb-studio base=893bffc225bef3cec5bf596f989cf032224d70c9 run=loom-run/v1:timer:robb-studio/fleet-resync:4a4d1995-968e-44c5-b5fe-804b4d477795 installs=0.19.1019 febfc4335d0554865fadbecba718245cd88c6678 -->
    Loom-Trace-Id: d4059def94f46d8d158946acddd4d602
    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
2026-10-10 docs: record charge-pump integration and refresh active work
2026-10-10 chore: resync installed Loom surfaces
    <!-- loom:provenance v1 build=unknown 5d5f41d89eef35adf478b92b96af06c6d86d27a6 clean prompts=none sweep=none story=none trace=05d2a40831b35ba1c48afada00c29519 host=robb-pro base=70ba685c036cfe6f009c1dd160b67ff87c6f5648 run=loom-run/v1:timer:robb-pro/fleet-resync:c58bb82e-a213-439d-b829-04234e141de9 installs=0.19.1028 48ce8a23fdab3059d078e9fffca79e4d4c911d60 -->
    Loom-Trace-Id: 05d2a40831b35ba1c48afada00c29519
    Loom-Build: unknown 5d5f41d89eef35adf478b92b96af06c6d86d27a6 clean
    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
2026-10-10 chore: resync installed Loom surfaces
    <!-- loom:provenance v1 build=unknown aa536103d6239818bb974a51d2f7f268eff38bad clean prompts=none sweep=none story=none trace=126a1328a3664e2119a0978086db9bea host=robb-studio base=e41213f5ee102c8d4784f5894ae88cbb460c25ef run=loom-run/v1:timer:robb-studio/fleet-resync:fbc4e361-e290-4d81-ae3a-8b5fde796815 installs=0.19.1032 13ca937a7d6ba8768c296b0c126f2ce48f5f7ca4 -->
    Loom-Trace-Id: 126a1328a3664e2119a0978086db9bea
    Loom-Build: unknown aa536103d6239818bb974a51d2f7f268eff38bad clean
    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
2026-10-11 sim: add pfd-cp campaign testbench, manifest and nominal resolution record
    Adds the standalone PFD/charge-pump campaign contract (sim/pfd-cp) and a
    separately identified nominal finer-grid diagnostic (sim/pfd-cp-resolution)
    built on the cp analysis branch, with manifest-contract tests.
    The 45-point grid was not run: the generic harness has no batch route (its
    remote executor silently falls back to local) and one nominal point costs
    about nine CPU-hours. The single nominal diagnostic ran locally and is
    recorded as a failure (ngspice 'Timestep too small' at xx1.rstpre in the
    2.5 ps +/-0.1 ns transients), kept as-is. DESIGN.md states that no measured
    values exist yet; the DUT and spec are unch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
2026-10-11 signoff: re-pin item 8 to regenerated measurements/report.md
    The report gained the pfd-cp-resolution row (a FAIL diagnostic that
    measures no spec row) and new scan counts, changing the digest item 8
    pins. Re-read the report, note the diagnostic FAIL in the envelope
    summary, re-pin README/manifest/envelope, and re-render tier-report.json
    with klt 0.7.0 (release build).
2026-10-11 chore: resync installed Loom surfaces
    <!-- loom:provenance v1 build=unknown cf08873555e2eb95da295dcbee98b0dc34473381 clean prompts=none sweep=none story=none trace=67fbc483c3ca3e442d7928804c11ff06 host=robb-pro base=092aca6e88b489079ee2def5eb669c433a2d7391 run=loom-run/v1:timer:robb-pro/fleet-resync:e3f97888-2b26-404a-bd47-86fd28a4eced installs=0.19.1041 b65c266b47d796bf37d1c04c6f616be0bc699056 -->
    Loom-Trace-Id: 67fbc483c3ca3e442d7928804c11ff06
    Loom-Build: unknown cf08873555e2eb95da295dcbee98b0dc34473381 clean
    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
2026-10-11 chore: resync installed Loom surfaces
    <!-- loom:provenance v1 build=unknown e91831edf7b55b29d3a2d88e266916fab9ce2563 clean prompts=none sweep=none story=none trace=f72dd67520a2c3802aa0495b80ac65a5 host=robb-studio base=1b89798e892b20d0a8bfff82a40649249592a3f6 run=loom-run/v1:timer:robb-studio/fleet-resync:91d2434e-eae5-45de-9305-d78c43fc7c7a installs=0.19.1042 5b6ebdcc40bfccc9357e15196984061f1d5e6178 -->
    Loom-Trace-Id: f72dd67520a2c3802aa0495b80ac65a5
    Loom-Build: unknown e91831edf7b55b29d3a2d88e266916fab9ce2563 clean
    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
2026-10-11 docs(sim/pfd-cp): record klayout-tools#3097 as the batch-route blocker for the full grid
    Loom-Story: 2AMLogic/sky130-pll#250
    Loom-Trace-Id: 8b9655eb9163d558cbfdb5131ef36f31
    Loom-Build: 0.19.1039 e83d19dc0a9b217339ea2f14040c50ad6f46700d clean
2026-10-11 chore: resync installed Loom surfaces
    <!-- loom:provenance v1 build=unknown 5ec729b9f7dd55a2082752611e4c4964f49661fb clean prompts=none sweep=none story=none trace=efc2abc8b72538df6d1a6ea9d329603d host=robb-pro base=e7e371801470e656bcea0e152f015d1ed741dccf run=loom-run/v1:timer:robb-pro/fleet-resync:0d396c06-f26e-423e-97ac-6d3ac04a8e51 installs=0.19.1054 f6a73bc7fc942d7b297514b2e3f57a0ca2076010 -->
    Loom-Trace-Id: efc2abc8b72538df6d1a6ea9d329603d
    Loom-Build: unknown 5ec729b9f7dd55a2082752611e4c4964f49661fb clean
    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
2026-10-11 chore: resync installed Loom surfaces
    <!-- loom:provenance v1 build=unknown 745f69d0daad6c23e76cc006720fa4fbeaa3d887 clean prompts=none sweep=none story=none trace=3baabc4a039fd85029fff227a6ae690a host=robb-studio base=41e7714ded3e967cf439702c5ce2a06f906859da run=loom-run/v1:timer:robb-studio/fleet-resync:3b3207d7-055d-49b5-a387-db375213668d installs=0.19.1060 3336676408ee1d4f1df2dc7f23adbb6c3170674e -->
    Loom-Trace-Id: 3baabc4a039fd85029fff227a6ae690a
    Loom-Build: unknown 745f69d0daad6c23e76cc006720fa4fbeaa3d887 clean
    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
2026-10-11 chore: resync installed Loom surfaces
    <!-- loom:provenance v1 build=unknown b37a005ac1889262fb9e5338f7cff4e9ed4987da clean prompts=none sweep=none story=none trace=25c158d7e9591610b251780caaff1c5f host=robb-pro base=3ed9b39d97fb35b4457c7d6c62dca0d3536aa274 run=loom-run/v1:timer:robb-pro/fleet-resync:7f020bca-6920-47f7-a5e4-bbd5c82d9bb8 installs=0.19.1072 29b48db1ead9c4501304e0114a5c33310e1d589f -->
    Loom-Trace-Id: 25c158d7e9591610b251780caaff1c5f
    Loom-Build: unknown b37a005ac1889262fb9e5338f7cff4e9ed4987da clean
    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
2026-10-11 chore: resync installed Loom surfaces
    <!-- loom:provenance v1 build=unknown 81a6b4499cb57b3620785bc1625c300da34f0735 clean prompts=none sweep=none story=none trace=d08bbd290651d7bcbda8b216c0dfbcdf host=robb-studio base=12bec98198f9166f5eb8a8ecd2fdb96d0ad737f2 run=loom-run/v1:timer:robb-studio/fleet-resync:71e05e3d-931c-46b4-b6d2-5f3f992c1e19 installs=0.19.1073 abb0872ba7d1d3f6f3a14f71f51a562e89308181 -->
    Loom-Trace-Id: d08bbd290651d7bcbda8b216c0dfbcdf
    Loom-Build: unknown 81a6b4499cb57b3620785bc1625c300da34f0735 clean
    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
2026-10-12 chore: resync installed Loom surfaces
    <!-- loom:provenance v1 build=unknown ddfb67ccf9a5115d62dd86924613a468b9328f44 clean prompts=none sweep=none story=none trace=772605234b9d8cafd6a4049200f7425c host=robb-pro base=ba8431d219a34c88648e3a93bc3b7715d494c243 run=loom-run/v1:timer:robb-pro/fleet-resync:1ef28ffc-0277-424f-9224-7ee6eca46377 installs=0.19.1083 77a174ea7fcaddbb25d0082956cd25d8633fc2df -->
    Loom-Trace-Id: 772605234b9d8cafd6a4049200f7425c
    Loom-Build: unknown ddfb67ccf9a5115d62dd86924613a468b9328f44 clean
    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
2026-10-12 chore: resync installed Loom surfaces
    <!-- loom:provenance v1 build=unknown be358990895362019614bd207bcbe36bc9eeff2c clean prompts=none sweep=none story=none trace=f1dc643b95859c8f26e892ddb5e2c5d7 host=robb-studio base=ce141a4ed0214877e54a98730ee244014aeb8311 run=loom-run/v1:timer:robb-studio/fleet-resync:da486ca2-3e94-4a85-abd3-88707942489a installs=0.19.1086 d8cb20101a985145fb167c1933758075a14ce1ab -->
    Loom-Trace-Id: f1dc643b95859c8f26e892ddb5e2c5d7
    Loom-Build: unknown be358990895362019614bd207bcbe36bc9eeff2c clean
    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
2026-10-12 chore: resync installed Loom surfaces
    <!-- loom:provenance v1 build=unknown a579728c137cc11d08a48b178e0ff9aa21683e72 clean prompts=none sweep=none story=none trace=10832f2750dbcd63f6c6f301a6f4da9b host=loom-worker-2 base=bafb5e492b92f6fd4e03c2ac64da3100ffaf8188 run=loom-run/v1:timer:loom-worker-2/fleet-resync:180f6d5054f0479ab3990b86ab4522a5 installs=0.19.1087 51ac271f990b317a52ebf27cc21f34561e1179fb -->
    Loom-Trace-Id: 10832f2750dbcd63f6c6f301a6f4da9b
    Loom-Build: unknown a579728c137cc11d08a48b178e0ff9aa21683e72 clean
    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
2026-10-12 sim: define LOCK timing measurement schema and reducer (#273)
    Part of #259.
    Loom-Story: 2AMLogic/sky130-pll#273
    Loom-Trace-Id: 56a9df7274038d7ac5a1011c5a210c1a
    Loom-Build: 0.19.1081 6966a93d1cd1b005f2a6b22bf9691ade8793ed73 clean
2026-10-12 chore: resync installed Loom surfaces
    <!-- loom:provenance v1 build=unknown 02ecafe7734bf5faa945ce88940589f00eca78e9 clean prompts=none sweep=none story=none trace=5f71c537126994dc4c45179122427514 host=robb-pro base=24918a3d1fc1fc6a017c0cb3c53ce885bf7aa0ae run=loom-run/v1:timer:robb-pro/fleet-resync:6293e6da-8a67-45aa-b277-c9ef85ddb810 installs=0.19.1101 27422582cd2d34d8ed5f60ce987007bc4bd61081 -->
    Loom-Trace-Id: 5f71c537126994dc4c45179122427514
    Loom-Build: unknown 02ecafe7734bf5faa945ce88940589f00eca78e9 clean
    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
2026-10-12 chore: resync installed Loom surfaces
    <!-- loom:provenance v1 build=unknown 5918da96dcd60c9a677a195737c86ea38972d215 clean prompts=none sweep=none story=none trace=49bb7a8942d6a23bf41754ca27ff2368 host=loom-worker-2 base=36bef0b6d81a3eec67919ad420acd43f6b883607 run=loom-run/v1:timer:loom-worker-2/fleet-resync:2e973f04abd1447d8ee4b696c2e7d2b4 installs=0.19.1108 72427939d156341080a7006ae6fbb5ec96b2368e -->
    Loom-Trace-Id: 49bb7a8942d6a23bf41754ca27ff2368
    Loom-Build: unknown 5918da96dcd60c9a677a195737c86ea38972d215 clean
    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
2026-10-12 chore: resync installed Loom surfaces
    <!-- loom:provenance v1 build=unknown 01467247f32c59822968bf02d3214d9a3d613452 clean prompts=none sweep=none story=none trace=0e97e9733eef09a33959cf96e6271f40 host=robb-studio base=463c216db9759a5f938bbac6fe24e98c0322d9d4 run=loom-run/v1:timer:robb-studio/fleet-resync:53a4d390-3842-4216-9018-5dced9d0ea17 installs=0.19.1109 d9498fcd419776b2517e30b99c88e76bbe92d2f4 -->
    Loom-Trace-Id: 0e97e9733eef09a33959cf96e6271f40
    Loom-Build: unknown 01467247f32c59822968bf02d3214d9a3d613452 clean
    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
2026-10-12 sim: add fixed-stimulus batch runner for LOCK timing primitives (#274)
    Loom-Story: 2AMLogic/sky130-pll#274
    Loom-Trace-Id: a3d77246a85aa0fd9e006c6296cb48ef
    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
2026-10-12 sim: assert nominal LOCK timing record stays a labelled subset (#274)
    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
2026-10-12 chore: resync installed Loom surfaces
    <!-- loom:provenance v1 build=unknown acadc2b4b0e852f2d889ac9dec616e1548705802 clean prompts=none sweep=none story=none trace=a69edb348af7f0e67b3bc77bc33b1bfc host=loom-worker-2 base=6aeb6f0d2a0d8b078fbeea53ed34dc0915aead9b run=loom-run/v1:timer:loom-worker-2/fleet-resync:0923627ffda84cf69ec2486475772b10 installs=0.19.1126 7736d1276b6d01778fba3461114c858ef1bf5e2d -->
    Loom-Trace-Id: a69edb348af7f0e67b3bc77bc33b1bfc
    Loom-Build: unknown acadc2b4b0e852f2d889ac9dec616e1548705802 clean
    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
2026-10-12 chore: resync installed Loom surfaces
    <!-- loom:provenance v1 build=unknown 8d832cc8035d4ba07872510416468da0790332cd clean prompts=none sweep=none story=none trace=09a53bf60e96fc30a753caffd1de8c92 host=robb-studio base=ea1b5760f32fad97ee3bf7cbf6e3f2365e68d0b7 run=loom-run/v1:timer:robb-studio/fleet-resync:baf4c30c-65d9-4d4e-a740-f6a80cbb975c installs=0.19.1132 8695bdd2b7b963dca9b76f4643a9d7c744294426 -->
    Loom-Trace-Id: 09a53bf60e96fc30a753caffd1de8c92
    Loom-Build: unknown 8d832cc8035d4ba07872510416468da0790332cd clean
    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
2026-10-12 sim: accept klt exit 4 for waveform-only LOCK timing requests (#275)
    The LOCK timing runner asks klt for raw traces and declares no klt
    measurements. A real batch run then exits 4 ("nothing checked") with the
    single reason no_requested_measurements, which the runner had recorded as a
    simulator failure. Exit 4 is now usable only when the report gives exactly
    that reason and every corner passed; any other exit-4 report still fails.
    Loom-Story: 2AMLogic/sky130-pll#275
    Loom-Trace-Id: f5e42257e3dd06c79beb2f533779e1e5
    Loom-Build: 0.19.1127 8279ae55971d200a6d077f99ea5d147e5b44283d clean
2026-10-12 design: phase-window delay-chain candidates, smoke and control (#275)
    Adds two sky130_fd_sc_hd delay-chain candidates for the provisional LOCK
    detector's acquisition and release phase windows (7/18 x clkdlybuf4s50_1 and
    14/39 x clkdlybuf4s25_1), their generator, schematic, DUT netlist, testbench
    stimulus and reducer manifests for both edge polarities, plus three
    append-only batch records: the first nominal smoke (failed on klt exit 4),
    its superseding smoke (W_acq 2.710 ns, W_rel 6.853 ns at tt/27C/1.8V) and a
    sub-threshold negative control that reduces to ABSENT_CROSSING.
    The full PVT grid records are not part of this commit.
    Loom-St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
2026-10-12 chore: resync installed Loom surfaces
    <!-- loom:provenance v1 build=unknown aa1ed0d7d5499d2705977d971673d919dbbbaf4e clean prompts=none sweep=none story=none trace=2522608826ef5d5e4a88a9667055aeb7 host=loom-worker-2 base=ba495390aeaa67435397e31db3a628a42ff1c36f run=loom-run/v1:timer:loom-worker-2/fleet-resync:8f26b719c712455381744111c50e90b4 installs=0.19.1142 b91ae5d1b5204f499a1abb875a6cf5bffc1d90b1 -->
    Loom-Trace-Id: 2522608826ef5d5e4a88a9667055aeb7
    Loom-Build: unknown aa1ed0d7d5499d2705977d971673d919dbbbaf4e clean
    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
2026-10-12 sim: full PVT grids for phase-window delay chains, no candidate meets bands (#275)
    Four complete 45-point records (s50/s25 x rising/falling). Measured miss
    recorded; bands and DR-007 unchanged.
    Loom-Build: 0.19.1137 240bb1a888bb79770ecc3acbc19c6425468fedca clean
    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
2026-10-12 docs(lockdet-timing): fleet note reports klt exit 4, not exit 0 (#275)
    All 12 grid jobs in the four full-PVT records have exit_code 4 (klt
    "nothing checked", no_requested_measurements), accepted as waveform-only
    by locktiming_cli.waveform_only_exit. Correct the README fleet note to
    match the records. No record, spec, band or result changed.
    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
2026-10-12 chore: resync installed Loom surfaces
    <!-- loom:provenance v1 build=unknown 8b64614d017d6ce7491c3a2ac9da51e5e2901c97 clean prompts=none sweep=none story=none trace=66044c049ba635bcd6a4797c3a77e84b host=robb-pro base=20334af012f909f25cfab734bfcb38d40f522be4 run=loom-run/v1:timer:robb-pro/fleet-resync:68f56594-05d0-4cc0-9c07-36263359d698 installs=0.19.1144 9e4381cbbd2386393e44c7a979583252948a3998 -->
    Loom-Trace-Id: 66044c049ba635bcd6a4797c3a77e84b
    Loom-Build: unknown 8b64614d017d6ce7491c3a2ac9da51e5e2901c97 clean
    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
2026-10-13 chore: resync installed Loom surfaces
    <!-- loom:provenance v1 build=unknown e66f00108a9519331aa981da8a01c6569ca623a9 clean prompts=none sweep=none story=none trace=d3e476cf8c03d5ed37f8e146b3632190 host=robb-studio base=73b7f235ec00de12409775e304b2e7895469fd77 run=loom-run/v1:timer:robb-studio/fleet-resync:1d7ace45-2daf-4c92-a752-67b11e982245 installs=0.19.1146 972552531e3e890528f13c6cc8fb7406877c96f9 -->
    Loom-Trace-Id: d3e476cf8c03d5ed37f8e146b3632190
    Loom-Build: unknown e66f00108a9519331aa981da8a01c6569ca623a9 clean
    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
2026-10-13 chore: resync installed Loom surfaces
    <!-- loom:provenance v1 build=unknown 98d08ab78cc223361354ee9947d996b1cb914b30 clean prompts=none sweep=none story=none trace=8b73addcdeaa8fbd65998649f42a8c50 host=loom-worker-2 base=098f8200d4a82bd0ba6660d8b99ac61b98730d38 run=loom-run/v1:timer:loom-worker-2/fleet-resync:3bfb13d52fca425f9cfced4541954cb6 installs=0.19.1148 1448fdfa79ac2dcab7fad6b95b72697b450f2a4a -->
    Loom-Trace-Id: 8b73addcdeaa8fbd65998649f42a8c50
    Loom-Build: unknown 98d08ab78cc223361354ee9947d996b1cb914b30 clean
    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
2026-10-13 chore: resync installed Loom surfaces
    <!-- loom:provenance v1 build=unknown d0bfbbc7ac309581d7abe02c4a269c7704010ee0 clean prompts=none sweep=none story=none trace=0ad6d167235000f3b5648cbd63d761ce host=robb-pro base=1184cc90ba293424c57bba4185a9bcc83fd0cbd4 run=loom-run/v1:timer:robb-pro/fleet-resync:4f7cbe22-40b6-49ff-8811-003ae8577c28 installs=0.19.1151 021b947d121929157cd83df0576e7f2aa12500d7 -->
    Loom-Trace-Id: 0ad6d167235000f3b5648cbd63d761ce
    Loom-Build: unknown d0bfbbc7ac309581d7abe02c4a269c7704010ee0 clean
    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
2026-10-13 design: watchdog primitive, nominal smoke, controls and partial timing handoff (#276)
    Adds the independent ring/divider watchdog generator, nominal and negative-control
    records, a reducer-based combined grade, and design/lock-detector/DESIGN.md.
    The 45-point watchdog grid is NOT complete (model abort at ss for the first
    candidate, client memory limit for the second); the handoff is recorded as not ready.
    Loom-Story: 2AMLogic/sky130-pll#276
    Loom-Trace-Id: 309053f5673e05ac33931d11deab9d92
    Loom-Build: 0.19.1148 1448fdfa79ac2dcab7fad6b95b72697b450f2a4a clean
2026-10-13 chore: resync installed Loom surfaces
    <!-- loom:provenance v1 build=unknown 7916c4043a1b57e97a53bc5c111e74c5038a1091 clean prompts=none sweep=none story=none trace=20b27ffb08c4130dc9836ee8d9d97b97 host=loom-worker-2 base=b43bda414673a23aeb823598df0e4f67fe3c7128 run=loom-run/v1:timer:loom-worker-2/fleet-resync:d34532ec625a4162ae8b58dde1a6738f installs=0.19.1151 f7d1deaab02a9c483fce1ced33fadb1af6d86f59 -->
    Loom-Trace-Id: 20b27ffb08c4130dc9836ee8d9d97b97
    Loom-Build: unknown 7916c4043a1b57e97a53bc5c111e74c5038a1091 clean
    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
2026-10-13 chore: resync installed Loom surfaces
    <!-- loom:provenance v1 build=unknown ac0bbcf6eda99918e88a0b8893d9762b106a2e45 clean prompts=none sweep=none story=none trace=8597ab8a51d68f9f8ee864fa71904bff host=robb-studio base=761487426cb16b733836fa1cc65a4a93ddfdeb15 run=loom-run/v1:timer:robb-studio/fleet-resync:2ea9dd71-a6b2-4d0c-86aa-859a0728c9b3 installs=0.19.1151 f7d1deaab02a9c483fce1ced33fadb1af6d86f59 -->
    Loom-Trace-Id: 8597ab8a51d68f9f8ee864fa71904bff
    Loom-Build: unknown ac0bbcf6eda99918e88a0b8893d9762b106a2e45 clean
    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
2026-10-13 chore: resync installed Loom surfaces
    <!-- loom:provenance v1 build=unknown 7916c4043a1b57e97a53bc5c111e74c5038a1091 clean prompts=none sweep=none story=none trace=99a9d442e177e2a14f9fe891925a70a9 host=loom-worker-1 base=5d78188f472aa6a3dff3343530ed20e7a7137e51 run=loom-run/v1:timer:loom-worker-1/fleet-resync:c61893183c38452a8cff7a1b196057af installs=0.19.1151 f7d1deaab02a9c483fce1ced33fadb1af6d86f59 -->
    Loom-Trace-Id: 99a9d442e177e2a14f9fe891925a70a9
    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
2026-10-13 chore: resync installed Loom surfaces
    <!-- loom:provenance v1 build=unknown 7916c4043a1b57e97a53bc5c111e74c5038a1091 clean prompts=none sweep=none story=none trace=773e9e41a5730d2f79f2381ad2cde068 host=robb-pro base=5d624bc7e5c56fb87f5a7e6be2ac058d7a020d29 run=loom-run/v1:timer:robb-pro/fleet-resync:b7ca0d34-434e-4536-85b9-57adfa603a8d installs=0.19.1151 1ec34f9bb79942506958a3c18a31368f4e065508 -->
    Loom-Trace-Id: 773e9e41a5730d2f79f2381ad2cde068
    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
2026-10-13 chore: resync installed Loom surfaces
    <!-- loom:provenance v1 build=unknown f57244868aa20ef22c18aa8025972184aaea43e4 clean prompts=none sweep=none story=none trace=8e03b78fe6cb43a017c4a4823362ffa7 host=loom-worker-2 base=c61908cc07fbc3324ab3d3b937edc1a615929771 run=loom-run/v1:timer:loom-worker-2/fleet-resync:eb553d2fc2a54589aa37879f12b18ed5 installs=0.19.1151 4b3b3e77e5ef42971b3c0c3e68c000736a0c7c21 -->
    Loom-Trace-Id: 8e03b78fe6cb43a017c4a4823362ffa7
    Loom-Build: unknown f57244868aa20ef22c18aa8025972184aaea43e4 clean
    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
2026-10-13 chore: resync installed Loom surfaces
    <!-- loom:provenance v1 build=unknown f91cd239df41290ba3efb8bc14320984e3392c6f clean prompts=none sweep=none story=none trace=c1345a24765b7e1c5307ef032fd77486 host=loom-worker-3 base=7171ccdd098f88abf94b81f19b53d6248194ee3f run=loom-run/v1:timer:loom-worker-3/fleet-resync:c4883600330b4d70afac9e743a4e52e3 installs=0.19.1151 a9d9bfc13e966655d6d847cb6876af523bc4a4c4 -->
    Loom-Trace-Id: c1345a24765b7e1c5307ef032fd77486
    Loom-Build: unknown f91cd239df41290ba3efb8bc14320984e3392c6f clean
    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
2026-10-13 chore: resync installed Loom surfaces
    <!-- loom:provenance v1 build=unknown 6fe43c87955e02019c2bc8dfad4fbd160b89170c clean prompts=none sweep=none story=none trace=49a4590bf54e81899c26d965f682504c host=robb-studio base=acc9eaeaef33c8aee1fff4a01610e6b45cc9532a run=loom-run/v1:timer:robb-studio/fleet-resync:459197b3-0050-4335-893e-e47b638eb819 installs=0.19.1151 c6a7b6acb1e186314d3252e9e96b6ae903e74a1c -->
    Loom-Trace-Id: 49a4590bf54e81899c26d965f682504c
    Loom-Build: unknown 6fe43c87955e02019c2bc8dfad4fbd160b89170c clean
    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
2026-10-13 design: wdb watchdog nominal, split-temp runner and incomplete-grid evidence (#276)
    Selected candidate wdb (nand2 + 29 x buf_1 ring, /64 dfrbp divider): nominal
    physical record (raw 3.470 ns, tick 222.1 ns), EN-low control, and an
    all-45-SIM_FAILED full-grid attempt kept as explicit evidence. Runner gains
    --split-temps and a netlist-only save mode to avoid multi-GB artifacts.
    The complete 45-point grid is still missing (runner has no resume; fleet
    ceiling), so #276 stays open and #260 stays blocked.
    Part of #276
    Loom-Build: 0.19.1151 08ee0f8708464aa8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
2026-10-13 chore: resync installed Loom surfaces
    <!-- loom:provenance v1 build=unknown 5dc3a07d084d0ec4034f0782d572925dcad86af7 clean prompts=none sweep=none story=none trace=cbc11657acadf58858409fe543c342e1 host=robb-pro base=caecbac8173867bd1adc1bd0c79f16217d622280 run=loom-run/v1:timer:robb-pro/fleet-resync:be586137-d91e-4e2c-82d6-3164d43aa9de installs=0.19.1152 2d5fe17958dca799058f16bdd74a12336990bec0 -->
    Loom-Trace-Id: cbc11657acadf58858409fe543c342e1
    Loom-Build: unknown 5dc3a07d084d0ec4034f0782d572925dcad86af7 clean
    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
2026-10-13 runner: append-only per-group records, --resume, --max-groups (#276)
    Loom-Build: 0.19.1152 2d5fe17958dca799058f16bdd74a12336990bec0 clean
    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
2026-10-13 chore: resync installed Loom surfaces
    <!-- loom:provenance v1 build=unknown 27a266d5a27885323290840d2a837d73fcf4bcc6 clean prompts=none sweep=none story=none trace=e77cdd5477ef6bfc65fba6cc233788e0 host=loom-worker-2 base=d538b855e202075b4bc0c4b14853cb25659866ec run=loom-run/v1:timer:loom-worker-2/fleet-resync:7fac7d82f298441a91761382ac989183 installs=0.19.1152 8d16eec5f10d705602ac4d1ab871c57266f1aa45 -->
    Loom-Trace-Id: e77cdd5477ef6bfc65fba6cc233788e0
    Loom-Build: unknown 27a266d5a27885323290840d2a837d73fcf4bcc6 clean
    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
2026-10-13 chore: resync installed Loom surfaces
    <!-- loom:provenance v1 build=unknown f2b62a2cf576d7d37092147b2281da809f8b5cf5 clean prompts=none sweep=none story=none trace=8adfa75521c72dded43e2932febb6329 host=loom-worker-3 base=6daf6534baac6108ad7fcb18a3a9fef7804d6f17 run=loom-run/v1:timer:loom-worker-3/fleet-resync:8a8198f8f80e4703bc7365a5e10595e0 installs=0.19.1152 a7c20e591a04d4acaeeca29fadd7fa4be7ca3122 -->
    Loom-Trace-Id: 8adfa75521c72dded43e2932febb6329
    Loom-Build: unknown f2b62a2cf576d7d37092147b2281da809f8b5cf5 clean
    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
2026-10-13 runner: --only filter, failure reason names simulator diagnostics; first group records (#276)
    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
2026-10-13 chore: resync installed Loom surfaces
    <!-- loom:provenance v1 build=unknown 84d11f248d368cae5e04a2255f6897a406c50089 clean prompts=none sweep=none story=none trace=8e50b4ccc3dc58f709a732f69d58fd44 host=robb-studio base=ffdd171cecb7a45e5673e9eb129b3bae17e80611 run=loom-run/v1:timer:robb-studio/fleet-resync:05c9f3b1-eee2-412f-8996-5fbf02793d9e installs=0.19.1153 d8429a4fabdc955107af1cbc22c548e23eecf9b1 -->
    Loom-Trace-Id: 8e50b4ccc3dc58f709a732f69d58fd44
    Loom-Build: unknown 84d11f248d368cae5e04a2255f6897a406c50089 clean
    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
2026-10-14 design: wdb resumed-grid outcome (1 of 9 groups good), group records, DESIGN update (#276)
    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
2026-10-15 loom: unpin verdict-staleness-guard.sh (2am#4345 Q7)
    Each pin here was a stopgap until an upstream fix landed, and each fix
    has now landed upstream:
    - scripts/verdict-staleness-guard.sh (#78/#79, the unsupported `merged`
    JSON field): upstream requests state-only since rjwalters/loom#6799.
    Keeping the pins stopped being harmless. The pinned
    verdict-staleness-guard.sh missed later hardening of the merge-safety
    verdict check: #9258 (an unmarked approval is STALE), #9548 (trusted
    markers only) and #9576 (tree-equality FRESH). It also failed this
    repo's own test-verdict-staleness-guard.sh and -tree.sh. The upstream
    files pass them (319/319, 36/36).
    The pins are removed, the files are replace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
2026-10-15 sim/harness: add a klt sim decks[] batch executor for the cp campaign
    The cp analysis owns a per-coordinate .control block that klt sim corner
    requests cannot express, so it had no route to the Spot batch fleet. Add
    an --executor batch backend that submits one decks[] entry per PVT point
    and reduces the returned dumps with the unchanged cpmeasure reducer.
    Route cp manifests there automatically when KLT_SIM_BACKEND=batch, refuse
    --executor remote for cp on such a host, and never fall back to local.
    Loom-Story: 2AMLogic/sky130-pll#290
    Loom-Trace-Id: 43d89b16f422f0b96dfbda2ed4b5ee2a
    Loom-Build: 0.19.1162 f1ee755eeca1954f35bf83d19f4b84ad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
2026-10-15 docs+sim: record the cp batch route, its fleet-runner blocker and name the unsupported-runner case
    The one-deck probe on the real fleet failed because the runner's klt
    rejects decks[] requests; report that explicitly instead of as a generic
    batch job failure, and document the route and its status.
    Loom-Build: 0.19.1162 f1ee755eeca1954f35bf83d19f4b84ad51feb9f5 clean
    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
2026-10-15 build: re-pin open_pdks to f6eeac7 and resolve the PDK via ciel with a SOURCES revision check
    Loom-Story: 2AMLogic/sky130-pll#296
    Loom-Trace-Id: 3db0eff66ec4b1031af0bc74ac13e038
    Loom-Build: 0.19.1166 8a9aad12e32504cea9a7c7d2ed774749c487f875 clean
2026-10-15 sim: shard the power campaign to fit the batch fleet's 3600 s job ceiling (part of #233)
    klt sim --hosts only shards local backends, and the unsharded pfd-cp request
    ran to the fleet ceiling. shard.py partitions each 45-point request into
    per-process (per process x supply for divider-n64) requests with a per-point
    timeout whose serial bound fits the ceiling; mint.py merges shard reports and
    refuses duplicated PVT points. Grid, stimulus and averaging windows unchanged.
    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
2026-10-15 design: add buffered CLK output stage, DR-008 load contract and output-level measurement
    Insert a two-inverter output buffer (design/clk-buf) between the VCO node
    and the exported CLK pin, leaving the feedback divider on the VCO node.
    DR-008 fixes the provisional 1 pF CLK characterization load and the bounded
    regression set; rows 14/15 stay DRAFT. Add a measure.levels reducer
    (V_OH/V_OL), the sim/clk-output and sim/vco-buffered testbenches, and the
    1 pF load on the three paired closed-loop testbenches.
    Part of #232
    Loom-Story: 2AMLogic/sky130-pll#232
    Loom-Trace-Id: 75ad4d37045b03d369a264514f223051
    Loom-Build: 0.19.1166 8a9aad12e3250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
2026-10-15 sim: regenerate loop-filter sensitivity variants for the buffered top, update layout plan test
    The lf-c1/lf-c2 sensitivity arms are derived from design/top/top.sch, which
    now instantiates the CLK buffer; regenerate them with their generators (the
    drift tests require it). The layout plan test counts the top-level block
    instances, now five.
    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
2026-10-17 refactor(sim): share klt batch capacity-retry submit across fmax, cp and locktiming runners
    Closes #314
2026-10-17 refactor(sim): share SPICE-literal and floor-netlist parsing across analysis scripts
    Move spice_literal, the pulse/tran/jitter regexes, per-point netlist lookup,
    the pulse-floor point reader and pwl_points into sim/analysis_common.py and
    drop the per-script copies. Restated outputs are byte-identical.
2026-10-17 refactor: share parse_floor_record via sim/analysis_common
    The jitter-floor record parser, its variant regex and the PVT header were
    copied into three sim/*/analysis scripts. Keep one copy in analysis_common
    (returning the superset dict) and import it; no sim record is touched.
2026-10-17 feat(signoff): declare partition boundary and inventory items 1, 9, 10
    Add partition_boundary to the block manifest, commit one provisional
    inventory per attested item, and record the decision to wait for a klt
    release containing signoff --attest (absent in the 0.7.0 pin).
    Part of #329
2026-10-17 docs: update WORK_PLAN from current label state
    Automated document maintenance by Guide triage agent.
2026-10-18 docs: update WORK_PLAN from current label state
2026-10-20 sim: add PDK-free behavioral study of the proposed I/Q /2 and correct its proposal
    Event model, case matrix, tests and an append-only record show the
    CLK90 lag is 180*D degrees (conditional on input duty and flop path
    match), not exact by construction. Proposal and DR-010 corrected
    (Kvco, edge counting, reset/alignment); DR-010 stays Proposed.
    Report hash re-pinned in signoff after the aggregate gained a row.
    Part of #332
    Loom-Issue: 2AMLogic/sky130-pll#344
2026-10-20 docs: add proposed Stage A campaign request for the 500 MHz feasibility plan
    Part of #333. Documents the oscillator/divider screening matrix, bench
    mismatches (no N=20 modulus, 800 MHz search floor, no divider-fmax record),
    named runtime/cost unknowns, stop conditions and an operator authorization
    gate. Proposed and unexecuted; no spec row touched.
2026-10-20 refactor: remove dead locals and unused imports in power generators and tests
    Drop the never-read specs/stop_s/entries/line_start/vi locals, a no-op
    loop in at_250, and unused subprocess/math imports (ruff F401/F841).
2026-10-20 docs: add 0.95 V VCTRL point to proposed Stage A VCO matrix
    Brackets the 500 MHz crossing at the 19 of 45 PVT points where it lies
    in 0.9-1.0 V. Added measurements 135 -> 180 (total 450); reduced
    fallback 9 -> 12. Stop conditions unchanged; doc stays proposed.
    Closes #347
2026-10-20 feat: add N=20 divider bench and mandatory-probe Stage A Fmax configuration
    Add sim/divider-n20 (NSEL[5:0]=010011, N-1 = 19 per the divider's decode)
    and a separate fmax-stage-a-500mhz.json that declares N=20 and an explicit
    mandatory 500 MHz probe. The Fmax driver now unions declared
    `mandatory_probes_hz` into stage 1 of every cell, reports each probe's
    verdict apart from the boundary (FAIL vs INCONCLUSIVE vs not run), and
    fails the record unless every mandatory probe passed. Manifests without
    the key plan exactly as before; fmax.json and all records are untouched.
    Correct docs/500mhz-stage-a-campaign-request.md (four added VCTRL values,
    ten-value sweep, unique versus recomputed measuremen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
2026-10-23 feat: store run evidence bytes in the artifact store, commit manifest and record
    Route the corner runner and fmax runner through a fail-closed writer that
    puts raw logs, patched netlists and the netlist snapshot into the fleet
    artifact store (klt artifact put) and commits only a manifest plus the
    Markdown record. Adds DR-012, a stdlib manifest checker wired into
    check:ci, and tests for the checker and the writer's fail-closed paths.
    Work now stages under the git-ignored sim/build/ tree. Existing records
    and history are untouched.
    Writer and checker ported from 2AMLogic/sg13g2-comparator at b46d54af.
2026-10-23 feat: store PLL layout flow outputs in the artifact store, commit manifest and record
    The flow stages GDS, extracts, envelopes and renders in git-ignored
    layout/pll/build/, puts them through klt artifact put, and commits only
    manifests/artifacts/layout-pll-<id>.manifest.json and record.md. It fails
    closed when the store is unavailable. The manifest checker now accepts
    layout/ names.
2026-10-23 feat: store LOCK timing group bytes in the artifact store, keep manifests and JSON records
    Each finished group's request, body netlist, report and stderr are staged
    under sim/build/ and stored with klt artifact put; git keeps the group
    record and a per-group manifest named in jobs[].evidence_manifest. The
    runner checks the broker before submitting any job and fails closed.
    DR-013 supersedes the one sentence of DR-012 that exempted this runner.
    Closes #373
2026-10-27 chore: bump klayout-tools pin to 0.8.0 and re-render tier report
    Move the live klt pins (CI, signoff, headless audit, layout requirements,
    klt-yield env) to 0.8.0, the klayout companion to 0.30.12 (the engine 0.8.0
    names as tested-against), retarget the pin-dependent tests, and re-render
    signoff/tier-report.json (ruleset id and checklist text change; verdicts
    identical).
    Closes #382
2026-10-29 sim: add single-corner 2x-VCO duty testbench (batch run blocked by fleet model-library load)
    Manifest and schematic for the operator-ruled tt/27C/1.80V measurement of
    open-loop VCO oscillation and duty at VCTRL values reaching 50/100/200/400 MHz.
    The batch submit ran and ngspice exited 1 on the runner loading the sky130
    model library (expr() parameters); no record is minted and nothing was run
    locally. Tool gap: 2AMLogic/klayout-tools#4603.
2026-11-02 sim: record tt/27C/1.80V 2x-VCO oscillation and duty at 50/100/200/400 MHz on the batch fleet
    Two append-only records (11-value grid, then the one allowed refinement).
    All four target rates reached within 10% with duty ~50.6%; no ruled stop
    condition fired. Offset 180*D is derived, not measured.
2026-11-02 signoff: re-pin item 8 to regenerated measurements/report.md
    The report gained two sim/vco-2x-duty PASS rows that bear on no spec row,
    changing the digest item 8 pins. The envelope summary's FAIL and no-evidence
    row lists are unchanged. Re-pinned README, manifest, envelope and
    tier-report.json.
2026-11-03 harness: never stage the boilerplate .spiceinit as stored evidence
    stage_files drops any file named .spiceinit, so stored manifests no longer
    collide with the 72 byte-identical committed copies. Recorded in DR-014.
2026-11-04 feat(signoff): attest T1 items 1, 9 and 10 with klt and re-attest in --check
    Convert the provisional inventories to klt's schema_version 1, produce the
    envelopes with klt signoff --attest (0.8.0), pin their hashes in the manifest,
    re-render the tier report (9 of 22 rows met), and re-attest each envelope in
    run-signoff.sh --check.
    Closes #329
2026-11-04 sim: record buffered-top nominal-point runs for pll-lock-1mhz/25mhz on the batch fleet
    Netlist via klt netlist instead of raw xschem in the harness; mint nominal
    (tt/27C/1.80V) records for the 1 MHz and 25 MHz references, both no-oscillation
    misses as before the buffer; regenerate measurements/report.md and re-pin the
    item 8 citation. The 100 us sim/pll-lock point has no result yet.
    Part of #303
    Loom-Issue: 2AMLogic/sky130-pll#303
2026-11-06 measurements: regenerate report for the buffered-top layout record; re-pin item 8
    Regenerated measurements/report.md (92 -> 93 records, 20 -> 21 superseded);
    no table row moved. Re-pinned item 8 in the manifest, envelope and
    tier-report.json. The envelope summary's FAIL and no-evidence row lists are
    unchanged.
2026-11-06 fix: drop pinned (name, sha256) boilerplate from staged run evidence
    Adds PINNED_BOILERPLATE to evidence_store.stage_files so the exact
    lvs.request.json bytes already tracked in older records are not stored
    again; same-named files with other bytes are still staged. DR-015
    (proposed) records the rule.
    Part of #414
2026-11-06 fix(signoff): re-attest item 10 after DR-015 index row
    Inventory DR-015 in item10, re-attest with klt 0.8.0, re-pin the inventory
    hash in block-manifest.json and re-render tier-report.json.
2026-11-06 layout: re-mint buffered-top PLL record without the duplicate stored artifact
    The 20261106-053933-0772a9d record registered route-spot-check/lvs.request.json,
    whose bytes were already committed in two older records, so
    check_artifact_manifests failed. Since DR-015 (#415) stages that file without
    the pinned boilerplate, re-running the layout flow yields a manifest that
    passes. The superseded 053933 record never reached main (PR-only); it is
    removed from the tree and remains in this branch's history. The new record
    is again FAIL on resistor extraction (recorded as a miss, LATEST unmoved).
2026-11-06 layout: read extracted resistors from klt JSON and mint a passing buffered-top record
    The 0.8.0 extract writes resistors as X subcircuit cards, which the
    renderer's R-card regex counted as zero, so the buffered-top record
    reported a false device-set FAIL. Resistors are now read from the
    extract JSON devices[] like capacitors, with a regression test. The
    re-run record passes (5 blocks, clk_buf 4 -> 4, resistors 1 and 2
    matched), supersedes 20260924-041509-c53e7c4, and LATEST points at it.
    Part of #304
2026-11-06 signoff: re-pin item 8 to the regenerated measurements/report.md
    The report's only change is the new layout record row, the scan counts and the
    Generated timestamp; no FAIL or no-evidence row moved, so the envelope summary
    is unchanged. Pin updated in the envelope provenance and the manifest.
2026-11-06 fmax: resolve --executor batch in fmax_cli instead of the cp/measure resolver
    fmax_cli now takes the batch route directly (it owns fmax_klt) rather than
    passing it through executor.resolve_name, which refuses manifests without a
    cp/measure block. The shared resolver and its refusals are unchanged. Also
    corrects the local-probe refusal message to name --executor batch.
2026-11-06 fix(signoff): re-attest item 10 after DR-016 index row
    Inventory DR-016 in item10, re-attest with klt 0.8.0, re-pin the inventory
    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
2026-11-10 feat(sim): transistor-level I/Q divide-by-2 and 90-point PVT campaign for DR-010
    Adds design/divider-iq (dfrtp_2 rising + dfrtn_1 falling flop, reset-defined)
    and a VCO+divider bench. Harness gains a measure.quadrature reduction
    (CLK90 offset and both duties measured edge to edge, graded and reported, never
    a harness gate) and per-corner sweep.per_point VCTRL tables; batch submits now
    pass --wait-for-capacity 600. Records: scan, 25 MHz and 50 MHz output, each over
    the 45-point DR-003 set. Simulated, DRAFT thresholds, ratifies nothing.
2026-11-11 refactor(sim): retire the --executor remote path, keep local and batch
    Remove RemoteBackend, its SKY130_PLL_REMOTE_* configuration, the shard/
    collect helpers and the silent fallback to local from the harness. A
    `remote` request (flag or manifest key) is now refused; `--executor batch`
    through `klt sim` is the fleet route. Tests for the removed backend are
    dropped and a refusal test added; docs updated. The committed
    executor-equivalence README and all records are untouched; a dated note
    supersedes the empty remote slot.
2026-11-14 sim: keep divider Fmax batch jobs small, waiting and reclaim-tolerant
    The `--executor batch` route of the divider Fmax campaign could not
    complete a run. Three separate fleet behaviours each ended it with no
    evidence; all three are measured on klt 0.9.2.dev1022, 2026-11-14.
    Artifact size. `build_body` already emits `.save v(fbclk_0) ...
    v(fbclk_k)` -- exactly the traces the reducer reads and the `.meas`
    cards name -- but klt's default `options.save_mode: "all"` emits a
    generated `save all` that supersedes that card, so every internal node
    of every DUT copy lands in the ASCII rawfile. Measured at 7.9 GB for
    one corner of one 4-DUT group (job klt-sim-70bcac3db8d5), which is
    multiple TB over t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
2026-11-14 fix: derive the record's li1.space.1 count from the plan, not a literal
    The PLL layout record stated the same historical `li1.space.1` violation
    count twice: once derived from `plan.json` by `_check_drc`, and once as a
    typed-in `52` in the "What this layout is not" DRC-clean bullet. They agreed
    only by coincidence -- the count sums the plan's sub-0.17 um-gate MOS
    devices, so the next block drawn at the 1.8 V core minimum gate length moves
    the derived statement and leaves the literal asserting a different number
    about the same quantity in the same record. Records are append-only
    evidence, so a self-contradicting one can only be superseded.
    Extract the sum into `_min_length_device_count(plan)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
2026-11-14 signoff: keep LATEST at c53e7c4; re-pin item 8 to the regenerated report
    Applies the operator ruling of 2026-11-14 (PR #416, round 20261111-r14 q86),
    which follows the q81 pattern from 2AMLogic/gf180-opamp#310.
    layout/pll/reports/LATEST stays at 20260924-041509-c53e7c4 (reverted in the
    merge commit), so signoff T1 item 3 keeps citing that record's in-git
    drc.json and run-signoff.sh's superseded-record guard passes. The new record
    20261106-075813-16557e3 and its artifact manifest are kept as evidence only;
    because it is not LATEST, measurements/aggregate.py counts it as superseded
    and excludes it from the report tables, so no table row moved.
    measurements/report.md is regenerated on the mer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
